kj-schmidt/Perconditioning/Rapport/Rapport/formalia/titelblad.tex

% Dette er et titelblad designet til videregående uddannelser på et universitet
% Filen kræver:
% Universitetets logo:  AU-logo-DK eller AU-logo-DK
% Synopsis: En fil ved navn synopsis.tex

% Udarbejdet af: Jesper Nørgaard (jesper@noergaard.eu) 10. april 2012

\phantomsection
\pdfbookmark[0]{Titelblad}{titelblad}
\thispagestyle{empty}

\begin{minipage}[t]{0.48\textwidth}
\vspace*{-8pt}			

\end{minipage}
\hfill
\begin{minipage}[t]{0.48\textwidth}
{\small 
\textbf{Ingeniørhøjskolen Aarhus}\\
Finlandsgade 22 \\
8200 Aarhus N \\
Tlf: 8715 0000 \\
http://www.ase.au.dk/}
\end{minipage}

\vspace*{1cm}

\begin{minipage}[t]{0.48\textwidth}
\textbf{Titel:} \\[5pt]\bigskip\hspace{2ex}
Remote Ischemic Conditioning

\textbf{Projekt:} \\[5pt]\bigskip\hspace{2ex}
Bachelor projekt

\textbf{Projektperiode:} \\[5pt]\bigskip\hspace{2ex}
Juli 2015 - December 2015

\textbf{Projektgruppe:} \\[5pt]\bigskip\hspace{2ex}
15155

\textbf{Deltagere:} \\[5pt]\hspace*{2ex}
Simon Vammen Grønbæk\\\hspace*{2ex}
Karl-Johan Schmidt \\\hspace*{2ex}

\textbf{Vejledere:} \\[5pt]\hspace*{2ex}
Peter Johansen \\\bigskip\hspace{2ex}

\textbf{Projektudbyder:} \\[5pt]\hspace*{2ex}
Rolf Blauenfeldt\\\bigskip\hspace{2ex}
\vspace*{4cm}

\textbf{Sidetal: \pageref{SidsteSide}} \\
\textbf{Afsluttet 16-12-2015}

\end{minipage}
\hfill
\begin{minipage}[t]{0.483\textwidth}
	\textbf{Godkendelse:}\vspace{1cm}
\begin{table}[H]
	\centering
	\begin{tabular}{c}
		\underline{\phantom{mmmmmmmmmmmmmm}}  \\
		Karl-Johan Schmidt \vspace{2cm}\\
		\underline{\phantom{mmmmmmmmmmmmmm}} \\
		Simon Vammen Grønbæk \vspace{2cm}	\\
		\underline{\phantom{mmmmmmmmmmmmmm}} \\
		Peter Johansen \vspace{2cm}	\\
		\underline{\phantom{mmmmmmmmmmmmmm}} \\
		Rolf Blauenfeldt \vspace{2cm}	\\
	\end{tabular}
\end{table}
\end{minipage}

\vfill

{\footnotesize\itshape Rapportens indhold er ikke frit tilgængeligt og offentliggørelse må kun ske såfremt de igangværende patentundersøgelser afsluttes}

% Rapportens indhold er frit tilgængeligt, men offentliggørelse (med kildeangivelse) må kun ske efter aftale med forfatterne.
% The content of the report is freely available, but publication (with source reference) may only take place in agreement with the authors.
