kj-schmidt/Perconditioning/Rapport/Rapport/formalia/forord.tex

\chapter*{Forord}

Denne rapport er udarbejdet som det skriftlige produkt til 7. semester bachelorprojekt. Rapporten og projektet er udarbejdet af to sundhedsteknologistuderende fra Ingeniørhøjskolen, Aarhus Universitet. Bachelorprojektet har foregået fra 28/8-2015 til 16/12-2015. Inden bachelorprojektet begyndte, blev der i perioden 1/6-2015 til 21/6-2015 udarbejdet et forprojekt. Forprojektet beskrev de grundlæggende rammer for bachelorprojektet, heriblandt valg af emne og forventningsafstemning med projektudbyderen. 
Projektgruppen vil rette en stor tak til projektudbyder Rolf A. Blaunfeldt for stor interesse, engagement og deltagelse i projektet. Derudover takkes vejleder Peter Johansen for at bistå med faglig hjælp og støtte igennem forløbet. Til sidst skal der lyde en tak til Sara Rose Newell og Stevan Brantlov fra Region Midt for at bistå med faglig viden og blodtrykssimulator. 

\vspace{3cm}

\begin{table}[H]
	\centering
	\begin{tabular}{c c}
		\underline{\phantom{mmmmmmmmmmmmmmmmmmmmm}} & \underline{\phantom{mmmmmmmmmmmmmmmmmmmmm}} \\
		Simon Vammen Grønbæk (201270788) \vspace{2cm} & Karl-Johan Schmidt (201270751) \vspace{2cm}\\
	\end{tabular}
\end{table}
