kj-schmidt/Perconditioning/Rapport/Rapport/formalia/resume.tex

\chapter*{Resume}
\textbf{Baggrund}
\textit{Remote ischemic conditioning (RIC)} er en behandlingsform, som har vist sig effektiv til behandling og forebyggelse af iskæmiske skader i hjertet. Derfor vil et forskningshold fra Aarhus Universitetshospital undersøge om samme effekt kan opnås hos patienter med apopleksi. Til udførsel af RIC behandlingen skal forskningsholdet have udviklet et apparat, der kan måle blodtrykket hos apopleksi patienter og derefter påbegynde behandlingen. RIC behandlingen foregår ved at okkludere en ekstremitet med en blodtryksmanchet ved et tryk på minimum 25 mmHg højere end systolisk tryk. Behandlingen udføres i cyklusser, hvor en cyklus består af én okklusionsfase og én reperfusionsfase. 

\textbf{Metoder}
Ved hjælp af agile og iterative processer er der udarbejdet en prototype, som kan udfører RIC behandling. Udviklingsfasen bestod af fire faser, hhv. kravspecifikation, system design, detaljeret design og implementering. For at sikre en konstant fremgang i projektforløbet er udviklingsfasen blevet styret ved hjælp af SCRUM. I projektet er der kørt ugentlig sprint, og projektets backlog har været en tidsplan udarbejdet som et gantt chart. Sammen med tidsplanen er milepæle i projektet nået ved hjælp af den tilknyttede review gruppe. I samarbejde med reviewgruppen blev der fastlagt deadlines for, hvornår hver milepæl skulle være færdig.

\textbf{Resultater og diskussion}
Accepttesten af prototypen viste, at kravene til produktet var delvist opfyldt. Prototypen kan måle et blodtryk, hvor efter trykket i manchetten fyldes til 25mmHg over det målte systoliske tryk. Herefter påbegyndes RIC behandlingen. Da prototypen skal bruges til et forskningsprojekt, gemmes informationen omkring RIC behandlingen på et SD kort parallelt med, at prototypen udfører behandlingen. Det er også muligt at ændre det antal cyklusser en behandling skal vare, samt tiden pr. cyklus. Dette er implementeret i tilfælde af, at studieprotokollen på et senere tidspunkt ønsker ændringer i opsætningen for RIC behandlingen. Foruden RIC behandlingen kan prototypen også indstilles til at udføre okklusionstræning. Accepttesten blev kun  delvist godkendt, fordi prototypen ikke er implementeret med en sikkerhedskontrol, der kan afbryde RIC behandlingen. 

\textbf{Konklusion}
 Den nye viden omkring behovet for et modificeret blodtryksapparat blev omsat til en funktionel prototype, der kunne udføre RIC behandling. Foruden sikkerhedskontrollen opfylder prototypen de ønskede funktioner. Ydermere blev der implementeret en ekstra funktion i form af okklusionstræning. De ingeniørfaglige metoder sikrede at udviklingsfasen forløb flydende og at deadlines blev overholdt. Mulighederne med RIC og prototypen kan på lang sigt have stor betydning for både patienter og sundhedssektoren.
