kj-schmidt/Perconditioning/Udviklingsdokumentation/Kravspecifikation/filer/ikkeFunkSpec.tex

	\chapter{Ikke-funktionelle krav}
	Afsnittet beskriver de ikke-funktionelle krav til produktet. De ikke-funktionelle krav adskiller sig fra de funktionelle krav, ved at beskrive kriterier der er afgørende for hvordan systemet operere. De ikke-funktionelle krav kaldes i nogen sammenhænge for \textit{kvalitets attributter}, fordi de beskriver alle de krav, der ikke er specificeret i hovedscenarierne.
	
	\section{Microcontroller}
	\begin{enumerate}
		\setlength\itemsep{0cm}
		\item Atmega2560
		\end{enumerate}
	
	\section{Filformat og opsætning}
	\begin{enumerate}
		\setlength\itemsep{0cm} % Decrease line distance
		\item Data logged i formatet .csv og hver kolonne indeholder følgende værdier og enheder: 
		\begin{enumerate}
			\item Tidsstempel [hh:mm:ss dd-mm-yyyy]
			\item Gennemført afklemning [Boolean]
			\item Afklemningstryk [mmHg]
			\item Systoliske blodtryk [mmHg]
			\item Middelblodtryk (MAP) [mmHg]
			\item Diastolisk blodtryk [mmHg]
			\item Afklemning afbrudt [Boolean]
		\end{enumerate}
		\item Der oprettes én fil pr patient, med filnavn tilsvarende det unikke patient ID og apparatets ID i følgende format: “PatientIDApparatID”
	\end{enumerate}
	
	\section{Patient ID}
	\begin{enumerate}
		\setlength\itemsep{0cm} % Decrease line distance
		\item Består af karaktererne A-F og tallene 0-9
		\begin{enumerate}
			\item ID’et er fem karakterer lang: ***** svarende til ca. 1 million kombinationer
			\item ID’et er ikke case sensitiv
		\end{enumerate}
	\end{enumerate}

	\section{Hukommelse}
	\begin{enumerate}
		\setlength\itemsep{0cm} % Decrease line distance
		\item Information lagres på micro SDHC af typen:
		\begin{enumerate}
			\item Class 4
			\item Fil system [fat32] og minimum 128mb
		\end{enumerate}
	\end{enumerate}
	
	\section{Forsyning}
	\begin{enumerate}
		\setlength\itemsep{0cm} % Decrease line distance
		\item Konditionerings apparatet skal forsynes med 12V, min 1A
		\begin{enumerate}
			\item DC-connector, ydre Ø=5,5mm, indre Ø = 2,1mm
			\item 8 stk AAA batterier (1,5V)
		\end{enumerate}
	\end{enumerate}
	
	\section{Fysiske krav}
	\begin{enumerate}
		\setlength\itemsep{0cm} % Decrease line distance
		\item Knapper
		\begin{enumerate}
			\item  {[}Start/Stop]
			\item {[}Mål blodtryk]
			\item Modeswitch [Okklusionstræning/Konditionering/Setup]
		\end{enumerate}
		\item Hvert apparat udstyres med et unik serie nummer, kaldet apparat ID
	\end{enumerate}
	
	\section{Setup}
	\begin{enumerate}
		\setlength\itemsep{0cm} % Decrease line distance
		\item Der kan ændres i tiden pr cyklus og antallet af cyklusser
		\begin{enumerate}
			\item \textit{Tid pr cykles} kan sættes mellem 3 til 8 minutter og skifter med intervaller af 30 sekunder
			\item \textit{Antal cyklusser }kan sættes mellem 1-9 og skifter med intervaller af 1
		\end{enumerate}
	\end{enumerate}
