kj-schmidt/Perconditioning/Udviklingsdokumentation/Kravspecifikation/filer/funkSpec.tex

\chapter{Funktionelle krav}
Dette afsnit beskriver de funktionelle krav for \textit{Konditioneringsapparatet}. De funktionelle krav er udarbejdet som \textit{fully dressed} use cases, der beskriver krav til produktets opførsel.

\section{Use case diagram}
Nedenfor illustreres alle use cases (Se figur \ref{fig:usecasedia}) for systemet i et samlet diagram. Aktørerne, som er beskrevet nedenfor, indgår i diagrammet, og deres interaktion og indvirkning med systemet er beskrevet med pilene. 
\begin{figure}[H]
	\centering
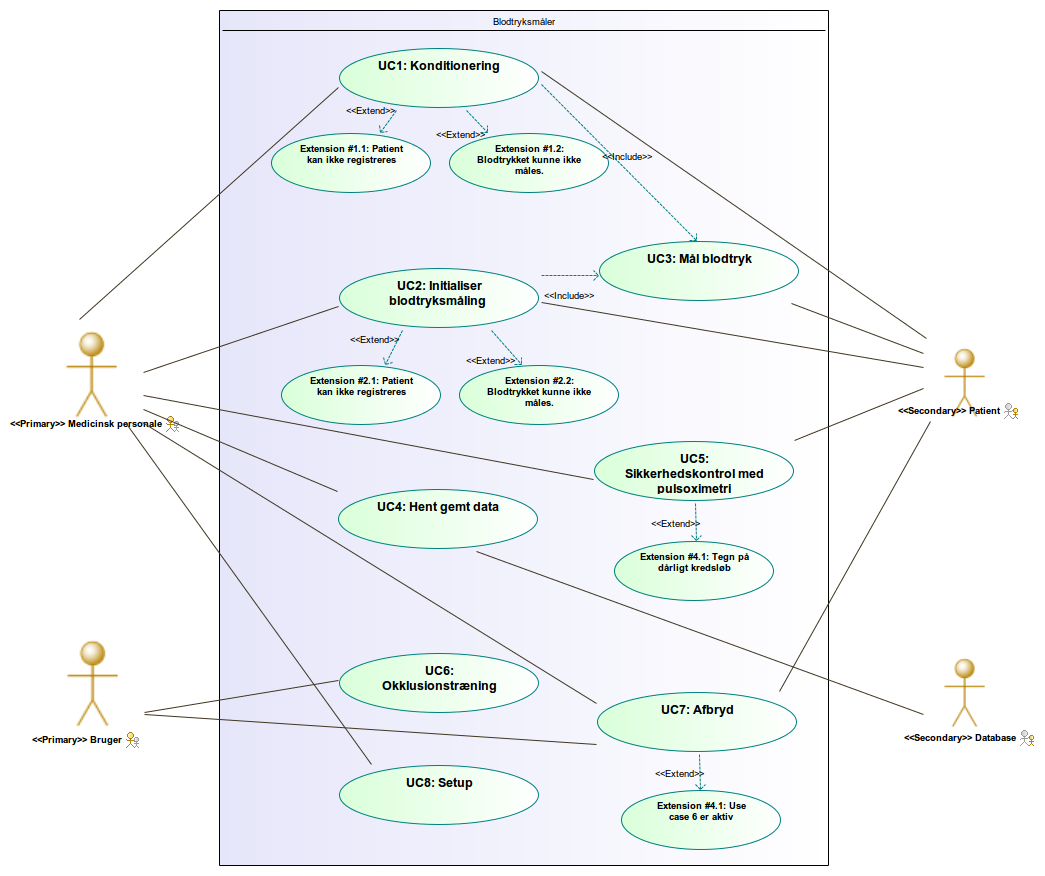
[picture p10: Udviklingsdokumentation/Kravspecifikation/SysML/UCD.png]
	
	\caption{Use case diagram for \textit{Konditioneringsapparatet}} \label{fig:usecasedia}
\end{figure}

%Actor description
\input{Kravspecifikation/filer/actorDescription.tex}
\newpage

\section{Use cases}
Dette afsnit beskriver alle use cases fra figur \ref{fig:usecasedia} ved hjælp af fully dressed use cases. 
	%Use case 1
	\input{Kravspecifikation/filer/uc1.tex}
	
	%Use case 2
	\input{Kravspecifikation/filer/uc2.tex}
	
	%Use case 3
	\input{Kravspecifikation/filer/uc3.tex}
	
	%Use case 4
	\input{Kravspecifikation/filer/uc4.tex}
	
	%UseCase 5
	\input{Kravspecifikation/filer/uc5.tex}
	
	%UseCase 6
	\input{Kravspecifikation/filer/uc6.tex}
	
	%UseCase 7
	\input{Kravspecifikation/filer/uc7.tex}
	
	%UseCase8
	\input{Kravspecifikation/filer/uc8.tex}
