kj-schmidt/Perconditioning/Rapport/Rapport/formalia/forside.tex

\thispagestyle{empty}
\begin{flushright}
\vspace{3cm}

\phantom{hul}

\phantom{hul}

\phantom{hul}

\textsl{\Huge Remote Ischemic Conditioning} \\ \vspace{1cm}
\textsl{\Huge Projektrapport} \\ \vspace{1cm}

\rule{\textwidth}{3mm} \\ \vspace{1.5cm}
\vspace{1cm}



\vspace{1cm} 
\textsc{\Large Bachelorprojekt \\
Gruppe 15155 \\
Karl-Johan Schmidt \\
Simon Vammen Grønbæk \\
Ingeniørhøjskolen, Aarhus Universitet \\
Efteråret 2015 \\}
\end{flushright}
