kj-schmidt/Perconditioning/Rapport/Rapport/appendiks/samarbejdeaftale.tex

\section{Samarbejdsaftale - intern}\label{title:samarbejdsaftaleIntern}

\textbf{Faglige forventninger til projektet:}
\begin{itemize}
	\item Vi forventer at udarbejde et projekt, som vi kan stå inde for
	\item Vi forventer at det faglige niveau lever op til kravene i kursus beskrivelsen
	\item Vi forventer at der gøre brug af viden og kompetencer fra tidligere kursuser
	\item Vi forventer at gruppens medlemmer viser engagement i projektet
	\item Det forventes at projektet lever op til en topkarakter
\end{itemize}

\textbf{Forventninger til gruppearbejdet og interne aftale:}
\begin{itemize}
	\item Alle gruppemedlemmer deltager aktivt og yder efter bedste evne
	\item Bidrager til konstruktivt diskussioner og problemstillinger undervejs i projektforløbet
	\item Alle aftaler indskrives i den fælles Google Calender, hvor det er eget ansvar at være opdateret
	\item Alle dokumenter der ikke kræver versionshistorik gemmes i gruppens fælles Dropbox mappe
	\item Versionsstyring af dokumenter foregår i git, og det er eget ansvar at ajourføre sine ændringer
	\item Eget ansvar at give besked til gruppen hvis man bliver forhindret i at møde til den ellers aftalte tid
	\item Der må forventes at gruppemedlemmerne pålægges hjemme opgaver og det er eget ansvar at løse disse
	\item Den forventede mødetid i hverdage er 8.15 til 16
	\item Det er et fælles ansvar at oprette en ugentlig plan for ugens opgaver, samt føre logbog over den forgangne uge	
	\item Vi forventer et vejledermøde hver anden uge
	\item Gruppens medlemmer overholder de ovenstående aftale
\end{itemize}

\hspace{3cm}

Underskrives af: 

\begin{table}[H]
	\centering
	\begin{tabular}{c c}
		\underline{\phantom{mmmmmmmmmmmmmmmmmmmmm}} & \underline{\phantom{mmmmmmmmmmmmmmmmmmmmm}} \\
		Simon Vammen Grønbæk (201270788) \vspace{2cm} & Karl-Johan Schmidt (201270751) \vspace{2cm}\\
	\end{tabular}
\end{table}

\newpage
\section{Samarbejdsaftale - reviewgruppe}\label{title:samarbejdsaftaleReview}

Forventninger til samarbejdet:
\begin{itemize}
	\item For hver milepæl i projektet udføres reviewmøder
	\item Efter hvert endt reviewmøde aftales et ny dato for næste møde
	\item De aftalte deadlines forventes overholdt
	\item Vi forventer at reviewgruppen kommer med kontruktiv kritik af det udleverede materiale
	\item Der forventes at grupperne har diskuteret materialet intern, inden det aftalte reviewmøde
	\item Vi forventer at reviewsamarbejdet styrker projekts fremgang og bidrager til et veludarbejdet projekt
	\item Der forventes som minimum to dage fra materiale udleveres til review, før det kan gennemgås. 
\end{itemize}

\hspace{3cm}

Projektgruppens underskrift: 
\begin{table}[H]
	\centering
	\begin{tabular}{c c}
		\underline{\phantom{mmmmmmmmmmmmmmmmmmmmm}} & \underline{\phantom{mmmmmmmmmmmmmmmmmmmmm}} \\
		Simon Vammen Grønbæk (201270788) \vspace{2cm} & Karl-Johan Schmidt (201270751) \vspace{2cm}\\
	\end{tabular}
\end{table}
Reviewgruppens underskrift:
\begin{table}[H]
	\centering
	\begin{tabular}{c c}
		\underline{\phantom{mmmmmmmmmmmmmmmmmmmmm}} & \underline{\phantom{mmmmmmmmmmmmmmmmmmmmm}} \\
		Anders Toft (11242) \vspace{2cm} & Anders Esager (201270874) \vspace{2cm}\\
	\end{tabular}
\end{table}
