kj-schmidt/Perconditioning/Rapport/Rapport/teknisk/staal.tex

\chapter{Stålmateriale}

Inden der kan regnes på en stålkonstruktion, der skal opsættes i forbindelse med en gennemgribende renovering, beskrives stålet som materiale.

\section{Fremstilling}

\section{Egenskaber}

\fxnote{Husk at skrive om egenskaber ved brand, Jens!}

\subsection{Arbejdskurve}

Den nederste del af ståls arbejdskurve følger principperne om Hook's lov \citep[ s. 419]{fysikbog}.
