kj-schmidt/Perconditioning/Udviklingsdokumentation/Implementeringsdokument/Implementeringsdok.tex

 %	\input{Implementeringsdokument/filer/forside}
%	\input{Implementeringsdokument/filer/titelblad}
\newpage
\printcontents[id]{ }{0}{\chapter*{Indholdsfortegnelse}}
\newpage
	
	\input{Implementeringsdokument/filer/indledning}
	
	\input{Implementeringsdokument/filer/software}
	
	\input{Implementeringsdokument/filer/filter}
	
	\input{Implementeringsdokument/filer/hardware}
