kj-schmidt/Perconditioning/Udviklingsdokumentation/SystemArkitektur/SystemArkitektur.tex

	%Frontpage
	%\input{SystemArkitektur/filer/forside.tex}
	
	%Title page
	%\input{SystemArkitektur/filer/titelblad.tex}
	\newpage
	\printcontents[sd]{ }{0}{\chapter*{Indholdsfortegnelse}}
	\newpage
	
	%Indledning
	\input{SystemArkitektur/filer/indledning}
	
	\input{SystemArkitektur/filer/systemetsDele}
	
	\input{SystemArkitektur/filer/arkitektur}
