kj-schmidt/Perconditioning/Udviklingsdokumentation/Implementeringsdokument/filer/indledning.tex

	\chapter{Indledning}
	Implementeringsdokument giver et detaljeret design overblik over hvordan både hardware og software er blevet implementeret i udviklingen af prototypen. Dokumentet indeholder beskrivelse af strukturen af software klasser og deres funktionalitet. For hardware delen er der beskrevet de forskellige hardware blokke og hvordan de er blevet implementeret for at kunne leve op til kravene stillet i kravspecifikationen. 
	
	\section{Formål}
	Dette dokument har til formål at give læseren et teknisk indblik i \textit{Konditioneringsapparatets} funktionalitet og opbygning, samt skabe fuld forståelse for alle systemets under dele gennem en detaljeret design beskrivelse. I forlængelse af system designet, som beskriver hvordan systemet skulle designes, beskriver dette dokument det færdig design i detaljer og hvordan det har opnået sin funktionalitet
	
	\section{Projektreferencer}
	\begin{itemize}
		\item Se underdokumentet, kravspecifikation, på side \pageref{part:ks}
		\item Se underdokumentet, accepttest, på side \pageref{part:at}
		\item Se underdokumentet, system design, på side \pageref{part:sd}
	\end{itemize}
	
	\section{Læsevejledning og dokumentstruktur}
	Da dette dokument er en del af udviklingsdokumentation. Det er vigtigt at læse i sammenhæng med kravspecifikationen og systemarkitekturen. Undervejs i dokumentet vil der være referencer til kravspecifikationen og derfor er der stor samhørighed mellem disse to dokumenter. Dette dokument skal også ses som en forklaring på software implementeringen, og derfor passer navne og overskrifter i software beskrivelse overens med navne på metoder og klasser i softwaren. Desuden beskrives hver software metode ud fra tre punkter; paramter, returtype og beskrivelse. Parameter beskriver hvilke parametre og typen af disse parametre, som metode skal have. Returtypen fortæller hvilken værdi metode returnere og hvilken type det er. Beskrivelsen forklare funktionaliteten af metode, og hvordan denne funktionalitet er opnået. Nogle metoder indeholder også kode eksempler, når det anses som nødvendigt for at forstå metoden. Efter software beskrivelsen kommer overgangen til hardware beskrivelsen.
	
	\newpage
	\section{Versionshistorik}
	\begin{longtable}{ |p{0.24\textwidth} |p{0.42\textwidth}| p{0.25\textwidth}|  } 
		\hline
		\rowcolor{usDef}
		\textbf{Versionsnummer} &  \textbf{Ændringer} & \textbf{Dato og initialer} \\
		\hline
		0.1 & Oprettelse af implementeringsdokument og skabelon & 01.11.15 KJS \\
		\hline
		0.2 & Tilføjelse af filter dokumentation & 11.11.15 SVG \\
		\hline
		0.3 & Beskrivelse af display, timer og hukommelses klasser & 12.11.15 KJS \\
		\hline
		0.4 &  Implementering klar til review, updateret filtrering og debouncing & 13.11.15 KJS, SVG \\
		\hline
		0.5 &  Rettelser efter review & 16.11.15 KJS, SVG \\
		\hline
		0.6 &  Ændret beskrivelse af metoder og ny graf over blodtryk & 20.11.15 KJS, SVG \\
		\hline
	\end{longtable}
	
	\section{Definitioner og forkortelser}
	\begin{longtable}{ |p{0.3\textwidth} |p{0.64\textwidth}| } 
		\hline
		\rowcolor{usDef}
		\textbf{Udtryk / Forkortelser} &  \textbf{Forklaring} \\
		\hline
		Modeswitch & Knap til at styre hvilket program Konditioneringsapparatet skal køre \\
		\hline
		\textit{Tid pr cyklus} & Variable som indeholder hvor mange sekunder et konditioneringscyklus skal vare \\
		\hline
		\textit{Antal cyklusser} & Variable som indeholder hvor mange cyklusser et konditioneringsforløb skal vare \\
		\hline
		EEPROM & Intern flash hukommelse på arduino som der kan skrives og læses fra \\
		\hline
		Interrupt & Hver gang arduino kører en clock cyklus aflæses værdien af en række digital pins, hvorved man kan afbryde kode og kører en anden sekvens. Arduinoen har både interne og eksterne interrupt, men dette projekt gør kun brug af de eksterne interrupt \\
		\hline
		Sand/True, Falsk/False & Arduino genkender en sand/true når typen er bool og værdien er 1. Modsat registreres 0 som falsk/false \\
		\hline
	\end{longtable}
