kj-schmidt/Perconditioning/Udviklingsdokumentation/Kravspecifikation/filer/uc8.tex

	\subsection{Use case 8 - Setup}
	Use case 8 (Se tabel \ref{tab:uc8}) beskriver forløbet når der skal ændrings i konditioneringsprotokollen. Her kan ændres i tiden pr cyklus og antallet af cyklusser. 
		\begin{table}[H]
				\begin{center}
			\begin{tabular}{ | p{0.24\textwidth} | p{0.7\textwidth}| } 
				\hline
				Mål & Ændre konditioneringsforholdene \\ 
				\hline
				Initiation &  Medicinsk personale\\
				\hline
				Aktører og interessenter & 
				\begin{itemize}
					\item Medicinsk personale 
				\end{itemize} \\ 
				\hline
				Referencer & Illustration over setup \\ 
				\hline
				Antal samtlige forekomster & En til mange \\ 
				\hline	
				Startbetingelser & 
				\begin{itemize}
					\item Mode switch er sat til “\textit{setup}” 
					\item Displayet er ændret til \textit{setup}
 				\end{itemize} \\ 
				\hline
				Slutbetinglser & 
				\begin{itemize}
					\item Cyklus længden og/eller antallet er cyklusser er ændret
				\end{itemize} \\ 
				\hline
				Normal forløb & \begin{enumerate}
					\setlength\itemsep{0cm} % Decrease line distance
					\item Brugeren trykker på knappen [Mål blodtryk]  for at vælge \textit{Tid pr cyklus}
					\item Bruger trykker på knappen [Start/Stop] for at ændre \textit{Tid pr cyklus}
					\item Bruger trykker på knappen [Mål blodtryk]  for at gemme ændringen
					\item Bruger trykker på knappen [Start/Stop] for at navigere til \textit{Antal cyklusser}
					\item Ved knap tryk på [Mål blodtryk]  vælges \textit{Antal cyklusser}
					\item Ved knap tryk på [Start/Stop] ændre \textit{Antal cyklusser}
					\item Brugeren trykker på knappen [Mål blodtryk] for at gemme ændringen
				\end{enumerate} \\ 
				\hline
				Undtagelser & -  \\ 
				\hline
			\end{tabular}
		\end{center}

			\caption{\textit{Fully dressed} use case diagram over use case 8} \label{tab:uc8}
		\end{table}
			\newpage
