kj-schmidt/Perconditioning/Udviklingsdokumentation/Accepttest/filer/at_uc2.tex

\newpage
\section{Use case 2 - Initialiser blodtryksmåling}
		\begin{longtable}{|p{0.09\textwidth}|p{0.23\textwidth}|p{0.23\textwidth}|p{0.23\textwidth}|p{0.07\textwidth}|}
			\hline
			\rowcolor{usDef}
			Krav nr.: & Handling & Forventet resultat & Testmetode & Resul-tat  \\\hline
			2.2.1 & \textit{Medicinsk personale} trykker på [Mål blodtryk] & \multirow{3}{\linewidth}{Der vises et patient ID på skærmen} & \multirow{3}{\linewidth}{Knappen [Start/Stop] trykkes og displayet observeres} & \multirow{3}{\linewidth}{}  \\ \cline{1-2} 
			2.2.2 & Et nyt patient ID genereres & & &  \\ \cline{1-2}
			2.2.3 & Patient ID’et vises på skærmen & & &  \\ \hline
			2.2.4 & Blodtrykket måles via \textit{use case 3} & \multicolumn{3}{l|}{Se krav nr. 1.3.1 til 1.3.5} \\ 
			\hline
			\caption{Accepttest forløb for use case 2}
		\end{longtable}
	
	\section*{Undtagelser}
		\begin{longtable}{|p{0.09\textwidth}|p{0.23\textwidth}|p{0.23\textwidth}|p{0.23\textwidth}|p{0.07\textwidth}|}
			\hline
			\rowcolor{usDef}
			Krav nr.: & Handling & Forventet resultat & Testmetode & Resul-tat  \\\hline
			
			2.2.ex1 & SD kortet er ikke monteret korrekt & \multicolumn{3}{l|}{Se krav nr 2.1.ex1} \\ 
			\hline
			2.2.ex2 & Et patient ID eksisterer allerede på apparatet. Der genereres ikke noget nyt patient ID &  \multicolumn{3}{l|}{Se krav nr 2.1.ex2} \\ 
			\hline
			\caption{Undtagelser for use case 2}
		\end{longtable}
