kj-schmidt/Perconditioning/Udviklingsdokumentation/Accepttest/filer/at_uc6.tex

\section{Use case 6 - Okklusionstræning}
						\begin{longtable}{|p{0.09\textwidth}|p{0.23\textwidth}|p{0.23\textwidth}|p{0.23\textwidth}|p{0.07\textwidth}|}
								\hline
								\rowcolor{usDef}
								Krav nr.: & Handling & Forventet resultat & Testmetode & Resul-tat  \\\hline
								2.6.1 & Montere manchetten på arm/ben & Manchetten sidder tæt om arm/ben. Hele velcro hæfte siden skal fæstnes i filtsiden & Manchetten trækkes løst over arm/ben og fastspændes så det ønskede område afklemmes. Kontrollér om manchetten er passer i størrelsen & \\ \hline
								2.6.2 & Tryk på knap [Start/Stop] & Luftpumpen startet & Knappen [Start/Stop] trykkes og observer at manchetten udvides  & \\ \hline
								2.6.3 & Manchetten pumpes op til 100mmHg & \multirow{2}{\linewidth}{Trykket i mancheten er 100 mmHg med en tolerance på +20/-10 mmHg}& \multirow{2}{\linewidth}{Observere analogt barometer i 3 min}& \multirow{2}{\linewidth}{} \\ \cline{1-2}
								2.6.4 & Trænings-sættet begyndes og trykket holdes konstant på 100mmHg (+/-5mmHg) & & & \\ \hline \newpage \hline
								2.6.5 & Tryk på knap [Start/Stop]  & \multirow{2}{\linewidth}{Manchet trykket er \textless  10 mmHg efter 1 min.} & \multirow{2}{\linewidth}{Knappen [Start/Stop] trykkes og observer at trykket på det analog barometer} & \multirow{2}{\linewidth}{} \\ [2cm] \cline{1-2}
								2.6.6 & Manchetten deflateres  & & & \\ \hline
								\caption{Accepttest forløb for use case 6}
						\end{longtable}
