kj-schmidt/Perconditioning/Udviklingsdokumentation/Accepttest/filer/at_uc7.tex

\section{Use case 7 - Afbryd}
						\begin{longtable}{|p{0.09\textwidth}|p{0.23\textwidth}|p{0.23\textwidth}|p{0.23\textwidth}|p{0.07\textwidth}|}
							\hline
							\rowcolor{usDef}
							Krav nr.: & Handling & Forventet resultat & Testmetode & Resul-tat  \\\hline
							2.7.1 & Brugeren trykker på knappen [Start/Stop] & \multirow{2}{\linewidth}{Use casen afbrydes og manchetten tømmes for luft} & \multirow{2}{\linewidth}{Start use case 1 eller 6 og på et vilkårligt tidspunkt tryk på knappen [Start/Stop]} & \multirow{2}{\linewidth}{} \\ \cline{1-2}
							2.7.2 & Den igang-værende use case afbrydes & & & \\ \hline
							2.7.3 & Manchetten tømmes for luft og tidsstempel med “\textit{Afklemning afbrudt} = false(0)” gemmes i hukommelsen & Manchet trykket er \textless 50 mmHg efter 1 min. Tidsstempel for  “\textit{Afklemning afbrudt} = false(0)” gemmes i fil & Observere analogt barometer 1 min.
							Kontroller tidsstempling på SD kortet & \\ \hline
							\caption{Accepttest forløb for use case 7}
						\end{longtable}
					
					\section*{Undtagelser}
						\begin{longtable}{|p{0.09\textwidth}|p{0.23\textwidth}|p{0.23\textwidth}|p{0.23\textwidth}|p{0.07\textwidth}|}
							\hline
							\rowcolor{usDef}
							Krav nr.: & Handling & Forventet resultat & Testmetode & Resul-tat  \\\hline
							2.7.ex1 & Use case 6 er aktiv: ingen data gemmes i hukommelsen & Der gemmes ingen data & Kør use case 6 efterfulgt af use case 7 og observér logfilen & \\ \hline
							\caption{Undtagelser for use case 7}
						\end{longtable}
