kj-schmidt/Perconditioning/Udviklingsdokumentation/Accepttest/filer/at_uc4.tex

\newpage
\section{Use case 4 - Overfør data}
				\begin{longtable}{|p{0.09\textwidth}|p{0.23\textwidth}|p{0.23\textwidth}|p{0.23\textwidth}|p{0.07\textwidth}|}
							\hline
							\rowcolor{usDef}
							Krav nr.: & Handling & Forventet resultat & Testmetode & Resul-tat  \\\hline
							2.4.1 & Tag SD kortet ud af blodtryksapparatet  & \multirow{2}{\linewidth}{Der eksisterer en logfil på SD-kortet og den kopieres til det lokale drev}& \multirow{2}{\linewidth}{Indsæt SD-kort i computeren. Kontroller om filen eksisterer på kortet. Overfør filen til computeren.}& \multirow{2}{\linewidth}{} \\ [2cm]\cline{1-2}
							2.4.2 & Sæt SD kortet i computeren og overfør filen & & & \\ \hline
							2.4.3 & Formatér SD kortet & \multirow{2}{\linewidth}{SD-kortet er formateret og tømt for filer} & \multirow{2}{\linewidth}{Formatér SD til FAT32. Indsæt SD-kort i apparatet og foretag blodtryksmåling. Kontroller om logfilen oprettes på SD-kort. } & \multirow{2}{\linewidth}{}\\ [3cm]\cline{1-2}
							2.4.4 & Sæt SD kortet tilbage i konditioneringsapparatet & & & \\ \hline
							\caption{Accepttest forløb for use case 4}
				\end{longtable}
