kj-schmidt/Perconditioning/Udviklingsdokumentation/SystemArkitektur/filer/Deployment.tex

\section{Deployment}
Da produktet Konditioneringsapparat er en prototype beskæftiger projektet sig ikke med de redskaber der bruges i deployment view. Dette view beskriver blandt andet hvordan software mappes på hardware, kaldet et deployment diagram. Konditioneringsapparatet består kun af én software eksekverende enhed og derfor er dette overflødigt at beskrive.
