kj-schmidt/Perconditioning/Rapport/Rapport/billeder/Sælgertegning.pptx

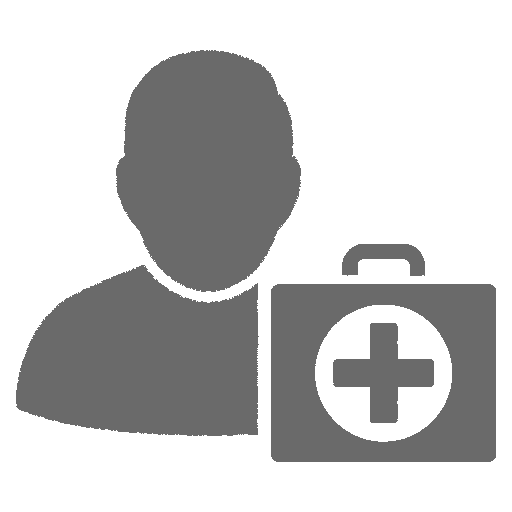
[picture p24: figure]

Medicinsk
personale

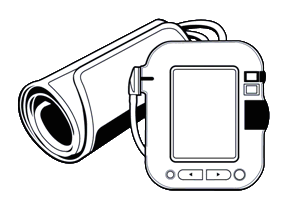
[picture p25: figure]

Konditionerings-
apparat

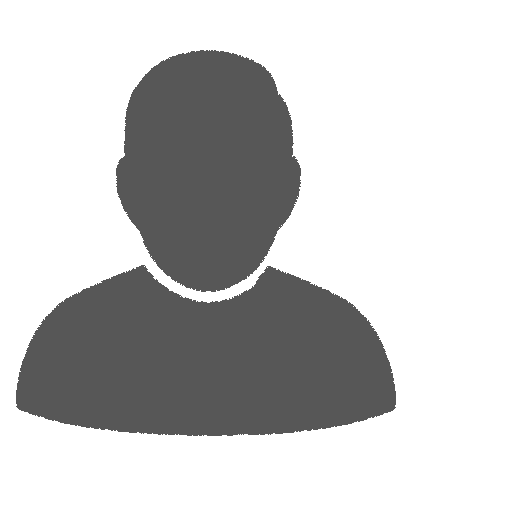
[picture p26: figure]

Patient

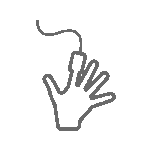
[picture p27: figure]

Pulsoximeter

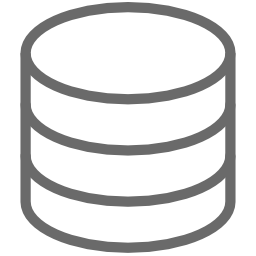
[picture p28: figure]

Database
