kj-schmidt/Perconditioning/Prototype/Pneumatik noter.docx

Pneumatik

Enhed | Rør størrelse på slange [mm] | Størrelse på enhed
Pumpe | 6mm | 7mm
Cuff | 5mm | 5,9mm
Valve | 2.7mm | 3mm
Sensor | | 3mm
