kj-schmidt/Perconditioning/Udviklingsdokumentation/SystemArkitektur/pdfs/BDD(SystemOverview)_backup.pdf

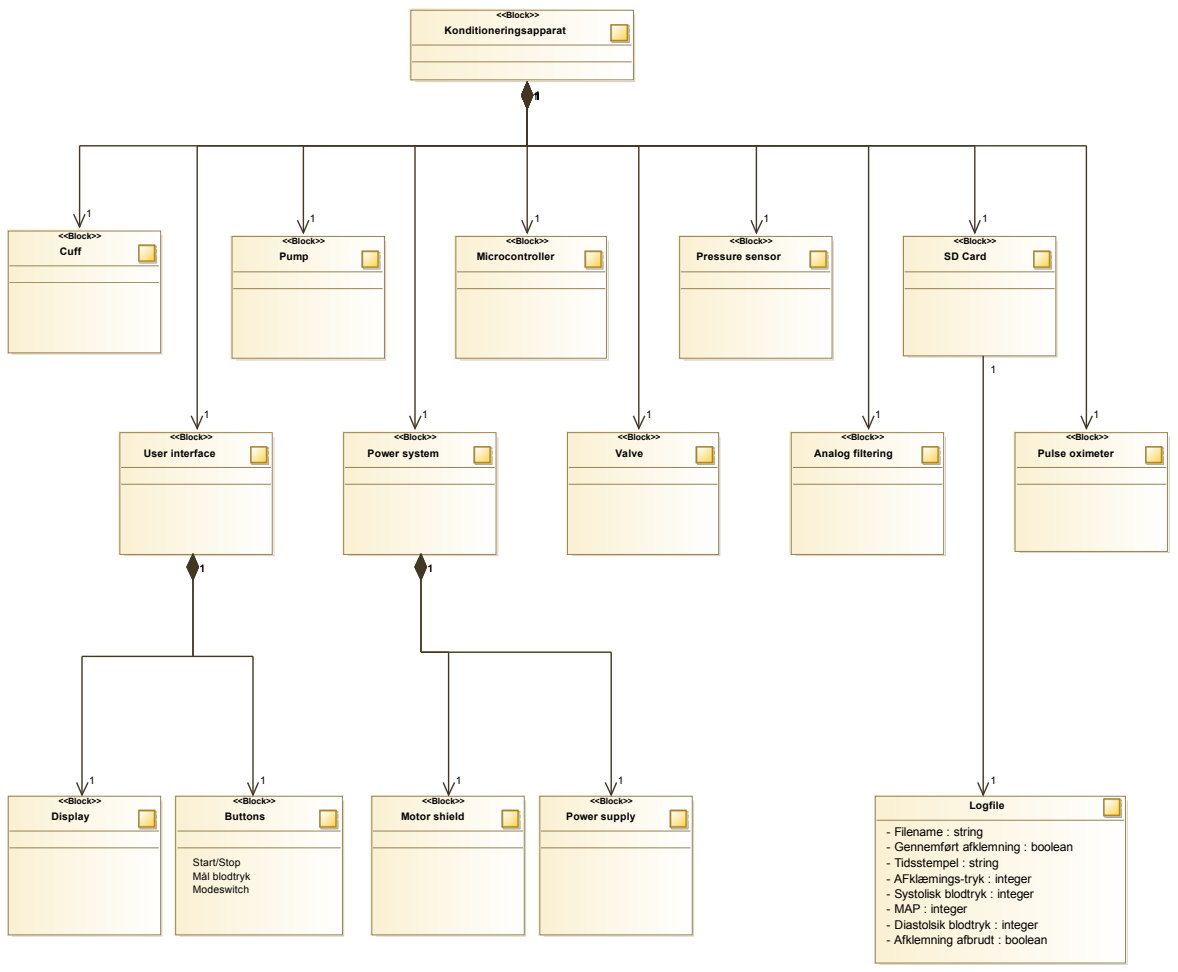
[picture p29: figure]
<<Block>> Konditioneringsapparat; <<Block>> Cuff; <<Block>> User interface; <<Block>> Power system; <<Block>> Analog filtering; <<Block>> Pressure sensor; <<Block>> Pump; <<Block>> Valve; <<Block>> Microcontroller; <<Block>> SD Card; <<Block>> Display; <<Block>> Buttons; Start/Stop Mål blodtryk Modeswitch; <<Block>> Pulse oximeter; Logfile; - Filename : string - Gennemført afklemning : boolean - Tidsstempel : string - AFklæmings-tryk : integer - Systolisk blodtryk : integer - MAP : integer - Diastolsik blodtryk : integer - Afklemning afbrudt : boolean; <<Block>> Motor shield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
