kj-schmidt/Perconditioning/Udviklingsdokumentation/SystemArkitektur/pdfs/IBD-Hardware.pdf

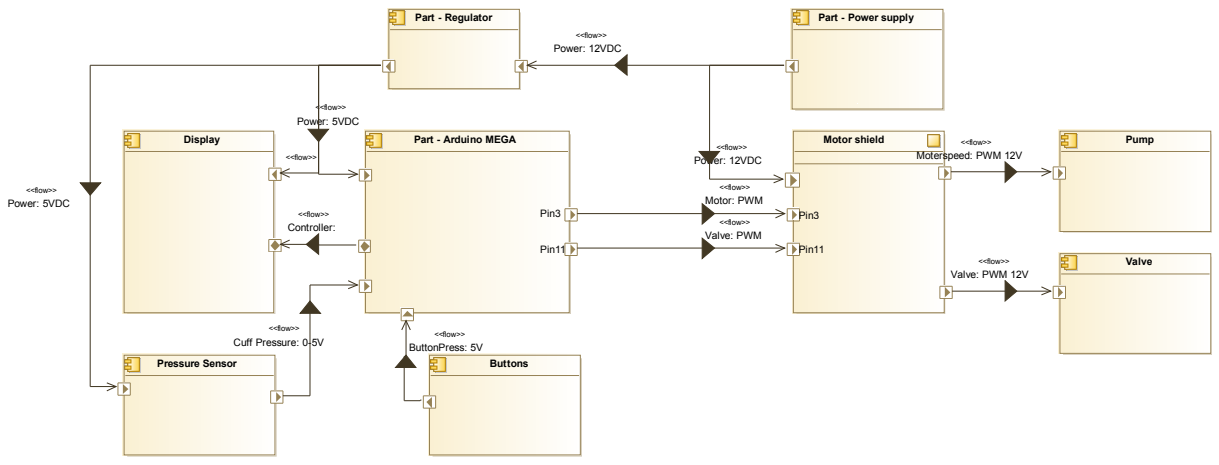
[picture p30: figure]
Motor shield; Pin3; Pin11; Part - Regulator; Part - Power supply; Part - Arduino MEGA; Pump; Valve; Display; Pressure Sensor; Buttons; <<flow>> Power: 12VDC; <<flow>> Motor: PWM; <<flow>> Valve: PWM; <<flow>> Moterspeed: PWM 12V; <<flow>> Valve: PWM 12V; <<flow>> Power: 5VDC; <<flow>>; Power: 5VDC; Controller:; <<flow>> ButtonPress: 5V; <<flow>> Cuff Pressure: 0-5V
