kj-schmidt/Perconditioning/AllDiagrams. rettet.pdf

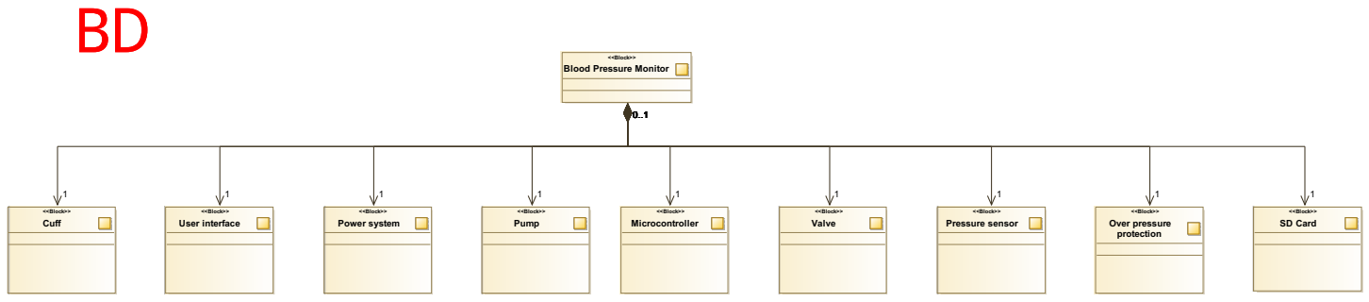
[picture p67: figure]
<<Block>> Blood Pressure Monitor; <<Block>> Cuff; <<Block>> User interface; <<Block>> Power system; <<Block>> Over pressure protection; <<Block>> Pressure sensor; <<Block>> Pump; <<Block>> Valve; <<Block>> Microcontroller; <<Block>> SD Card

## UC2: Initialiser blodtryksmåling

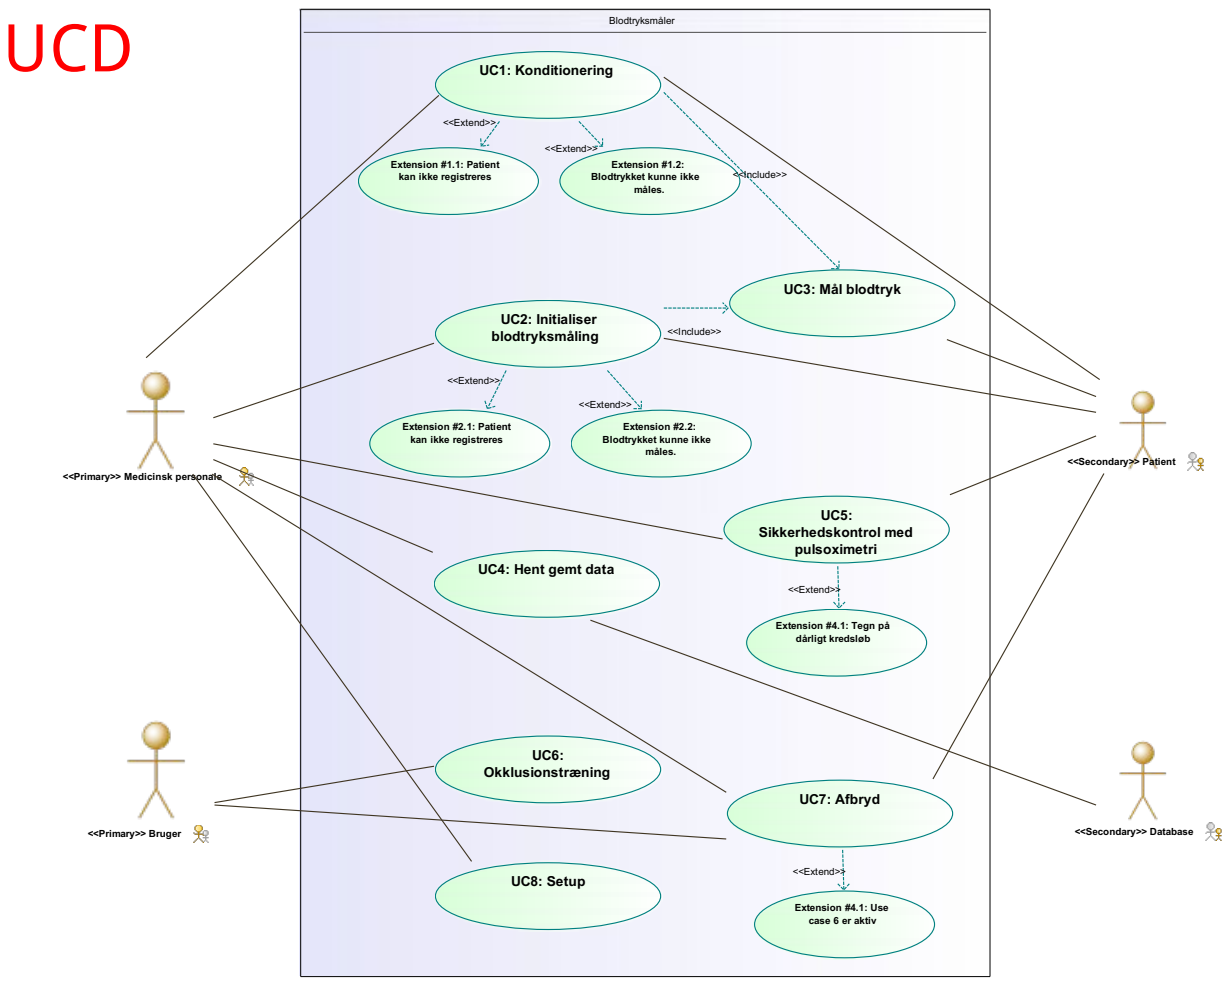
[picture p68: page 2]
<<Secondary>> Patient; Blodtryksmåler; UC3: Mål blodtryk; måles.; UC5: Sikkerhedskontrol med pulsoximetri; UC6: Okklusionstræning; UC1: Konditionering; UC7: Afbryd; UC8: Setup; <<Primary>> Bruger; <<Secondary>> Database; <<Extend>>; <<Include>>; UCD

Extension #1.1: Patient
kan ikke registreres

Extension #1.2:
Blodtrykket kunne ikke

Extension #2.1: Patient

Extension #2.2:

<<Primary>> Medicinsk personale

UC4: Hent gemt data

Extension #4.1: Tegn på
dårligt kredsløb

Extension #4.1: Use
case 6 er aktiv

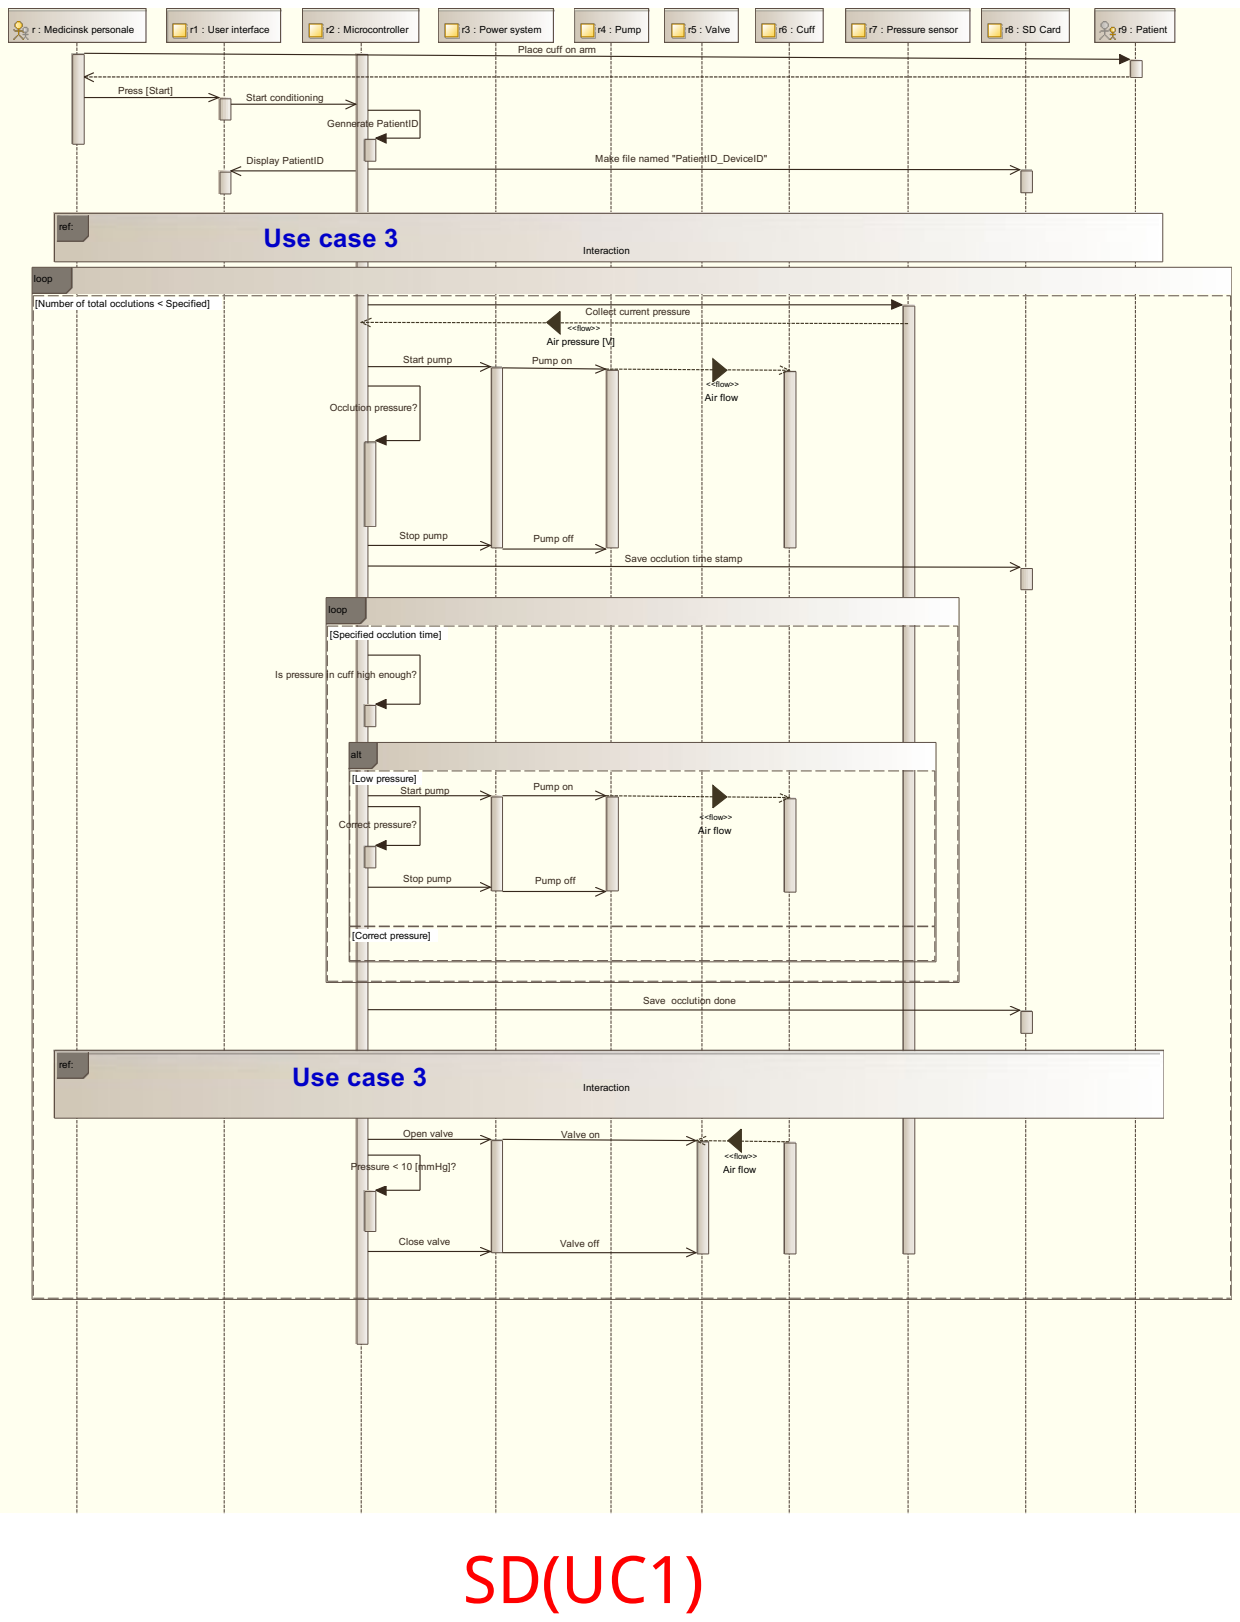
[picture p69: page 3]
r : Medicinsk personale; r1 : User interface; r2 : Microcontroller; r3 : Power system; r4 : Pump; r5 : Valve; r6 : Cuff; r7 : Pressure sensor; r8 : SD Card; r9 : Patient; [Correct pressure]; Press [Start]; Start conditioning; Display PatientID; Gennerate PatientID; Occlution pressure?; Is pressure; in cuff; high enough?; Correct pressure?; Pressure < 10 [mmHg]?; <<flow>> Air flow

Place cuff on arm

Make file named "PatientID_DeviceID"

ref: | Use case 3 | | Interaction

loop

[Number of total occlutions < Specified]

Collect current pressure

Start pump | <<flow>> Air pressure [V] Pump on

Stop pump | Pump off | Save occlution time stamp

[Specified occlution time]

alt

[Low pressure] Start pump | Pump on

Stop pump | | Pump off

Save occlution done

Open valve | Valve on

Close valve | Valve off

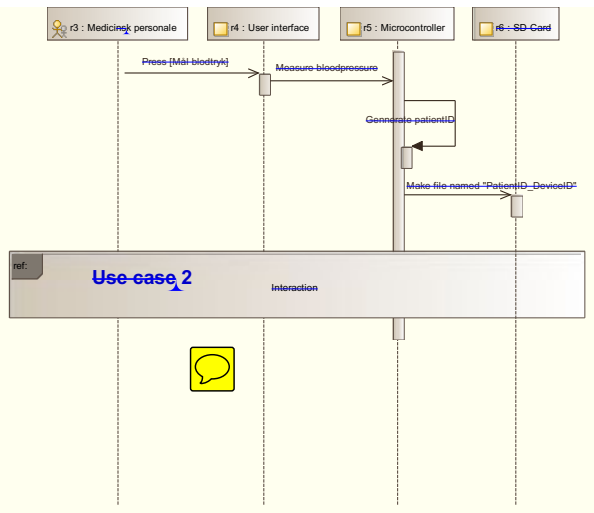
[picture p70: figure]
ref:; Interaction; r6 : SD Card; Press [Mål blodtryk]; Measure bloodpressure; Gennerate patientID; Make file named "PatientID_DeviceID"; Use case 2

r3 : Medicinsk personale | r4 : User interface | r5 : Microcontroller

# SD(UC2)

r8 : User interface | r : Microcontroller | r1 : Power system | r2 : Pump | r3 : Valve | r4 : Cuff | r5 : Pressure sensor | r6 : SD Card
| <<flow>>
Start pump | Current pressure | | <<flow>>
Stop pump | Pump off
Open Valve | Valve on
| | Save systolic pressure
| | Save | MAP
| | Save diastolic pressure
| | Stop collecting pressure data
| | Valve off

Start Collecting pressure data

No | pulsation?
Systolic | pressure?

MAP?

Calculate diastolic pressure

Is pressure <10[mmHg]?

Display bloodpressure | Close valve

Pump on

Air

# SD(UC3)

r : Medicinsk personale | r1 : SD Card | r2 : Database

Take SDCard fromdevice

Mount SDCard in database and import data

Import done

Format SDCard

Format done

Place SDCard in device

# SD(UC4)

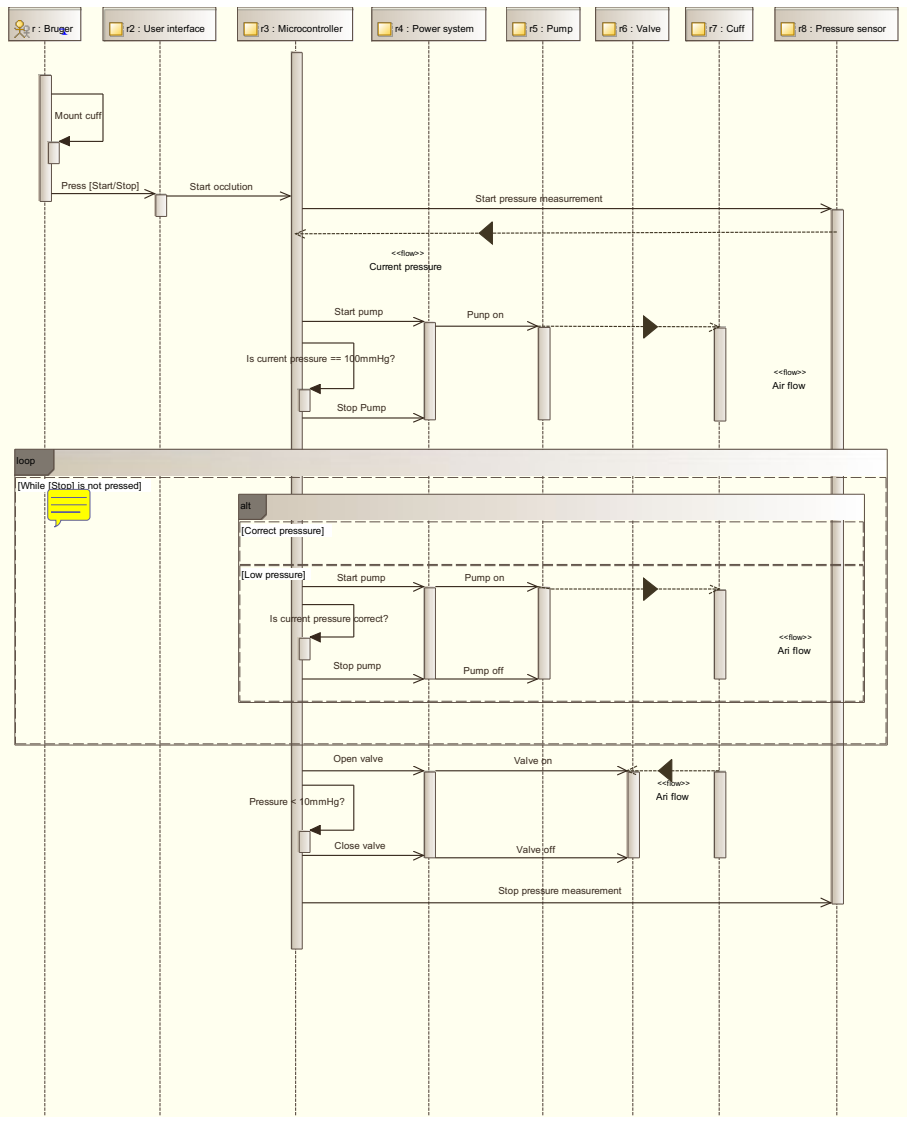
[picture p71: figure]
r : Bruger; r2 : User interface; r3 : Microcontroller; r4 : Power system; r5 : Pump; r6 : Valve; r7 : Cuff; r8 : Pressure sensor; loop; [While; [Stop] is not pressed]; alt; [Correct presssure]; [Low pressure]; Start pump; Pump on; Press [Start/Stop]; Start occlution; <<flow>> Current pressure; Start pressure; measurrement; Is current; pressure == 100mmHg?; Stop Pump; Is current pressure; correct?; Stop pump; Pump off; Open valve; Valve; Pressure; < 10mmHg?; Close valve; Stop pressure measurement; Punp on; off; <<flow>> Air flow; <<flow>> Ari flow; Mount cuff

# SD(UC5)

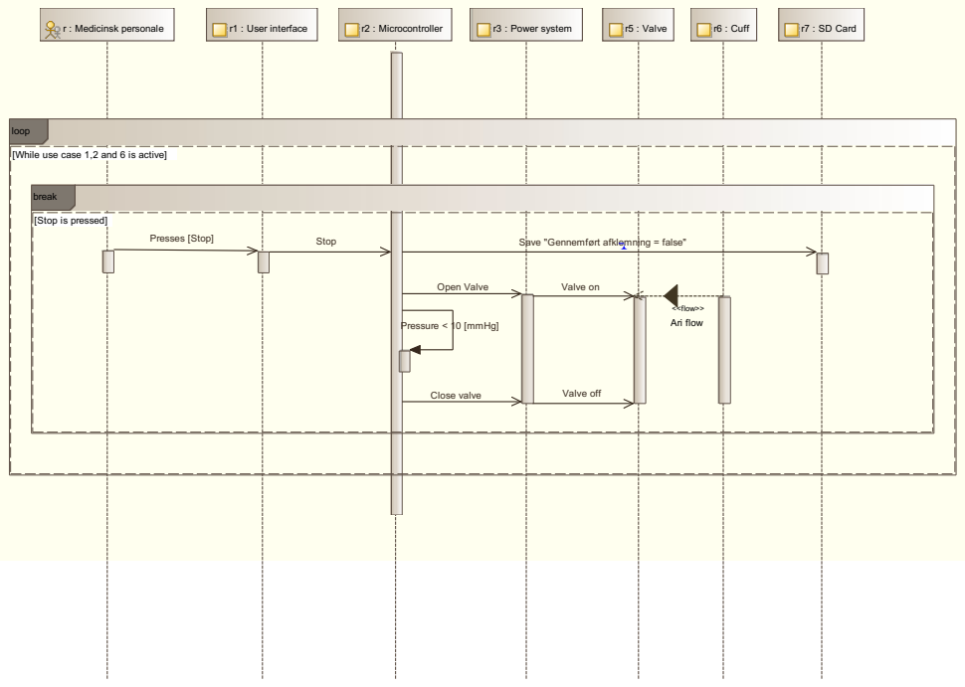
[picture p72: figure]
r : Medicinsk personale; r1 : User interface; r2 : Microcontroller; r3 : Power system; r5 : Valve; r6 : Cuff; r7 : SD Card; loop; [While use case 1,2 and 6 is active]; break; [Stop is pressed]; Presses [Stop]; Stop; Save "Gennemført afklemning = false"; Open Valve; Valve on; Pressure < 10 [mmHg]; Close valve; Valve off; <<flow>> Ari flow

# SD(UC7)

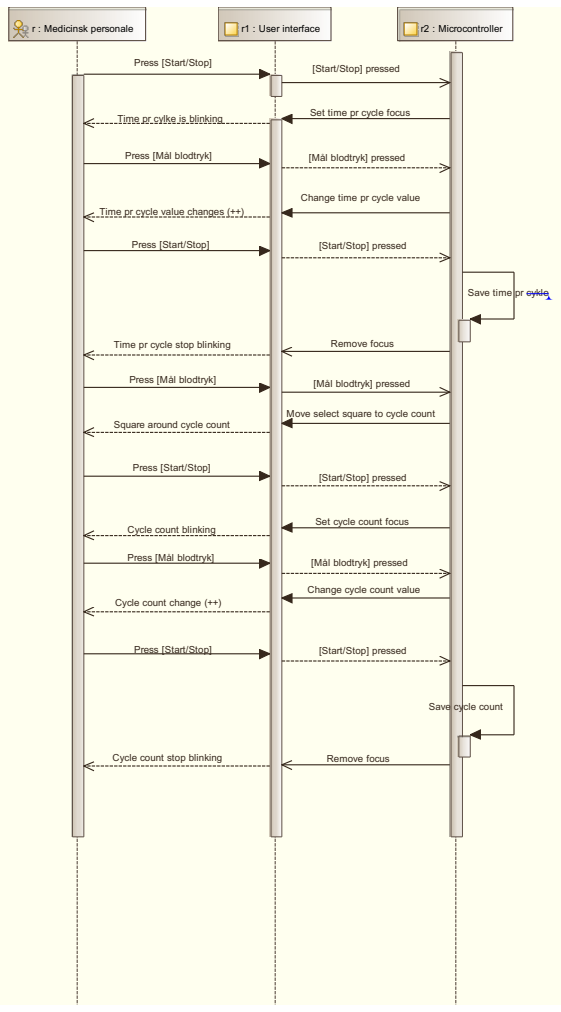
[picture p73: figure]
r : Medicinsk personale; r1 : User interface; r2 : Microcontroller; Press [Start/Stop]; Time pr cylke is blinking; Press [Mål blodtryk]; [Mål blodtryk] pressed; [Start/Stop] pressed; Time pr cycle stop blinking; Cycle count blinking; Cycle count change (++); Cycle count stop blinking; Set time pr cycle focus; Remove focus; Set cycle count focus; Change cycle count value; Save time; pr cykle; Save; cycle count

Time pr cycle value changes (++) | Change time pr cycle value
Square around cycle count | Move select square to cycle count

# SD(UC8)
