kj-schmidt/Perconditioning/TilReview/Accepttest0V1.pdf

## Accepttest

Version: 0.1

Vejleder: Peter
Johansen

Underskrift

Dato

Karl-Johan
Schmidt

Underskrift

Dato

Simon Vammen
Grønbæk

Underskrift

Dato

Kravspecifikation | Version 0.1

## Indholdsfortegnelse

1 Funktionelle krav | 2
2 Ikke funktionelle krav | 13

Page 1

Kravspecifikation | Version 0.1

## 1 Funktionelle krav

### 1.1 Use case 1

Krav nr.: | Handling | Forventet resultat | Testmetode | Resul-tat
1.1.1 | Medicinsk personale placerer manchet-ten på patienten | Manchetten sidder tæt om armen, så trykket fordeles ligeligt over hele området. Hele velcro hæfte siden skal fæstnes i filtsiden. | Manchetten trækkes løst over armen og fast-spændes så den er placeret tæt-siddende omkring overarmen med 2-3 cms afstand fra albuehulen
1.1.2 | Knappen [Start/Stop] trykkes | Der vises et patient ID på skærmen | Knappen [Start/Stop] trykkes
1.1.3 | Et nyt patient ID genereres
1.1.4 | Patient ID’et vises på skærmen
1.1.5 | Blodtrykket måles via use case 3 | Se krav nr. 1.3.1 til 1.3.5
1.1.6 | Manchetten fyldes med luft til et tryk på 25 mmHG over sys-tolisk tryk (minimum 180 mmHg) | Manchet-trykket er 25 mmHg over det systoliske tryk | Aflæs tryk på analogt barom-eter. Systolisk tryk - manchet-tryk = 25 mmHg

Page 2

Kravspecifikation | Version 0.1
1.1.7 | Tidsstempel gemmes når trykket er opnået | Tidsstemplet er gemt i loggen | Tjekke tidsstem-pling på SD ko-rtet
1.1.8 | Trykket opretholdes i 5 minutter (Okklu-sion) og resterende tid vises på displayet | Manchet trykket holdes på mindst systolisk tryk + 10 mmHg i 5 min | Observere analogt barometer i 5 min
1.1.9 | Blodtrykket måles via use case 3 fra punkt 2. | Se krav nr. 1.3.2 til 1.3.5
1.1.10 | Deflaterer cuffen helt og for-bliver i dette stadie i 5 min (Reper-fusion). Ved defla-tion start gemmes tidsstem-pel. Tid til næste okklusion vises på displayet | Manchet trykket er ¡ 10 mmHg i 5 min. kontinuerlig tids nedtælling vises på display. Tidsstempel for deflation start kan aflæses på fil. | Observér analogt barometer 5 min. Tjekke tidsstem-pling på SD ko-rtet

Page 3

Kravspecifikation | Version 0.1
1.1.11 | Gentag
punkt 7-11
(en | cyk-
lus) | fire
gange. Det
nuværende
cyklus
nummer
vises | i
displayet

Det specificerede
antal cyklusser
gennemfører
Observér | at
det | totale | an-
tal | cyklusser
er | tilsvarende
antallet vist på
displayet (tallet til højre for
cyklus nr.)

Extension

Krav nr.: | Handling | Forventet resultat | Testmetode | Resul-tat
1.1.ex1 | Et pa-tient ID eksisterer allerede på apparatet. Der gener-eres ikke noget nyt patient ID | Allerede eksis-terende logfil vedføjes data. Ingen ny logfil generes og det gamle ID vises på skærmen | Kør use case 1 to gange og observér antallet af logfiler, samt ID på dis-play er det samme hver gang

Page 4

Kravspecifikation | Version 0.1
1.1.ex2 | Blodtrykket
kunne ikke
måles.
Gentag use
case 3 hvis
extension 2
ikke lige er
eksekveret.
Ellers
skrives i
display
“FEJL
kunne
ikke måle
blodtryk”
og use casen
stopper
Ved | gen-
tagne | fejl | ved
blodtryksmåling
skrives | en | fe-
jlmeddelelse | i
displayet

Montér manchet
på | cylinder | og
start use case 1.
observere antal
oppustning. Efter
2 opfyldninger af
manchetten observeres displayet

### 1.2 Use case 2

Krav nr.: | Handling | Forventet resultat | Testmetode | Resul-tat
1.2.1 | Brugeren trykker på [Mål blodtryk] | Der vises et patient ID på skærmen | Knappen [Start/Stop] trykkes
1.2.2 | Et nyt patient ID genereres
1.2.3 | Patient ID’et vises på skærmen
1.2.4 | | Se krav nr. 1.3.1 til 1.3.5

Page 5

Kravspecifikation | Version 0.1

Extension

Krav nr.: | Handling | Forventet resultat | Testmetode | Resul-tat
1.2.ex1 | Et pa-tient ID eksisterer allerede på apparatet. Der gener-eres ikke noget nyt patient ID | Allerede eksis-terende logfil vedføjes data. Ingen ny logfil generes og det gamle ID vises på skærmen | Kør use case 2 to gange og observér antallet af logfiler, samt ID på dis-play er det samme hver gang
1.2.ex2 | Blodtrykket kunne ikke måles. Gentag use case 3 hvis extension 2 ikke lige er eksekveret. Ellers skrives i display “FEJL kunne ikke måle blodtryk” og use casen stopper. | Ved gen-tagne fejl ved blodtryksmåling skrives en fe-jlmeddelelse i displayet | Montér manchet på cylinder og start use case 2. observere antal oppustning. Efter to opfyldninger af manchet-ten observeres displayet

Page 6

Kravspecifikation | Version 0.1

### 1.3 Use case 3

Krav nr.: | Handling | Forventet resultat | Testmetode | Resul-tat
1.3.1 | Manchetten fyldes til tryk over systoliske niveau
1.3.2 | Luften lukkes gradvist ud og det systoliske tryk måles | Trykket stemmer overens med reference apparatet med en tolerance på: Mean error +/-5mmHg. Se EN 1060-3, punkt 7.9 | Det målte tryk sammenlignes med trykket målt fra S-105B
1.3.3 | Middel blodtrykket måles
1.3.4 | Det dias-toliske tryk udregnes ud fra MAP og systoliske tryk
1.3.5 | Blodtrykket vises på dis-playet og værdien gemmes i hukom-melse | Systolisk, dias-tolisk og MAP vises på displayet | Gennemfør test-metode 1.1.1 til 1.1.5

Page 7

Kravspecifikation | Version 0.1

### 1.4 Use case 4

Krav nr.: | Handling | Forventet resultat | Testmetode | Resul-tat
1.4.1 | Tag SD kortet ud af blodtryk-sapparatet | Der eksisterer en logfil på SD-kortet og den kopieres til det lokale drev | Indsæt SD-kort i computer. Tjek om fil eksisterer på kortet. Overfør fil til computeren.
1.4.2 | Sæt SD ko-rtet i com-puteren og overfør filen
1.4.3 | Formatér SD kortet | SD-kortet er formateret og tomt for filer | Formatér SD til FAT32. Indsæt SD-kort i apparatet og foretag blodtryksmåling. Tjek om logfil oprettes på SD-kort.
1.4.4 | Sæt SD ko-rtet tilbage i kondi-tioner-ingsappa-ratet

### 1.5 Use case 5

Krav nr.: | Handling | Forventet resultat | Testmetode | Resul-tat
1.5.1 | Saturation og puls detekteres | Der kan aflæses en puls og satura-tion på displayet | Testes med refer-ence pulsoximeter
1.5.2 | Saturation gemmes på SD-kort | Saturation et gemt på på SD-kort | Tjekke tidsstem-pling og satura-tion på SD kortet

Page 8

Kravspecifikation | Version 0.1
1.5.3 | Saturation er >90% | Saturation er >90% | Afklem arm i 5 min og test med reference pulsoximeter
1.5.4 | Behandlingen kan fort-sætte

Extensions

Krav nr.: | Handling | Forventet resultat | Testmetode | Resul-tat
1.5.ex1.1 | Tegn på dårlig kredsløb: Blodtryk-sapparatet stopper kondi-tionerings forløbet | Saturation er <90% og der gemmes et tidsstempel for hvor der afbrydes | Afklem arm til saturationen er under niveau og observe dis-playet. Tjekke tidsstempling på SD kortet

### 1.6 Use case 6

Krav nr.: | Handling | Forventet resultat | Testmetode | Resul-tat
1.6.1 | Montere manchetten på arm/ben | Manchetten sidder tæt om arm/ben. Hele velcro hæfte siden skal fæstnes i filtsiden | Manchetten trækkes løst over arm/ben og fast-spændes så det ønskede område afklemmes. Kontrollér om manchetten er passer i størrelsen

Page 9

Kravspecifikation | Version 0.1
1.6.2 | Tryk på knap [Start/Stop] | Luftpumpen startet | Knappen [Start/Stop] trykkes
1.6.3 | Manchetten pumpes op til 100mmHg | Trykket i mancheten er 100 mmHg med en tolerance på +/-10 mmHg | Observere analogt barometer i 3 min
1.6.4 | Trænings-sættet begyndes og trykkes holdes kon-stant på 100mmHg (+/-5mmHg)
1.6.5 | Tryk på knap [Start/Stop] | Manchet trykket er ¡ 10 mmHg efter 1min. | Knappen [Start/Stop] trykkes og observer at trykket på det analog barometer
1.6.6 | Manchetten deflateres

### 1.7 Use case 7

Krav nr.: | Handling | Forventet resultat | Testmetode | Resul-tat
1.7.1 | Brugeren trykker på knappen [Start/Stop] | Use casen afbryges og manchetten tømmes for luft | Start use case 1, 3 eller 6 og på et vilkårligt tidspunkt tryk på knappen [Start/Stop]
1.7.2 | Den igangværende use case af-brydes

Page 10

Kravspecifikation | Version 0.1
1.7.3 | Manchetten
tømmes
for luft og
tidsstempel
med “Gennemført
afklemning
= false”
gemmes
i hukommelsen

Manchet trykket
er ¡ 10 mmHg
efter | 1 | min.
Tidsstempel | for
“Gennemført afklemning = false”
gemmes i fil

Observere analogt
barometer 1 min.
Tjek | tidsstem-
pling | på | SD
kortet

Extension

Krav nr.: | Handling | Forventet resultat | Testmetode | Resul-tat
1.7.ex1 | Use case 6 er aktiv: ingen data gemmes i hukom-melsen | Der gemmes in-gen data | Kør use case 6 efterfulgt af use case 7 og observér logfilen

### 1.8 Use case 8

Krav nr.: | Handling | Forventet resultat | Testmetode | Resul-tat
1.8.1 | Brugeren trykker på knappen [Start/Stop] for at vælge Tid pr cyklus | Ved knaptryk på [Start/Stop] vælges “Tid pr cyklus” og det valgte område begynder at blinke | Tryk på knappen [Start/Stop] og observér displayet

Page 11

Kravspecifikation | Version 0.1
1.8.2 | Bruger trykker på knap-pen [Mål blodtryk] for at æn-dre Tid pr cyklus | Værdien i det val-gte område æn-dres med 30s per tryk. | Tryk på knappen [Mål blodtryk] og observér ændrin-gen
1.8.3 | Bruger trykker på knappen [Start/Stop] for at gemme ændringen | Værdien gemmes og det valgte område stopper med at blinke | Tryk på knappen [Start/Stop] og observér dis-playet. Start use case 1 og tjek occlutionstid
1.8.4 | Bruger trykker på knap-pen [Mål blodtryk] for at navigere til Antal cyklusser | Ved knap-tryk på [Mål blodtryk] flyttes den firkantede markør på dis-playet til “Antal cyklusser” | Tryk på knappen [Mål blodtryk] og observér ændrin-gen
1.8.5 | Ved knap tryk på [Start/stop] vælges Antal cyklusser | Ved knaptryk på [Start/Stop] vælges “Antal cyklusser” og det valgte område begynder at blinke | Tryk på knappen [Start/Stop] og observér displayet
1.8.6 | Ved knap tryk på [Mål blodtryk] ændre Antal af cyklusser | Værdien i det val-gte område æn-dres med 1 per tryk. | Tryk på knappen [Mål blodtryk] og observér ændrin-gen

Page 12

Kravspecifikation | Version 0.1
1.8.7 | Brugeren
trykker på
knappen
[Start/Stop]
for | at
gemme
ændringen

Værdien gemmes
og | det | valgte
område | stopper
med at blinke

Tryk på knappen
[Mål blodtryk] og
observér ændringen. start use
case 1 og tjek total antal cyklusser

## 2 Ikke funktionelle krav

### 2.1 Microcontroller

Krav nr.: | Handling | Forventet resultat | Testmetode | Resul-tat
2.1.1 | Type: At-mega32 | Atmega32 | Visuel inspektion af microcontroller

### 2.2 Filformat og opsætning

Krav nr.: | Handling | Forventet resultat | Testmetode | Resul-tat
2.2.1 | Data logged i formatet .csv og hver kolonne indeholder følgende værdier og enheder:
2.2.1a | Tidsstempel [yy:mm:dd hh:mm:ss]

Logfil er
kommasepareret
og at enhederne
stemmer overens.
of filen er af type
.csv

Inspicer logfil i
texteditor (Gedit,
notepad, textedit
osv.)

Page 13

Kravspecifikation | Version 0.1
2.2.1b | Afklemnings- tryk [mmHg]
2.2.1c | Gennemført afklemning [Boolean]
2.2.1d | Systoliske blodtryk [mmHg]
2.2.1e | Middel-blodtryk (MAP) [mmHg]
2.2.1f | Diastolisk blodtryk [mmHg]
2.2.2 | Der opret-tet én fil pr patient, med filnavn tilsvarende det unikke patient ID og appa-ratets ID i følgende format: “PatientID ApparatID” | En enkel fil eksistere på SD-kortet. filnavnet består af “Patien-tID ApparatID” | Kør use case 2 flere gange og ob-server antallet og navngivningen af logfil(er)

Page 14

Kravspecifikation | Version 0.1

### 2.3 Patient ID

Krav nr.: | Handling | Forventet resultat | Testmetode | Resul-tat
2.3.1 | Består af karakter-erne A-Z og tallene 0-9 | PatientID består af karaktererne | Kør use case 2 og observer navn-givningen af logfil
2.3.1a | ID’et er fem karakterer lang: ***** svarende til 60 millioner kombina-tioner | A-Z og tallene 0-9 | Visuel inspektion af logfilen
2.3.1b | ID’et er ikke case sensitiv

### 2.4 Hukommelse

Krav nr.: | Handling | Forventet resultat | Testmetode | Resul-tat
2.4.1 | Information lagres på micro SDSC af typen: | SD kortet er af typen micro SDSC, class 4, fat32 og minimum 128mb | Tag SD kortet ud og se specifikationer
2.4.1a | Class 4
2.4.1b | Fil system [fat32] og minimum 128mb

Page 15

Kravspecifikation | Version 0.1

### 2.5 Forsyning

Krav nr.: | Handling | Forventet resultat | Testmetode | Resul-tat
2.5.1 | Konditione-ringsap-paratet skal forsynes med 12V, min 2A
2.5.1a | DC-connector, ydre Ø=5,5mm, indre Ø = 2,1 | Connectoren har målene: ydre Ø=5,5mm, indre Ø = 2,1 mm | Mål med sky-delære
2.5.1b | 8 stk AAA batterier (1,5V) | 8 stk AAA bat-terier | Visuel inspektion

### 2.6 Fysiske krav

Krav nr.: | Handling | Forventet resultat | Testmetode | Resul-tat
2.6.1 | Knapper | Knapperne er tilstede på apparatet | Visuel inspektion 2.6.1a
| [Start/Stop]
2.6.1b | [Mål blodtryk]
2.6.2 | Hvert appa-rat udstyres med et unik serie num-mer, kaldet apparat ID

Page 16
