kj-schmidt/Perconditioning/Udviklingsdokumentation/SystemArkitektur/SystemArkitektur.pdf

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
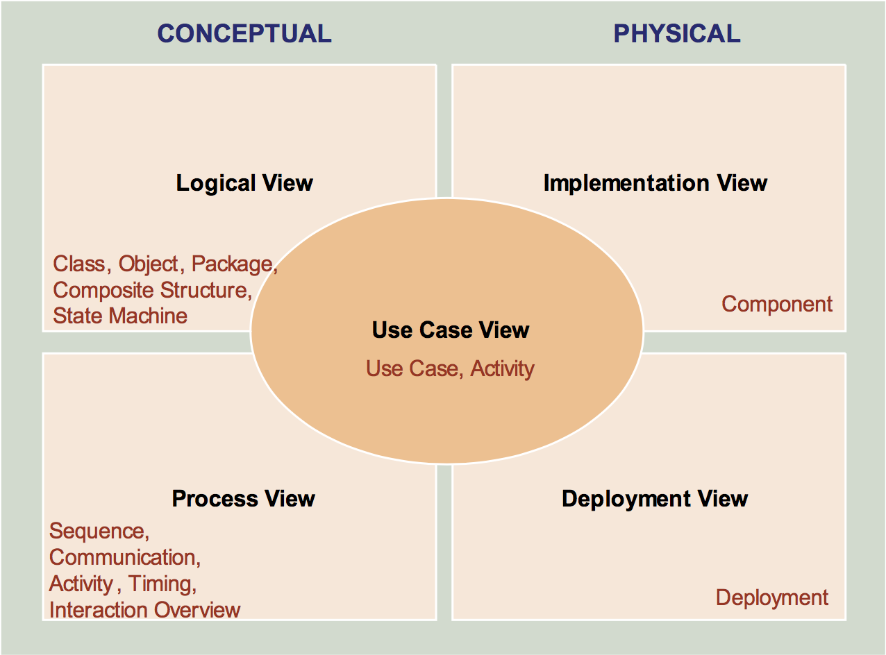
[picture p82: figure]

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

3.2. Logic | Aarhus Universitet
3.2 | Logic
3.2.1 | Block denition diagram

## Blokdiagrammer giver et indblik på den overordnede strukturen af Konditioneringsapparatet. Hver kasse skal ses som en del der indgår i systemet

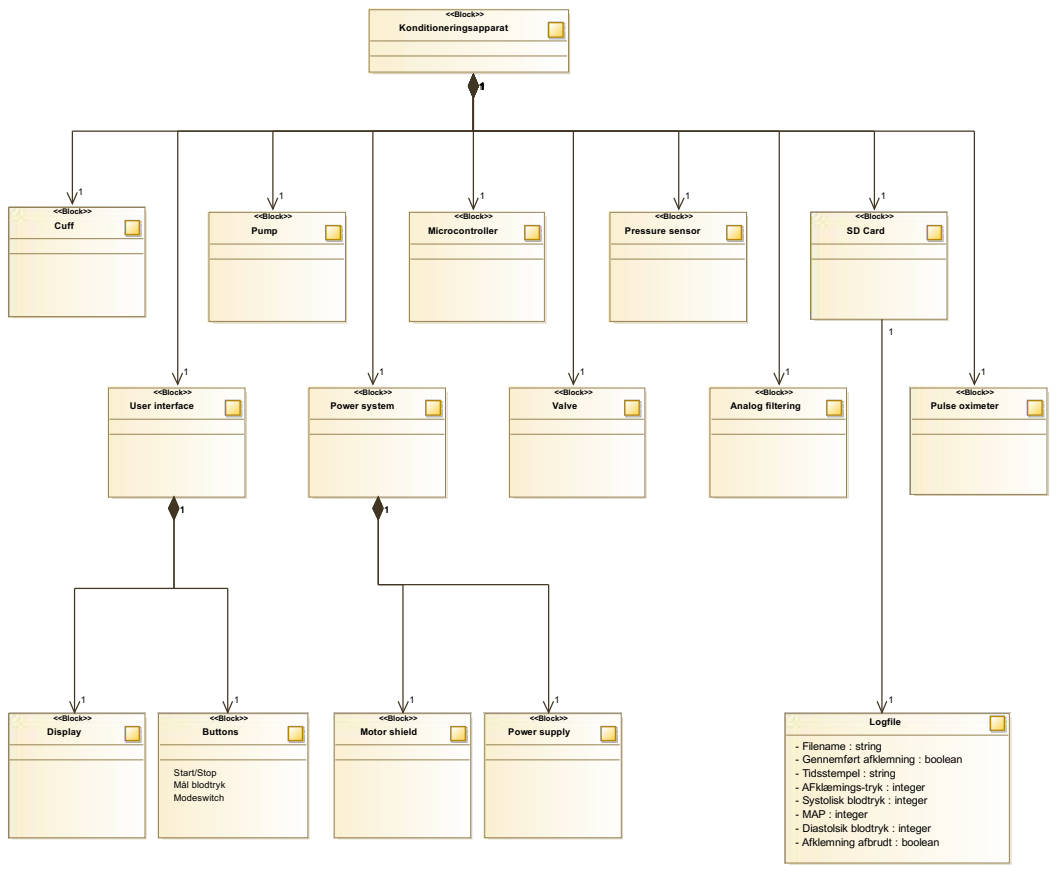
[picture p83: figure]
<<Block>> Konditioneringsapparat; <<Block>> Cuff; <<Block>> User interface; <<Block>> Power system; <<Block>> Analog filtering; <<Block>> Pressure sensor; <<Block>> Pump; <<Block>> Valve; <<Block>> Microcontroller; <<Block>> SD Card; <<Block>> Display; <<Block>> Buttons; Start/Stop Mål blodtryk Modeswitch; <<Block>> Pulse oximeter; Logfile; - Filename : string - Gennemført afklemning : boolean - Tidsstempel : string - AFklæmings-tryk : integer - Systolisk blodtryk : integer - MAP : integer - Diastolsik blodtryk : integer - Afklemning afbrudt : boolean; <<Block>> Motor shield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

## Figur 3.2. Block denition diagram over Konditioneringsapparatet

11

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

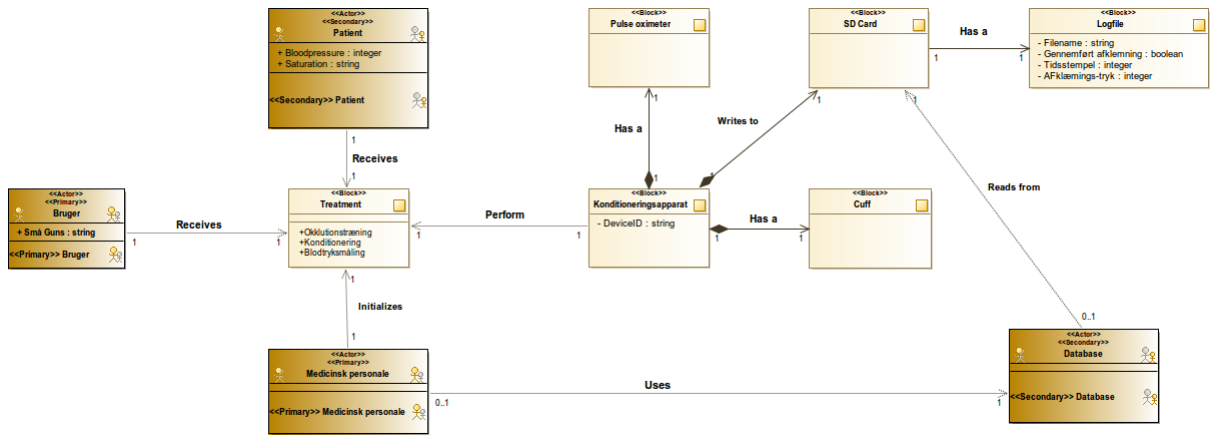
[picture p84: figure]

3.2. Logic | Aarhus Universitet
3.2.3 | State machine diagram

## For at hjælpe med forståelsen af Konditioneringsapparatets opbygning er der udarbejdet sekvens diagrammer over systemets tre programmer hhv. konditionering, okklusionstræ-

ning og setup. Der er desuden lavet et overordnede sekvens diagram over hele systemet.

## Sekvens diagrammerne beskæftiger sig med hvilke stadier programmet operer i, og hvilke

parametre der skal være opfyldt før der skiftes til et andet stadie.

## 3.2.3.1 Boot

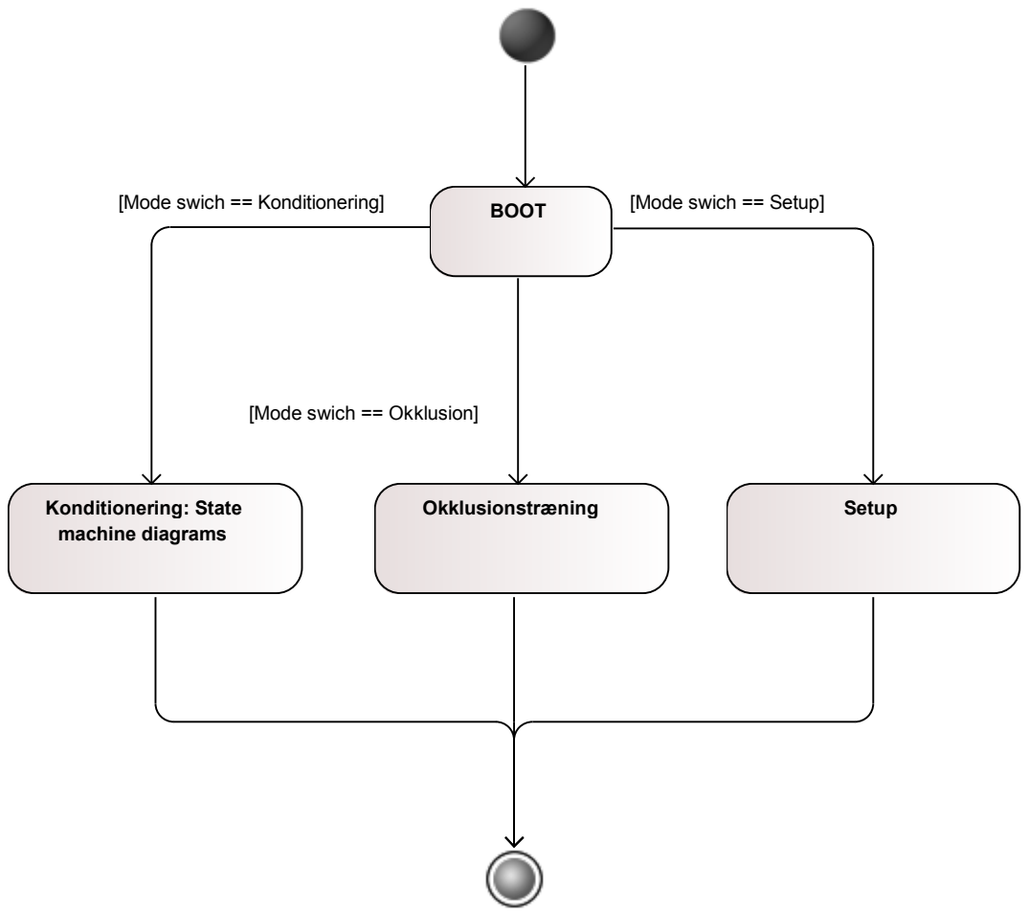
[picture p85: figure]
Konditionering: State machine diagrams; Okklusionstræning; Setup; BOOT [Mode swich == Konditionering]; [Mode swich == Okklusion]; [Mode swich == Setup]

## Figur 3.4. State machine diagram over programvalg på Konditioneringsapparatet

13

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

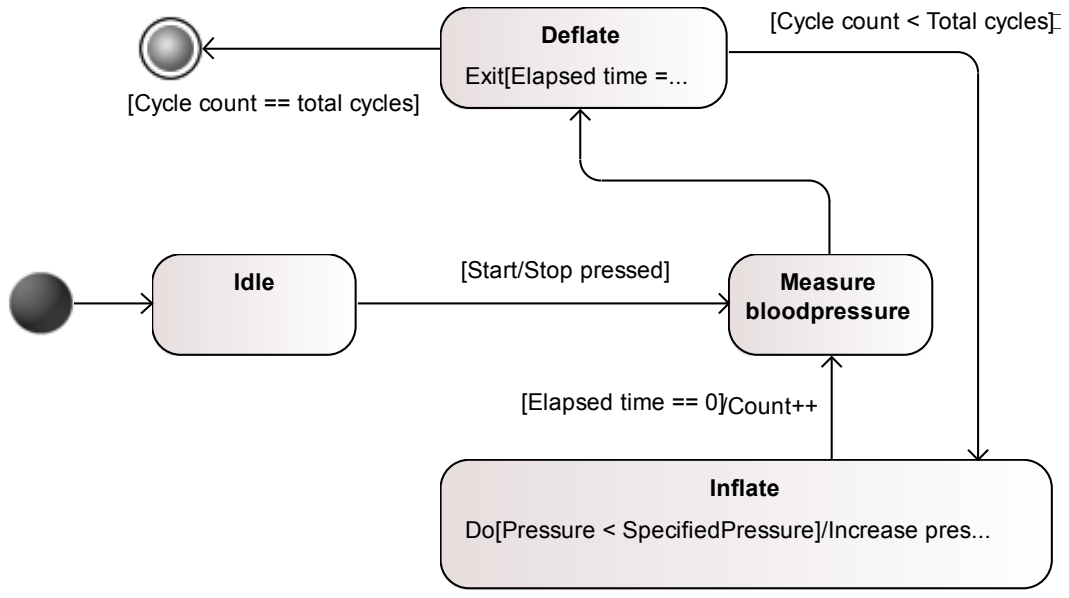
[picture p86: figure]

3.2. Logic | Aarhus Universitet
3.2.3.3 | Okklusion

## Beskrivelse af stadierne:

| Idle: Stadie som programmet bender sig i, før brugeren har foretaget noget.
| Inate: Ved knaptryk på [Start/Stop] skifter systemet til dette stadie, her holdes
trykket konstant på 100mmHg.
Deate: Dette stadie er manchetten tømt for luft.

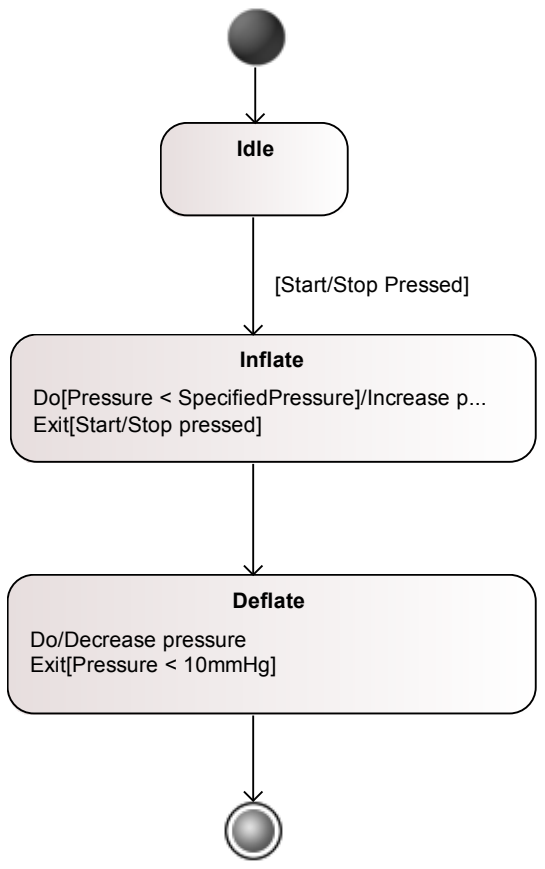
[picture p87: figure]
Idle; Inflate; Exit[Start/Stop pressed]; Deflate; Do/Decrease pressure Exit[Pressure < 10mmHg]; [Start/Stop Pressed]

Do[Pressure < SpecifiedPressure]/Increase p...

## Figur 3.7. State machine diagram over okklusionsforløb

15

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

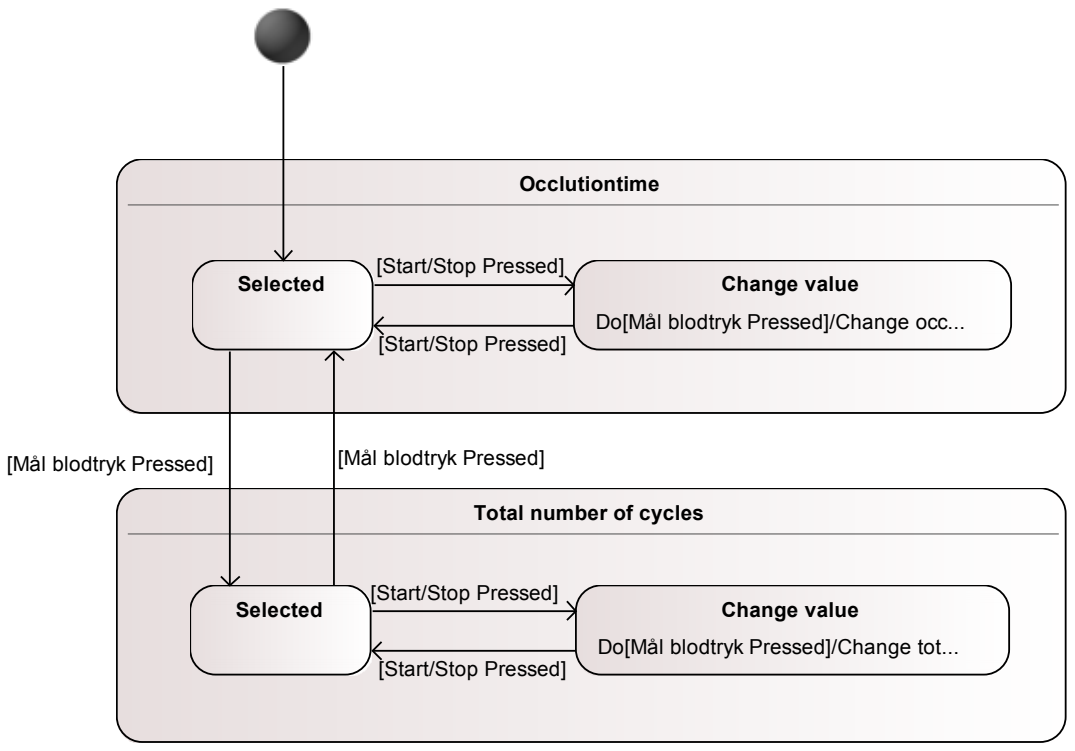
[picture p88: figure]

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

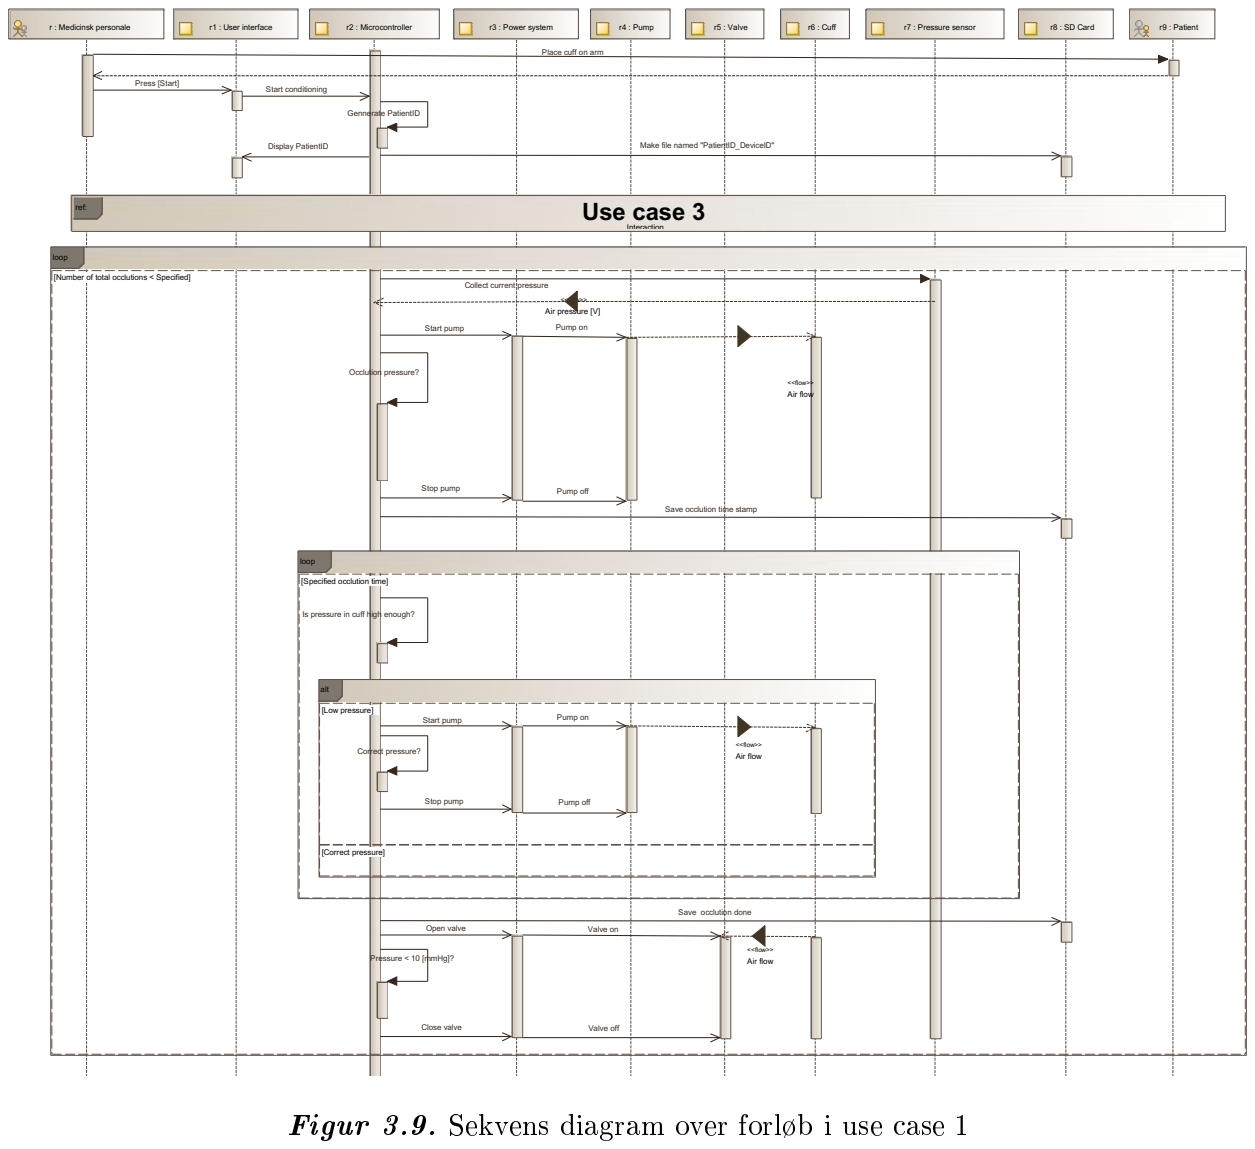
[picture p89: figure]

Gruppe 15155 | 3. Arkitektur
3.3.3 | Initialiser blodtryksmåling - UC2 r3 : Medicinsk personale | r4 : User interface | r5 : Microcontroller

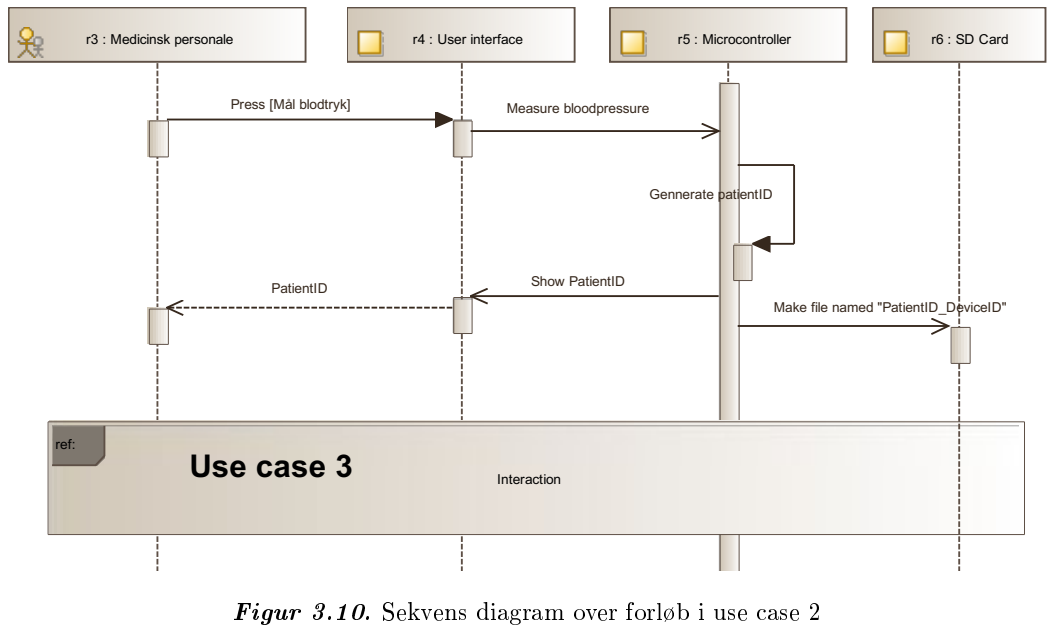
[picture p90: figure]
ref:; Interaction; r6 : SD Card; Press [Mål blodtryk]; PatientID; Measure bloodpressure; Show PatientID; Gennerate patientID; Make file named "PatientID_DeviceID"; Use case 3

## Figur 3.10. Sekvens diagram over forløb i use case 2

18

3.3. Process | Aarhus Universitet
3.3.4 | Mål blodtryk - UC3 r8 : User interface | r : Microcontroller | r1 : Power system | r2 : Pump | r3 : Valve | r4 : Cuff | r5 : Pressure sensor | r6 : SD Card

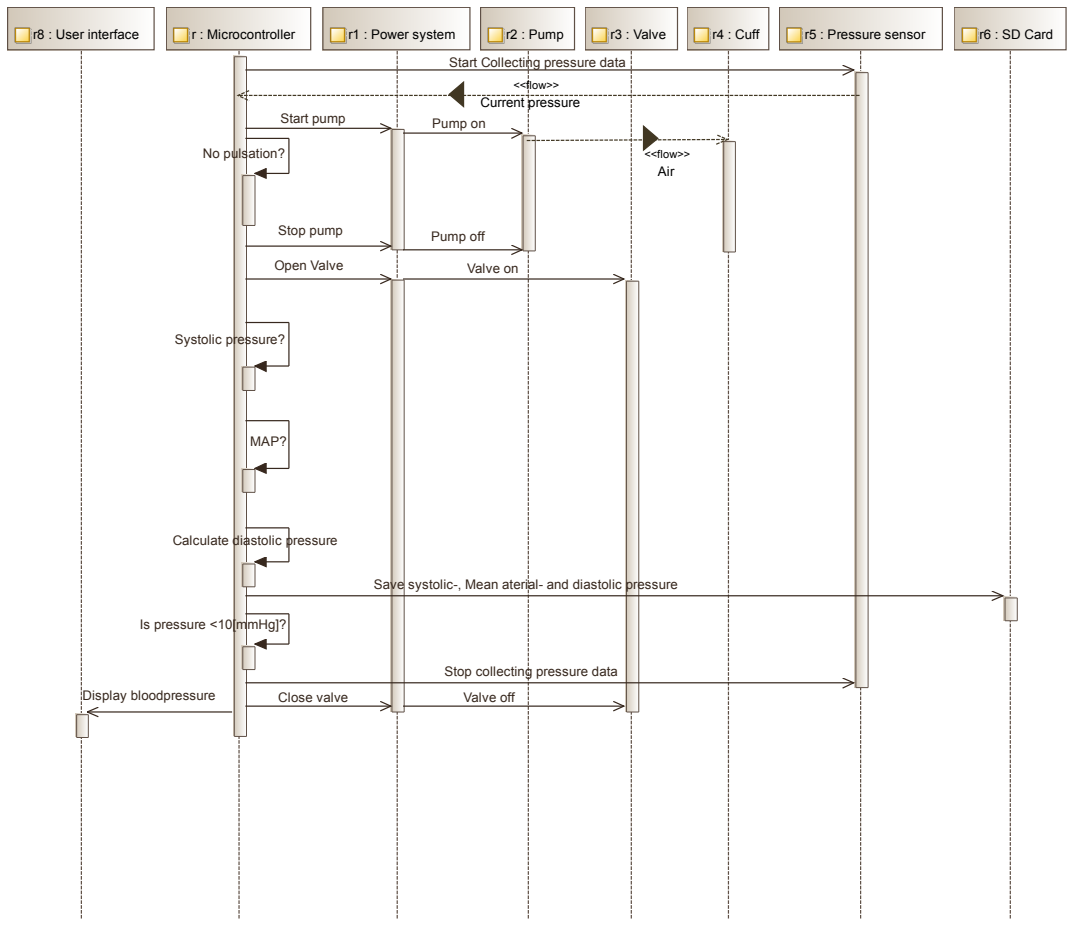
[picture p91: figure]
<<flow>>; Start pump; Current pressure Pump on; Start Collecting pressure data; No pulsation?; Stop pump; Open Valve; Systolic pressure?; MAP?; Calculate diastolic pressure; Is pressure <10[mmHg]?; Stop collecting pressure data; Display bloodpressure; Close valve; Pump off; Valve on; Valve off; <<flow>> Air

Save systolic-, Mean aterial- and diastolic pressure

## Figur 3.11. Sekvens diagram over forløb i use case 3

19

Gruppe 15155 | 3. Arkitektur
3.3.5 | Overfør data - UC4 r : Medicinsk personale | r1 : SD Card | r2 : Database

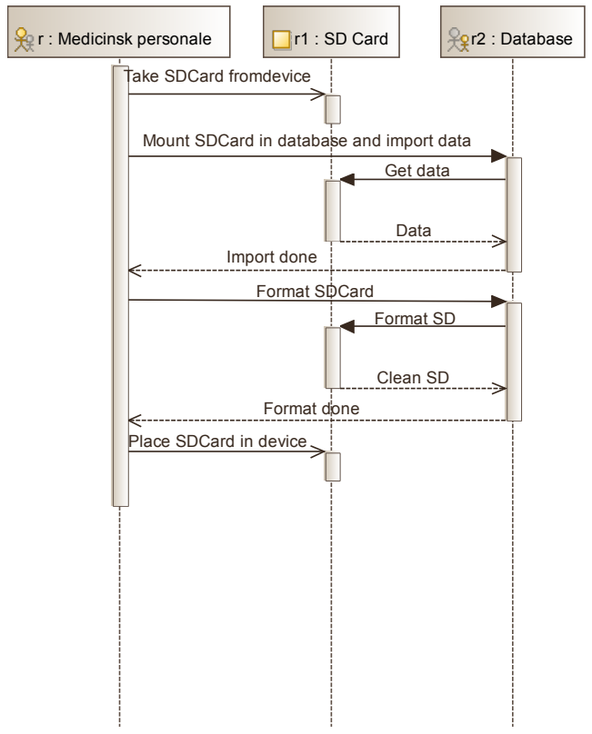
[picture p92: figure]
Take SDCard fromdevice; Import done; Format SDCard; Format done; Place SDCard in device; Get data; Data; Format SD; Clean SD

## Mount SDCard in database and import data

## Figur 3.12. Sekvens diagram over forløb i use case 4

20

3.3. Process | Aarhus Universitet
3.3.6 | Sikkerhedskontrol med pulsoximeter - UC5

Mangler stadig...

# 3.3.7 Okklusionstræning - UC6

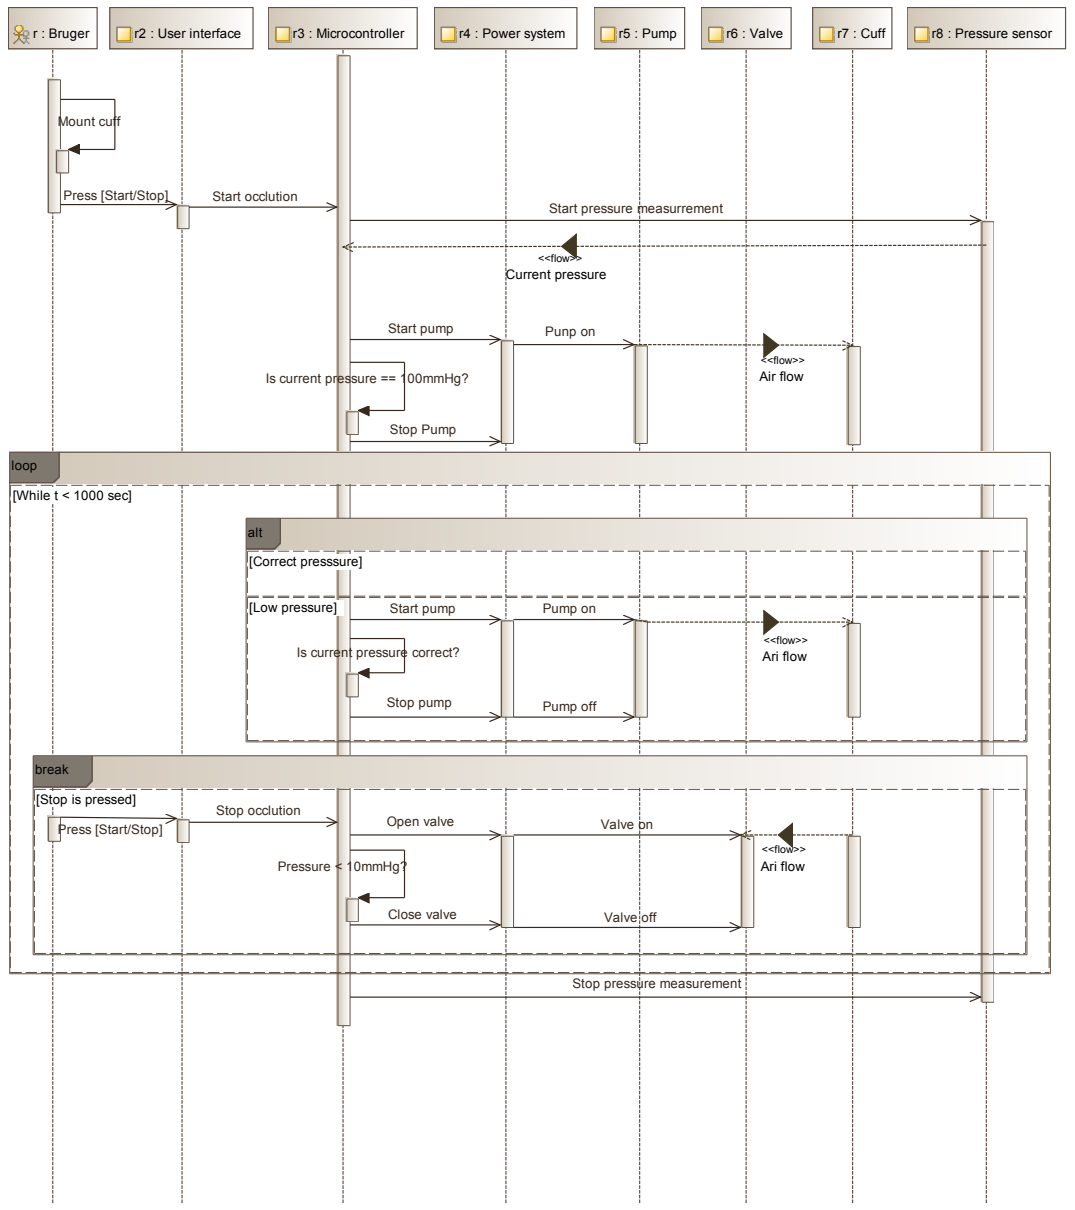
[picture p93: figure]
r : Bruger; r2 : User interface; r3 : Microcontroller; r4 : Power system; r5 : Pump; r6 : Valve; r7 : Cuff; r8 : Pressure sensor; loop; [While t < 1000 sec]; alt; [Correct presssure]; [Low pressure]; Start pump; Pump on; break; [Stop is pressed]; Stop occlution; Open valve; Valve on; Press [Start/Stop]; Start occlution; <<flow>> Current pressure; Start pressure measurrement; Is current pressure == 100mmHg?; Stop Pump; Is current pressure correct?; Stop pump; Pump off; Pressure < 10mmHg?; Close valve; Stop pressure measurement; Punp on; Valve off; <<flow>> Air flow; <<flow>> Ari flow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

## Figur 3.13. Sekvens diagram over forløb i use case 6

21

Gruppe 15155 | 3. Arkitektur
3.3.8 | Afbryd - UC7 r : Medicinsk personale | r1 : User interface | r2 : Microcontroller | r3 : Power system | r5 : Valve | r6 : Cuff | r7 : SD Card

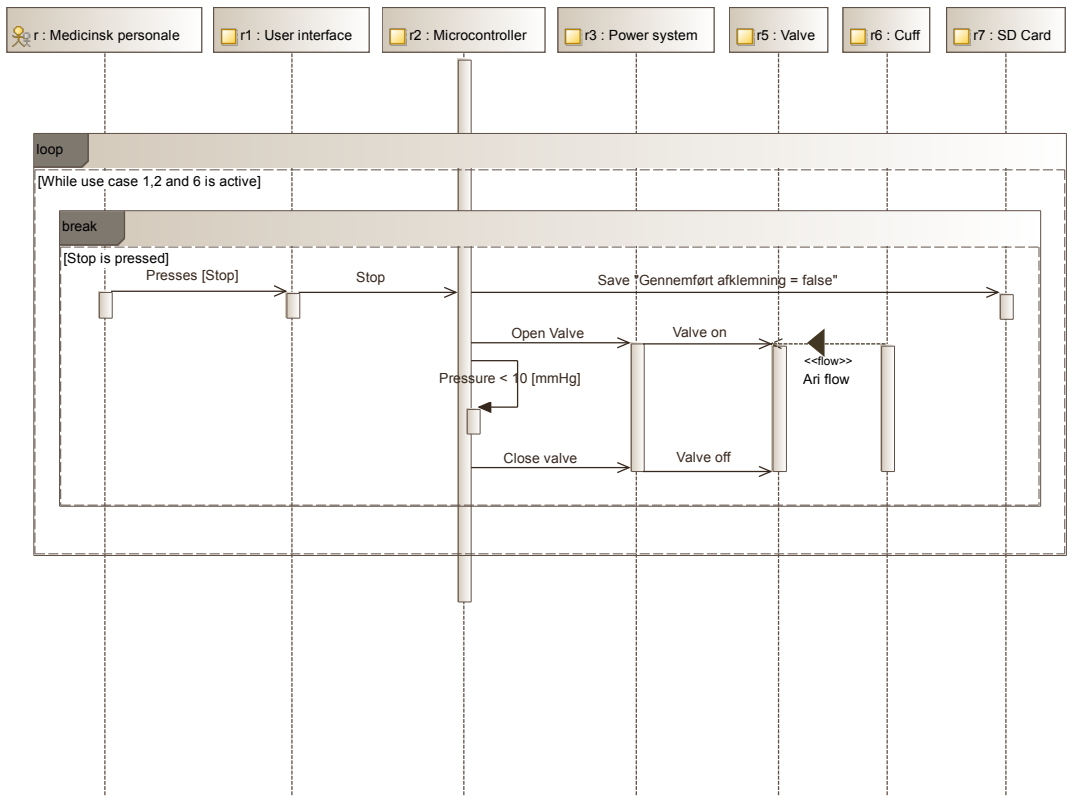
[picture p94: figure]
loop; [While use case 1,2 and 6 is active]; break; [Stop is pressed]; Presses [Stop]; Stop; Save "Gennemført afklemning = false"; Open Valve; Valve on; Pressure < 10 [mmHg]; Close valve; Valve off; <<flow>> Ari flow

## Figur 3.14. Sekvens diagram over forløb i use case 7

22

3.3. Process | Aarhus Universitet
3.3.9 | Setup - UC8 r : Medicinsk personale | r1 : User interface | r2 : Microcontroller

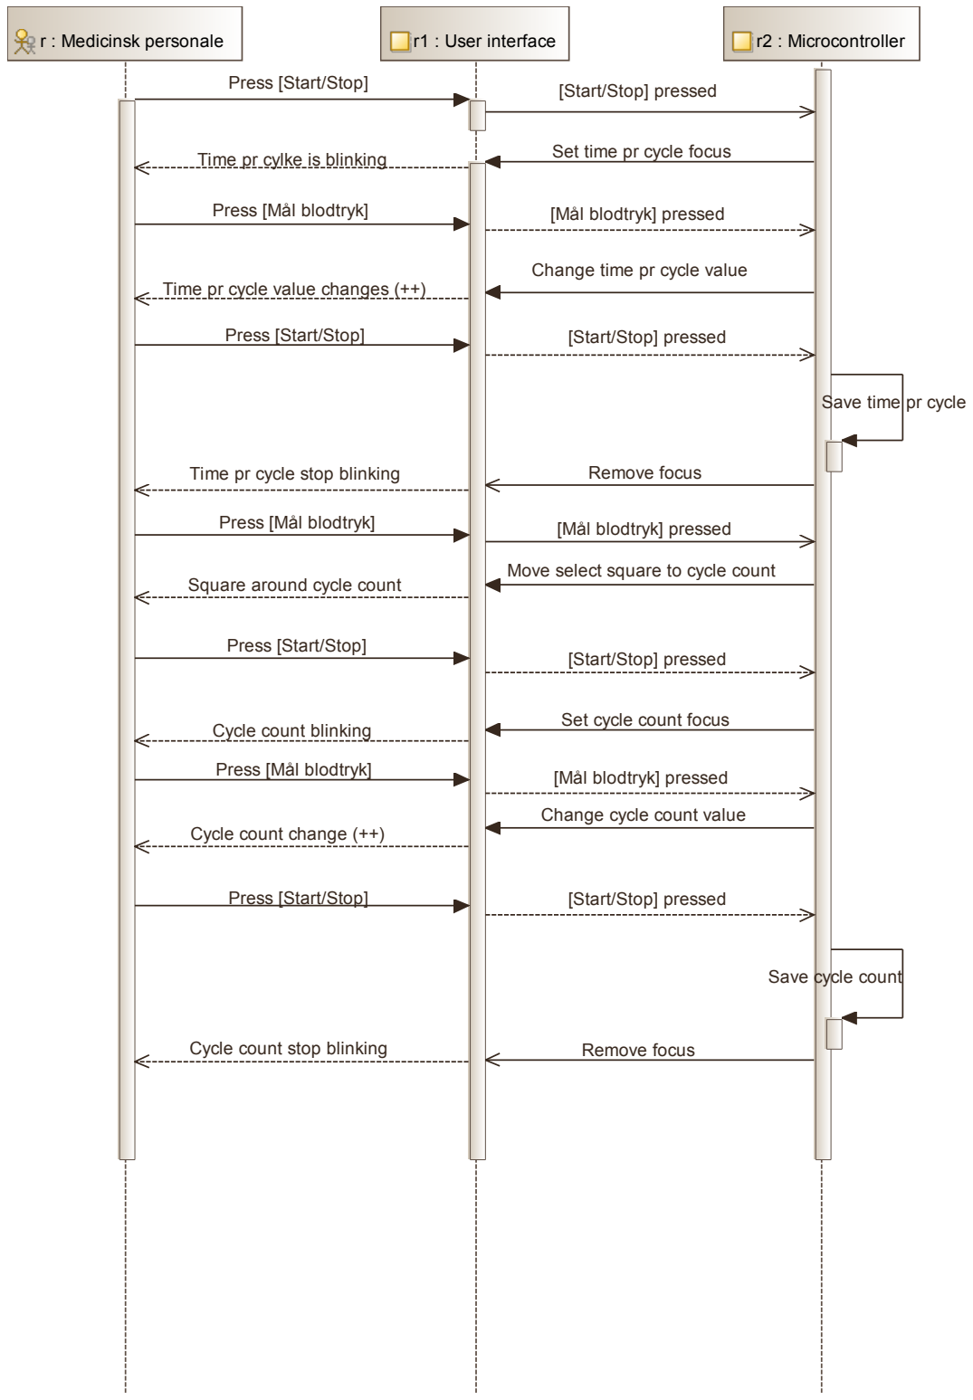
[picture p95: figure]
Press [Start/Stop]; Time pr cylke is blinking; Press [Mål blodtryk]; Time pr cycle value changes (++); Time pr cycle stop blinking; Square around cycle count; Cycle count blinking; Cycle count change (++); Cycle count stop blinking; [Start/Stop] pressed; Set time pr cycle focus; [Mål blodtryk] pressed; Change time pr cycle value; Remove focus; Move select square to cycle count; Set cycle count focus; Change cycle count value; Save time pr cycle; Save cycle count

## Figur 3.15. Sekvens diagram over forløb i use case 8

23

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

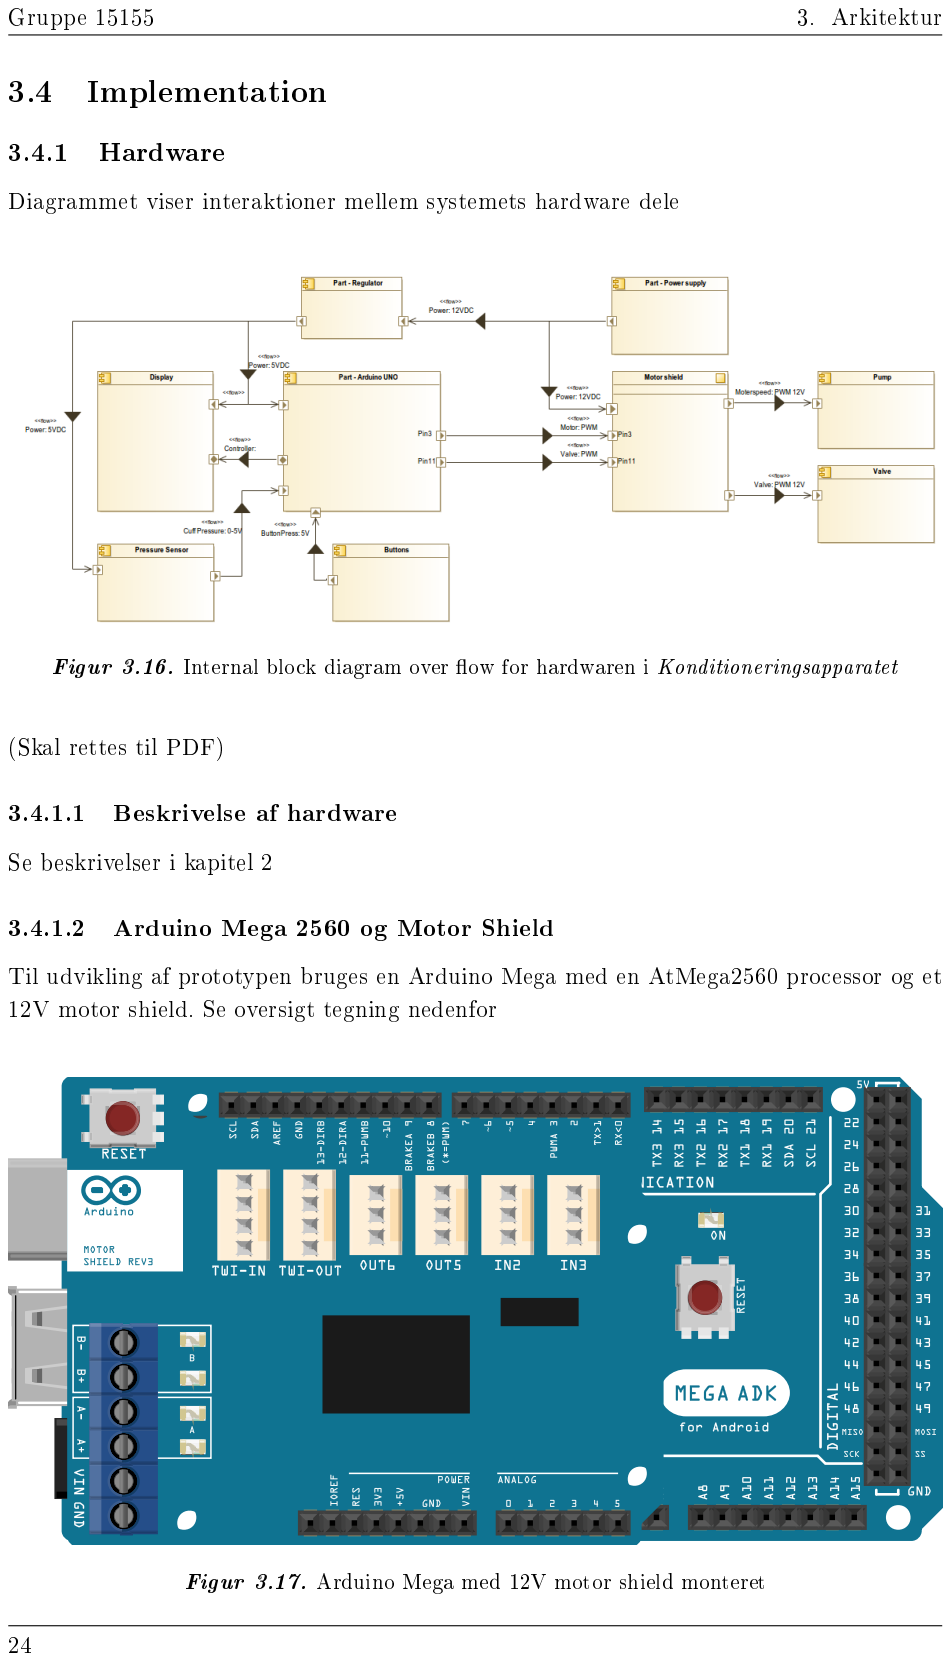
[picture p96: page 24]

3.4. Implementation | Aarhus Universitet
3.4.2 | Software

## Konditioneringsapparet består kun af ét software system og det kræver ikke ere software systemer for at apparatet fungere. Dette giver derfor et simpelt struktur for softwaren

## 3.4.2.1 Klasse diagram

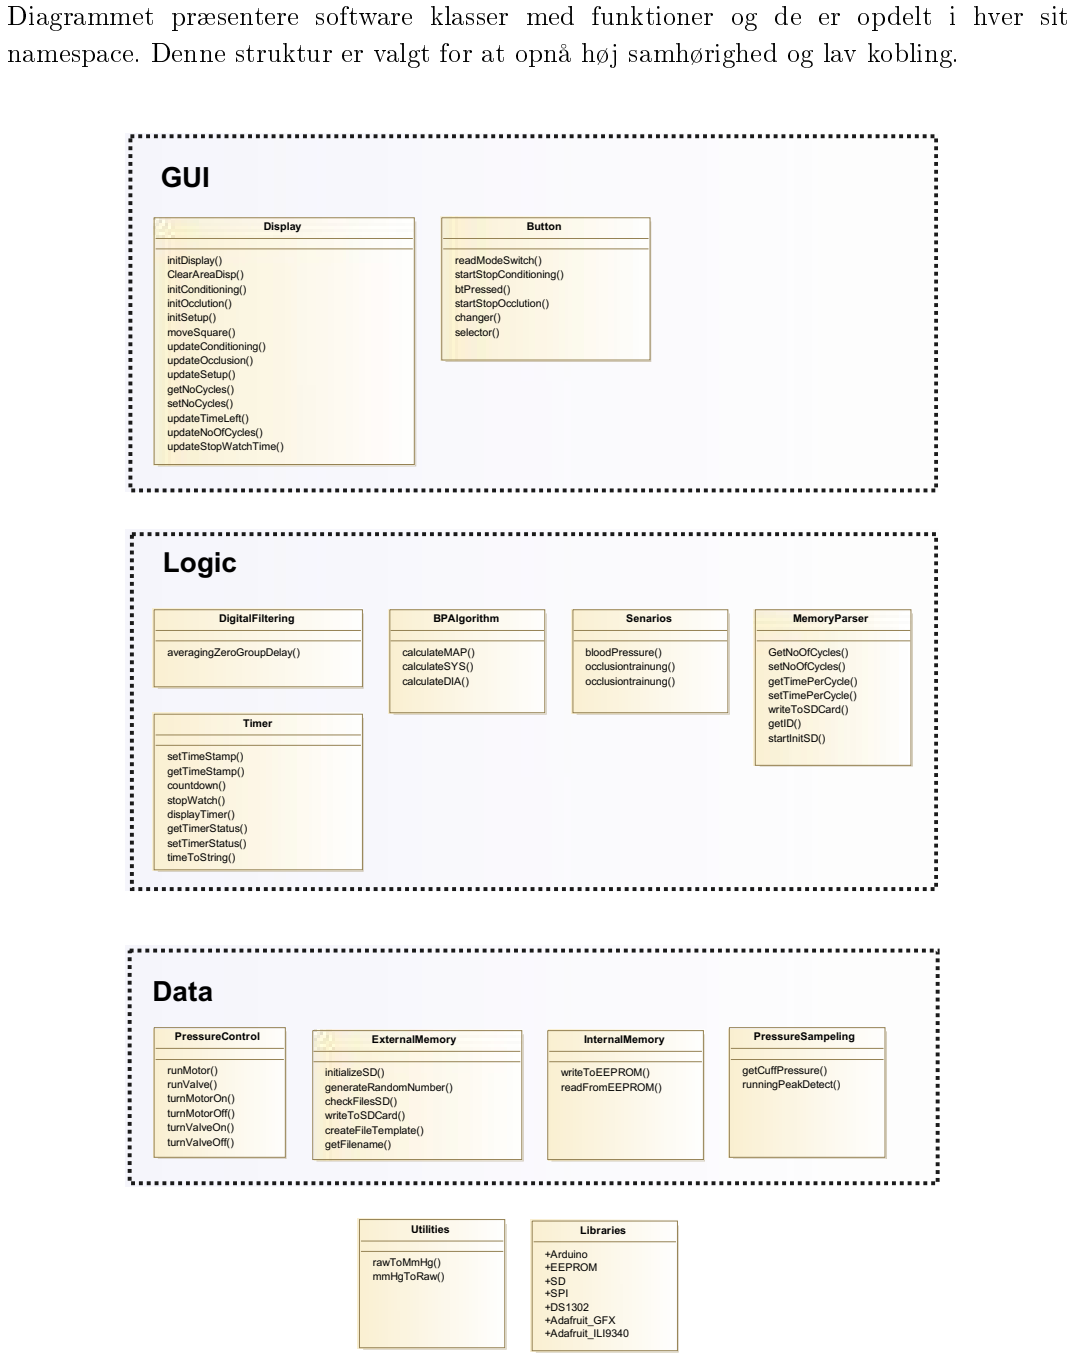
[picture p97: figure]
Button; readModeSwitch() startStopConditioning() btPressed() startStopOcclution() changer() selector(); PressureControl; runMotor() runValve() turnMotorOn() turnMotorOff() turnValveOn() turnValveOff(); ExternalMemory; initializeSD() generateRandomNumber() checkFilesSD() writeToSDCard() createFileTemplate() getFilename(); InternalMemory; writeToEEPROM() readFromEEPROM(); PressureSampeling; getCuffPressure() runningPeakDetect(); BPAlgorithm; calculateMAP() calculateSYS() calculateDIA(); DigitalFiltering; averagingZeroGroupDelay(); Senarios; bloodPressure() occlusiontrainung() occlusiontrainung(); Utilities; rawToMmHg() mmHgToRaw(); Display; initDisplay() ClearAreaDisp() initConditioning() initOcclution() initSetup() moveSquare() updateConditioning() updateOcclusion() updateSetup() getNoCycles() setNoCycles() updateTimeLeft() updateNoOfCycles() updateStopWatchTime(); Timer; setTimeStamp() getTimeStamp() countdown() stopWatch() displayTimer() getTimerStatus() setTimerStatus() timeToString(); MemoryParser; GetNoOfCycles() setNoOfCycles() getTimePerCycle() setTimePerCycle() writeToSDCard() getID() startInitSD(); Libraries; +Arduino +EEPROM +SD +SPI +DS1302 +Adafruit_GFX +Adafruit_ILI9340; GUI; Logic; Data

## Diagrammet præsentere software klasser med funktioner og de er opdelt i hver sit

namespace. Denne struktur er valgt for at opnå høj samhørighed og lav kobling.

## Figur 3.18. Class diagram for softwaren i Konditioneringsapparatet

25

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
