kj-schmidt/Perconditioning/Udviklingsdokumentation/Implementeringsdokument/klassediagram_extra-crop_backup.pdf

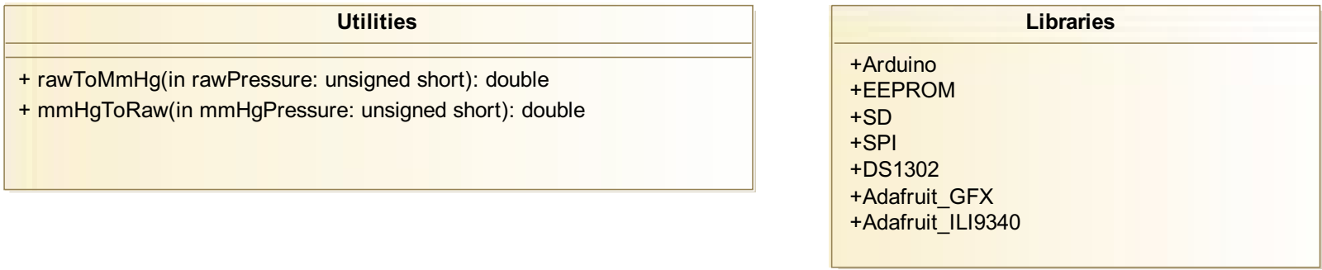
[picture p99: page 1]

Utilities

+ rawToMmHg(in rawPressure: unsigned short): double
+ mmHgToRaw(in mmHgPressure: unsigned short): double

Libraries

+Arduino
+EEPROM
+SD
+SPI
+DS1302
+Adafruit_GFX
+Adafruit_ILI9340
