kj-schmidt/Perconditioning/Udviklingsdokumentation/Implementeringsdokument/klassediagram_forsimplet-crop.pdf

Button

PressureControl | ExternalMemory | InternalMemory | PressureSampeling
DigitalFiltering | BPAlgorithm | Senarios

Utilities

Display

MemoryParser | Timer

Libraries

# GUI

# Logic

# Data
