kj-schmidt/Perconditioning/Udviklingsdokumentation/SystemArkitektur/pdfs/STM_Konditionering1.pdf

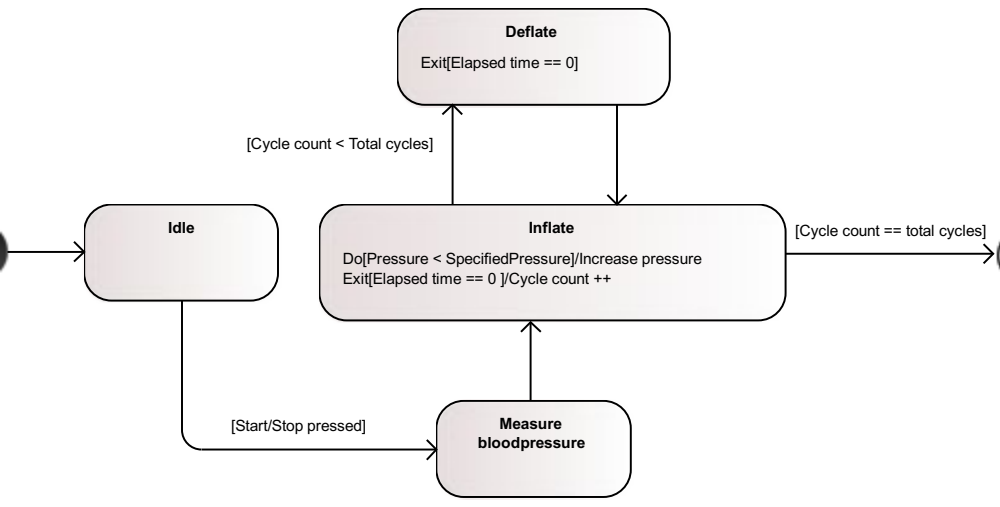
[picture p100: figure]
Deflate; Exit[Elapsed time == 0]; Measure bloodpressure; Idle; Inflate; Do[Pressure < SpecifiedPressure]/Increase pressure Exit[Elapsed time == 0 ]/Cycle count ++; [Cycle count == total cycles]; [Start/Stop pressed]; [Cycle count < Total cycles]
