kj-schmidt/Perconditioning/Udviklingsdokumentation/SystemArkitektur/pdfs/DomainModel.pdf

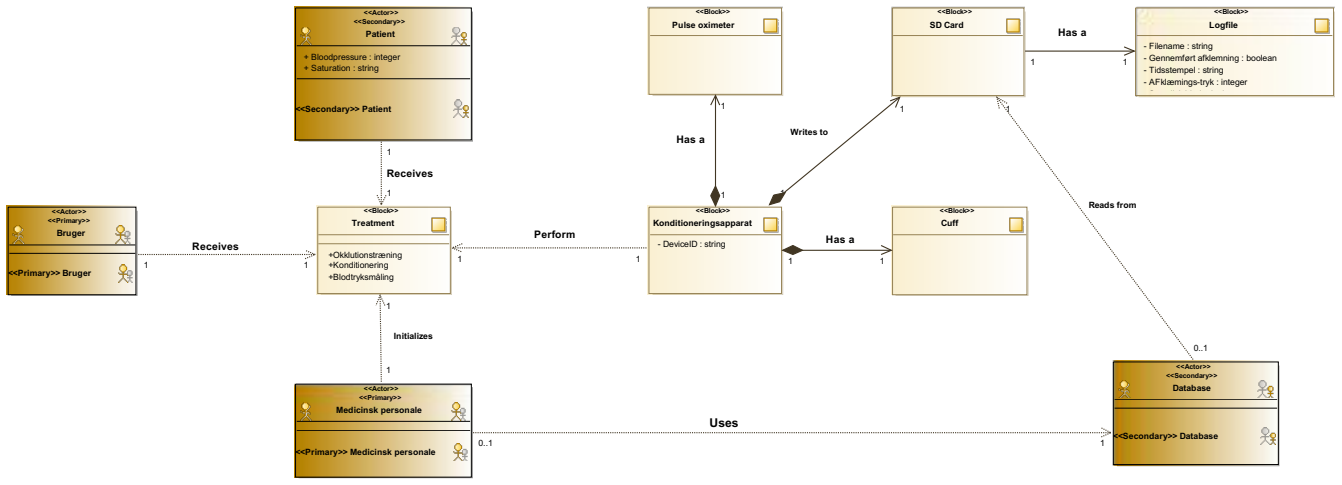
[picture p101: figure]
<<Actor>> <<Secondary>> Patient; + Bloodpressure : integer + Saturation : string; <<Secondary>> Patient; <<Actor>> <<Primary>> Bruger; <<Primary>> Bruger; <<Actor>> <<Primary>> Medicinsk personale; <<Primary>> Medicinsk personale; <<Block>> Konditioneringsapparat; - DeviceID : string; <<Block>> Cuff; <<Block>> SD Card; <<Block>> Logfile; - Filename : string - Gennemført afklemning : boolean - Tidsstempel : string - AFklæmings-tryk : integer - Systolisk blodtryk : integer; <<Block>> Pulse oximeter; <<Actor>> <<Secondary>> Database; <<Secondary>> Database; <<Block>> Treatment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
