kj-schmidt/Perconditioning/Udviklingsdokumentation/SystemArkitektur/pdfs/SD_UC2-crop.pdf

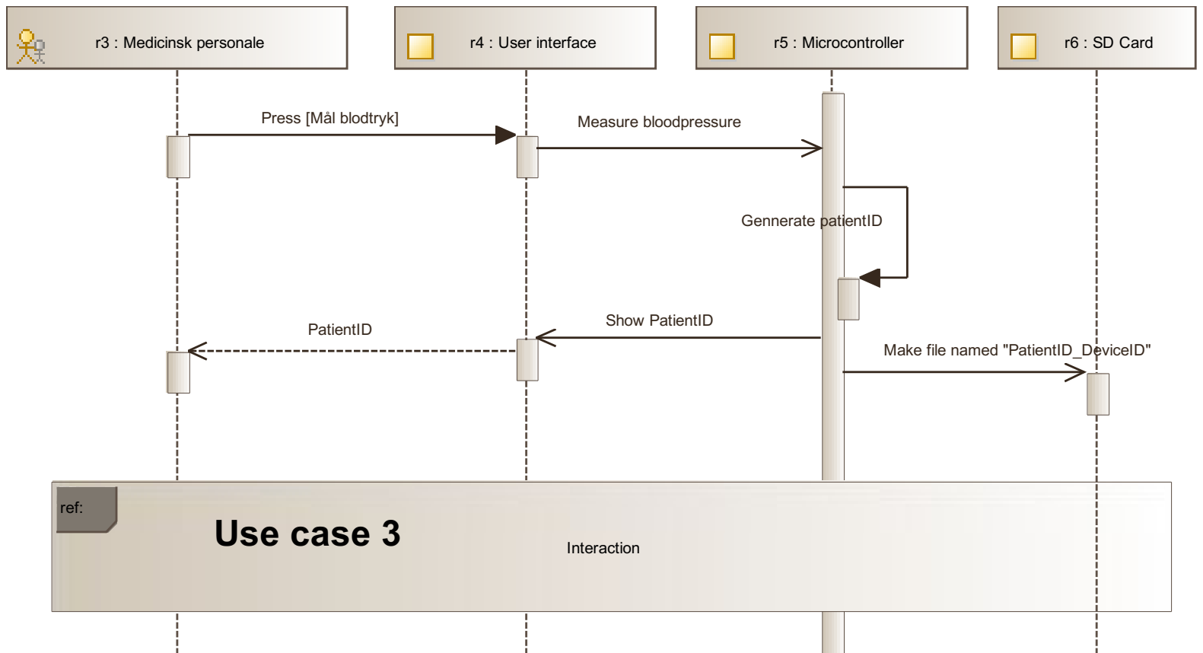
[picture p102: page 1]

r3 : Medicinsk personale | r4 : User interface | r5 : Microcontroller

ref:

Interaction

r6 : SD Card

Press [Mål blodtryk]

PatientID

Measure bloodpressure

Show PatientID

Gennerate patientID

Make file named "PatientID_DeviceID"

# Use case 3
