kj-schmidt/Perconditioning/Udviklingsdokumentation/SystemArkitektur/pdfs/SD(UC2).pdf

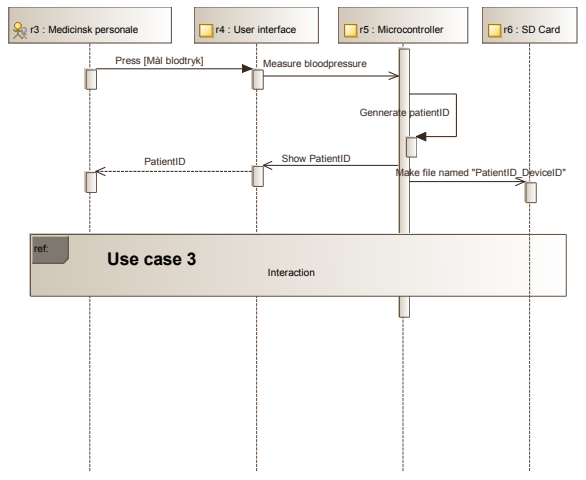
[picture p103: figure]
ref:; Interaction; r6 : SD Card; Press [Mål blodtryk]; PatientID; Measure bloodpressure; Show PatientID; Gennerate patientID; Make file named "PatientID_DeviceID"; Use case 3

r3 : Medicinsk personale | r4 : User interface | r5 : Microcontroller
