kj-schmidt/Perconditioning/Udviklingsdokumentation/SystemArkitektur/pdfs/STD(Konditionering1).pdf

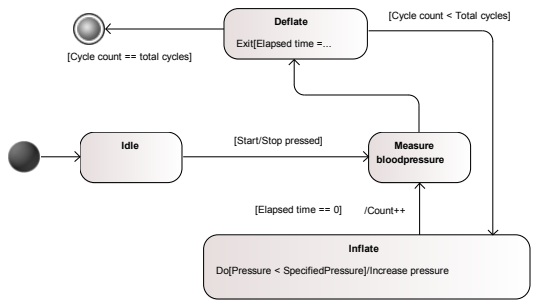
[picture p104: figure]
Deflate; Exit[Elapsed time =...; Measure bloodpressure; Idle; Inflate; Do[Pressure < SpecifiedPressure]/Increase pressure; [Cycle count == total cycles]; [Elapsed time == 0]; /Count++; [Cycle count < Total cycles]; [Start/Stop pressed]
