kj-schmidt/Perconditioning/Udviklingsdokumentation/SystemArkitektur/pdfs/Flowchart_UC1-crop.pdf

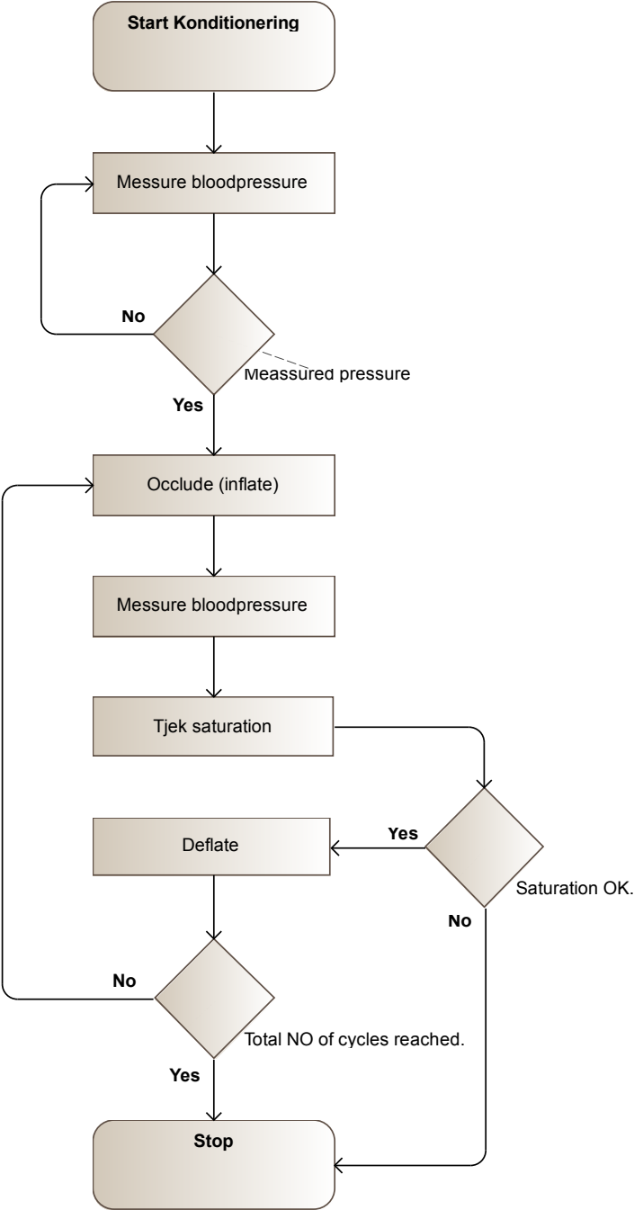
[picture p105: figure]
Start Konditionering; Meassured pressure; Messure bloodpressure; Occlude (inflate); Saturation OK.; Tjek saturation; Deflate; Total NO of cycles reached.; Stop; Yes
