kj-schmidt/Perconditioning/Udviklingsdokumentation/SystemArkitektur/pdfs/STM_Konditionering1-crop.pdf

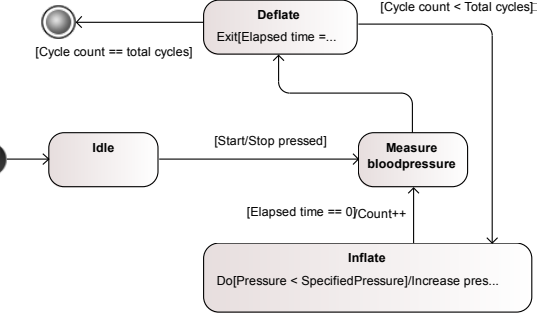
[picture p106: figure]
Deflate; Exit[Elapsed time =...; Measure bloodpressure; Idle; Inflate; Do[Pressure < SpecifiedPressure]/Increase pres...; [Cycle count == total cycles]; [Cycle count < Total cycles; /Count++ [Elapsed time == 0]; [Start/Stop pressed]
