kj-schmidt/Perconditioning/Rapport/Rapport/preamble_KJS_SVG.tex

\documentclass[a4paper,11pt,fleqn,twoside,openright ]{memoir} 	% Openright aabner kapitler paa hoejresider (openany begge)

%%%% PACKAGES %%%%

% ¤¤ Oversaettelse og tegnsaetning ¤¤ %
\usepackage[utf8]{inputenc}					% Input-indkodning af tegnsaet (UTF8)
\usepackage[danish]{babel}					% Dokumentets sprog
\usepackage[T1]{fontenc}					% Output-indkodning af tegnsaet (T1)
\usepackage{ragged2e,anyfontsize}			% Justering af elementer
\usepackage{fixltx2e}						% Retter forskellige fejl i LaTeX-kernen
																			
% ¤¤ Figurer og tabeller (floats) ¤¤ %
\usepackage{graphicx} 						% Haandtering af eksterne billeder (JPG, PNG, PDF)
\usepackage{multirow}                		% Fletning af raekker og kolonner (\multicolumn og \multirow)
\usepackage{colortbl} 						% Farver i tabeller (fx \columncolor, \rowcolor og \cellcolor)
\usepackage[dvipsnames]{xcolor}				% Definer farver med \definecolor. Se mere: http://en.wikibooks.org/wiki/LaTeX/Colors
\usepackage{flafter}						% Soerger for at floats ikke optraeder i teksten foer deres reference
\let\newfloat\relax 						% Justering mellem float-pakken og memoir
\usepackage{float}							% Muliggoer eksakt placering af floats, f.eks. \begin{figure}[H]
%\usepackage{eso-pic}						% Tilfoej billedekommandoer paa hver side
%\usepackage{wrapfig}						% Indsaettelse af figurer omsvoebt af tekst. \begin{wrapfigure}{Placering}{Stoerrelse}
%\usepackage{multicol}         	        	% Muliggoer tekst i spalter
%\usepackage{rotating}						% Rotation af tekst med \begin{sideways}...\end{sideways}

% ¤¤ Matematik mm. ¤¤
\usepackage{amsmath,amssymb,stmaryrd} 		% Avancerede matematik-udvidelser
\usepackage{mathtools}						% Andre matematik- og tegnudvidelser
\usepackage{textcomp}                 		% Symbol-udvidelser (f.eks. promille-tegn med \textperthousand )
\usepackage{siunitx}						% Flot og konsistent praesentation af tal og enheder med \si{enhed} og \SI{tal}{enhed}
\sisetup{output-decimal-marker = {,}}		% Opsaetning af \SI (DE for komma som decimalseparator) 
\usepackage[version=3]{mhchem} 				% Kemi-pakke til flot og let notation af formler, f.eks. \ce{Fe2O3}
%\usepackage{rsphrase}						% Kemi-pakke til RS-saetninger, f.eks. \rsphrase{R1}

% ¤¤ Referencer og kilder ¤¤ %
\usepackage[danish]{varioref}				% Muliggoer bl.a. krydshenvisninger med sidetal (\vref)
\usepackage{natbib}							% Udvidelse med naturvidenskabelige citationsmodeller
%\usepackage{xr}							% Referencer til eksternt dokument med \externaldocument{<NAVN>}
%\usepackage{glossaries}					% Terminologi- eller symbolliste (se mere i Daleifs Latex-bog)

% ¤¤ Misc. ¤¤ %
\usepackage{listings}						% Placer kildekode i dokumentet med \begin{lstlisting}...\end{lstlisting}
\usepackage{lipsum}							% Dummy text \lipsum[..]
\usepackage[shortlabels]{enumitem}			% Muliggoer enkelt konfiguration af lister
\usepackage{pdfpages}						% Goer det muligt at inkludere pdf-dokumenter med kommandoen \includepdf[pages={x-y}]{fil.pdf}	
\pdfoptionpdfminorversion=6					% Muliggoer inkludering af pdf dokumenter, af version 1.6 og hoejere
\pretolerance=2500 							% Justering af afstand mellem ord (hoejt tal, mindre orddeling og mere luft mellem ord)

\usepackage{calc}
\usepackage{longtable} %tables that expands over more pages
\usepackage{lastpage} %Enables getting current numbers of pages 
\usepackage{pdflscape} %Enables pages in landscape mode

% Kommentarer og rettelser med \fxnote. Med 'final' i stedet for 'draft' udloeser hver note en error i den faerdige rapport.
\usepackage[footnote,final,danish,silent,nomargin]{fixme}		

%%%% CUSTOM SETTINGS %%%%

% ¤¤ Marginer ¤¤ %
\setlrmarginsandblock{3.5cm}{2.5cm}{*}		% \setlrmarginsandblock{Indbinding}{Kant}{Ratio}
\setulmarginsandblock{2.5cm}{3.0cm}{*}		% \setulmarginsandblock{Top}{Bund}{Ratio}
\checkandfixthelayout 						% Oversaetter vaerdier til brug for andre pakker

%	¤¤ Afsnitsformatering ¤¤ %
\setlength{\parindent}{0mm}           		% Stoerrelse af indryk
\setlength{\parskip}{3mm}          			% Afstand mellem afsnit ved brug af double Enter
\linespread{1,1}							% Linie afstand

% ¤¤ Litteraturlisten ¤¤ %
\bibpunct[,]{[}{]}{;}{a}{,}{,} 				% Definerer de 6 parametre ved Harvard henvisning (bl.a. parantestype og seperatortegn)
\bibliographystyle{bibtex/harvard}			% Udseende af litteraturlisten.

% ¤¤ Indholdsfortegnelse ¤¤ %
\setsecnumdepth{subsubsection}		 			% Dybden af nummerede overkrifter (part/chapter/section/subsection)
\maxsecnumdepth{subsubsection}					% Dokumentklassens graense for nummereringsdybde
\settocdepth{section} 					% Dybden af indholdsfortegnelsen

% ¤¤ Lister ¤¤ %
\setlist{
  topsep=0pt,								% Vertikal afstand mellem tekst og listen
  itemsep=-1ex,								% Vertikal afstand mellem items
} 

% ¤¤ Visuelle referencer ¤¤ %
\usepackage[colorlinks]{hyperref}			% Danner klikbare referencer (hyperlinks) i dokumentet.
\hypersetup{colorlinks = true,				% Opsaetning af farvede hyperlinks (interne links, citeringer og URL)
    linkcolor = black,
    citecolor = black,
    urlcolor = black
}

% ¤¤ Opsaetning af figur- og tabeltekst ¤¤ %
\captionnamefont{\small\bfseries\itshape}	% Opsaetning af tekstdelen ('Figur' eller 'Tabel')
\captiontitlefont{\small}					% Opsaetning af nummerering
\captiondelim{. }							% Seperator mellem nummerering og figurtekst
\hangcaption								% Venstrejusterer flere-liniers figurtekst under hinanden
\captionwidth{\linewidth}					% Bredden af figurteksten
\setlength{\belowcaptionskip}{0pt}			% Afstand under figurteksten
		
% ¤¤ Opsaetning af listings ¤¤ %
\definecolor{commentGreen}{RGB}{34,139,24}
\definecolor{stringPurple}{RGB}{208,76,239}

\lstset{language=Matlab,					% Sprog
	basicstyle=\ttfamily\scriptsize,		% Opsaetning af teksten
	keywords={for,if,while,else,elseif,		% Noegleord at fremhaeve
			  end,break,return,case,
			  switch,function},
	keywordstyle=\color{blue},				% Opsaetning af noegleord
	commentstyle=\color{commentGreen},		% Opsaetning af kommentarer
	stringstyle=\color{stringPurple},		% Opsaetning af strenge
	showstringspaces=false,					% Mellemrum i strenge enten vist eller blanke
	numbers=left, numberstyle=\tiny,		% Linjenumre
	extendedchars=true, 					% Tillader specielle karakterer
	columns=flexible,						% Kolonnejustering
	breaklines, breakatwhitespace=true,		% Bryd lange linjer
}

% ¤¤ Navngivning ¤¤ %
\addto\captionsdanish{
	\renewcommand\appendixname{Appendiks}
	\renewcommand\contentsname{Indholdsfortegnelse}	
	\renewcommand\appendixpagename{Appendiks}
	\renewcommand\appendixtocname{Appendiks}
	\renewcommand\cftchaptername{\chaptername~}				% Skriver "Kapitel" foran kapitlerne i indholdsfortegnelsen
	\renewcommand\cftappendixname{\appendixname~}			% Skriver "Appendiks" foran appendiks i indholdsfortegnelsen
}

% ¤¤ Kapiteludssende ¤¤ %

\newif\ifNoChapNumber
\makeatletter
\makechapterstyle{VZ34}{
	\renewcommand\chapternamenum{}
	\renewcommand\printchaptername{}
	\renewcommand\printchapternum{}
	\renewcommand\chapnumfont{\Huge\bfseries}
	\renewcommand\chaptitlefont{\Huge\bfseries\raggedright}
	\renewcommand\printchaptertitle[1]{%
		\begin{tabular}{@{}p{1cm}|!{\quad}p{\textwidth-1cm-2em-4\tabcolsep }}
			\ifNoChapNumber\relax\else\chapnumfont \thechapter\fi
			& \chaptitlefont ##1
		\end{tabular}
		\NoChapNumberfalse
	}
	\renewcommand\printchapternonum{\NoChapNumbertrue}
}
\chapterstyle{VZ34}

% ¤¤ Sidehoved ¤¤ %

\makepagestyle{Uni}							% Definerer sidehoved og sidefod udseende frem til ...
\makepsmarks{Uni}{%
	\createmark{chapter}{left}{shownumber}{}{. \ }
	\createmark{section}{right}{shownumber}{}{. \ }
	\createplainmark{toc}{both}{\contentsname}
	\createplainmark{lof}{both}{\listfigurename}
	\createplainmark{lot}{both}{\listtablename}
	\createplainmark{bib}{both}{\bibname}
	\createplainmark{index}{both}{\indexname}
	\createplainmark{glossary}{both}{\glossaryname}
}
\nouppercaseheads											% Ingen Caps oenskes

\makeevenhead{Uni}{Gruppe 15155}{}{\leftmark}				% Definerer lige siders sidehoved (\makeevenhead{Navn}{Venstre}{Center}{Hoejre})
\makeoddhead{Uni}{\rightmark}{}{Aarhus Universitet}			% Definerer ulige siders sidehoved (\makeoddhead{Navn}{Venstre}{Center}{Hoejre})
\makeevenfoot{Uni}{\thepage}{}{}							% Definerer lige siders sidefod (\makeevenfoot{Navn}{Venstre}{Center}{Hoejre})
\makeoddfoot{Uni}{}{}{\thepage}								% Definerer ulige siders sidefod (\makeoddfoot{Navn}{Venstre}{Center}{Hoejre})
\makeheadrule{Uni}{\textwidth}{0.5pt}						% Tilfoejer en streg under sidehovedets indhold
\makefootrule{Uni}{\textwidth}{0.5pt}{1mm}					% Tilfoejer en streg under sidefodens indhold

\copypagestyle{Unichap}{Uni}								% Sidehoved for kapitelsider defineres som standardsider, men med blank sidehoved
\makeoddhead{Unichap}{}{}{}
\makeevenhead{Unichap}{}{}{}
\makeheadrule{Unichap}{\textwidth}{0pt}
\aliaspagestyle{chapter}{Unichap}							% Den ny style vaelges til at gaelde for chapters
															% ... her
															
\pagestyle{Uni}												% Valg af sidehoved og sidefod (benyt "plain" for ingen sidehoved/fod)

%%%% CUSTOM COMMANDS %%%%

% ¤¤ Billede hack ¤¤ %										% Indsaet figurer nemt med \figur{Stoerrelse}{Fil}{Figurtekst}{Label}
\newcommand{\figur}[4]{
		\begin{figure}[H] \centering
			
			\caption{#3}\label{#4}
		\end{figure} 
}

%\usepackage{caption} %Tillader instillinger lokalt af figurtekst
%\captionsetup[figure]{labelfont={bf,small},textfont={it,small}}

\newsubfloat{figure}

% ¤¤ Specielle tegn ¤¤ %
\newcommand{\decC}{^{\circ}\text{C}}
\newcommand{\dec}{^{\circ}}
\newcommand{\m}{\cdot}

%%%% ORDDELING %%%%

\hyphenation{}
