kj-schmidt/Perconditioning/Rapport/Rapport/kontekst/Diskussion.tex

\chapter{Diskussion}

\section{Oscillometrisk fikseret-ratio}
Den oscillometriske fikseret-ratio metode er brugt i vid udstrækning til non-invasive målinger af det systoliske og diastoliske blodtryk. Det er derfor ikke unormalt, at apparatet beskrevet i denne rapport under afsnit \ref{Fikseret-ratio}, anvender fikseret-ratio fastsat ud fra empirisk data. Flere studier har også vist, at denne metode har en høj nøjagtighed, (\cite{drzewiecki1994theory}). Problemet med denne rigide fortolkning, er at det systoliske og diastoliske blodtryk altid befinder sig samme procentsats fra middelarterietrykket, og der opstår fejl ved individernes forskellighed.

 \cite{RefWorks:13} opstiller en matematisk model for den oscillometriske fikseret-ratio metode medregnet arterie eftergivenheden og undersøger ud fra dette hvilke faktorer, som påvirker den fikserede-ratio, og hvor stor en afvigelse, fra den sande værdi, dette giver. Resultaterne af denne gennemgang er teoretiske afvigelser på op til 58 mmHg ved svær arteriestivhed. Eftersom at stive arterier ofte er til stede ved arteriosklerose, er apopleksipatienter (også beskrevet i afsnit \ref{chap:Baggrund}) særligt udsatte for fejlmålinger med fikseret-ratio metoden. Den korte forklaring på dette problem er ændringer af manchetoscillationernes kurve bredde. Kurven som dannes af peak amplituderne af oscillationerne (se figur \ref{fig:OscillometriskMetode}), ændrer karakter ved ændring af arterie stivheden. 
 
 På figur \ref{fig:ErrorMechanismOfFixedRatio} er fejlmekanismen ved fikseret-ratio bestemt systolisk tryk (SP) og diastolisk tryk (DP) illustreret. Peak amplituderne er normaliseret, hvilket tydeliggør ændringerne i kurvebredden, når arterieeftergivenheden ændres. 
 
 Ved normale arterievægge passer de empiriske ratio-værdier godt, men eftersom arteriet afviger fra det normale, stiger fejl estimationen af SP og DP i takt med ændringer i eftergivenheden. Hvis karrene er stivere end normalt, resulterer det i en overestimation af det systoliske tryk og en underestimation af det diastoliske tryk. Overestimationen finder sted, fordi den konstante ratio for det systoliske tryk (SP/MAP) nu indtræffer tidligere på den normaliserede trykkurve, og her er manchettrykket højere, og derfor overestimeres SP. På samme måde, som det systoliske tryk overestimeres, underestimeres det diastoliske tryk, fordi den konstante ratio for det diastoliske tryk (SP/MAP) nu befinder sig på et senere på trykkurven, hvor manchettrykket er lavere. Det samme scenarie gør sig gældende bare modsat for en blodtryksmåling på arterier med en højere eftergivenhed end normalt. Ændringer i arterievæggens eftergivenhed påvirker ikke estimationen af MAP, som altid befinder sig med de største oscillationer i manchetten.

Anvendelse af oscillometrisk fikseret-ratio metoden, til at måle blodtryk på patienter med apopleksi kan være problematisk på grund af arteriestivheden, som giver anledning til fejlestimationer på op til 58 mmHg. Det bør derfor overvejes, om andre metoder til at estimere det sys- og diastoliske tryk skal anvendes i stedet, for at sikre en højere nøjagtighed af blodtryksmålingerne.

Overestimationen af det systoliske blodtryk optræder ikke som fejlkilde ved konditioneringen, da her blot ønskes en total okklusion af arterierne. Overestimationen giver ikke anledning til et for lavt afklemningstryk, som tillader blod til den afklemte ekstremitet. Fejlkonditionering på grund af blodtryksmålingen opstår kun ved underestimering af SYS.

	\begin{figure}[H]
		\centering
		
		\caption{Fejlmekanismen i fixed-ratio metoden ved ændringer af arterie stivheden. Pc er manchet tryk. DP er det diastoliske tryk og SP er det systoliske tryk, kilde: \cite{RefWorks:13}}\label{fig:ErrorMechanismOfFixedRatio}
	\end{figure}

\section{Okklusionstræning og trykregulering}
Sådan som okklusionstræning er implementeret i \textit{Konditioneringsapparatet} findes, der ingen nedregulering af trykket, hvis en pudselig trykstigning opstår, og derfor varierer trykket i manchetten meget under træning. Ved okklusionstræning af fx biceps brachii, vil en normal blodtryksmanchet pga. dens størrelse sidde meget i vejen under okklusionstræning. Desuden vil manchetten sidde ovenpå en stor del af bicepsmusklen, og dette vil betyde store variationer i trykket mellem den koncentriske og excentriske fase. Denne effekt kan reduceres ved at udskifte den brede manchet til en smallere manchet, som i stedet kun blev placeret proximalt for biceps brachii (Se figur \ref{fig:okklcuff}). En anden måde at imødekomme trykvariationer på, kunne være ved at montere en \textquotedbl reserve-tank\textquotedbl{} under okklusionstræningen. Dette vil betyde en større volume i det pneumatiske system, og mindske trykændringer ved kontraktion af musklen. 
\begin{figure}[H]
	\centering
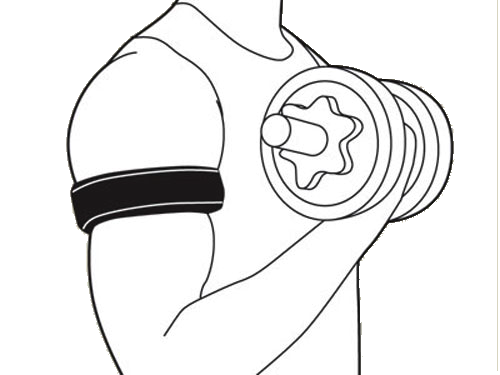
[picture p107: Rapport/Rapport/billeder/okklusionCuff.png]
	
	\caption{Placering af smal manchet på overarm ved træning af biceps brachii. Kilde: \cite{Billede:3}}\label{fig:okklcuff}
\end{figure}

\section{Pulsoximetri}
Under resultatafsnittet \ref{title:pulsOxi} er der beskrevet en test, som bruger pulsoximeter for at kontrollere kredsløbets status på armen under RIC behandling. Der blev kun foretaget én test af denne type, og den blev foretaget på en person, som er sund og rask. Derfor er testen ikke et gyldigt grundlag for at ekskludere pulsoximetri som sikkerhedskontrol. Men teorien bag pulsoximeteri, som beskrives i projektafgrænsningsafsnittet (\ref{title:sikkerhedskontrol}), sætter tydelige begrænsninger for brugen af pulsoximetri som sikkerhedskontrol, og testen underbygger kun denne påstand. 

\section{Medicinsk godkendelse}
Det er relevant at diskutere medicinsk godkendelse, fordi dette skal overvejes inden \textit{konditioneringsapparatet} anvendes på patienter. 
Til opsummering af resultatafsnittet \cite{title:medGodkendelse} må konkluderes, at det nøje bør overvejes om \textit{konditioneringsapparatet} skal CE godkendes med det samme, for at kunne bruges til ydeligere studier og forsøg, eller om apparatet blot skal godkendes til det ene studie beskrevet i studieprotokolen (se \ref{title:studieprotokold}).

\subsection{Økonomiske konflikter}
Kunden Rolf, skal kun bruge apparatet til forskning, og får af denne grund ikke nødvendigvis en økonomisk gevinst, ved et CE mærket apparat. Tværtimod, så er det meget ressourcekrævende at CE godkende medicinsk udstyr og derfor bliver det en økonomisk byrde. Seagull, distributør af blodtryksapparater, er interesseret i så stor en efterspørgsel som muligt og kan af denne grund få en økonomisk gevinst ved et CE godkendt \textit{konditioneringsapparatet}. 

\section{Projektplanlægning og gennemførsel}
Dette afsnit omhandler, hvad der gik godt og mindre godt i projektet og tanker om dette.

Projektgruppens medlemmer Karl-Johan og Simon har begge baggrund som sundhedsteknologistuderende, hvilket resulterede i nogle manglende erfaringer i forbindelse med embedded systemer. Særligt under udvikling af \textit{Konditioneringsapparatets} software, som er skrevet i C++, oplevede projektgruppen problemer, fordi begge medlemmer først skulle lære sproget. Det ville have været oplagt, at en af gruppens medlemmer havde fulgt et fag på Ingeniørhøjskolen Aarhus Universitet, for at sikre en god udvikling af softwaren. På trods af den manglende C++ erfaring i projektgruppen lykkedes det at opnå et godt resultat af softwaren. Softwaren kan læses i den vedlagte .ZIP fil.

Projektgruppens forholdsvise lille størrelse har også betydet, at ikke alle former for projektstyringsværktøjer kan betale sig tidsmæssigt. I metodeafsnittet (se afsnit \ref{title:scrum}) er det beskrevet, hvordan gruppen halvvejs inde i projektet fravalgte anvendelsen af Pivotaltracker. På samme måde kan det også diskuteres, om alt den skrevne udviklingsdokumentation er for meget. Projektgruppen har brugt rigtig meget tid på at dokumentere udviklingen og planlægningen af projektet, selv om gruppens størrelse kun er på to mand. Det har under hele projektet været muligt at få en mundtlig dokumentation på grund af, at begge medlemmer havde samme kontorplads og arbejdstider.
Udviklingsdokumentationen har dog aldrig været set som overflødig, bl.a. på grund af kundens interesse i et masseproduceret konditioneringsapparatet. Den store mængde udviklingsdokumentation sikrer muligheden for fremtidig udvikling af \textit{konditioneringsapparatet}. 

Unit test og integrations test (Se V-model figur \ref{fig:vmodel}) blev i projektet gennemført som en yderst iterativ proces. De enkelte elementer beskrevet i system design dokumentet, (Se system design i udviklingsdokumentation) er udviklet en af gangen og testet, om det ønskede element virkede efter hensigten. Hvis det testede element ikke virkede efter hensigten, er det detaljerede design (se implementeringsdokument i udviklingsdokumentation) af elementet blevet rettet og en ny implementering efterfulgt af unit test blevet gennemført. Et eksempel, på denne iterative proces, er det analoge filter, som er blevet tilrettet gennem flere iterationer med implementering, for at opnå den ønskede effekt. Der er altså ikke kun blevet udført én unit test, per element i \textit{konditioneringsapparatet}, men flere og derfor er alle tests ikke blevet dokumenteret. De vigtigste og endelige Unit tests er dog dokumenteret i Implementeringsdokumentet. Integrationstest, som er sammensætningen af to eller flere elementer, er på samme måde som unittest sket over flere forsøg, og igen er kun de vigtigste praktiske erfaringer beskrevet i implementeringsdokumentet.

Under system design fasen blev der anvendt \textit{Modelio} (se afsnit \ref{title:udviklingsvaerktoejer}) til SysML diagrammer. Der var både fordele og ulemper forbundet med dette valg. \textit{Modelio} er ikke et tegneprogram, men et open source modelleringsmiljø, hvilket resulterer i en meget stejl indlæringskurve. Projektgruppen har brugt store mængder af tid på at forstå \textit{Modelio}, hvilket kunne have været sparet ved at anvende et allerede kendt program, så som \textit{Visio}. Værktøjet, \textit{Modelio} giver til gengæld muligheden for kompilering af alle tegnede diagrammer, hvilket mindsker mængden af fejl. Programmet sikrer desuden, at de udarbejdede diagrammer overholder SysML standarderne. Programmet er samtidig open source, som tillader projektgruppen at anvende \textit{Modelio} i fremtiden uden betaling til licenser.

Beslutningen om anvendelse af Git til versionsstyring har været rigtig god. Efter at projektgruppen havde lært at anvende Git, er store mængde af tid sparet på versionsstyring af projektdokumenter og software.
