kj-schmidt/Perconditioning/Udviklingsdokumentation/formalia/forside2.tex

\thispagestyle{empty} % Remove page numbering on this page

\colorbox{usDef}{
	\parbox[t]{1.0\linewidth}{
		\centering \fontsize{30pt}{50pt}\selectfont % The first argument for fontsize is the font size of the text and the second is the line spacing - you may need to play with these for your particular title
		\vspace*{0.7cm} % Space between the start of the title and the top of the grey box
		
		\hfill Remote Ischemic Conditioning\\
		\hfill Udviklingsdokumentation \\
		
		\vspace*{0.7cm} % Space between the end of the title and the bottom of the grey box
	}
}

\vfill % Space between the title box and author information

\begin{figure}[H]
	
\end{figure}

{\centering \large 
	\hfill Simon Vammen Grønbæk \\
	\hfill Karl-Johan Schmidt\\
	\hfill Aarhus University \\
	\hfill Aarhus School of Engineering\\
	\hfill Efteråret 2015 \\
}

\clearpage % Whitespace to the end of the page
