kj-schmidt/Perconditioning/Udviklingsdokumentation/Kravspecifikation/Kravspecifikation.tex

\raggedbottom

	%forside
	%\input{Kravspecifikation/filer/forside.tex}
	
	%titelplad
	%\input{Kravspecifikation/filer/titelblad.tex}
	\newpage
	\printcontents[ks]{ }{0}{\chapter*{Indholdsfortegnelse}}
	\newpage
	
	%Indledning
	\input{Kravspecifikation/filer/indledning}
	
	%Systembeskrivesle
	\input{Kravspecifikation/filer/systembeskrivelse}

	%Functional requirements
	\input{Kravspecifikation/filer/funkSpec.tex}

	%Non functional requirements
	\input{Kravspecifikation/filer/ikkeFunkSpec.tex}
	
	%User interface 
	\input{Kravspecifikation/filer/userInterface.tex}
