kj-schmidt/Perconditioning/Udviklingsdokumentation/Kravspecifikation/filer/actorDescription.tex

	\newpage
	\section{Aktør beskrivelse}
	Systemet har fire aktør og disse er beskrevet nedenfor (Se tabel \ref{tab:medi}, \ref{tab:patient}, \ref{tab:data} og \ref{tab:bruger}). Aktørerne skal ses som brugere eller spillere, der skal interagere med scenarierne for at de lykkes. 
	
	\begin{table}[H]
		\centering
		\begin{tabular}{ | p{0.34\textwidth} | p{0.6\textwidth}| } 
			\hline
			Aktørnavn& Medicinsk personale  \\ 
			\hline
			Aktørtype & Primær og sekundær \\ 
			\hline
			Beskrivelse af aktør & Aktør som påmontere manchetten og styre konditionering eller person som observere de gemte data fra behandlingsforløb\\ 
			\hline
		\end{tabular}
		\caption{Aktør beskrivelse af medicinsk personale} \label{tab:medi}
	\end{table}
	
	\begin{table}[H]
		\centering
		\begin{tabular}{ | p{0.34\textwidth} | p{0.6\textwidth}| } 
			\hline
			Aktørnavn& Patient \\ 
			\hline
			Aktørtype & Sekundær \\ 
			\hline
			Beskrivelse af aktør & En person med AIS som skal konditioneres\\ 
			\hline
		\end{tabular}
		\caption{Aktør beskrivelse af patient} \label{tab:patient}
	\end{table}
	
	\begin{table}[H]
		\centering
		\begin{tabular}{ | p{0.34\textwidth} | p{0.6\textwidth}| } 
			\hline
			Aktørnavn& Database \\ 
			\hline
			Aktørtype & Sekundær \\ 
			\hline
			Beskrivelse af aktør & Gemmer data og logfiler omkring konditionerings forløb\\ 
			\hline
		\end{tabular}
		\caption{Aktør beskrivelse af database} \label{tab:data}
	\end{table}
	
	\begin{table}[H]
		\centering
		\begin{tabular}{ | p{0.34\textwidth} | p{0.6\textwidth}| } 
			\hline
			Aktørnavn& Bruger \\ 
			\hline
			Aktørtype & Primær \\ 
			\hline
			Beskrivelse af aktør & Person der gør brug af konditioneringsapparatet til okklusionstræning, denne person behøver ikke besidde særlig faglig viden \\ 
			\hline
		\end{tabular}
		\caption{Aktør beskrivelse af bruger} \label{tab:bruger}
	\end{table}
