kj-schmidt/Perconditioning/Udviklingsdokumentation/Kravspecifikation/filer/userInterface.tex

\chapter{User interface}
User interface består overordnede af en skærm og 2 knapper. En knap til at start og stoppe funktioner og en knap til at måle blodtryk. Til brugerfeedback er der en display hvorpå trykket, patient ID, resterende tid og antallet af gennemførte cyklusser vises. Apparatet betjenes i tre forskellige stadier “Konditionering, Okklusion og setup”. Disse tre stadier er beskrevet med hver siden illustration nedenfor. For at skifte mellem disse stadier er der en mode switch på bagsiden af apparatet, den er også beskrevet nedenfor: 

\section{Konditionering}
\begin{figure}[H]
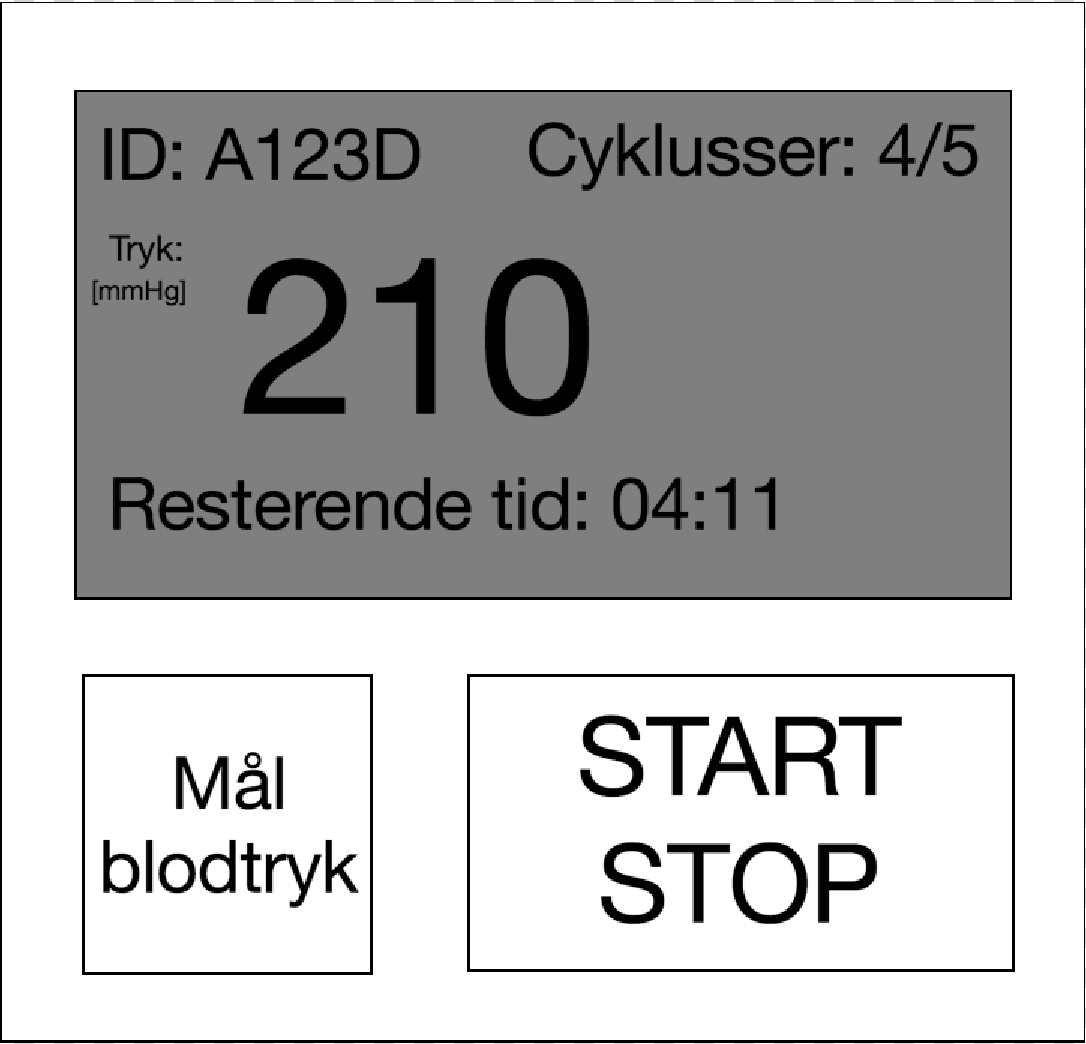
[picture p119: Udviklingsdokumentation/Kravspecifikation/Illustrationer/KonditioneringGUI.png]
	
	\caption{Illustration over brugergrænseflade ved konditionering}
\end{figure}

\section{Okklusion}
\begin{figure}[H]
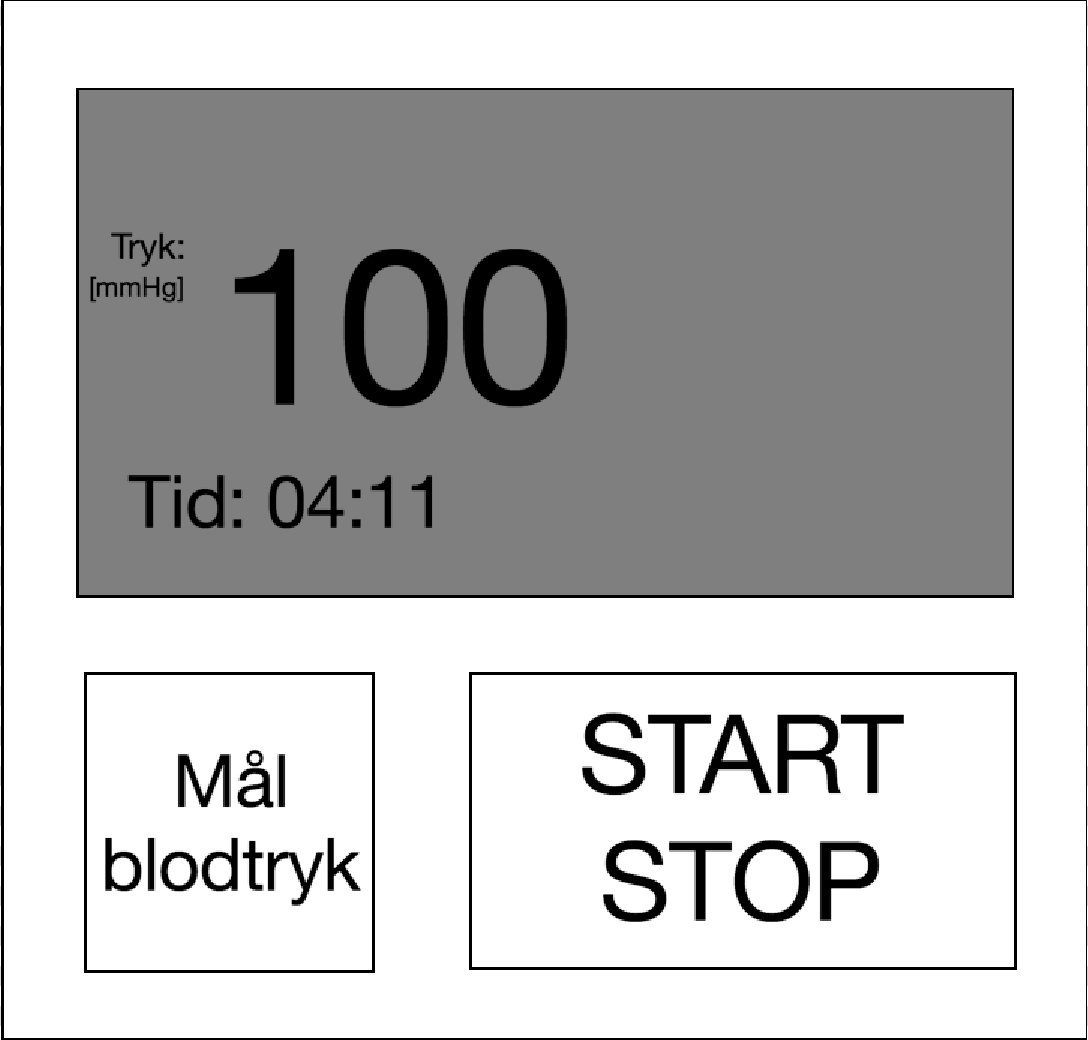
[picture p120: Udviklingsdokumentation/Kravspecifikation/Illustrationer/OkklusionGUI.png]
		
	\caption{Illustration over brugergrænseflade ved okklusion}
\end{figure}

\section{Setup}
\begin{figure}[H]
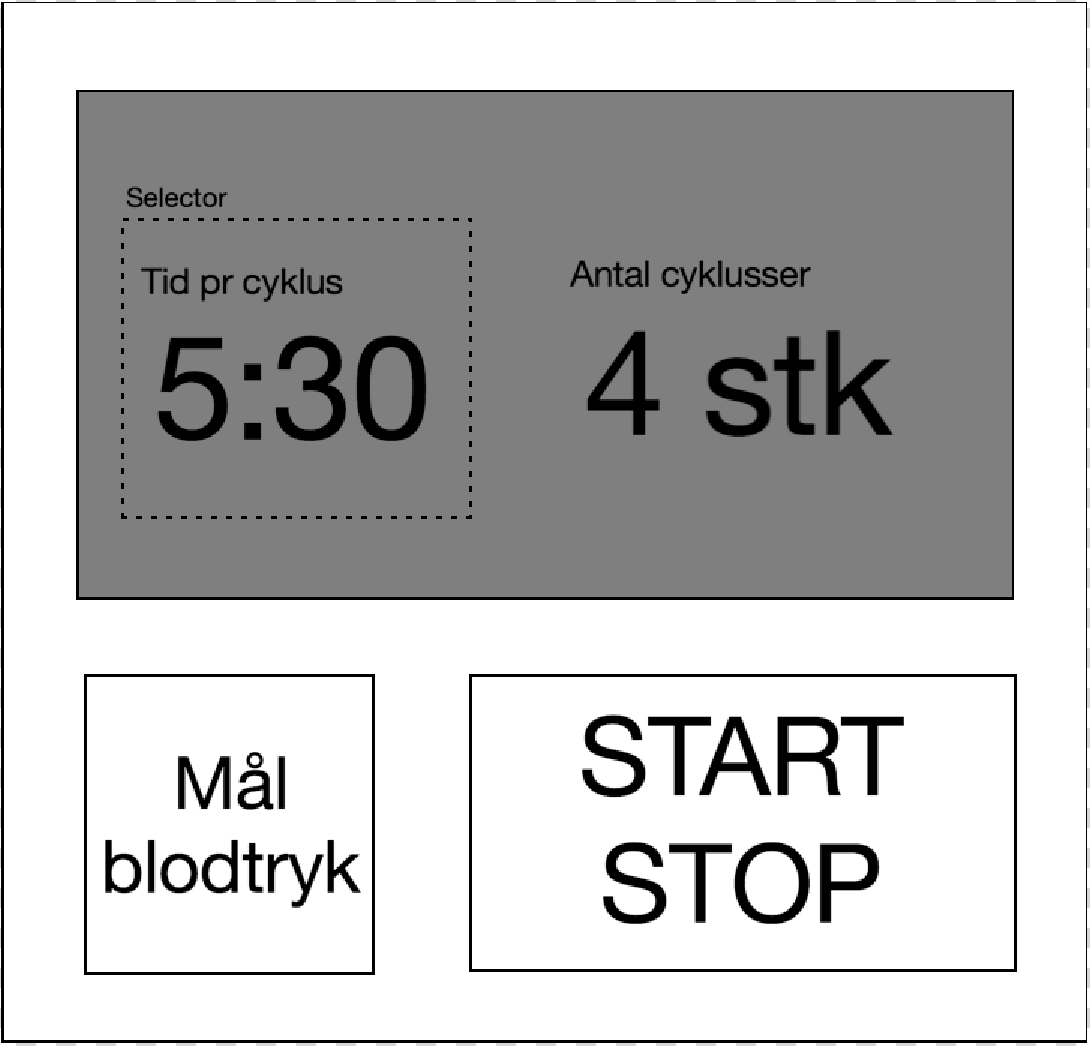
[picture p121: Udviklingsdokumentation/Kravspecifikation/Illustrationer/SetupGUI.png]
	
	\caption{Illustration over brugergrænseflade ved setup}
\end{figure}

\section{Bagside}
\begin{figure}[H]
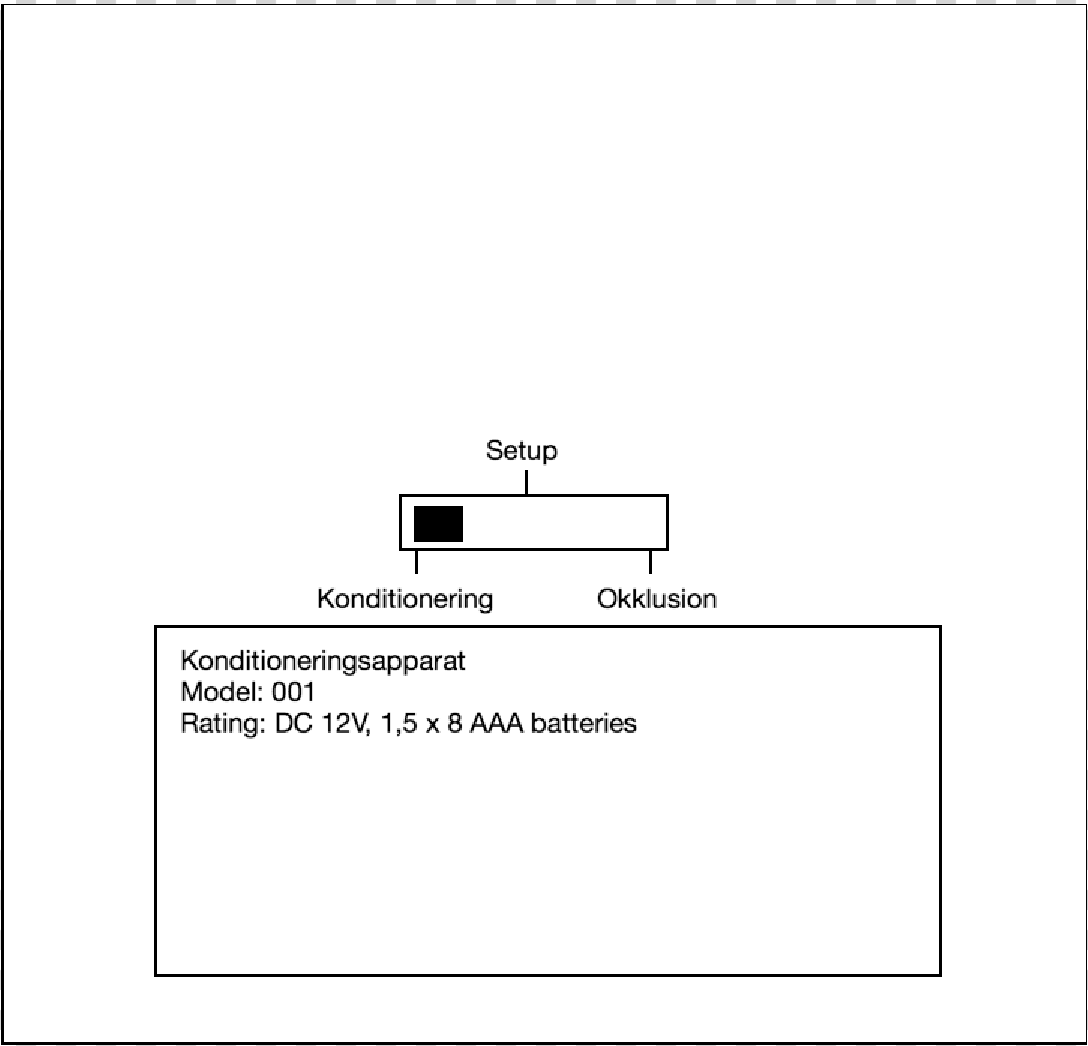
[picture p122: Udviklingsdokumentation/Kravspecifikation/Illustrationer/BagsideGUI.png]
		
	\caption{Illustration over brugergrænseflade på bagsiden af \textit{Konditioneringsapparatet} }
\end{figure}

\label{lastPage}
