kj-schmidt/Perconditioning/Udviklingsdokumentation/Accepttest/filer/at_uc8.tex

\newpage
	\section{Use case 8 - Setup}
						\begin{longtable}{|p{0.09\textwidth}|p{0.23\textwidth}|p{0.23\textwidth}|p{0.23\textwidth}|p{0.07\textwidth}|}
							\hline
							\rowcolor{usDef}
							Krav nr.: & Handling & Forventet resultat & Testmetode & Resul-tat  \\\hline
							2.8.1 & Brugeren trykker på knappen [Mål blodtryk] for at vælge Tid pr cyklus & Ved knaptryk på [Mål blodtryk] vælges “Tid pr cyklus” og det valgte område begynder at blinke & Tryk på knappen [Mål blodtryk] og observér displayet & \\ \hline
							2.8.2 & Bruger trykker på knappen [Start/Stop] for at ændre Tid pr cyklus & Værdien i det valgte område ændres med 30s per tryk. & Tryk på knappen [Start/Stop] og observér ændringen  & \\ \hline
							2.8.3 & Bruger trykker på knappen [Mål blodtryk] for at gemme ændringen & Værdien gemmes og det valgte område stopper med at blinke & Tryk på knappen [Mål blodtryk] og observér displayet. Start use case 1 og kontroller okklutionstid & \\ \hline
							2.8.4 & Bruger trykker på knappen [Start/Stop] for at navigere til Antal cyklusser & Ved knaptryk på [Start/Stop] flyttes den firkantede markør på displayet til “Antal cyklusser” & Tryk på knappen [Start/Stop] og observér ændringen  & \\ \hline
							2.8.5 & Ved knap tryk på [Mål blodtryk] vælges Antal cyklusser & Ved knaptryk på [Mål blodtryk] vælges “Antal cyklusser” og det valgte område begynder at blinke & Tryk på knappen [Mål blodtryk] og observér displayet & \\ \hline
							2.8.6 & Ved knap tryk på [Start/Stop] ændre Antal af cyklusser & Værdien i det valgte område ændres med 1 per tryk. & Tryk på knappen [Start/Stop] og observér ændringen & \\ \hline
							2.8.7 & \textit{Bruger} trykker på knappen [Mål blodtryk] for at gemme ændringen & Værdien gemmes og det valgte område stopper med at blinke & Tryk på knappen [Mål blodtryk] og observér ændringen.
							start use case 1 og tjek total antal cyklusser & \\ \hline
							\caption{Accepttest forløb for use case 8}
						\end{longtable}
