kj-schmidt/Perconditioning/Rapport/Rapport/Rapport.pdf

# Remote Ischemic Conditioning

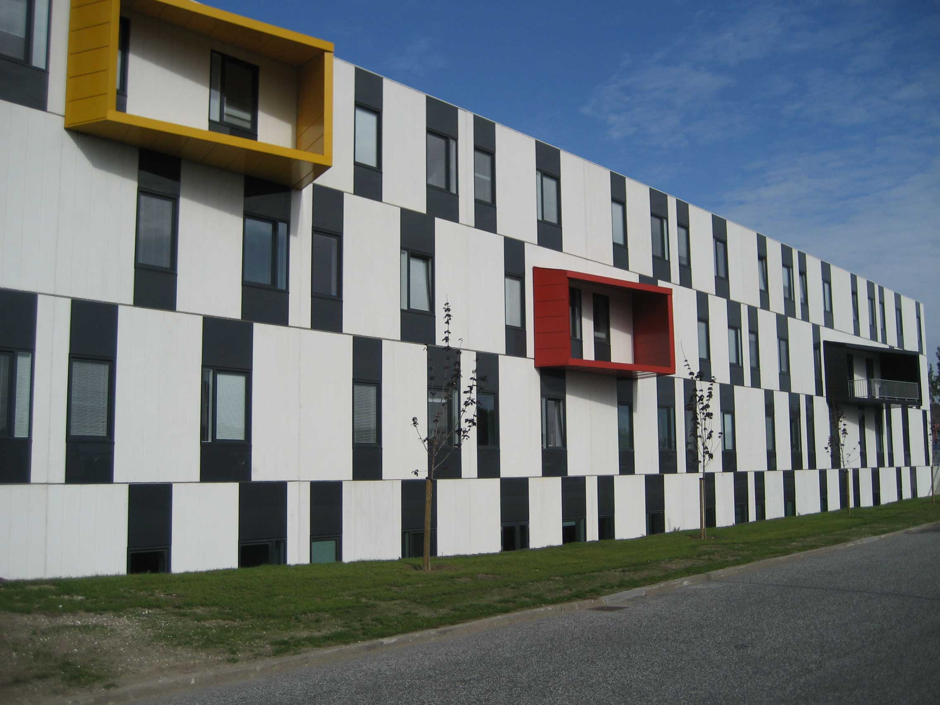
[picture p123: figure]

Bachelor projekt

Gruppe 15155

Sundhedsteknologi

Aarhus Universitet

Efteråret 2015

# AARHUS AU UNIVERSITET

Ingeniørhøjskolen Aarhus
Finlandsgade 22
8200 Aarhus N
Tlf: 8715 0000
http://www.ase.au.dk/

Titel:

Remote Ischemic Conditioning

Projekt:

Bachelor projekt

Projektperiode:

Juli 2015 - December 2015

Projektgruppe:

15155

Deltagere:

Simon Vammen Grønbæk
Karl-Johan Schmidt

Vejledere:

Peter Johansen

Projektudbyder:

Rolf Blauenfeldt

Oplagstal: 10
Sidetal: 45
Afsluttet 18-12-2014

Godkendelse:

Karl-Johan Schmidt

Simon Vammen Grønbæk

Peter Johansen

Rolf Blauenfeldt

Rapportens indhold er frit tilgængeligt, men offentliggørelse (med kildeangivelse) må kun ske efter aftale

med forfatterne.

# Abstract

Background

Methods

Results

Discussion

Conclusion

v

# Resume

Baggrund

Metoder

Resultater

Diskussion

Konklusion

vii

# Forord

Indsæt forord

Læsevejledning

Der vil igennem rapporten fremtræde kildehenvisninger, og disse vil være samlet i en kildeliste bagerst i rapporten. Der er i rapporten anvendt kildehenvisning efter Harvardmetoden, så i teksten refereres en kilde med [Efternavn, År]. Denne henvisning fører til kildelisten, hvor bøger er angivet med forfatter, titel, udgave og forlag, mens Internetsider er angivet med forfatter, titel og dato. Figurer og tabeller er nummereret i henhold til kapitel, dvs. den første figur i kapitel 7 har nummer 7.1, den anden, nummer 7.2 osv. Forklarende tekst til figurer og tabeller findes under de givne figurer og tabeller.

ix

# Indholdsfortegnelse

Kapitel 1 Definitioner og forkortelser | 1
Kapitel 2 Indledning | 3
Kapitel 3 Baggrund | 5
Kapitel 4 Problemformulering | 11
Kapitel 5 Projektafgrænsninger | 13
Kapitel 6 Systembeskrivelse | 17
Kapitel 7 Metoder | 19

xi

Gruppe B131 | Indholdsfortegnelse
Kapitel 8 Udviklingsdokumentation | 27
Kapitel 9 Resultater | 29
Kapitel 10 Diskussion | 35
Kapitel 11 Perspektivering | 37
Kapitel 12 Konklusion | 39
Litteratur | 41
Appendiks A Casehus | 45

xii

# 1 Definitioner og forkortelser

Udtryk / Forkortelse | Forklaring
RIPC | Remote ischemic pre/per/post conditioning. Længerevarende okklusion af ydre ekstremitet, efterfulgt af en deflations fase
AIS / apopleksi | Acute ischemic stroke, en pludseligt opstået neurologisk skade eller udfald på baggrund af iskæmi (nedsat blodforsyning) i hjernen
AUH | Aarhus Universitetshospital
Konditioneringsapparatet | Navnet på prototype som udvikles til at udføre RIPC
Okklusionsfase | Periode hvor på manchetten skaber arteriel okklusion
Deflationsfase | Periode der er altid er efterfulgt en okklusionsfase, hvor manchetten er deflateret i under 10mmHg
Cyklus | Forløb bestående af én okklusionfase og én deflationsfase
Gennemført afklemning | Boolean værdi der bruges til at bestemme om en cyklus er gennemfør eller ej

# 2 Indledning

### 2.1 Formål

### 2.2 Læsevejledning

Udviklingsdokumentation

# 3 Baggrund

Apopleksi (pludseligt opstået fokale neurologiske symptomer) opstår af infarkt eller en blødning. Ved infarkt nedsættes eller afbrydes blodforsyningen i visse område af hjernen og dette medfører iltmangel i det ramte område. I 85% af tilfælde er apopleksi forårsaget af infarkt og 15% skyldes blødning 1

Hvert år indlægges ca. 12.000 danskere i forbindelse med apopleksi og i den vestlige verden er apopleksi det tredjehyppigste dødsårsag.²
. Af de personer der overlever et apopleksi tilfælde, lever næsten 50% af dem med varige men og 25% af dem har behov for andres hjælp ved daglige aktiviteter. 3 Det høje antal tilfælde årligt og de mange personer med varige men har store omkostninger for sundhedssektoren. I 2001 kostede apopleksi sundhedsvæsnet 1,8 milliarder kroner. 4

Den nuværende behandling af apopleksi og dets følgevirkning sker i flere forskellige trin; forbyggende, akut behandling og rehabilitering.

Meget af den forebyggende behandling af apopleksi ligger i livstilsændringen. Faktorer for udvikling af apopleksi er bl.a. hypertension, hjerte-kar sygdomme, arteriosklerose og forhøjet kolesterol.

For at opnå størst effekt af akut behandling af apopleksi skal behandlingen helst ske inden for 5 timer efter tilfældet indtræf. Behandlingen består som regel af en scanning for afgøre om der er tale om en blodprop eller en blødning. Hvis der er tale om en blodprop, vil patienten modtage trombolysebehandling

Afhængig af méngraden består rehabiliteringen af genoptræning i forskellige form. Menene af apopleksi kan være alt fra talebesvær til halvsidig lammelse og derfor afhænger genoptræning også deraf. 5

### 3.1 Konditionering

Remote ischemic conditioning (RIC) er en behandlingsform som har vist sig at være effektivt til at beskytte kroppen mod iskæmiske tilstande. Konditionering er en endogen

1FiXme Fatal: Reference til "Basis i sygdomslære, side 399-402
2FiXme Fatal: Reference program apopleksi, side 14
3FiXme Fatal: Refence til fakta om apopleksi http://www.hjernesagen.dk/om-hjerneskader/bloedningeller-blodprop-i-hjernen/fakta-om-apopleksi
4FiXme Fatal: Reference til trombolyse økonomi side 17
5FiXme | Fatal: | https://www.sundhed.dk/borger/sygdomme-a-aa/hjerte-og-
blodkar/sygdomme/apopleksi/behandling-ved-apopleksi/

Gruppe B131 | 3. Baggrund

adaptiv proces, som beskytter kroppens organismer mod iltmangel, hvis det forekommer i små doser. Når konditionering skal anvendes som non-invasiv behandlingsform skaber man konditioneringstilstanden ved at afklemme arm eller ben, heraf kaldet remote ischemic conditioning, til et tryk der er minimum 25 mmHg højere end det systoliske tryk. For at undgå at patienten tager skade af okklusion, udføres den i cyklusser med en iskæmisk periode efterfulgt af en reperfusions periode. Antallet af cyklusser og den tid en cyklus varer variere meget i litteraturen, men som oftest udføres mellem 3-8 cyklusser og med en varighed på 3 til 15 minutter. 6 Behandlingen kan både foretages før, under og efter der opstår et akut iskæmisk stroke. Hvis konditioneringen foretages før, kaldes det remote ischemic preconditioning(RIPreC), under kaldes det perconditiong(RIPerC) og efter postconditioning(RIPostC). Illustration af konditioneringsbehandlingen kan ses på 3.1


Figur 3.1. Oversigt over de forskellige former for RIC behandling

7

### 3.1.1 Mekanismer

Ligesom at der endnu ikke er evidence for at en bestemt tid pr cyklus og bestemt antal cyklusser, så hersker der også stor tvivl i hvilke mekanismer som er afgørende for at konditioneringen har effekt. Dog er der eftervist en lang række mekanismer og endogene responser, som opstår når kroppen udsættes for konditionering. Ved behandling med RIC øges det cerebrale flow ved hjælp af en række mekanismer, bla. ved et forhøjet niveau af nitrit og microRNA-144. I iltfattige område omdannes nitrit til nitrit oxid og dette medfører dilation af blodkarrene. Nitrit har ydermere en effekt på mitokondrierne. Mitokondrierne

6FiXme Fatal: Reference til Hess, Hoda, Bhatia
7FiXme Fatal: Billede til Hess, Hoda og Bhatia

3.1. Konditionering | Aarhus Universitet

producere energi til cellen og uden den dør cellen. Nitrit øger mitokondriernes tolerance over for iltmangel. MicroRNA-144 medvirker også til den gavnlige effekt af RIC ved at påvirke cirkulationen. RIC har også vist at aktivere en række mekanismer i forbindelse med nervesystemet (Se figur 3.2. Under RIC er der en øget aktivitet af det autonome nervesystem, og især vagusnerven er aktiv. Blokeres responsen fra vagusnerven mindske effekt af RIC. Dette skyldes at vagusnerven indgår i et anti-inflammatoriske system, og øget aktivering af nerven reducerer inflammation ved fx. iskæmisk-reperfusionsskader. Studier har også vsit at RIC reducerer den inflammatoriske genekspression. 8
| . Ydermere øger
udskillelsen af endogene opioider muligvis aktiveringen og reguleringen af immunceller. Især den reducerede celledød ved behandling med RIC kan forbindes med sænket immunrespons. Hormonel påvirkning er også påvist i forbindelse med RIC. Den iskæmiske tilstande i kroppen har vist et øget udskillelse af fx. adenosine og bradykinin. Begge stoffer, bradykinin og adenosine har indvirkning på cirkulationen og blodflowet. Bradykinin dilaterer blodkarrene og sænker dermed trykket. Adenosine er flow regulerende, påvirker ATP produktionen og medfører øget signal transmission over cellemembranen 9

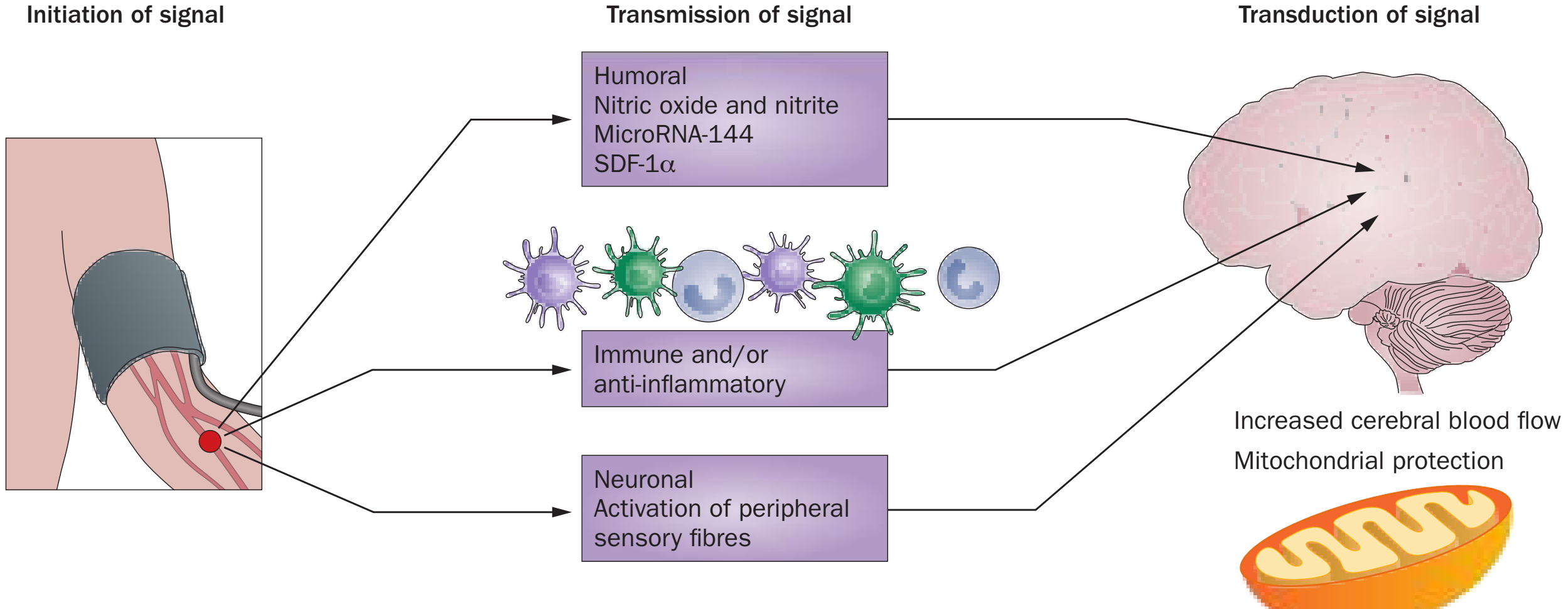
[picture p124: figure]
Humoral Nitric oxide and nitrite MicroRNA-144 SDF-1α; Initiation of signal; Transmission of signal; Transduction of signal; Immune and/or anti-infammatory; Neuronal Activation of peripheral sensory fbres; Increased cerebral blood fow Mitochondrial protection

Figur 3.2. Oversigt over mulige mekanismer der kan aktiverings under konditionering

10

### 3.1.2 Studieprotokol

Mange faktorer omkring RIC er endnu ukendt og især effekten af behandling mangler evidence. Et kommende studie for neurologisk afsnit på Aarhus Universitetshospital (AUH) ønsker at undersøge effekten af RIPerC og RIPpostC, for at forbedre den kliniske rutine til behandling af patienter med akute iskæmiske stroke. 11 Studiet skal foretages på patienter med akut iskæmiske stroke(AIS), som modtager trombolysebehandling. Patienterne udvælges tilfældig så nogle ikke vil modtage RIC. Studiet evaluerer patienter på en række kriterier, heriblandt størrelsen af infarktet efter trombolyse, RIPerC, RIpostC og det kliniske output, som bliver vurderet på modified Rankin Scale. Der findes allerede studie, som har testet effekten af RIC på patienter med blodprop i hjerte og da disse ofte har et lavt blodtryk, findes der kun apparatet til okkludere armen ved 200mmHg. Da studiet undersøger patienter med AIS, som kan have blodtryk på over 200mmHg skal

8FiXme Fatal: Ref Rolfs artikel og Hess Hoda og Bhatia
9FiXme Fatal: Reference Hess, Hoda, Bhatia
10FiXme Fatal: Billede til Hess, Hoda og Bhatia 11FiXme Fatal: Rerence til studieprotokol

Gruppe B131 | 3. Baggrund

studiet bruge et modificeret blodtryksapparat, der kan håndterer systolisk blodtryk på over 200mmHg. Dette er nødvendigt for at sikre tilstrækkelig okklusion.

### 3.2 Noninvasiv blodtryksmåling

Noninvasiv blodtryksmåling, eller indirekte måling af det arterielle blodtryk er fællesbetegnelsen, for flere typer af tekniker, som alle estimerer blodtrykket i arteriet. Ofte associeres en blodtryksmåling af denne type, med den manuelle auditive detektion af puls, distal til en okkluderende manchet, som kan ses på figur 3.3. Denne manuelle auskulatoriske metode med kviksølvs sphygmomanometer anses stadig for at være guldstandarden inden for noninvasiv blodtryksmonitorering.¹²


Figur 3.3. Typisk indirekte blodtryksmåling med sphygmomanometer, manchet ogstetoskop

13

Det automatiske blodtryks apparat som erstatter den manuelle auditive metode (automatiseret auskultatorisk apparat) anvender i alt sin simpelhed en mikrofon i stedet for stetoskopet. Ultralyd anvendes også i nogle blodtryksapparater som erstatning af stetoskoppet og bestemmer ved hjælp af doppler, hvornår arteriet er total okkluderet af manchetten. Ultralyd har særlige fordele, såsom at kunne bruges på spædbørn og hypotensive patienter, hvor lyden af blodflowvibrationerne i arteriet kan være svære at hører. Langt de fleste blodtryksmållere anvender dog i dag den oscillometriske metode, hvor selve manchetten selv agerer som interface til det pulserende arterie (se figur 3.4).¹⁴ Det ekspanderende arterie skubber til manchetten og skaber oscilloerende trykændringer i manchetten. På samme måde, som ved den auskultatoriske metode pumpes trykket i

12FiXme Fatal: Requirements for professional office blood pressure monitors
13FiXme Fatal: ref: Webster side 325
14FiXme Fatal: Requirements for professional office blood pressure monitors

3.3. Okklusionstræning | Aarhus Universitet

manchetten til over systolisk blodtryk, hvor arteriet er total okkluderet og manchetten udsættes på dette stadie ikke for pulsationer fra det underlæggene arterie. Luften i manchetten lukkes gradvist ud over tid. Når arterie trykket overstiger manchet trykket løber blodet ind i arteriet og skubber til arterievæggen. De små oscillotioner overføres til manchetten, hvilket resulterer i trykændringer (de største trykændringer i manchetten kan også observeres i sphygmomanometeret under en auskulatorisk måling). Oscillotionerne isoleres fra manchetrykket og kan ses på figur 3.4. MAP ses hvor oscillotionerne er størst og det systoliske blodtryk ses hvor en pludseligt stigning i amplitude højden finder sted. Diastolen har ikke en klar overgang og er derfor bestemt ud fra algoritmer.¹⁵

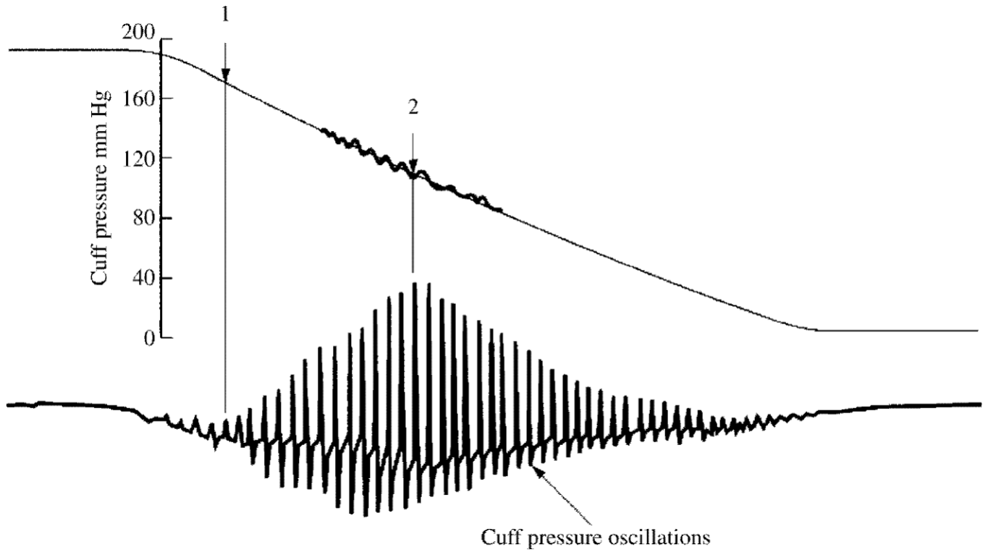
[picture p125: figure]

Figur 3.4. Den oscillometriske metode. En kompressionsmanchet oppustes til et tryk over det systolisk blodtryk. Luften lukkes langsomt ud, hvorefter det systoliske tryk måles ved punkt 1 og MAP ved punkt 2. Det systoliske tryk ses ved den pluslige stigning i de oscillostionernes ampletuder og MAP er manchettrykket ved de største oscillotioner er til stede.

16

### 3.3 Okklusionstræning

Okklusionstræning eller blood flow resistance (BFR) træning har i det senest år gennemgået mange undersøgelse og har vist en stor effekt i forbindelse med muskel hypertrofi og styrke. Ved normal styrketræning skal en utrænede person arbejde omkring 45-60% af 1 repetition maks (RM) for at opnå hypertrofi og øget styrke, og hos en trænet person skal man ligge omkring 80-85% af 1-RM. Ved okklusionstræning skal belastningen ligge væsentlig lavere, omkring 20-50% af 1-RM, for at opnå samme eller større effekt. Okklusiontræning udfører ved at afklemme blodforsyningen til muskel, så manchetten sidder proximalt for musklen. Trykket der okkluderes ved varierer meget fra studierne. Imens musklen er okkluderet arbejder personen til udtrættelse. Dette gentager i et ønskede

15FiXme Fatal: Webster side 328
16FiXme Fatal: ref: Webster side 329

Gruppe B131 | 3. Baggrund

antal set. Pga. det lave belastning og det relativt korte træning periode og stadig store effekt, egner det træningsform sig ideal for person med ledskader, til genoptræningsforløb eller til person som har været sengeliggende længe. 17

17FiXme Fatal: Reference til The efficacy of blood flow restricted exercise: A systematic review and meta-analysis

# 4 Problemformulering

Som beskrevet i baggrundsafsnittet (Se afsnit 3) ønsker en forsker gruppe ved Aarhus Universitet Hospital at undersøge effekten ved per og postkonditionering. Til dette formål skal bruges et modificeret blodtryksapparat, som kan indgå i forskningsprojekt til at foretage per og postkonditionering på forsøgspersonerne. kunden har i samarbejde med Aarhus Universitet udarbejdet et bachelor projekt opslag med følgende punkter:

- Samarbejde med en dansk producent af blodtryksappart
- Samarbejde med forsøgsansvarlige læger omkring produktkrav
- Designe et modificeret blodtryksapparat
- Samarbejde med produktionsvirksomhed i Kina omkring udvikling af prototype
- Test af prototype udfra præspecificerede data

I samarbejde med projektvejleder Peter Johansen og projektudbyder Rolf Blauenfeldt har bachelorprojektet ændre karakter, fra at prototypen skulle fremstilling hos en kinesisk producent, til at bachelor gruppen selv fremstiller en prototype. Selvom bachelorgruppen selv udvikler prototypen ønskes det stadig fra kundens side at der bliver samarbejdet med den danske producent, for at sikre at prototypen ville ligge sig tæt op af deres blodtryksmålere.

For at produktet skal kunne bruges til konditioneringsbehandling skal det kunne måle et blodtryk, hvor efter der afklemmes i specificerede cyklusser. Afklemningstrykket skal være 25 mmHg over systolisk tryk for at sikre tilstrækkelig arteriel okklusion. De specificerede cyklusser fungere så forholdet mellem okklusion og reperfusion er en-til-en.

Fra kunden side lyder endvidere et krav til perkonditioneringsprotokolen kan ændres, hvis forskningen viser bedre effekt ved en anden protokol. De ændringer der skal kunne foretages i protokollen er tiden en cyklus varer og antallet af cyklusser en konditioneringsbehandling skal have.

Da patienten der skal modtage konditioneringsbehandling skal have armen afklemt i længerevarende perioder, er der fra kundens side stillet et krav omkring sikkerhedskontrol. Sikkerhedskontrollen stiller krav til at prototype skal foretage et kredsløbstjek og vurdere om patienten kan risikere at tage skade af de iskemiske tilstande den afklemte ekstremitet udsættes for under behandlingen..

Udover behovet for et apparat der kan udføre perkonditionering, er der efter foreslag fra vejleder Peter Johansen et ønske til prototypen skal kunne bruges til okklusionstræning. Som en seperat funktion skal prototype kunne skifte mellem konditioningsforløb og

Gruppe B131 | 4. Problemformulering

okklusionsforløb. Ved okklusionstræning er kravet at man holder et konstant tryk i manchet på omkring 100mmHg.

# 5 Projektafgrænsninger

Dette kapitel beskriver projektets afgrænsninger og hvilke arbejdsopgaver der blevet frasorteres i udviklingsfasen. Afgrænsninger kan både være til der er helt undladt i projektet, eller bestemte faktorer der har begrænset udvikling af vise dele i systemet.

### 5.1 Sikkerhedskontrol

Fra projekts start i forprojektet lå der et ønske fra kunden siden omkring en sikkerhedskontrol ved konditioneringsbehandlingen. Fra kunden side bestod ønsket i at kontrollere kredsløbet på patienten, der modtog konditioneringsbehandling. Ønsket lød på at bruge et pulsoximeter som sikkerhedskontrol. Det færdige produkt skulle ved hjælp af et pulsoximeter tjekket patients saturation og puls og ud fra threshold værdier vurdere om patienten kunne tåle behandlingen. De tilfælde, der blev nævnt som kunne få sikkerhedskontrollen til at afbryde behandling, var patient med dårligt kredsløb, som ikke kunne nå at opfylde iltreserven i armen i reperfusionsfasen. Problematikken ved at bruge et pulsoximeter som sikkerhedskontrol ligger i teknikken bag pulsoximeteri.

Pulsoximeteri måler variationer i det pulserende blod ved at detektere ændringerne i absorption af lys fra en to lyskilder med forskellige bølgelængder. Når væv belyses kan absorption grundlaget opdeles i fire dele (Se figur 5.1)

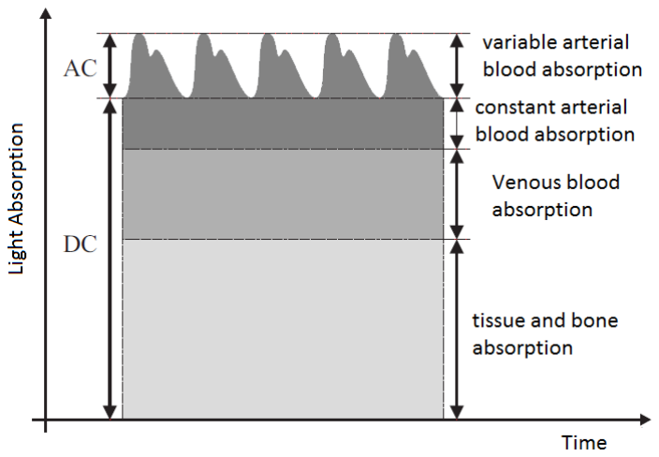
[picture p126: figure]

Figur 5.1. Oversigt over absorption af lys i væv

Gruppe B131 | 5. Projektafgrænsninger

I pulsoximeteri filtreres alt DC væk, dvs absorption fra venøst blod, den konstante mængde af arterielt blod og alt andet væv og der kigges kun på signal fra det pulserende arterielle blod. For at måle saturationen udregnes forskellen på absorption ved pulstop og pulsbund. Disse absorption kan ved hjælp af de molar extinction koefficienter for hhv. oxyhæmoglobin og deoxyhæmoglobin og afstanden mellem lyskilde og modtager omregnes til relative koncentrations ændring i hhv. oxyhæmoglobin og deoxyhæmoglobin. Disse relative koncentration ændringer kan så omsættes til saturation via formlen 5.1

SaO2 =

∆[HbO2]
∆[HbO2] + ∆[HHb]
| (5.1)

På grund af pulsoximeteri kun giver oplysninger omkring pulserende arteriel blod og at iltforsyningen af væv foregår via kapillærerne, mangler der information om kredsløbet i kapillærerne. På den måde giver pulsoximeteri en indikator for respirationen og for hvor iskemisk vævet er. Sikkerhedskontrollen skulle kontrollere om iltreserven i armen nået op på et tilstrækkeligt niveau efter hver afklemning, men pga det pulserende signal fra dette arterielle blod er meget små signaler, er et pulsoximeter udviklet til at detektere meget små signal. Derfor kan selv en person med dårlig kredsløb få målt en puls og saturation uden at vide om hans væv tager skade af konditioneringsbehandlingen.

Denne problemstilling blev opdaget forholdsvis hurtigt i projektforløbet og kunden blev orienteret omkring problemstillingen. Det blev derfor bestemt at projektet skulle afgrænses i forbindelse med sikkerhedskontrollen. Der er gjort plads i udviklingsdokumentation til at implementering af en anden form for sikkerhedskontrol. For at få underbygget påstanden omkring pulsoximeteri og sikkerhedskontrol, har projektgruppen været i kontakt med Troels Johansen fra lungemedicinsk afsnit på AUH (Se afsnit 7.1.3 omkring samarbejdspartnere og mødereferater 1
). Troels kunne kun bekræfte påstanden omkring at pulsoximeteri som være ugyldig til sikkerhedskontrol, og så istedet muligheder i NIRS(Se afsnit 11.1 i perspektivering) eller at bruge pulsoximeteri som kontrol af om afklemningen var tilstrækkeligt.

### 5.2 MR kompatibilitet

I forbindelse med forprojektet var et ønskescenarie fra kunden side at apparatet der skulle udviklings til at udfører konditionering skulle kunne gå i en MR-scanner. Dette var et ønske fordi perkonditionering, hvis det køres i fx 4 cyklusser af 5 minutter, vil tage længere til at gennemfører, end den tid det tager at kører til hospitalet. Proceduren for patient der mistænkes for have apopleksi er at få dem i MR scanneren så hurtigt så muligt, og derfor kan man i nogle tilfælde være nød til at afbryde konditioneringsbehandlingen og der kan stilles spørgsmålstegn ved den gavnlige effekt. Det blev meget hurtigt bestemt af projektet måtte afgrænse sig fra at lave apparatet MR kompatibel, da dette ville stille alt for høje krav til produktets komponenter.

1FiXme Fatal: Reference til mødereferat med Troels Johansen

5.3. Signal behandling | Aarhus Universitet

## 5.3 Signal behandling

### 5.4 Seagull samarbejde

I begyndelse af projektet blev der igennem kunden etableret et sammen arbejdet med en dansk virksomhed, som skulle fungere som talerør til en kinesisk blodtryksapparat producent (Se afsnit 7.1.3 omkring samarbejdspartnere). Tanken bag samarbejdet var et den kinesiske virksomhed skulle kunne bestå med komponenter og teknisks sparringen. Grunden til den danske virksomhed var med som mellemmand var et ønske fra deres side, da den kinesiske virksomhed var deres kontakt. Et andet argument for at det skulle være sammen arbejde med virksomheder var et ønskede fra kunden side omkring produktet skulle lige sig tæt opad Seagulls apparatet.

Men efter flere forgæves forsøg for at kommunikere og få information ud af den kinesisk virksomhed blevet det opgivet at produktet skulle ligge sig op af deres apparater. Det forgæves samarbejde betød også at arbejdet med en blodtryksalgoritme måtte foretages på egen hånd af projektgruppen selv.

### 5.5 Prototypen

# 6 Systembeskrivelse

# 7 Metoder

Metode kapitlet beskriver projektets arbejdsmetoder, hvilke metoder der brugt og hvordan de er blevet brugt. Metodeafsnittet vil især beskrive projektstyringsforløb og udviklingsmetoderne.

### 7.1 Projektstyring

Til overordnede projektstyring er der gjort brug af den Struktureret Agile Metode, forkortet SAM. (Se hjemmeside 1
). Metoden karakteriseres ved at inddele projektet i følgende faser: krav, design, implementering og test. Metoden passede godt på projektet i flere omstændigheder. SAM er oplagt til projektgrupper i størrelsen 2-3 personer og projekter der varer 3-9 måneder. Metoden er også særlig anvendelig til projektet da inddragelse af kunden fylder en stor del i arbejdet. Især i arbejde med forprojektet og opstartsfasen på projektet blev der afholdt mange møder for at fastlægge projektets rammer og kravene til produktet. I SAM metoden adskiller man møder i forskellige kategorier og de tre kategori er som følger: introduktionsmøde, planlægningsmøde og kontraktmøde. Samarbejdet med kunde Rolf Blauenfeldt kan meget vel inddeles i tre forskellige møde kategorier. I forprojektet afholdte projektgruppen introduktionsmøde med kunden for at forventningsafstemme. Da det var på plads og projektgruppen havde besluttet at kundens problemstilling var en opgave som gruppen kunne løse, blev der afholdt flere planlægningsmøder for at finde og udspecificerer de krav som kunden havde til produktet. Disse møder er afholdt over flere omgange, da der undervej i projekt er opstået situation, som ikke var blevet fastlagte. Men efter der var afholdt tilstrækkeligt planlægningsmøder igangsatte projektgruppen første fase af SAM metoden og der blev udarbejdet en kravspecifikation(Se afsnit 7.4.1). SAM faserne er iterative processer, derfor blev der undervejs i forløbet foretaget ændring og justeringer i kravspecifikationen. Kort efterfulgt af kravspecifikation er der udarbejdet en accepttest 7.4.2, som blev udfyldt da udviklingen af prototypen er færdigt. Inden arbejdet med prototypen begyndte, blev der udarbejdet et system design 7.4.3, for at fastlægge hvordan systemet skulle struktureres. Da system strukturen var fastlagt begyndt implementeringsfasen og slutter med at gennemføre accepttesten. For uddybende information se afsnit 7.4 omkring udviklingsdokumentationen.

1FiXme Fatal: Reference til http://www.agilemanifesto.org/iso/dk/

Gruppe B131 | 7. Metoder

### 7.1.1 Scrum/Pivotaltracker

Til arbejdsfordeling og planlægning af arbejdsopgaver er projektet udarbejde med hjælp af scrum. Der er ikke brugt scrum i direkte forstand. Men hver uge er blevet set som en sprint, hvor der hver mandag er udarbejdet en sprint backlog som skulle udføres i ugens løb. Emnerne til sprint backlogen er bla. taget fra tidsplanen som kan ses som en overordnet projekt backlog. Sidst på ugen er der afholdt møde, hvor der opsamles på ugens arbejdet og hvilke opgaver i sprint backlogen der er blevet løst. Opgaver, der ikke blev løst, er automatisk blevet videreført til næste uges backlog. Hver mandag når der oprettes et sprint backlog er disse opgaver blevet oprettet i projektstyringsværktøjet pivotaltracker,( se hjemmeside 2
).

### 7.1.2 Samarbejdsaftale

For at sikre interne forventninger til projektarbejde i gruppen, har gruppens medlemmer lavet og underskrevet en samarbejdsaftale i begyndelse af projektet. 3

I forbindelse med samarbejdet med reviewgruppen er der også blevet udarbejdet og underskrevet en samarbejdsaftale, for at sikre ens forventning til reviewmøderne. 4

### 7.1.3 Samarbejdspartnere

Dette afsnit beskriver projektgruppens samarbejdspartnere igennem projektet.

Kunden og projektudbyder: Rolf Ankerlund Blauenfeldt er læge ved neurologisk afsnit på Aarhus Universitet (AUH). Samarbejdet med Rolf har primært bestået i specificering af krav til udvikling af Konditioneringsapparatet samt faglig ekspert for remote ischemic conditioning (RIC). Desuden det kunden som godkender accepttesten.

Vejleder: Projektvejleder Peter Johansen, har været som faglig vejleder i gennem hele projekt og igennem vejledermøder Peter bistået med faglig kritik løbende.

Reviewgruppe: Igennem projektet har projektgruppen samarbejdet med en anden projektgruppen, Anders Esager og Anders Toft. Denne gruppe har fungeret som opponent/review gruppe, og hver gang en deadline var nået, fx accepttest, har grupperne reviewet hinanden opgaver, hvorefter et møde er blevet afholdet og rettelserne er blevet gennemgået.

Firma: Virksomheden Seagul forhandler blodtryksapparatet og har i projektets opstart fungeret som kontaktperson til en kinesisk udviklingsvirksomheden. Det samarbejdet blevet oprettet for at projektgruppen kunne modtage teknisk sparring i udviklingsfasen.

Advokat: I forbindelse med tavshedspligt (Se afsnit 7.1.7) har projektgruppen samarbejdet med juridisk rådgiver Maibrit Lerche Hendriksen fra Aarhus Universitet. Pga. projektgruppen ønskede samarbejde med en reviewgruppe, kunne samarbejdet ikke begynde før reviewgruppen også blev underlagt tavshedspligt

2FiXme Fatal: https://www.pivotaltracker.com/
3FiXme Fatal: reference til samarbejdsaftale
4FiXme Fatal: reference til samarbejdsaftale med review gruppen

7.1. Projektstyring | Aarhus Universitet

Samarbejde med medikoteknisk afd. AUH

Til udvikling og kalibrering af Konditioneringsapparatet har projektgruppen samarbejde med medikotekniske ingeniører Sara Rose Newell og Steven Brantlov fra Region Midtjylland. Disse har kun bistå med blodtrykssimulator, samt teknisk forståelse af blodtryksmåling. Samarbejdet har bestået i mail korrespondance, samt to møder på medikoteknisk afsnit på AUH, hvor projektgruppen har testet og kalibreret Konditioneringsapparatet på blodtrykssimulatoren.

Samarbejde med Troels Johansen

I forbindelse med udvikling af sikkerhedskontrol til konditioneringsapparatet(Se afsnit 5 omkring projektafgrænsninger) har projektgruppen samarbejdet med Troels Johansen fra lungeafdelingen på AUH. Samarbejdet opstod pga. gruppen manglede ekspertviden omkring pulsoximeteri og afklemning

### 7.1.4 Ugeplan og logbog

Som del af projektstyringen, udviklingsprocess samt dagbog er der på ugentlig basis udarbejdet en ugeplan i starten af hver uge og hver uge er afsluttet med en logbog. Ugeplanen indholder de opgaver projektgruppen skal løses i ugens løb og logbogen er en opsamling på ugens arbejde. For uden af fungere som sprint backlog i scrum (Se afsnit
7.1.1) har logbogen også fungeret som en slags dagbog, hvordan projekts forløb konstant er blevet beskrevet. Logbogen har også været særlig anvendeligt forbindelse med rapport skrivning.

### 7.1.5 Vejldermøde

Fra projektets opstart blev der aftalt et vejledermøde i alle ulige uger under projektforløbet. Disse møder er blevet brugt til at sikre at projektarbejdet hele tiden var på rette spor, samt faglig vejledning til projektarbejdet. Desuden er vejledermøderne blevet brugt til at få kritik på færdig dokumenter undervej i forløbet.

### 7.1.6 Tidsplan

I forbindelse med forprojektet blev der udarbejdet en tidsplan i gantt chart format. Et gantt chart illutreret start og slut dato for hvert af projektet delelementer. Hver række i tidsplanen udgør et delelement, fx. kravspecifikation og accepttesten og hver kolonne udgør én uge. Tidsplanen er løbende blevet opdateret efterhånden som projekt har nået delelementerne. 6

### 7.1.7 Tavshedspligt

Pga. af patentundersøgelse har hele projekt været underlagt tavshedspligt og underskrevet tavshedserklæringer med både universitet og neurologisk afsnit. Tavshedspligten har bla. forsinket nogle processer da alle partner skulle være underforstået med fortroligheden inden et samarbejdet kunne begynde. I andre tilfælde hvor et samarbejde har været kortvarig

5FiXme Fatal: Reference til projektafgrænsning
6FiXme Fatal: Insæt sidste opdateret tidsplan

Gruppe B131 | 7. Metoder

eller der ikke har været til at underskrive tavshedserklæring, har projektgruppen måtte undlade detaljer ved kommunikation med disse samarbejdspartnere. Dette har i nogle tilfælde betyder at hjælpen fra evt. eksperter har været begrænset af manglende forståelse for projektet. Derfor har den igangværende patentundersøgelse været et begrænsning for projektarbejdet i flere omfang. 7

### 7.2 Versionsstyring

For at sikre korrekt og brugervenlig versionsstyring af hele projektets versionsstyring blevet
håndteret med git 8 | . Git er versionsstyring primært udviklet til software. Styringen af
versionshistorik fungere ved at man opretter et respository, som ligger på en server, og hver gang man ønsker at arbejde på filer en ens repository, skal man synkroniseret så man har senest version liggende. Foretages en ændring i en fil der køres versionshistorik på, skal denne ændres committes til ens repository. Hver gang man tilføjer en ændring, skal man skrive hvilken ændring man har foretaget. Resten af versionsstyring foregår automatik i git, og her gemmes automatisk versionsnummer og dato for ændring. Desuden gør git det også nemt at gå tilbage i versionshistorikken og finde tidligere versionen. Selvom prototypen Konditioneringsapparatet ikke skal medicinsk godkendes, var det en grund til at vælge et detaljeret versionsstyrings system. Hvis et apparat skal medicinsk godkendelse skal der kunne fremvises en versionshistorik over hele projektet. Til grafisk interface findes en række program som gør git og versionsstyring mere brugervenlig, og her har det især været brugbart at kunne se forrige ændringer og tilføjelse. Dette har lette projektarbejdet og mindsket uoverensstemmelser med hvilket dokument er nyeste version.

Udover git er dropbox blev brugt til at dele projektfiler der ikke har behov for versionsstyring. Dette har fx. været videnskabelige artikler, datablade mm.

### 7.3 Udviklingsværktøjer

Eclipse: er blevet brugt til software udvikling af Konditioneringsapparatet. For at kunne simplificere kommunikation mellem eclipse og arduino boardet, er der blevet brugt et arduino plugin i eclipse. På den måde kan funktionaliteterne fra Arduino IDE bruges, samtidig med at eclipse funktionaliteter, som auto complete , fejlhåndtering og projektstruktur også var tilstedet.

Arduino IDE: er den oprindelig udviklingsplatform til arduino, men pga at en række manglende funktionalitet er dette kun blevet brugt til simple enhedstest og små scripts.

Matlab: Til databehandling og visning af signaler fra Konditioneringsapparatet. Værktøjet er blevet brugt til at plotte tryk kurver fra tryksensoren, samt oscillationerne målt fra manchetten. Dette har været en stor hjælp for signal forståelse og i forbindelse med kalibrering af blodtryksmåleren.

Fritzing: er blevet brugt til udarbejdet af fumlebræt tegning og schematics over hardware udvikling. Grundet prototype udviklingen har meget arbejdet foregået på fumlebræt, og

7FiXme Fatal: Reference til tavshedserklæring
8FiXme Fatal: Reference til git hjemmeside https://github.com/

7.4. Udviklingsproces | Aarhus Universitet

at kunne dokumentere og "gemme"en opsætning på fumlebrættet har været stor hjælp til bla. fejlhåndtering. Fritzing er et open source program som er udviklet til dokumentation af prototyper. Da programmet er open source har processen med at finde nye komponenter være simple.

Gimp: Billede redigering program som er blevet brugt til redigering og udarbejdelse af illustrationen. Især i forbindelse med figurer og illustrationer til latex har gimp været anvendeligt til at skabe vektoriserede billeder.

Maple: Til filter udregning i forbindelse med design af analoge og digitale filtre er det blevet brugt Maple version 2015. Maple er kommercielt computer algebra system.

Modelio: Alt udvikling af sysML er foregået i Modelio. Modelio adskiller sig fra andre sysML værktøjer, da det ikke er et tegne program, men et programmeringssprog og IDE. Dette betyder at udviklingen af sysML har været begrænset af sproget, men det betyder også at det har været nemmere at overholde sysML standarden.

TexStudio: Alt dokumentation er blevet udarbejdet i TexStudio. Dette er valgt for at få totalt kontrol over layoutet i dokumentationen og rapporten. LaTeX og TeXStudio gø også arbejdet med et større projekt mere simpel, da arbejdet med små underdokumenter er meget simplet.

### 7.4 Udviklingsproces

Efter den struktureret agil metodes(SAM) fire faser: krav, design, implementering og test (se afsnit 7.1) er udviklingsprocessen foregået i denne rækkefølge. Disse fire faser vil blive beskrevet nedenfor.

### 7.4.1 Kravspecifikation

Kravspecifikation er et dokument der beskriver de krav som produktet skal kunne. Der skelnes mellem funktionelle og ikke funktionelle krav. De funktionelle krav beskriver de essentielle krav for at produktet kan leve op til kundens behov. Et eksempel på et funktionel krav er at apparatet skal kunne afklemme med tryk på 25 mmHg over det systoliske blodtryk. I kravspecifikation er de funktionelle beskrevet via fully dressed use cases. En use case beskriver brugen med produktet i scenarier og ved hjælp af disse scenarier beskrives produktets funktionalitet. En fully dressed use case indeholder ud over en beskrivelse scenariet også beskrivelse af hvilke aktører der er involveret i scenariet, samt før og efter betingelse for scenariet. I nogle scenarier kan det også være nødvendigt at beskrive undtagelser for forløbet, hvis disse ikke er for trivielle. Aktørerne der indgår i fully dressed use cases er beskrevet med en aktørbeskrivelse i kravspecifikation. Her beskrives aktør rollen, og om han er primær eller sekundær. En primær aktør interagerer aktivt med produktet i use casen og er nødvendig for at scenariet lykkes. En sekunder aktør er passivt involveret med use casen og dette kan for eksempel være en patient der skal modtage behandling med et apparat. For at give læseren et overblik over hvordan aktører og use cases er koblet, indeholder kravspecifikation et overordnet use case diagram, hvor alle scenerier er listet og aktørernes rolle er beskrevet med pile forbundet med use cases. De ikke funktionelle krav, er som navnet antyder, krav der ikke er nødvendige

Gruppe B131 | 7. Metoder

for produktets funktionalitet, men de er essentielle for brugervenligheden, sikkerheden og muligheden for at vedligeholde produktet. De ikke funktionelle krav er også hvor produktet bliver mere specifikt. Et eksempel er at produktet skal kunne gemme information omkring konditioneringsforløbet på et SD kort, dette er et funktionel krav. Et ikke-funktionelt krav der sikre brugervenligheden specificerer hvordan den information skal være struktureret i filen på SD kortet. Dette sikre at brugeren får samme datastruktur ved brug af produktet. For at fastlægge rammerne for udseende af prototypen er indeholder kravspecifikationen også illustrationer af bruger interfacet.

### 7.4.2 Accepttest

Accepttest er en metode og en del af udviklingsprocessen som skabes for at produktet kan leve op til kravspecifikation. Accepttesten er essentielt for produktudviklingen, for den udføres og godkendes i samarbejdet med kunden. Derfor er projektgruppens garanti for at produktet lever op til de aftalt krav. Dokumentet struktureret således at der er en tabel for hver use case, denne tabel indeholder trinnene fra scenariet og hver trin er indeholder en beskrivelse, en test metode, et forventet resultat og til sidste et felt hvor testen kan godkendes. Det samme struktur gælder for de ikke funktionelle krav.

### 7.4.3 System design

Dette trin i udviklingsprocessen vedrører designet at Konditioneringsapparatet. For at sikre overensstemmelse inden udviklingsprocessen blev igangsat, blev systemets design og arkitektur beskrevet. System designet indeholder først en beskrivelse af alle systemets underdele. Her beskrivelse hvilke dele der skal indgå i systemet for at det lever op til designet. For at sikre at alle område i systemet designet blev belyst er der her gjort brug af metoden 4 plus 1 modellen. Modellen er oprindelig kun beregnet til software men bruges på systemet som helhed. Modellen ser produktet fra fire forskellige synsvinkler og sikre at alle partners interesser er belyst. Det fire synsvinker er som følger:
Logical view: Denne synsvinkel beskriver systemets funktionalitet via centrale elementer, mekanismer og stadier.
Process view: Beskæftiger sig med den ikke funktionelle del af systemet, og hvordan de centrale elementer fra logical view interagerer med hinanden.
Implementation view: Denne vinkel involverer udviklerens perspektiv og beskæftiger sig med hvordan software implementeres.
Deployment view: Beskriver systemet fra en fysisk synsvinkel, blandt andet hvordan eksekveringen af softwares skal foregå på apparatet og hvordan systemets fysisk setup skal ser ud.
NB: Beskrivelse af de fire synsvinkler er udklip fra system design dokumentet. 9

I system design dokumentet er der også gjort stor brug af sysML diagram sproget. Sproget er universel blandt ingeniører og letter forståelsen af systemet. I Logical view er det udarbejdet state machine diagrammer, som bruges til at beskrive stadierne som produktet kan befinde sig i, samt hvordan der skiftes mellem disse stadier. I process view fokuseres der på hvordan systemet dele interagerer med hinanden og til at beskrive denne kommunikation bruges sekvens diagrammer. Der er udarbejdet et sekvens diagram for hver

9FiXme Fatal: Indsæt reference til system design

7.4. Udviklingsproces | Aarhus Universitet

use case. Sekvensdiagrammer beskriver hvordan scenarieret fra use case udføres i mellem systemets dele, samt hvilken information der videregives mellem underdelene.

### 7.4.4 Implemetering

Implementeringen af produktets funktionalitet er beskrevet i implementeringsdokumentet. Dette dokument bruges til at beskrive hvordan systems enkelt software og hardware dele er implementeret og hvordan disse underdele har opnået deres ønskede funktionalitet. Dokumentet har også til formål at fungere som et opslagsværk, så ønsker læseren forståelse for en specifik software eller hardware del, står det i implementeringsdokumentet. Derfor skal implementeringsdokument også ses som en opskrift på hvordan produktet er fremstillet. Dokument indeholder især erfaringen omkring arbejdet med systemets dele og hvordan de væsentlig dele er blevet enhedstestet.

### 7.4.5 V-model

Den struktureret agile metode (SAM) indeholder samme faser som V modellen, men beskriver ikke på samme den iterative del af processen. V-modellen beskriver den iterative process (Se figur 7.1). Modellen foreskriver at man starter med kravspecifikation og bevæger sig ned mod implementering hvorefter man projektet arbejdet op i mod accepttesten. Pilene i mellem beskriver at arbejdsprocessen er iterativ og fx de nederste 3 kasser; detaljeret design, implementering og unit test er den iterative process meget brugbar. Når opdages en fejl i implementering ændres designet og der gennemføres en ny enhedstest.

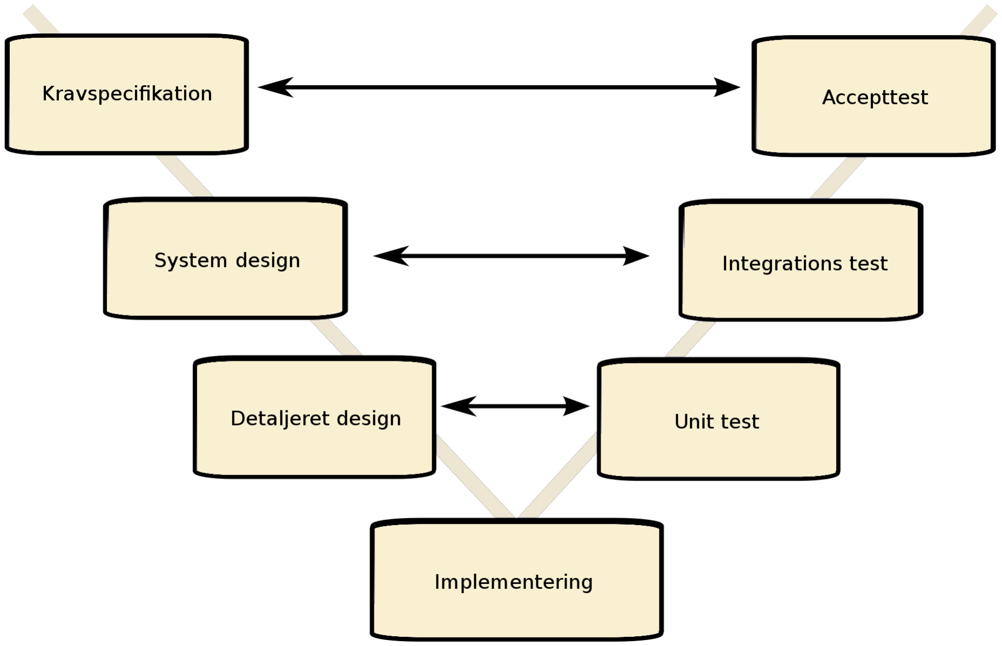
[picture p127: figure]

Figur 7.1. V-modellen

Gruppe B131 | 7. Metoder

### 7.4.6 Review

Review gruppen er beskrevet under afsnittet 7.1.3. Men review har også været en metode i udviklingsprocessen, i sammenfald med tidsplanen har reviewmøderne fungerede som deadline til hvornår bestemt mål skulle nåes i udviklingsprocessen.

# 8 Udviklingsdokumentation

# 9 Resultater

### 9.1 Konditionerings apparat

Konditioneringsapparatet er opbygget af flere blokke, som kan ses på figur 9.1. Blok Definition diagrammer beskriver relationerne mellem blokke, så som sammenhæng, forening og specialisering. I denne sammenhæng beskriver figur 9.1 opbygningen af

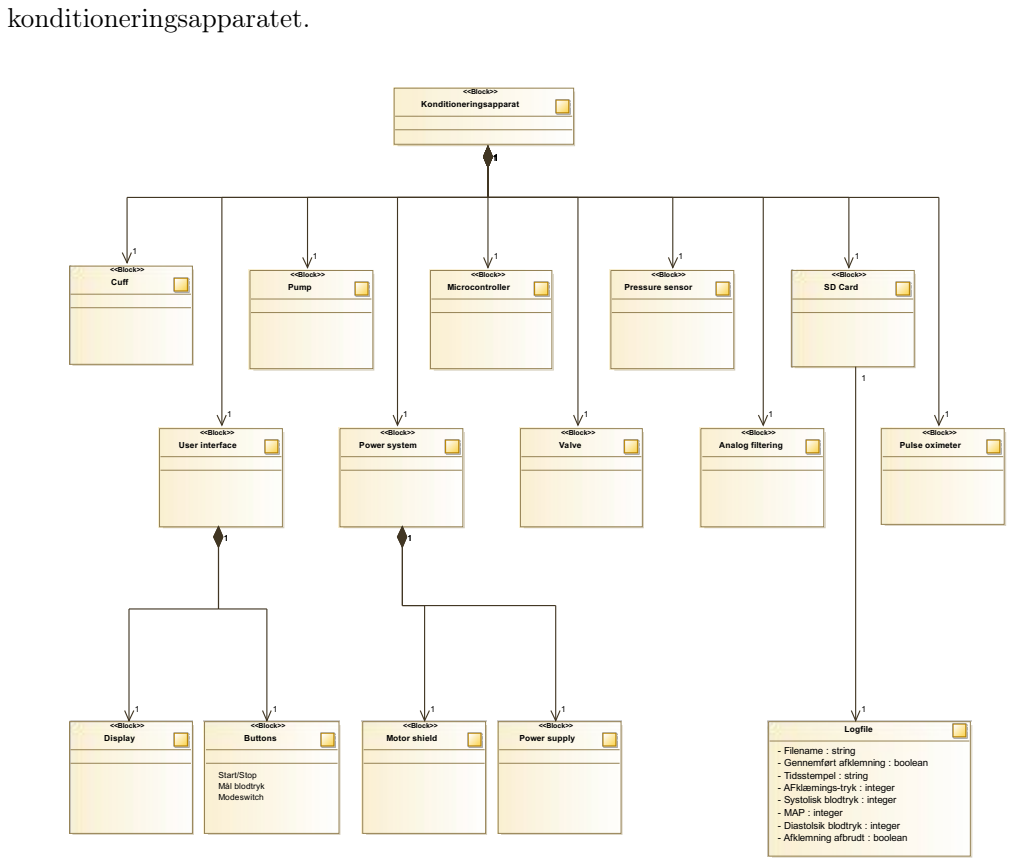
[picture p128: figure]
konditioneringsapparatet.; <<Block>> Konditioneringsapparat; <<Block>> Cuff; <<Block>> User interface; <<Block>> Power system; <<Block>> Analog filtering; <<Block>> Pressure sensor; <<Block>> Pump; <<Block>> Valve; <<Block>> Microcontroller; <<Block>> SD Card; <<Block>> Display; <<Block>> Buttons; Start/Stop Mål blodtryk Modeswitch; <<Block>> Pulse oximeter; Logfile; - Filename : string - Gennemført afklemning : boolean - Tidsstempel : string - AFklæmings-tryk : integer - Systolisk blodtryk : integer - MAP : integer - Diastolsik blodtryk : integer - Afklemning afbrudt : boolean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

Figur 9.1. Block difinition diagram over konditioneringsapparatet.

### 9.1.1 Oscilumetrisk blodtryks apparat

Den oscillometriske blodtryks måle metode, beskrevet i afsnit 3.2, er implementeret i implementeringsdokumentet¹ og resultaterne er beskrevet i dette afsnit.

1FiXme Fatal: reff: implementeringsdokument

Gruppe B131 | 9. Resultater

Det pulserende signal fra tryksensoren, som blodtryksmåleren analyserer er i sin rå (ubehandlet) tilstand støjfyldt. Signalet beskrevet i afsnit 3.2 på figur 3.4 er meget rent og amplitudehøjderne danner en flot parabel formet kurve. På figur 9.2 ses det pulserende signal direkte fra tryksensorennsom er indhyldet i støj. Kurven er stødt faldende, fordi trykket i manchetten langsomt lukkes ud. Ydermere observeres der også varierende amplitudehøjder, som ikke er stødt stigende/faldende, men virker som tilfældigheder.

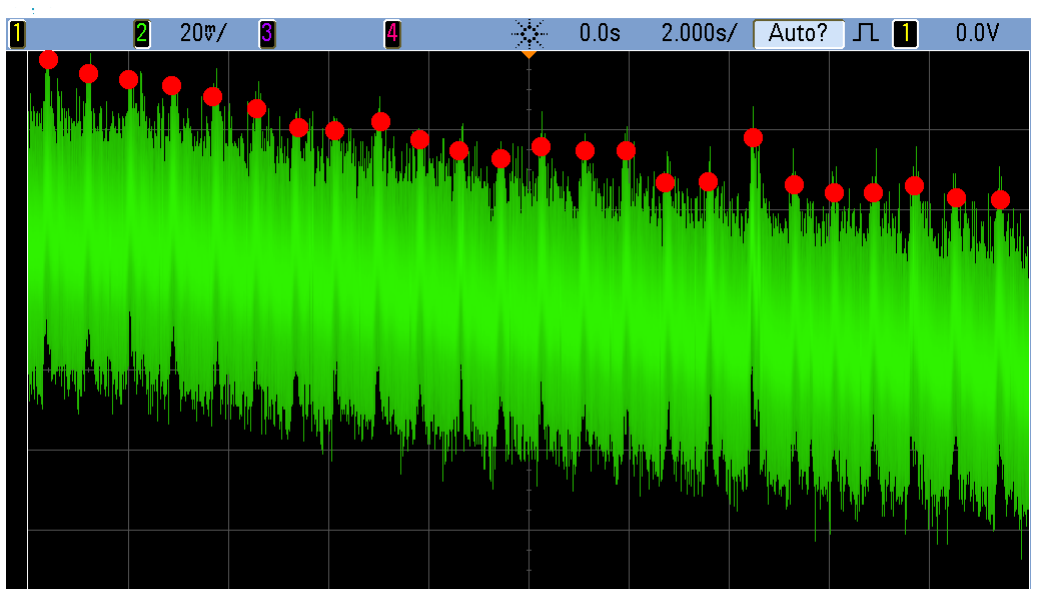
[picture p129: figure]

Figur 9.2. Osclilloskops måling af rå signal fra blodtryksmåling, med konditioneringsapparatet. De røde cirkler er pulse oscillotionernes højeste punkt

Efter analog filtrering af det rå signal på endnu en blodtryksmåling med konditioneringsapparatet, ses at amplitude oscillotionerne isoleret og uden manchettrykket (offset). Over en hel blodtryksmåling skal kurven ifølge teorien (se figur 3.4), starte med en stigende amplitudehøjde efterfulgt af en top og til sidst faldende oscillotionshøjder med laverer hældnings koefficient end starten. En hel blodtryksmåling med filtreret råsignal kan ses på figur 9.3.

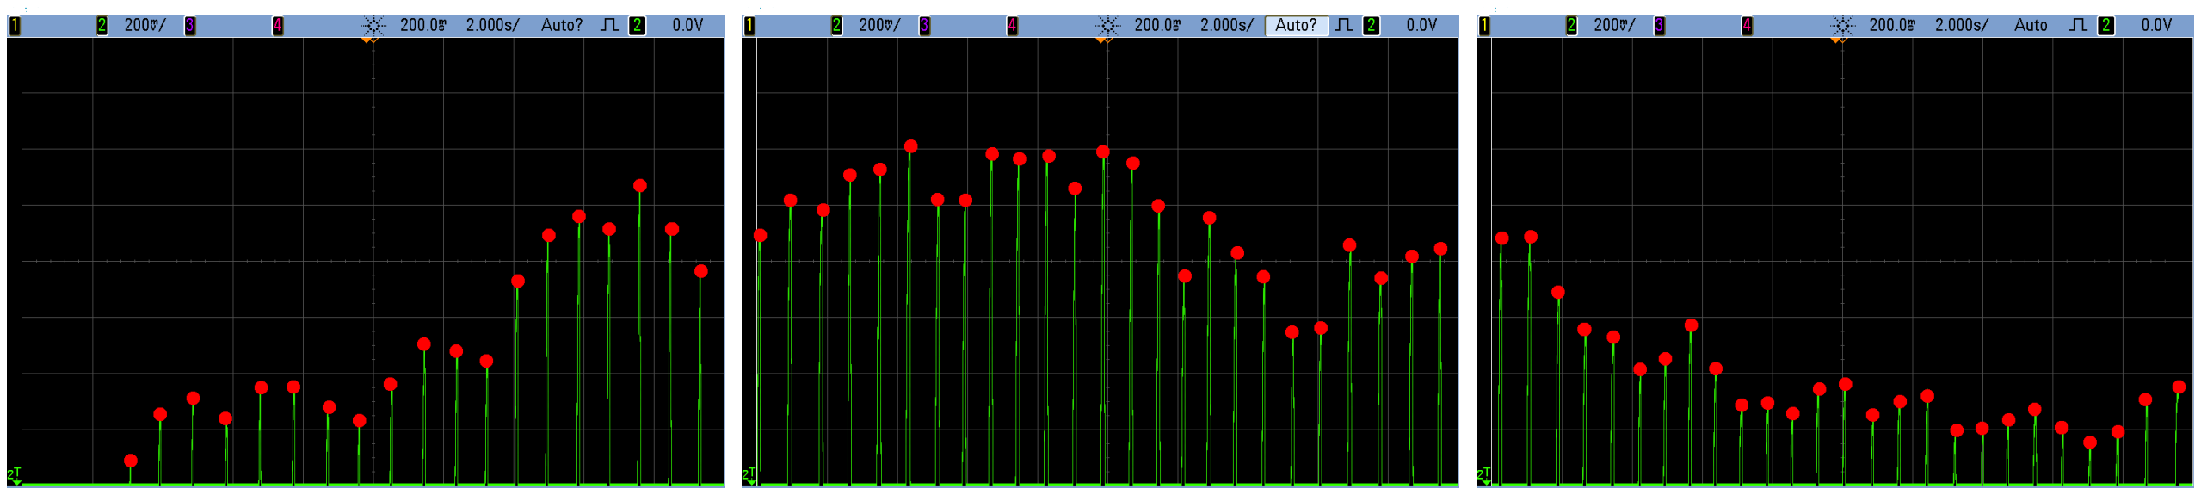
[picture p130: figure]

(a) Stigende | (b) Højdepunkt | (c) Faldende

Figur 9.3. Osclilloskops måling af filtreret signal af blodtryksmåling, med konditioneringsapparatet. (a) er første del af blodtryksmålingen, (b) er de midten af signalet med, hvor MAP befinder sig og (c) er slutningen af signalet, hvor amplituderne flader ud. De røde cirkler er pulse oscillotionernes højeste punkt

9.1. Konditionerings apparat | Aarhus Universitet

Analog filtrering

Den analoge filtrering, ses på forskellen mellem figur 9.2 og figur 9.3, er implementeret i implementeringsdokumentet se 2
. Det resulterende analoge filter, er bestemt ud fra test opsætninger (se 3

) og litteraturen 4
. De pulserende oscillationer isoleret fra det rå signal kan ses på figur 9.5. Resultatet er opnået, ved at implementerer et båndpasfilter, med et pasbånd som starter før lavest mulig puls og slutter ved den tiende afledte af grundfrekvensen 60bmp (se figur 9.4).

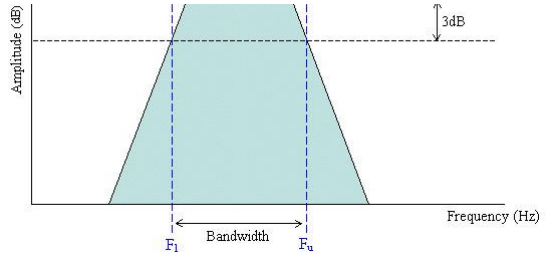
[picture p131: figure]

Figur 9.4. Bånd pass filter med passfilter mellem F1 og Fu. F1 = 0.22Hz (13 bmp under mulig puls) og Fu = 11Hz (660 bmp 10 afledte af 60 bpm)

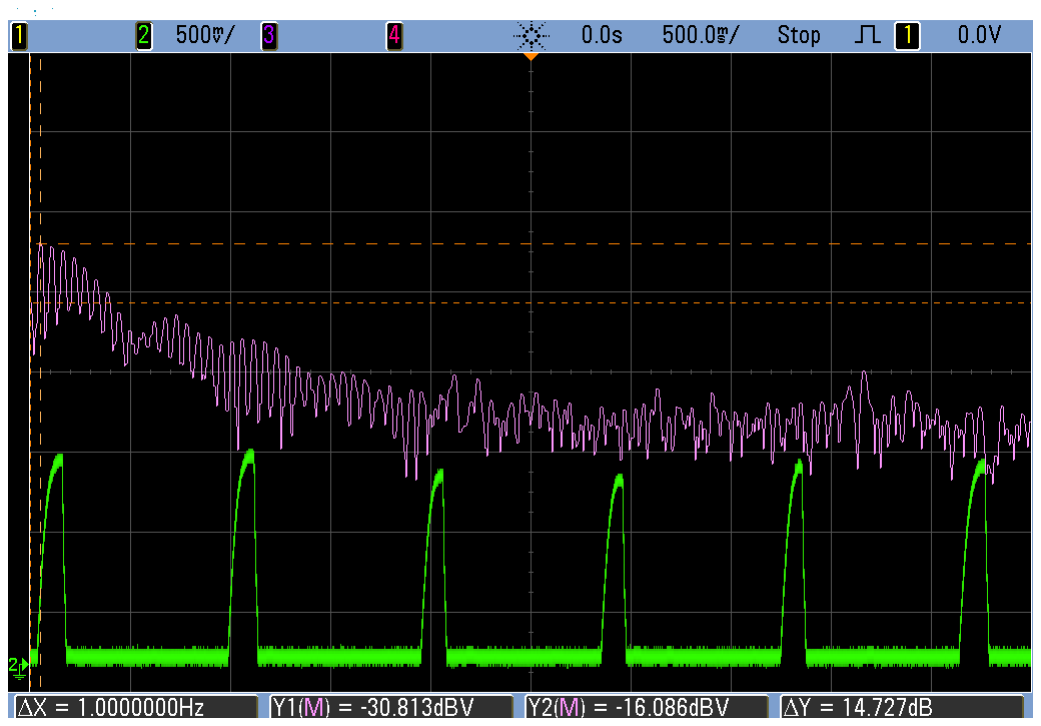
[picture p132: figure]

Figur 9.5. Osclilloskops måling af filtreret signal fra manchetten oppustet på arm. Den grønne kurve er de pulserende oscillotioner og den lilla kurve er en Fast Fourier Transformation (FFT) af den grønne kurve, hvor den udregnede grundfrekvens af oscillationerne måles til 1Hz (60 bpm).

2FiXme Fatal: ref: implementeringsdokument
3FiXme Fatal: ref: implementeringsdokument
4FiXme Fatal: CHARACTERIZATION OF THE OSClLLOMETRlC METHOD FOR MEASURING INDIRECT BLOOD PRESSURE

Gruppe B131 | 9. Resultater

Digital filtrering

For at opnå en glat parabel, som vist på figur 3.4, er der implementeret et digitalt filter, som har til opgave at udglatte oscillutions amplituderne fra blodtryksmålingerne. Resultatet af implementeringen kan ses på figur 9.6. Det bedste forhold mellem udglatning og reaktionshastighed af filteret er opnået ved et ekspotentielt midlingsfilter (se 9.1) med alfa værdi på 0.15 (se 5
for uddybende beskrivelse).
y(n) = α ∗ x(n) + (1 − α) ∗ y(n − 1) | (9.1)

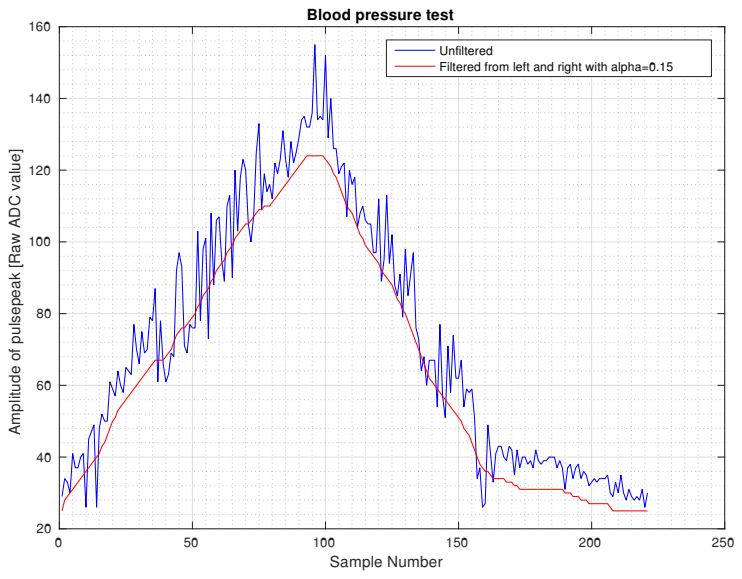
[picture p133: figure]
Sample Number; plitu; uls; alu; Blood pressure test; Unfiltered

Filtered from left and right with alpha=0.15

Figur 9.6. Digital filtrering af oscillotions peaks fra blodtryksmåling på simulator med ekspotentiel midlingsfilter.

### 9.1.2 Fikseret-ratio

Konditioneringsapparatets mest avancerede egenskab er uden tvivl estimering af blodtrykket. Apparatet anvender den oscillometriske metode hvor det systoliske og diastoliske tryk blandt andet bestemmes ud fra MAP. Under udviklingen af konditioneringsapparatet blev det besluttet at anvende den fikserede-ratio metode for at forsimple udviklingsarbejdet.

Fikseret-ratio metoden anvender empirisk data til at bestemme hvor store oscillotionerne i manchettenv skal være i forhold til oscillotionerne ved MAP, for at identificerer SYS og DIA. Dette betyder at systolisk og diastolisk tryk er bestemt ved manchettrykket når amplituden af oscillotionerne er en ratio af den maksimale værdi.⁶

5FiXme Fatal: reff: implementeringsdokument
6FiXme Fatal: ref: Theory of the Oscillometric Maximum and the Systolic and Diastolic Detection Ratios

9.1. Konditionerings apparat | Aarhus Universitet

Ratio værdierne til konditionerings apparatet
kunne ikke bestemmes ud fra en større mængde empirisk data fra patienter, på grund af projektets omfang. I stedet er empirisk data blevet indsamlet fra "Fluke biomedicalBP Pump 2"en oscillometrisk blodtrykssimulator (se figur 9.7). Konditionerings apparatet opsamlede data fra simulatoren, hvilket kan ses på figur 9.6 og ??. Fordi simulatoren indstilles til kendte blodtryksværdier kan de fikserederatiorer bestemmes ud fra oscillotions amplituden (OA) ved et givent manchettryk. f.eks ved simulering af 120/80 skal oscillotions amplituden ved manchettrykket 120mmHg aflæses og forholdet mellem MAP og denne aflæste værdi er den systoliske ratio.

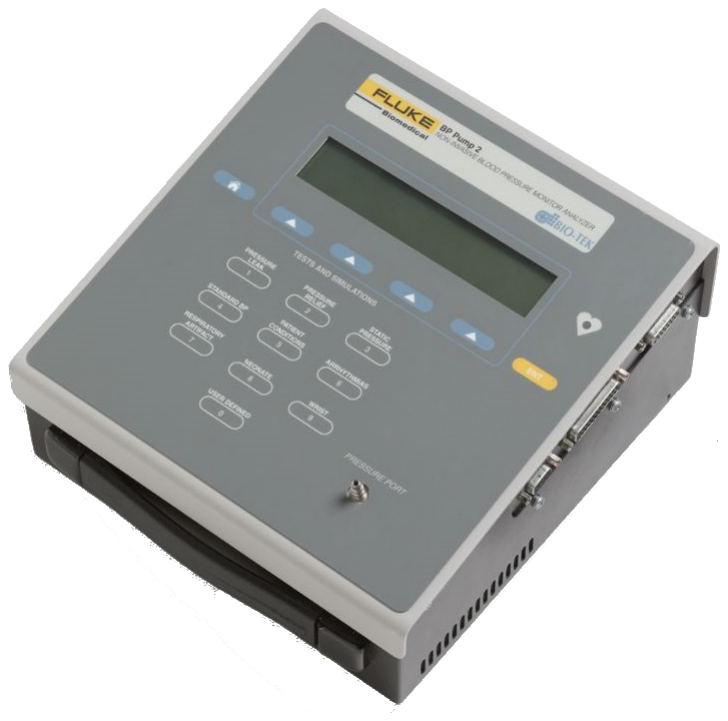
[picture p134: figure]

Figur 9.7. Fluke Biomedical BP Pump 2
| Non-invasiv blodtrykssimulator

Resultatet af simulationerne kan ses på figur 9.8(a) uden manchettrykket og med manchettrykket på figur 9.8(b). Ratioen for SYS (se 9.2) blev udregnet til 0.38 og for DIA (se 9.2) til 0.48.

SY SOA = MAPOA ∗ 0.38 | (9.2)
DIAOA = MAPOA ∗ 0.48 | (9.3)

«««< Updated upstream

======= »»»> Stashed changes

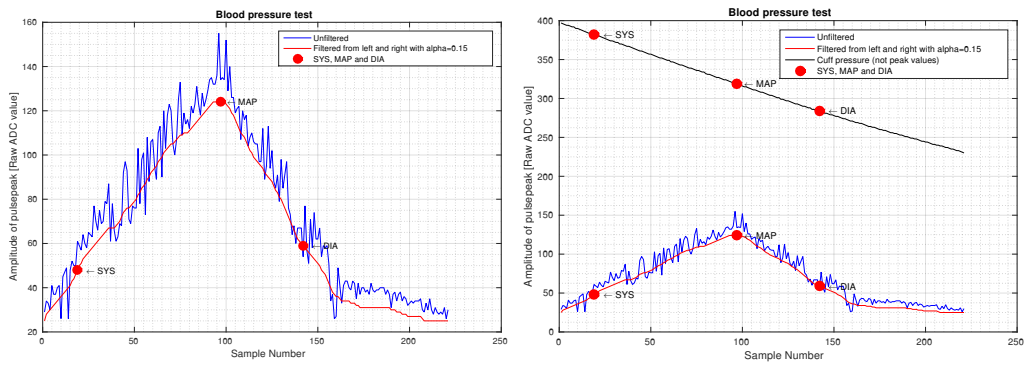
[picture p135: figure]
Sample Number; plitu; uls; alu; SYS; MAP; A DIA; Blood pressure test; Unfiltered; SYS, MAP and DIA; DIA; Filtered from; left; and; right; with; alpha=0.15; Cuff; pressure; (not; peak; values); SYS,

Filtered from left and right with alpha=0.15

(a) Simulationsdata uden manchettryk
(b) Simulationsdata med manchettryk

Figur 9.8. Digital filtrering af oscillotions amplituderne fra blodtryksmåling på simulator med ekspotentiel midlingsfilter. De røde prikker er placeret hvor SYS, MAP og DIA befinder sig ved fikseret-ratio på 0.38(SYS) og 0.48(DIA).

Gruppe B131 | 9. Resultater

### 9.2 Dataopsamling

I forbindelse med udviklingen af prototypen var der et ønske fra kunden side omkring dataopsamling fra Konditioneringsapparatet. For at apparatet kan bruges til forskningsprojektet er nødvendigt at kunne dokumentere hvordan mange konditioneringscyklusser en patient har modtaget. I samarbejde med kunden blev aftale at et konditioneringsapparat skal følge en patient i gennem hele forløbet, altså fra præhospital, til hospital og til sidst i hjemmet. Derfor blev det besluttet at data blev gemt på et SD kort, som hver gang et apparat returneres fra en patient bliver tømt for data og formateret.

### Tidsstempel Gennemfoert afklemning

### Afklemningstryk Systolisk

| | | blodtryk

### Middeltryk(MAP) Diastolisk

| | | | | blodtryk | Afklemning

### afbrudt

26/11/15

14.39.36 | 0 | 0 | 174 | 124 | 100 | 0
26/11/15
14.39.50 | 0 | 200 | 0 | 0 | 0 | 0
26/11/15
14.40.03 | 1 | 200 | 0 | 0 | 0 | 0
26/11/15
14.40.26 | 0 | 200 | 0 | 0 | 0 | 0
26/11/15
14.40.39 | 1 | 200 | 0 | 0 | 0 | 0
26/11/15
14.41.03 | 0 | 200 | 0 | 0 | 0 | 0
26/11/15
14.41.03 | 0 | 0 | 0 | 0 | 0 | 1

Figur 9.9. Et eksempel på fil udtræk fra SD kortet

På figur 9.9 oversigt over fil udtræk. Her er udført et konditioneringsbehandling, hvor blodtrykket først er blevet målt til 174/100(124) mmHg. Der gemmes et værdier ved blodtryksmålinger, hver gang trykket i manchetten når afklemningstrykket og når en okklusionsfase er færdig. Endvidere skrives det til SD kortet hvis konditioneringsbehandlingen afbrydes. Hver gang der skrives til SD kortet gemmes et tidsstempel, om afklemningen er gennemført, afklemningstrykket, blodtrykket og information omkring konditioneringsbehandling blev færdig gjort.

I den måling der er vist på figur 9.9 er der foretaget en blodtrykmåling, 2 fulde cyklusser og en afbrudt cyklus. En okklusion cyklus var sat til 10 sekunder og antallet af cyklusser var 3. Grundet til tidsstemplerne ikke er med 10 sekunder forskel er at der først skrives til SD kortet når afklemningstrykket er opnået. Det tager lidt tid for motoren at pumpe manchetten op til det bestemte tryk.

For at sikre at informationen på SD kan kobles til en patient, genereres der et tilfældigt ID på 5 hexidecimaler, som sammen med apparat ID’et på 3 cifre, bliver til navnet på filen. Filen der er vist på figur 9.9 har derfor navnet 93C09001.csv. 93C090 er det tilfældig patient ID og 001 er apparat ID. Når den første måling fortages på et apparat med formateret SD kort bliver der generet en .csv fil med det 8 cifrede navn. Patient ID bliver vist på skærmen af Konditioneringsapparatet og det ID skal noteres at ambulance personale, som derefter skal kobles med patienten CPR nummer. Det gøres for at apparatet ikke skal håndtere patient følsomme oplysninger.

# 10 Diskussion

### 10.1 Oscillometrisk fikseret-ratio

Den oscillometriske fikseret-ratio metode er brugt i hvid udstrækning til non-invasive målinger af det systoliske og diastoliske blodtryk. Det er derfor ikke unormalt at apparatet beskrevet i denne rapport under afsnit 9.1.2, anvender fikseret-ratio fastsat ud fra empirisk data. Flere studier har også vist at denne metode har en høj nøjagtighed.¹ Problemet med denne rigide fortolkning at det systoliske og diastoliske blodtryk altid befinder sig samme procentsats fra middel arterie trykke opstår ved individernes forskellighed.

Jiankun et al² opstiller en matematisk model for den oscillometriske metode medregnet arterie eftergivenheden og undersøger ud fra dette hvilke faktorer, som påvirker den fikserede-ratio og hvor stor en afvigelse, fra den sande værdi dette giver. Resultaterne af denne gennemgang er teoretiske afvigelser på op til 58 mmHg ved svær arterie stivhed. Efter som at stive arterier ofte er til stede ved arteriosklerose er apopleksi patienter (også beskrevet i afsnit 3) særlig udsatte for fejlmålinger med fikseret-ratio metoden. Den korte forklaring på dette problem er ændringer af manchet oscillotionernes kurve brede. Kurven som dannes af peak ampletuderne af oscillotionerne (se figur 3.4) ændre karakter ved ændring af arterie stivheden. Dette illustreres bedst ved at afbillede data med normaliseret manchettryk oscillotioner over manchettrykket på arterier forskellig eftergivenhed.

1FiXme Fatal: Theory of the Oscillometric Maximum and the Systolic and Diastolic Detection Ratios 2FiXme Fatal: Error Mechanisms of the Oscillometric Fixed-Ratio BloodPressure Measurement Method

Gruppe B131 | 10. Diskussion

På figur 10.1 er fejl mekanismen ved fikseret-ratio bestemt systolisk tryk (SP) og diastolisk
tryl (DP) illustreret. Peak ampletuderne er normaliseret, hvilket tydeliggør ændringerne i kurve bredden, når arterie eftergivenheden ændres. Ved normale arterievægge passer de empiriske ratio værdier godt, men efter som arteriet afviger fra det normale stiger fejl estimationen af SP og DP i takt med afvigelsen af eftergivenheden. Hvis er stiverer en normalt resulterer det i en overestimation af det systoliske tryk og en underestimation af det diastoliske tryk. Overestimationen finder sted fordi den konstante ratio for det systoliske tryk (SP/MAP) nu befinder sig på et tidligere tidspunkt i tid, hvor manchet trykket er højere og derfor overestimerers SP. På samme måde som systolisk tryk overestimeres, underestimeres det diastoliske tryk fordi den konstante ratio for det diastolisk tryk (SP/MAP) nu befinder sig på et senere tidspunkt i tid, hvor manchettrykket er laverer. Det samme scenarie gør sig gældende bare modsat, for en blodtryksmåling på arterier med en højere eftergivenhed end normalt. Ændringer i arterievæggens eftergivenhed påvirker ikke estimationen af MAP, som altid befinder sig med de største oscillotioner i manchetten. Anvendelse af oscillometrisk fikseret-ratio metoden, til at måle blodtryk på patienter med apopleksi kan være problematisk på grund arterie stivheden, som giver anledning til fejl estimationer på op til 58 mmHg. Det bør derfor overvejes om andre metoder til at estimerer det sys- og diastoliske tryk skal anvendes i stedet, for at sikre en højere nøjagtighed af blodtryksmålingerne. Overestimationen af det systoliske blodtryk optræder ikke som fejlkilde ved konditioneringen, da her blot ønskes en total okklution af arterierne. Overestimationen giver ikke anledning til et for lavt afklemningstryk, som tillader blod til den afklemte ekstremitet. Fejlkonditionering på grund af blodtryksmålingen opstår kun ved underestimering af SYS.

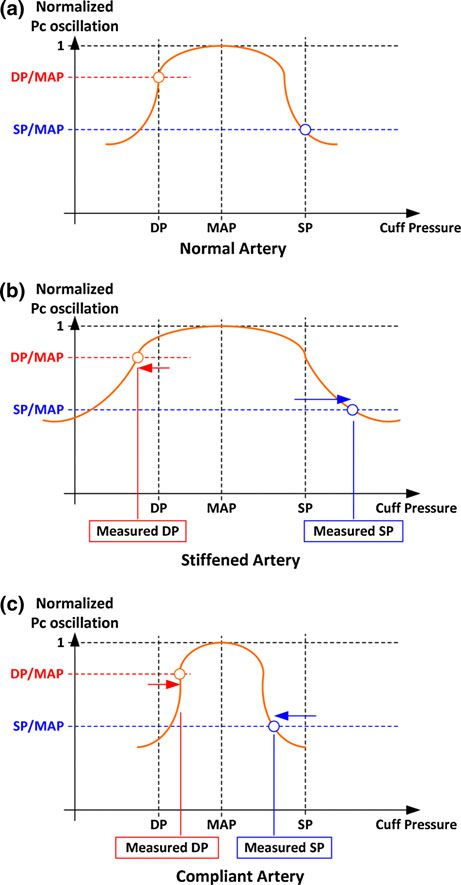
[picture p136: figure]

Figur 10.1. Fejl mekanismen i fixed-ratio metoden ved ændringer af arterie stivheden. Pc er manchet tryk. DP er det diastoliske tryk og SP er det systoliske tryk

FiXme Fatal: billede Ref: Error Mechanisms of the Oscillometric Fixed-Ratio BloodPressure Measurement Method

# 11 Perspektivering

### 11.1 Sikkerhedskontrol

# 12 Konklusion

# Litteratur

Gullev og Poulsen, 2006. Lars Gullev og Michael Poulsen. The installation of meters leads to permanent changes in consumer behaviour. News from DBDH, Journal 3/2006, s. 20–24, 2006.

Jewett og Serway, 2008. John W. Jewett og Raymond A. Serway. Physics for Scientists and Engineers, 7th edition. ISBN: 0-495-11240-2, Paperback. Thomson Learning, 2008.

Klima-, Energi- og Bygningsministeriet, 2014. Klima-, Energi- og Bygningsministeriet. Strategi for energirenovering af bygninger. http://www.ens.dk/info/publikationer/strategi-energirenovering-bygninger, 2014. Downloadet: 23-02-2015.

Gruppe B131 | Litteratur

### Rettelser

Fatal: Reference til "Basis i sygdomslære, side 399-402 | | 5
Fatal: Reference program apopleksi, side 14 | | 5

Fatal: Refence til fakta om apopleksi http://www.hjernesagen.dk/om-hjerneskader/bloedning-
eller-blodprop-i-hjernen/fakta-om-apopleksi | | 5
Fatal: Reference til trombolyse økonomi side 17 | | 5

Fatal: https://www.sundhed.dk/borger/sygdomme-a-aa/hjerte-og-blodkar/sygdomme/apopleksi/behandling-
ved-apopleksi/ | | 5
Fatal: Reference til Hess, Hoda, Bhatia | | 6
Fatal: Billede til Hess, Hoda og Bhatia | | 6
Fatal: Ref Rolfs artikel og Hess Hoda og Bhatia | | 7
Fatal: Reference Hess, Hoda, Bhatia | | 7
Fatal: Billede til Hess, Hoda og Bhatia | | 7
Fatal: Rerence til studieprotokol | | 7
Fatal: Requirements for professional office blood pressure monitors | | 8
Fatal: ref: Webster side 325 | | 8
Fatal: Requirements for professional office blood pressure monitors | | 8
Fatal: Webster side 328 | | 9
Fatal: ref: Webster side 329 | | 9

Fatal: Reference til The efficacy of blood flow restricted exercise: A systematic review
and meta-analysis | 10
Fatal: Reference til mødereferat med Troels Johansen | 14
Fatal: Reference til http://www.agilemanifesto.org/iso/dk/ | 19
Fatal: https://www.pivotaltracker.com/ | 20
Fatal: reference til samarbejdsaftale | 20
Fatal: reference til samarbejdsaftale med review gruppen | 20
Fatal: Reference til projektafgrænsning | 21
Fatal: Insæt sidste opdateret tidsplan | 21
Fatal: Reference til tavshedserklæring | 22
Fatal: Reference til git hjemmeside https://github.com/ | 22

Litteratur | Aarhus Universitet
Fatal: Indsæt reference til system design | 24
Fatal: reff: implementeringsdokument | 29
Fatal: ref: implementeringsdokument | 31
Fatal: ref: implementeringsdokument | 31

Fatal: CHARACTERIZATION OF THE OSClLLOMETRlC METHOD FOR
MEASURING INDIRECT BLOOD PRESSURE | 31
Fatal: reff: implementeringsdokument | 32

Fatal: ref: Theory of the Oscillometric Maximum and the Systolic and Diastolic
Detection Ratios | 32

Fatal: Theory of the Oscillometric Maximum and the Systolic and Diastolic Detection
Ratios | 35

Fatal: Error Mechanisms of the Oscillometric Fixed-Ratio BloodPressure Measure-
ment Method | 35

Fatal: billede Ref: Error Mechanisms of the Oscillometric Fixed-Ratio BloodPressure
Measurement Method | 36

# A Casehus
