kj-schmidt/Perconditioning/Rapport/Rapport/billeder/FortrolighedsaftaleSide3.pdf

Parternes underskrifter:

Aarhus Universitets Hospital: | Aarhus Universitet:
Dato: 14-09-15 | Dato:

______________________
Rolf Ankerlund Blauenfeldt | Peter Johansen
Anders Toft Andersen: | Anders Esager:
Dato: | Dato:
______________________ | ________________________
Anders Toft Andersen | Anders Esager

Jeg har læst og forstået denne Fortrolighedsaftale:

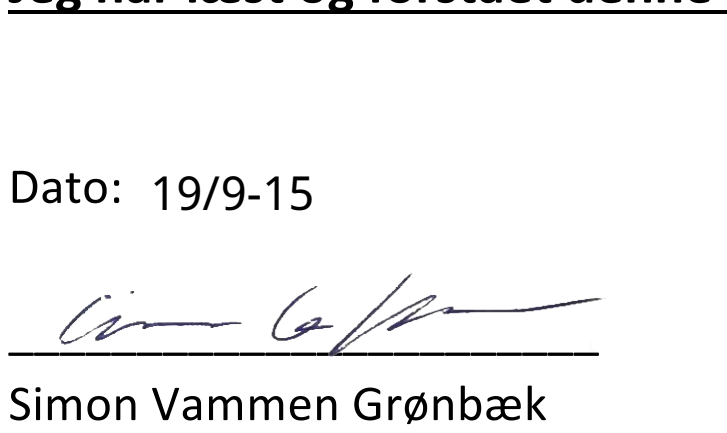
[picture p137: figure]
Dato:; Simon Vammen Grønbæk

Dato: 19/9-15

_______________________
Karl-Johan Schmidt
19/9-15 | 19/9-15
