kj-schmidt/Perconditioning/Rapport/Rapport/billeder/udsnitAfAccepttest.pdf

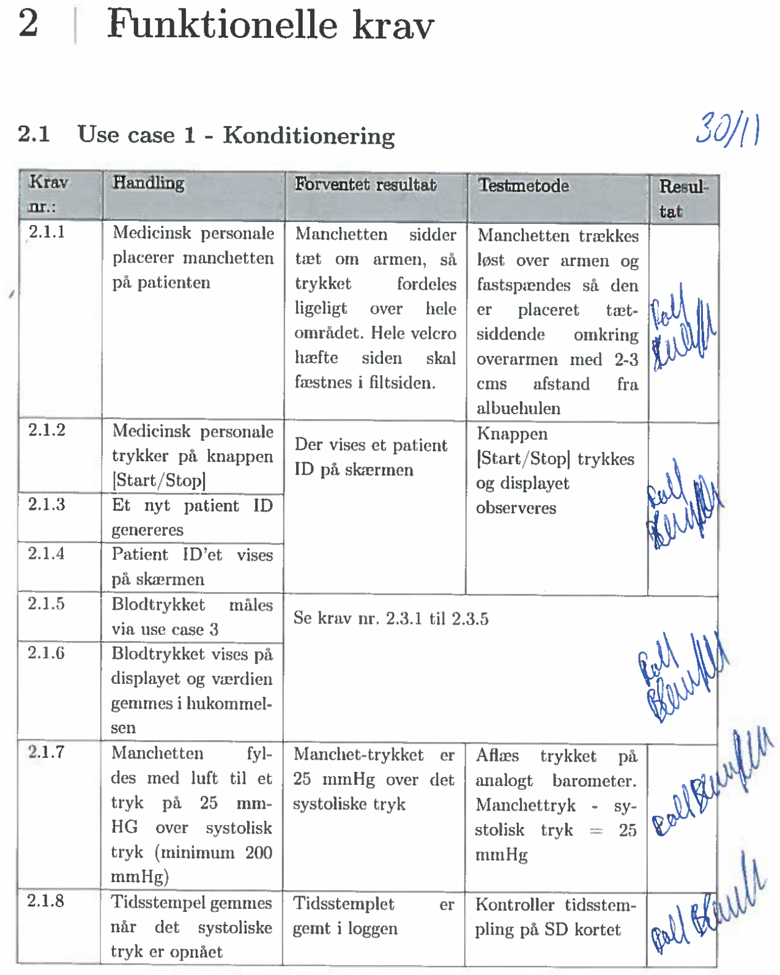
[picture p138: page 1]
