kj-schmidt/Perconditioning/Udviklingsdokumentation/Implementeringsdokument/klassediagram_extra-crop.pdf

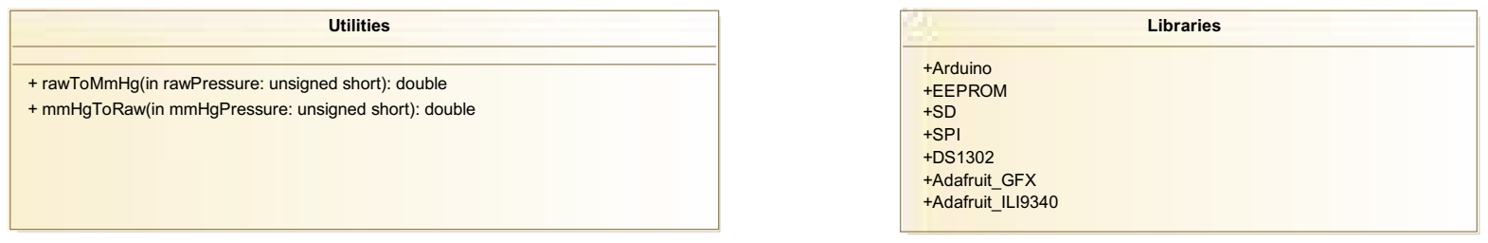
[picture p139: page 1]

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
e: u

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
): d
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
e: u

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
): d
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
PI +DS1
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
uit_

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
uit_ILI9

3
4

0
