kj-schmidt/Perconditioning/Udviklingsdokumentation/SystemArkitektur/pdfs/SD(UC8).pdf

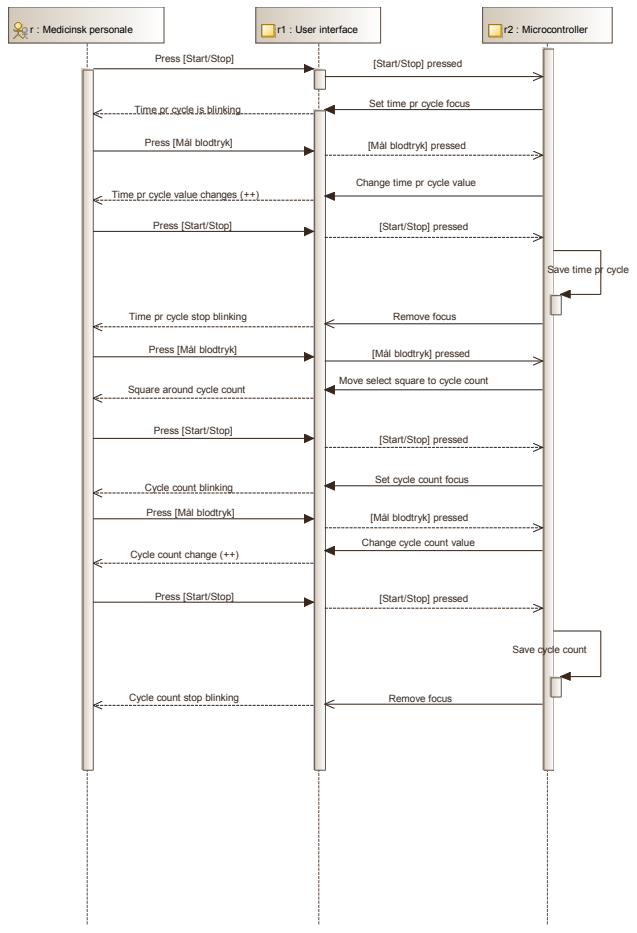
[picture p140: figure]
r : Medicinsk personale; r1 : User interface; r2 : Microcontroller; Press [Start/Stop]; Time pr cycle is blinking; Press [Mål blodtryk]; [Mål blodtryk] pressed; [Start/Stop] pressed; Time pr cycle stop blinking; Remove focus; Cycle count blinking; Cycle count change (++); Cycle count stop blinking; Set time pr cycle focus; Set cycle count focus; Change cycle count value; Save time pr cycle; Save cycle count

Time pr cycle value changes (++) | Change time pr cycle value
Square around cycle count | Move select square to cycle count
