kj-schmidt/Perconditioning/Udviklingsdokumentation/SystemArkitektur/pdfs/STD(BOOT).pdf

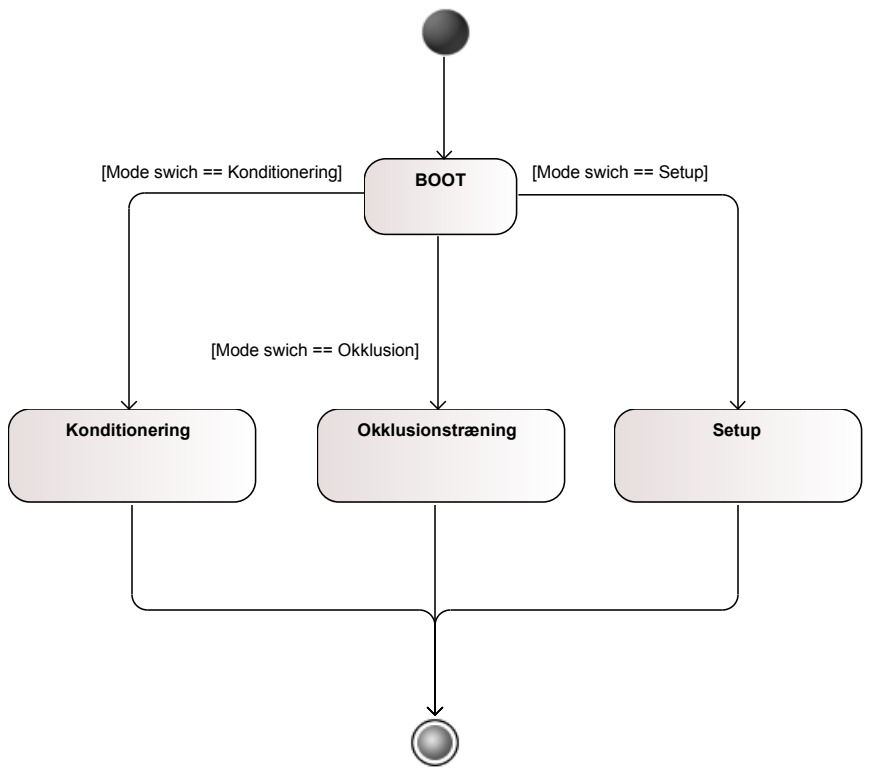
[picture p141: figure]
Konditionering; Okklusionstræning; Setup; BOOT [Mode swich == Konditionering]; [Mode swich == Okklusion]; [Mode swich == Setup]
