kj-schmidt/Perconditioning/Udviklingsdokumentation/SystemArkitektur/pdfs/STM_BOOT-crop.pdf

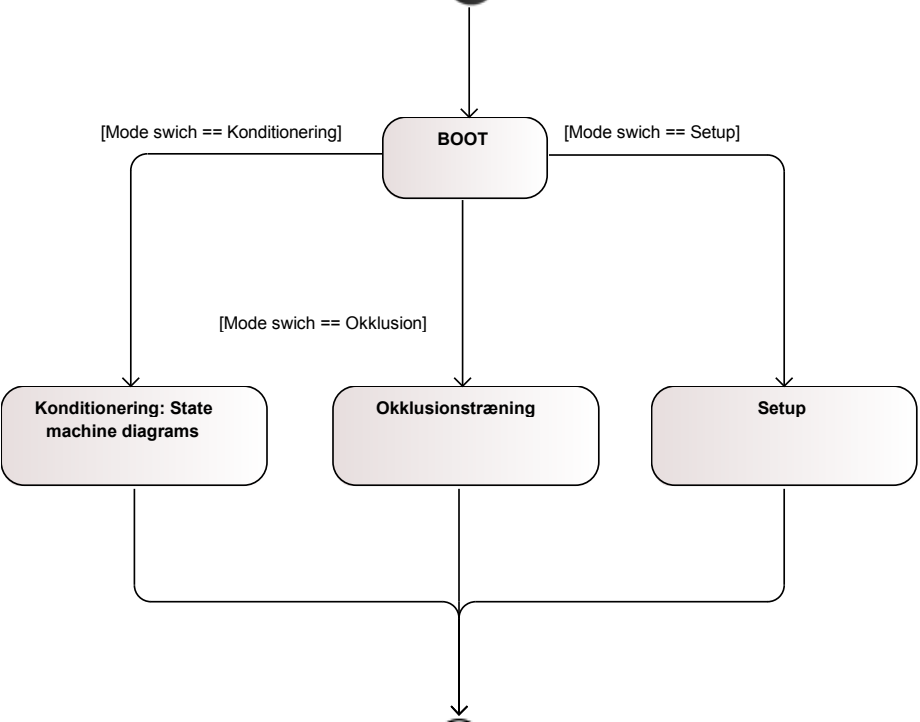
[picture p142: figure]
Konditionering: State machine diagrams; Okklusionstræning; Setup; BOOT [Mode swich == Konditionering]; [Mode swich == Okklusion]; [Mode swich == Setup]
