kj-schmidt/Perconditioning/Rapport/Rapport/billeder/4plus1model.png

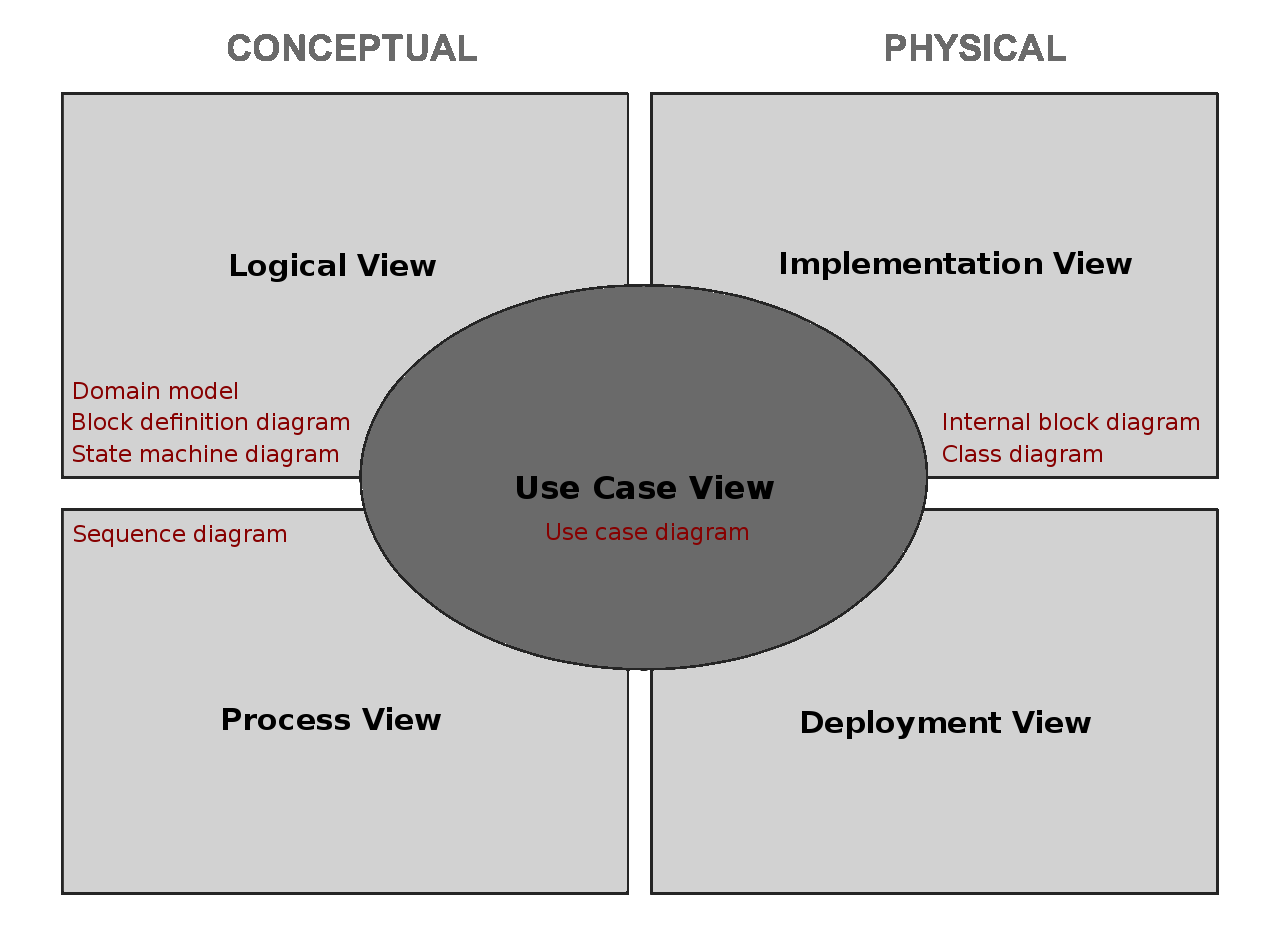
Rapport/Rapport/billeder/4plus1model.png
