kj-schmidt/Perconditioning/Rapport/Rapport/billeder/filteredPulseSignal1.png

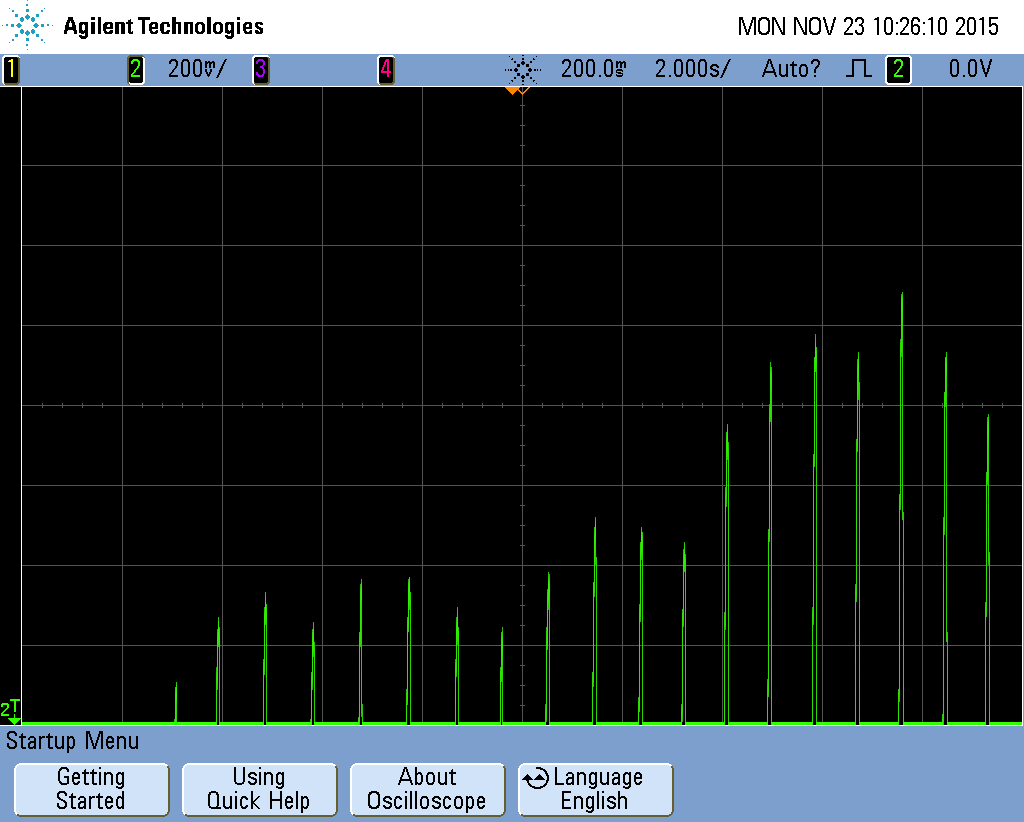
Rapport/Rapport/billeder/filteredPulseSignal1.png
