kj-schmidt/Perconditioning/Rapport/Rapport/billeder/filteredPulseSignal2.png

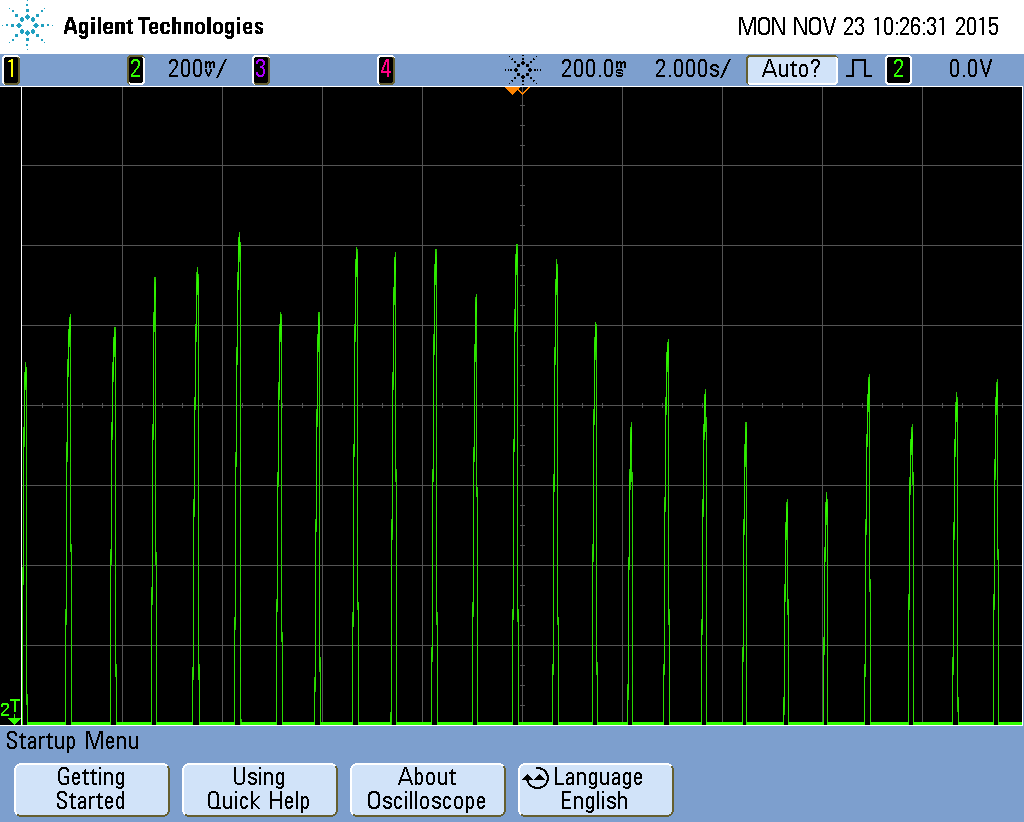
Rapport/Rapport/billeder/filteredPulseSignal2.png
