kj-schmidt/Perconditioning/Rapport/Rapport/billeder/filteredPulseSignal3.png

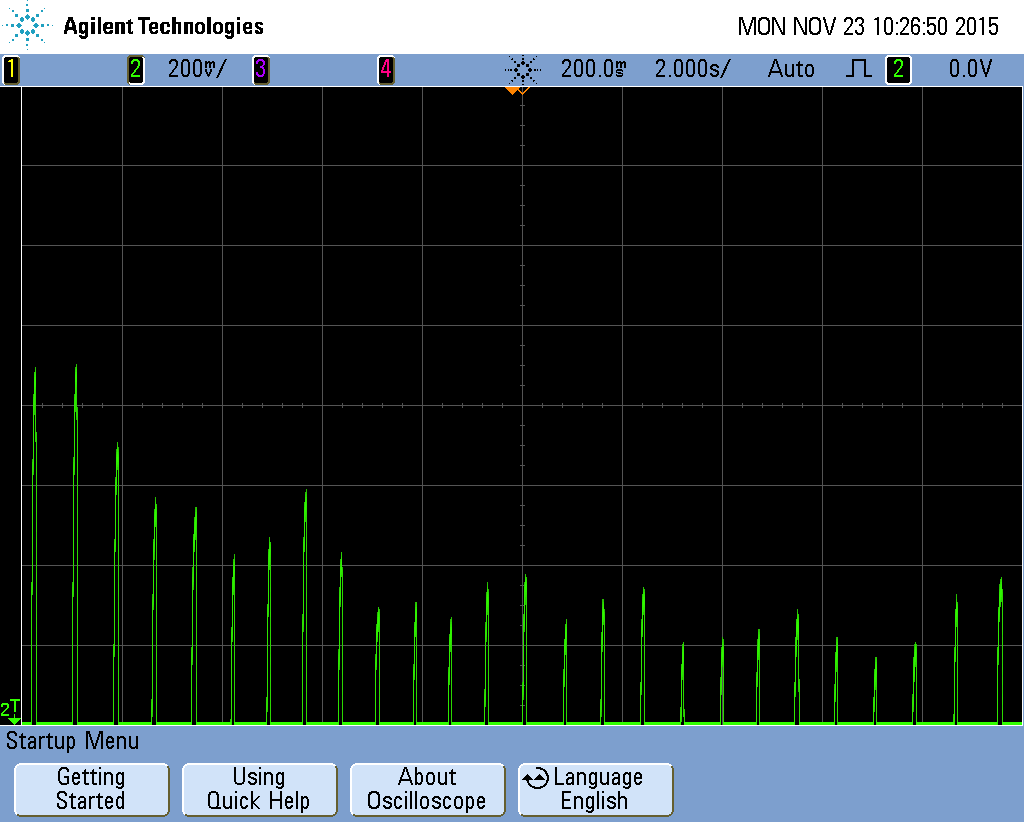
Rapport/Rapport/billeder/filteredPulseSignal3.png
