kj-schmidt/Perconditioning/Rapport/Rapport/billeder/Ikoner/preconditioning2.png

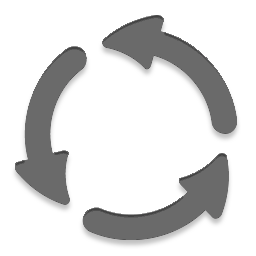
Rapport/Rapport/billeder/Ikoner/preconditioning2.png
