kj-schmidt/Perconditioning/Rapport/Rapport/billeder/rawPulseSignal.png

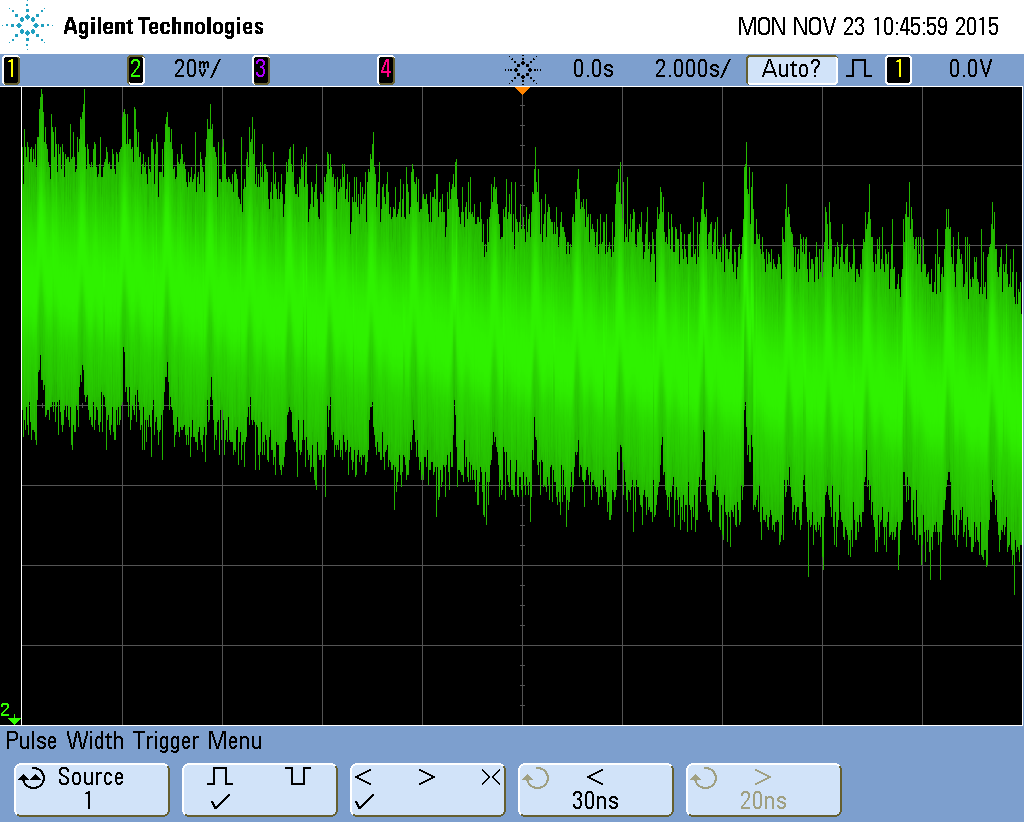
Rapport/Rapport/billeder/rawPulseSignal.png
