kj-schmidt/Perconditioning/Udviklingsdokumentation/Implementeringsdokument/billeder/debounceSchematic.gif

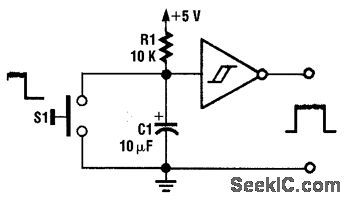
Udviklingsdokumentation/Implementeringsdokument/billeder/debounceSchematic.gif
