kj-schmidt/Perconditioning/Udviklingsdokumentation/Implementeringsdokument/billeder/L298P.png

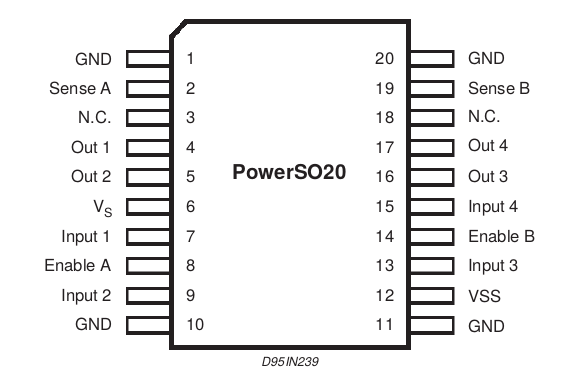
Udviklingsdokumentation/Implementeringsdokument/billeder/L298P.png
