kj-schmidt/Perconditioning/Udviklingsdokumentation/Implementeringsdokument/billeder/scope_0.png

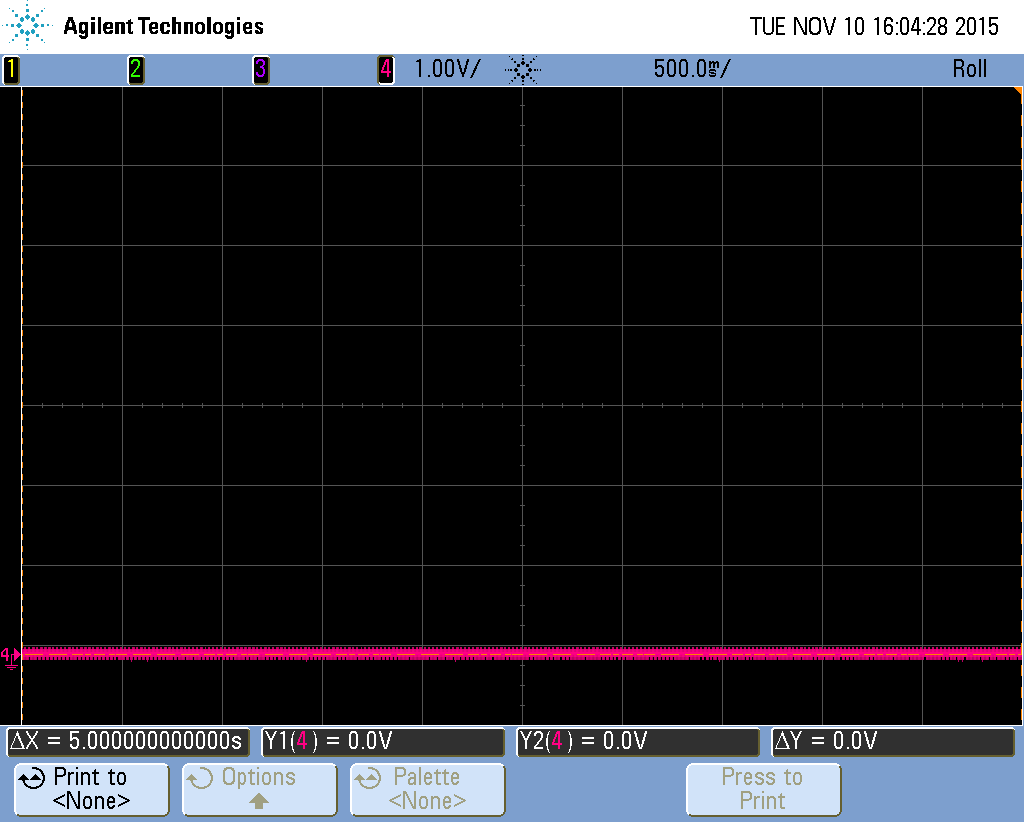
Udviklingsdokumentation/Implementeringsdokument/billeder/scope_0.png
