kj-schmidt/Perconditioning/Udviklingsdokumentation/Implementeringsdokument/billeder/scope_1.png

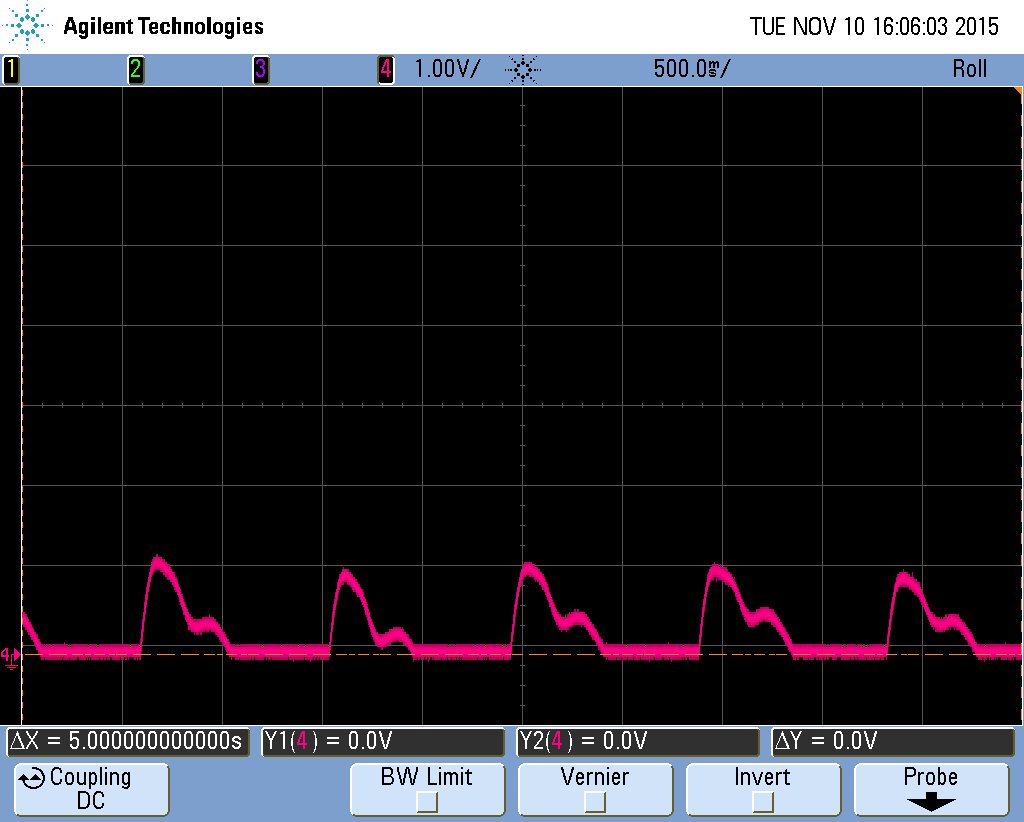
Udviklingsdokumentation/Implementeringsdokument/billeder/scope_1.png
