kj-schmidt/Perconditioning/Udviklingsdokumentation/Implementeringsdokument/billeder/scope_3.png

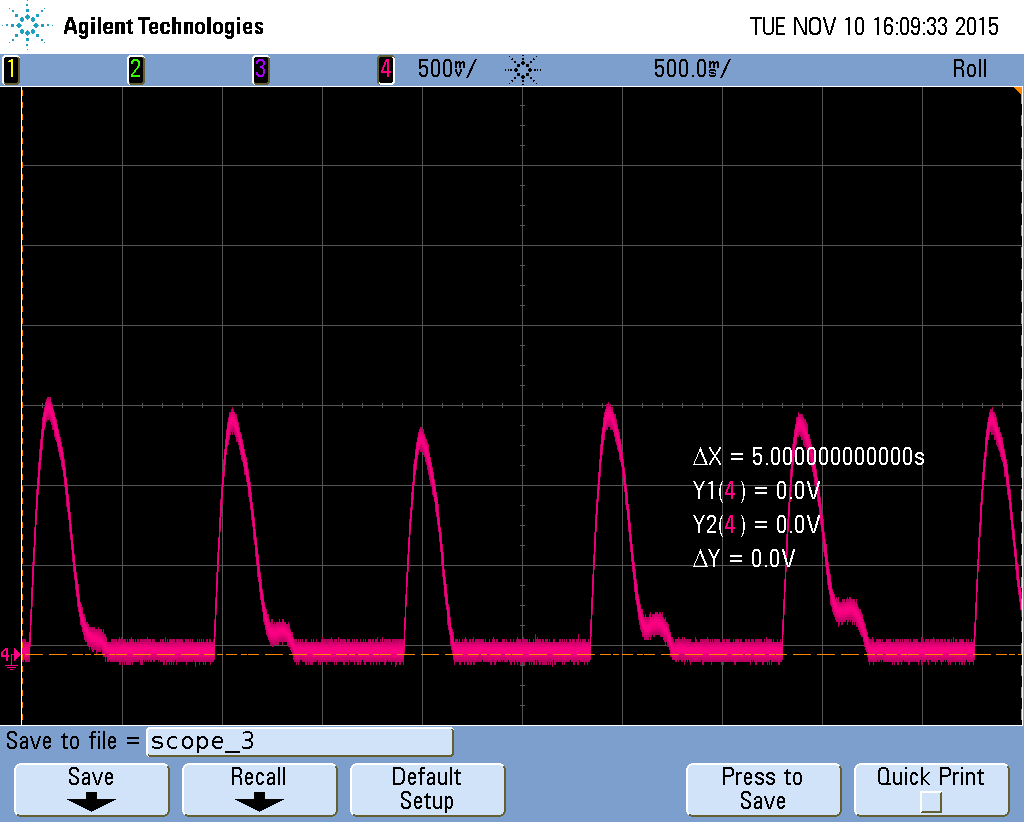
Udviklingsdokumentation/Implementeringsdokument/billeder/scope_3.png
