kj-schmidt/Perconditioning/Udviklingsdokumentation/Implementeringsdokument/billeder/scope_4.png

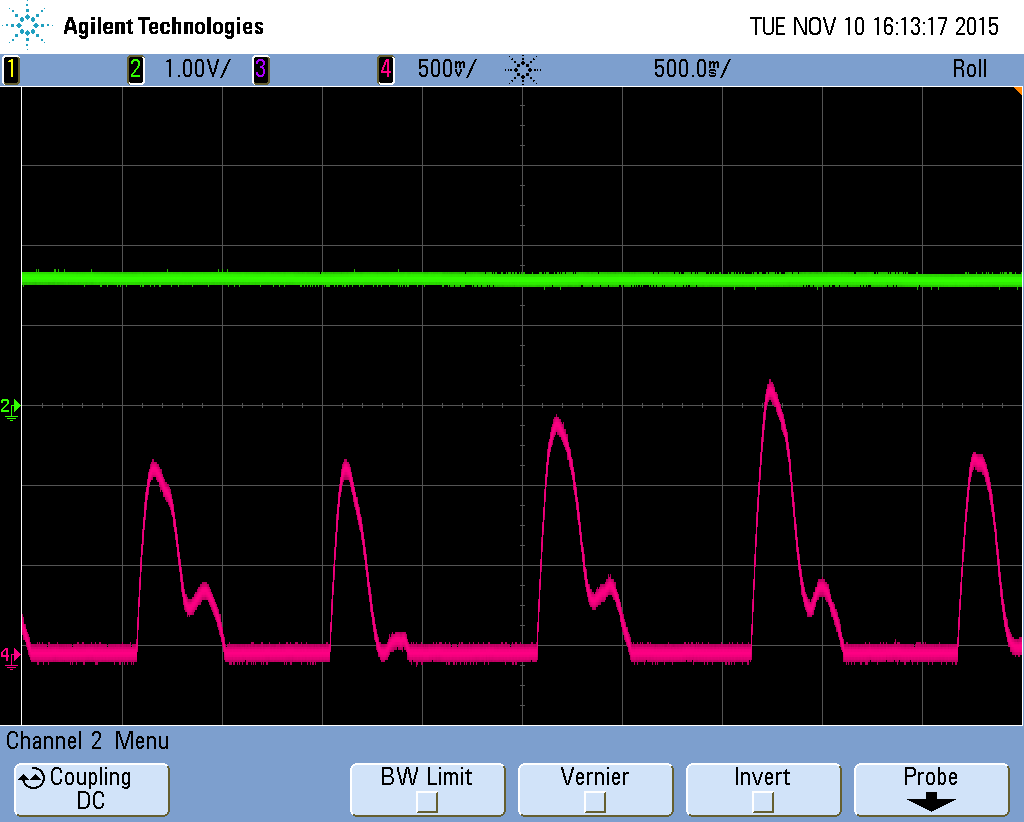
Udviklingsdokumentation/Implementeringsdokument/billeder/scope_4.png
