kj-schmidt/Perconditioning/Udviklingsdokumentation/Implementeringsdokument/billeder/scope_5.png

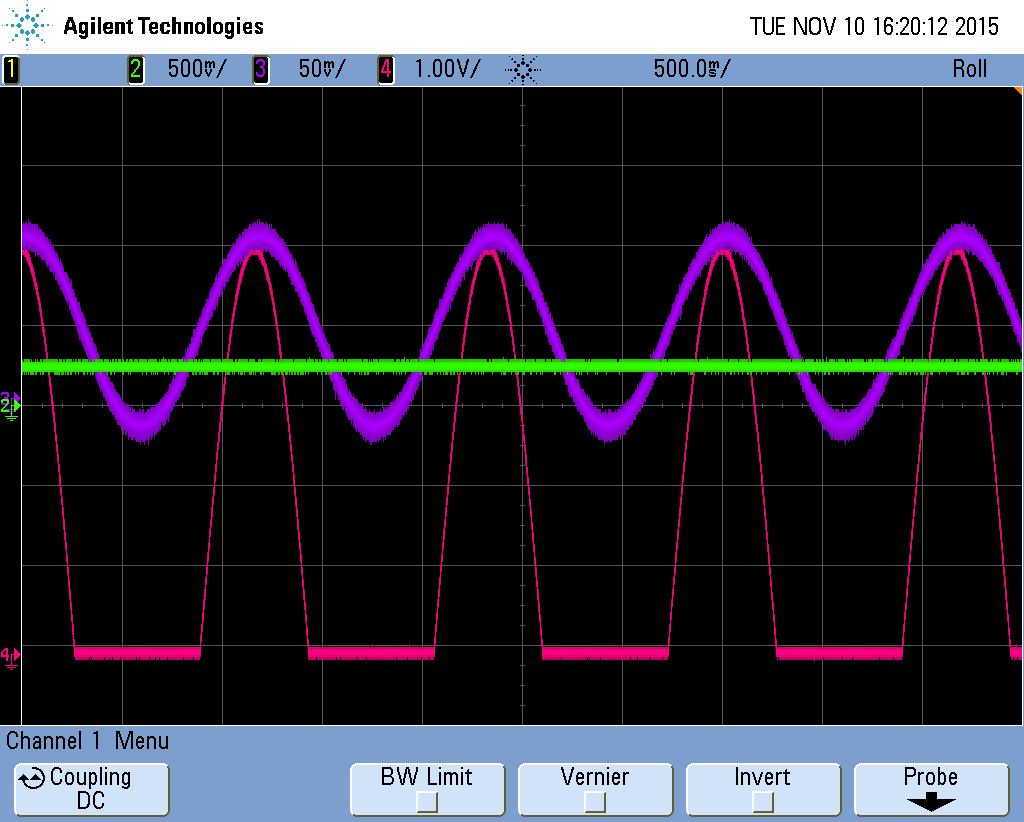
Udviklingsdokumentation/Implementeringsdokument/billeder/scope_5.png
