kj-schmidt/Perconditioning/Udviklingsdokumentation/Implementeringsdokument/billeder/scope_6.png

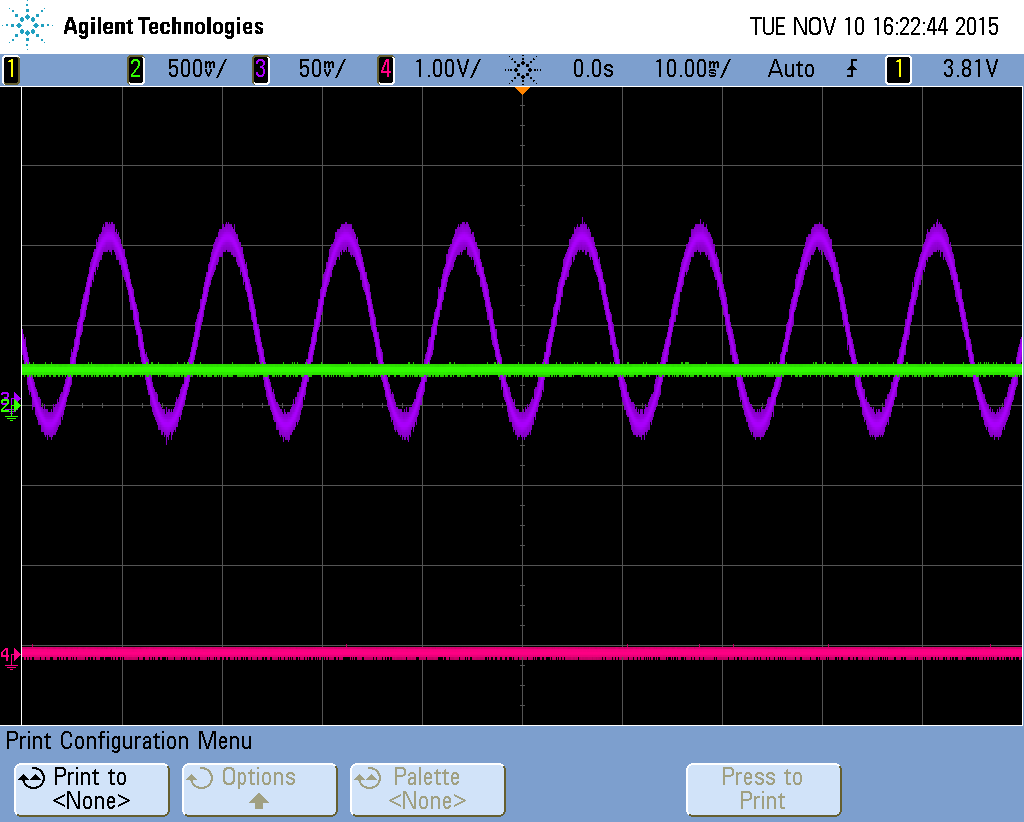
Udviklingsdokumentation/Implementeringsdokument/billeder/scope_6.png
