kj-schmidt/Perconditioning/Udviklingsdokumentation/Implementeringsdokument/billeder/scope_7.png

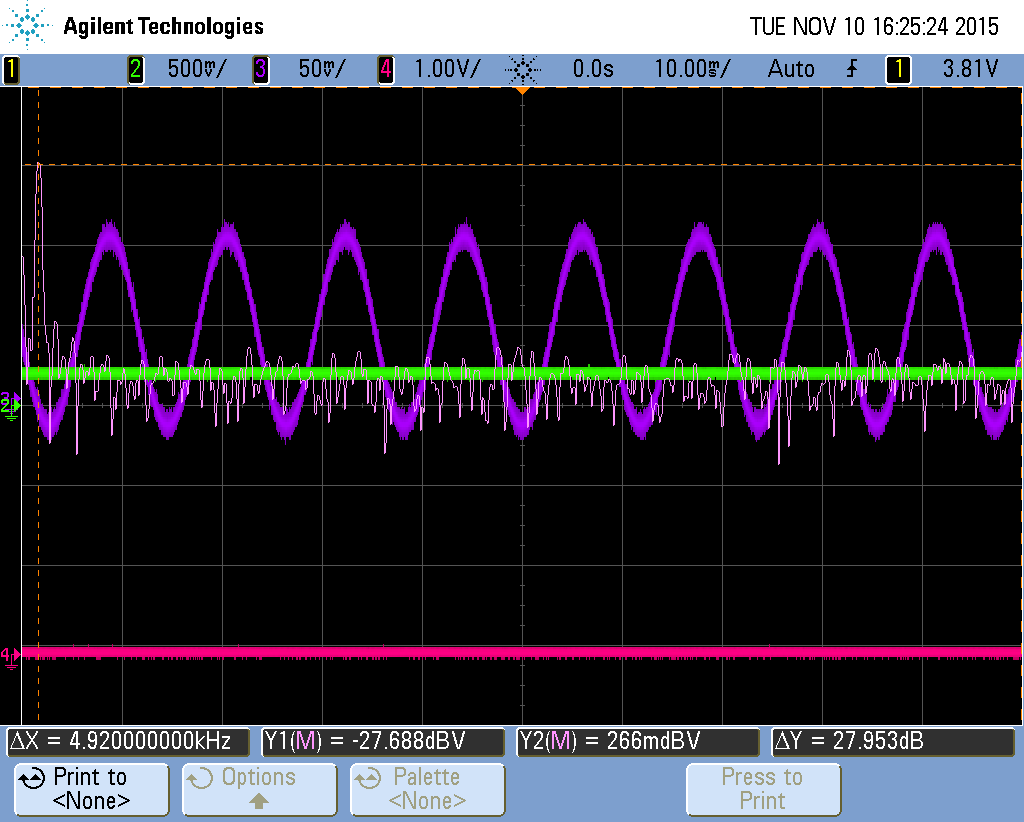
Udviklingsdokumentation/Implementeringsdokument/billeder/scope_7.png
