kj-schmidt/Perconditioning/Udviklingsdokumentation/Kravspecifikation/SysML/BD.png

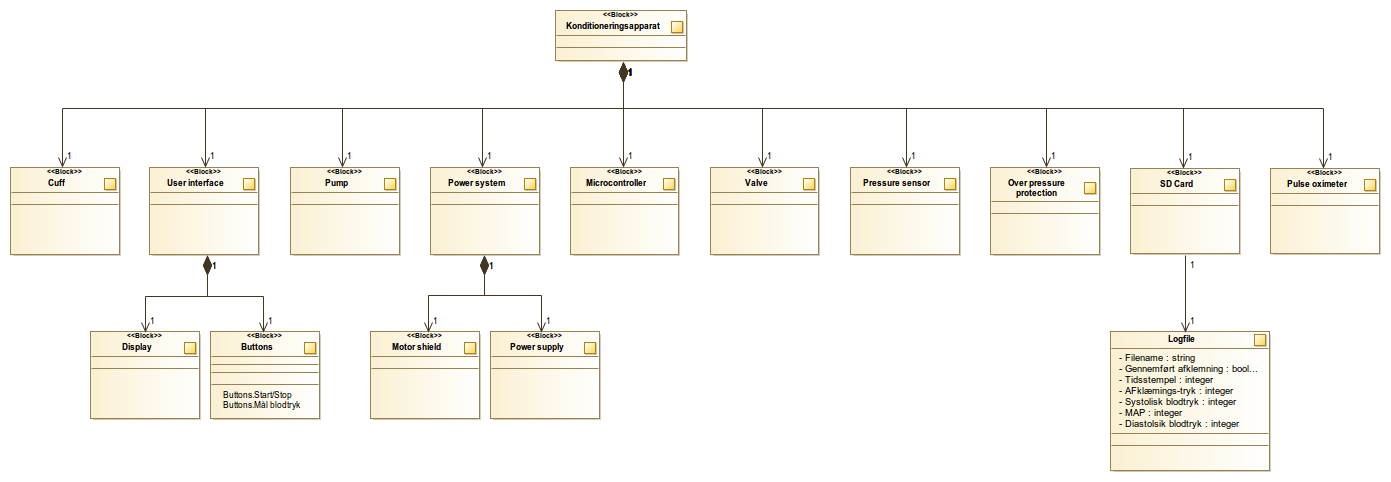
Udviklingsdokumentation/Kravspecifikation/SysML/BD.png
