kj-schmidt/Perconditioning/Udviklingsdokumentation/Kravspecifikation/SysML/FlowChart UC1.png

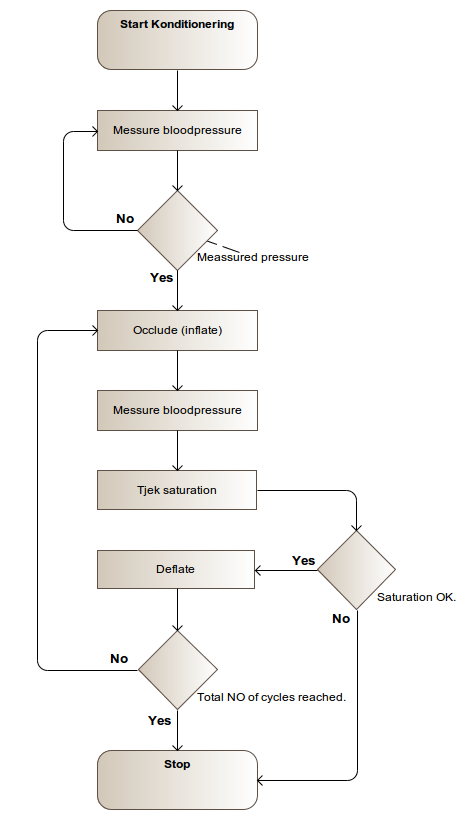
Udviklingsdokumentation/Kravspecifikation/SysML/FlowChart UC1.png
