kj-schmidt/Perconditioning/Udviklingsdokumentation/Kravspecifikation/SysML/SD (UC1).png

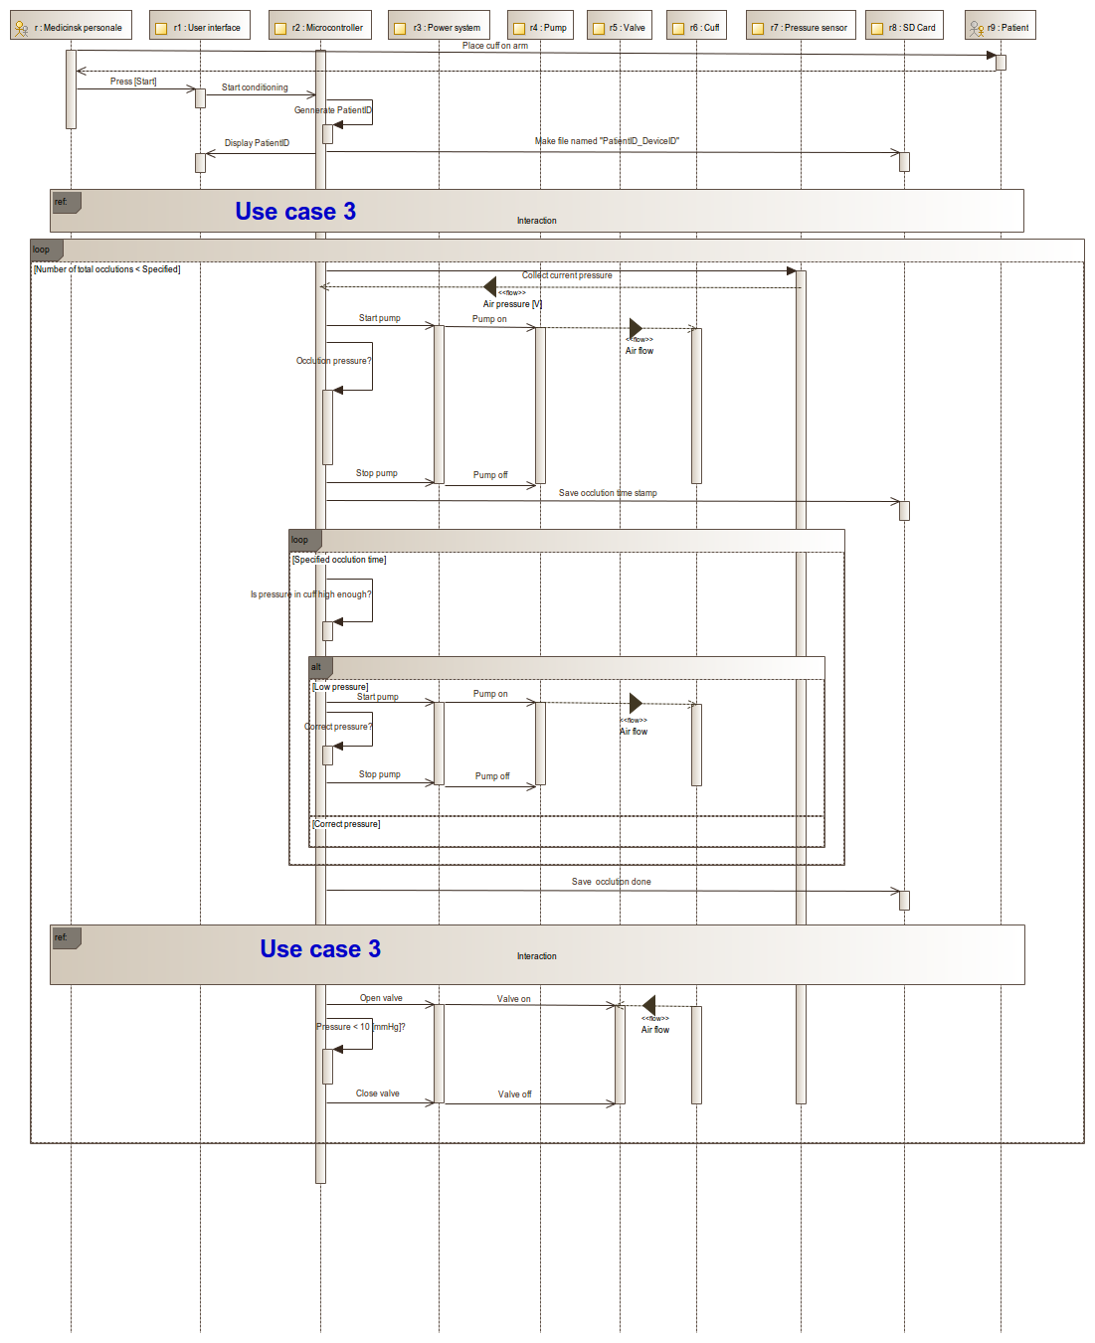
Udviklingsdokumentation/Kravspecifikation/SysML/SD (UC1).png
