kj-schmidt/Perconditioning/Udviklingsdokumentation/Kravspecifikation/SysML/SD (UC2).png

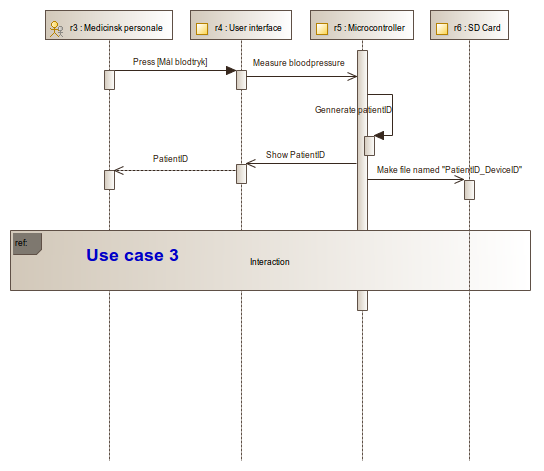
Udviklingsdokumentation/Kravspecifikation/SysML/SD (UC2).png
