kj-schmidt/Perconditioning/Udviklingsdokumentation/Kravspecifikation/SysML/SD (UC4).png

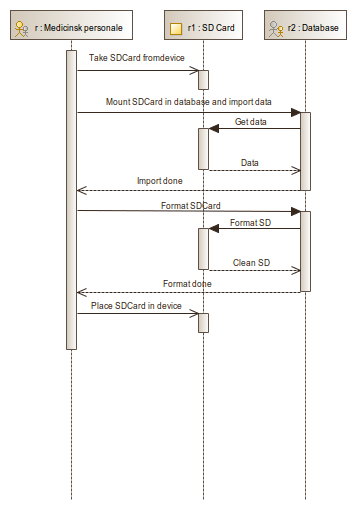
Udviklingsdokumentation/Kravspecifikation/SysML/SD (UC4).png
