kj-schmidt/Perconditioning/Udviklingsdokumentation/Kravspecifikation/SysML/SD (UC6).png

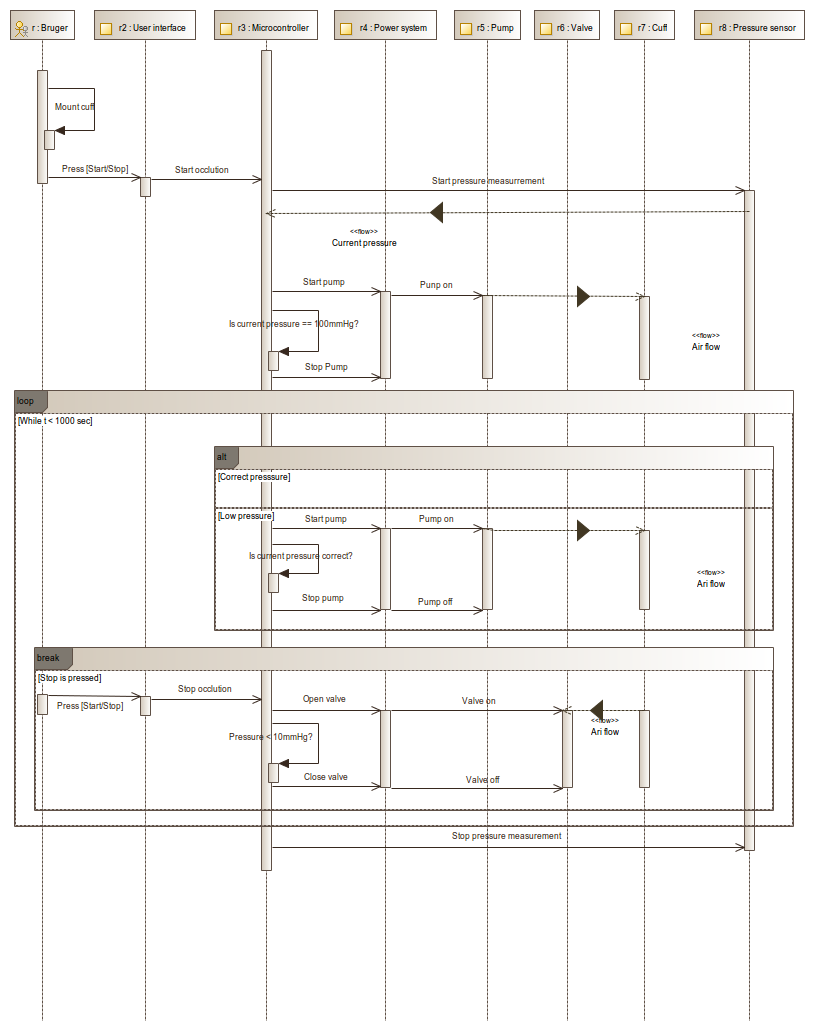
Udviklingsdokumentation/Kravspecifikation/SysML/SD (UC6).png
