kj-schmidt/Perconditioning/Udviklingsdokumentation/Kravspecifikation/SysML/SD (UC8).png

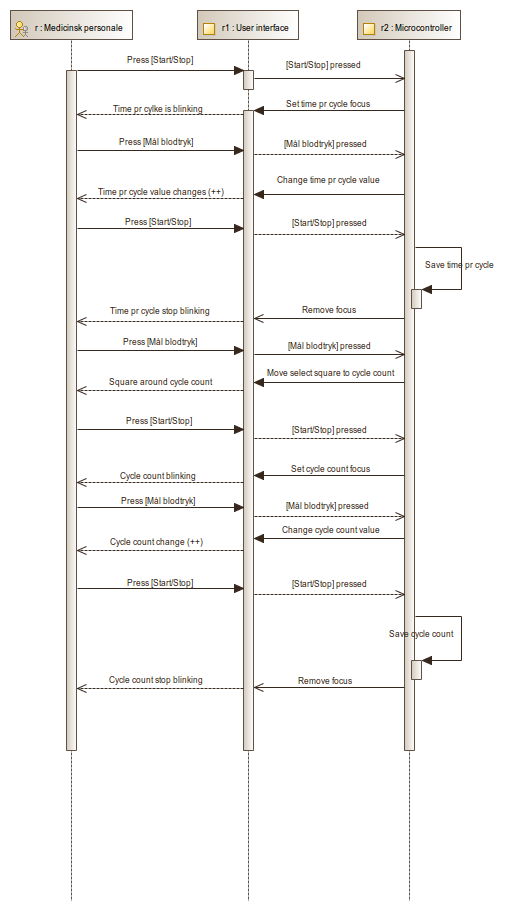
Udviklingsdokumentation/Kravspecifikation/SysML/SD (UC8).png
