kj-schmidt/Perconditioning/Udviklingsdokumentation/Kravspecifikation/SysML/State diagram (Main programs) .png

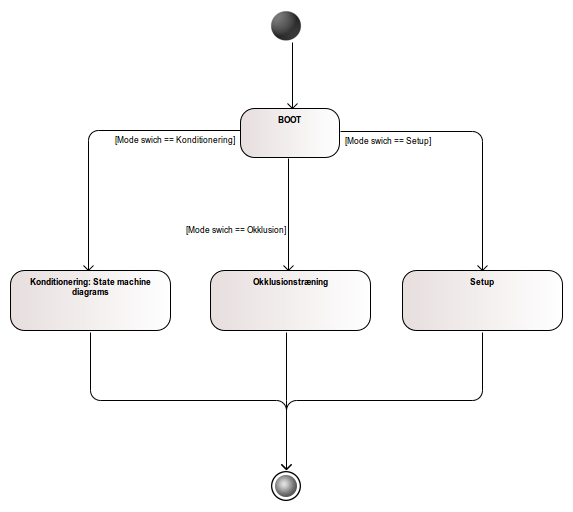
Udviklingsdokumentation/Kravspecifikation/SysML/State diagram (Main programs) .png
