kj-schmidt/Perconditioning/Udviklingsdokumentation/Kravspecifikation/SysML/State diagram (Okklutionstræning).png

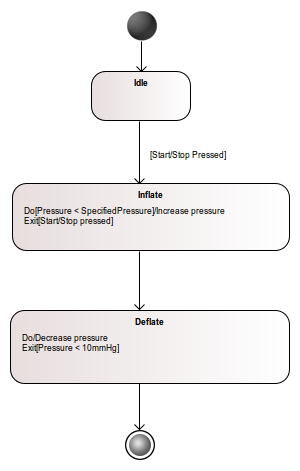
Udviklingsdokumentation/Kravspecifikation/SysML/State diagram (Okklutionstræning).png
