kj-schmidt/Perconditioning/Udviklingsdokumentation/Kravspecifikation/SysML/State diagram Konditionering 1.png

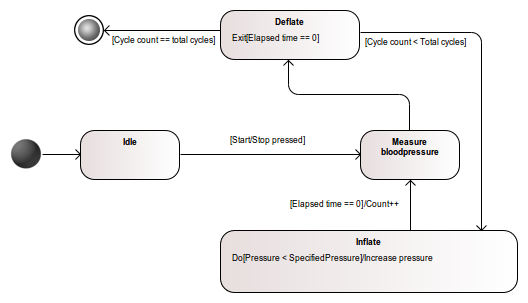
Udviklingsdokumentation/Kravspecifikation/SysML/State diagram Konditionering 1.png
