kj-schmidt/Perconditioning/Udviklingsdokumentation/SystemArkitektur/pdfs/InternalBlockdiagram(Hardware).png

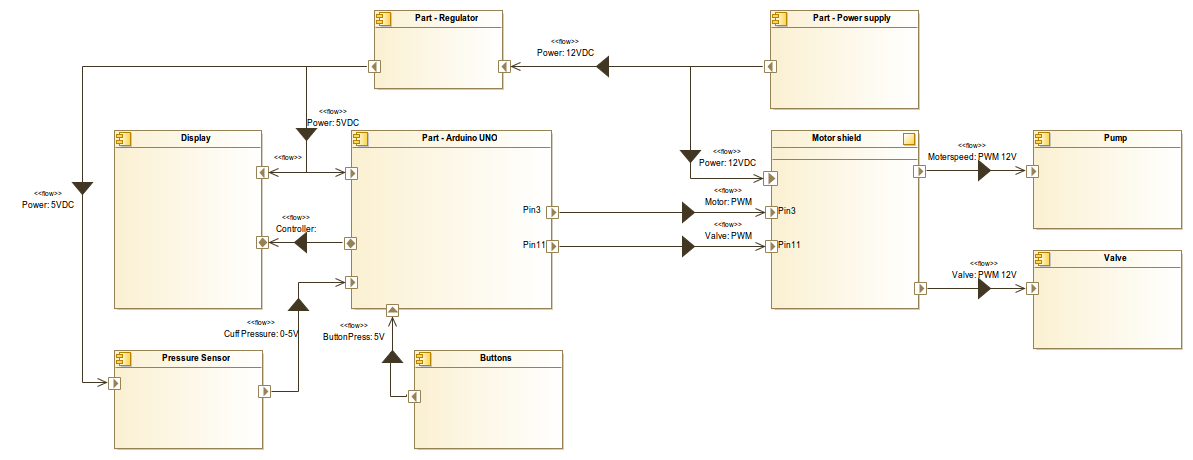
Udviklingsdokumentation/SystemArkitektur/pdfs/InternalBlockdiagram(Hardware).png
