kj-schmidt/Perconditioning/Udviklingsdokumentation/SystemArkitektur/pdfs/STD(Setup).pdf

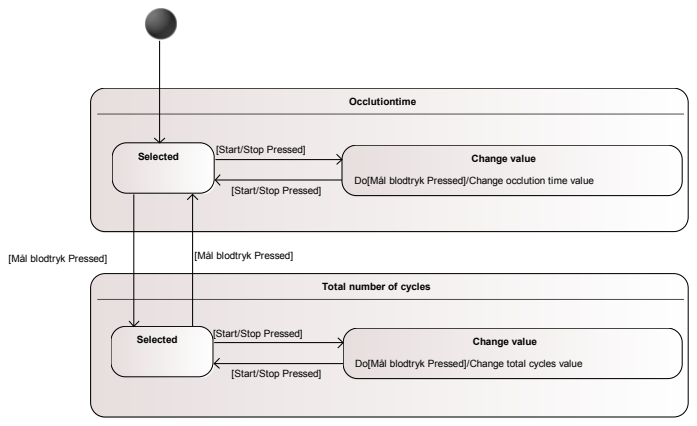
[picture p169: figure]
Occlutiontime; Selected; Change value; Total number of cycles; [Start/Stop Pressed]; [Mål blodtryk Pressed]

Do[Mål blodtryk Pressed]/Change occlution time value

Do[Mål blodtryk Pressed]/Change total cycles value
