kj-schmidt/Perconditioning/Rapport/Rapport/billeder/display/setup.png

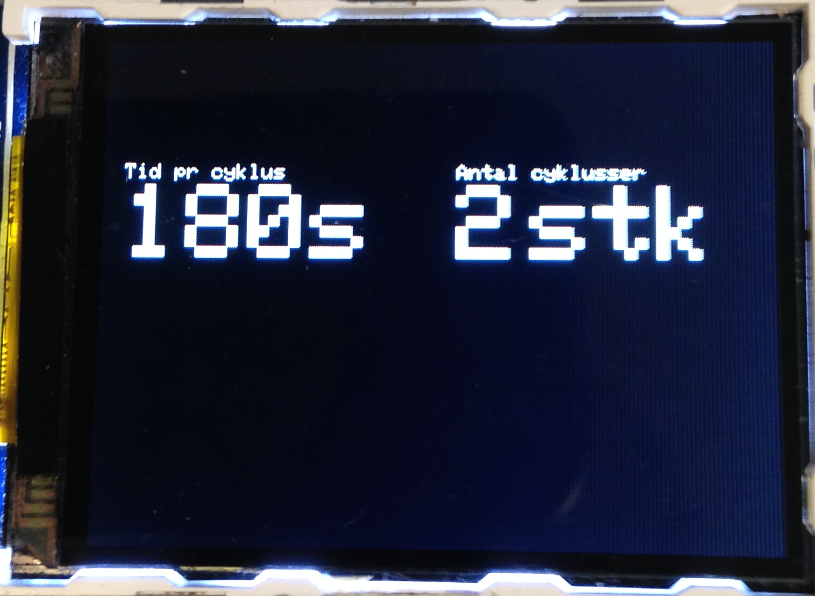
Rapport/Rapport/billeder/display/setup.png
