kj-schmidt/Perconditioning/Udviklingsdokumentation/Kravspecifikation/SysML/State diagram (Setup).png

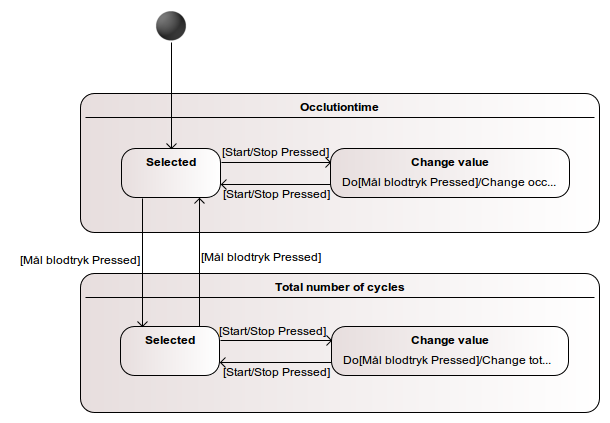
Udviklingsdokumentation/Kravspecifikation/SysML/State diagram (Setup).png
