kj-schmidt/Perconditioning/Rapport/Rapport/kontekst/Resultater_oscillometrisk.tex

\section{Konditioneringsapparat}
\textit{Konditioneringsapparatet} er opbygget af flere blokke, som kan ses på figur \ref{fig:BDD(SystemOverview)}. Block Definition diagrammer beskriver relationerne mellem blokke, såsom sammenhæng, forening og specialisering. I denne sammenhæng beskriver figur \ref{fig:BDD(SystemOverview)} opbygningen af konditioneringsapparatet. 
\begin{figure}[H]
	\centering
	
	\caption{Block definition diagram over \textit{konditioneringsapparatet}.}\label{fig:BDD(SystemOverview)}
\end{figure}

\subsection{Oscilumetrisk blodtryksapparat}
Den oscillometriske blodtryksmålemetode, beskrevet i afsnit \ref{noninvasivBloodpressureMeasurement}, er implementeret, og resultaterne er beskrevet i dette afsnit (Se beskrivelse i implementeringen under udviklingsdokumentationen).

Det pulserende signal fra tryksensoren, som blodtryksmåleren analyserer, er i sin rå (ubehandlet) tilstand støjfyldt. Signalet beskrevet i baggrundsafsnittet \ref{noninvasivBloodpressureMeasurement} på figur \ref{fig:OscillometriskMetode} er meget støjfri, og amplituderne danner en flot parabelformet kurve. På figur \ref{fig:rawPulseSignal} ses det pulserende signal direkte fra tryksensoren, som er indhyldet i støj. Kurven er støt faldende, fordi trykket i manchetten langsomt lukkes ud. Ydermere observeres der også varierende amplitudehøjder, som ikke er støt stigende/faldende, men virker som tilfældigheder.  

\begin{figure}[H]
	\centering
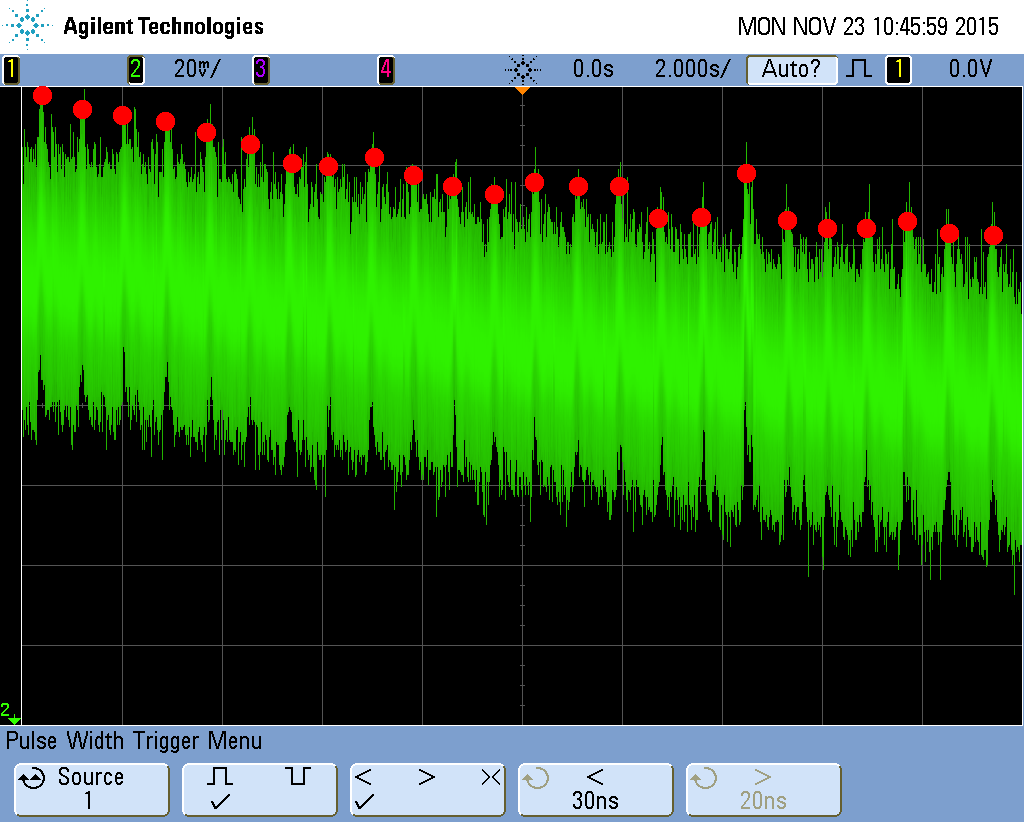
[picture p172: Rapport/Rapport/billeder/rawPulseSignalPeaks.png]
	
	\caption{Oscilloskops måling af rå signal fra blodtryksmåling med \textit{konditioneringsapparatet}. De røde cirkler er puls oscillationernes højeste punkt}\label{fig:rawPulseSignal}
\end{figure}

Efter analog filtrering af det rå signal på en blodtryksmåling med konditioneringsapparatet ses amplitude oscillationerne isoleret og uden manchettrykket (offset). Over en hel blodtryksmåling skal kurven ifølge teorien (se figur \ref{fig:OscillometriskMetode}) starte med en stigende amplitudehøjde efterfulgt af en top og til sidst faldende oscillationshøjder med laverer hældningskoefficient end starten. En hel blodtryksmåling med filtreret råsignal kan ses på figur \ref{fig:filteredPulseSignal}.

\begin{figure}[H]
	\centering
	\subbottom[Stigende]{%
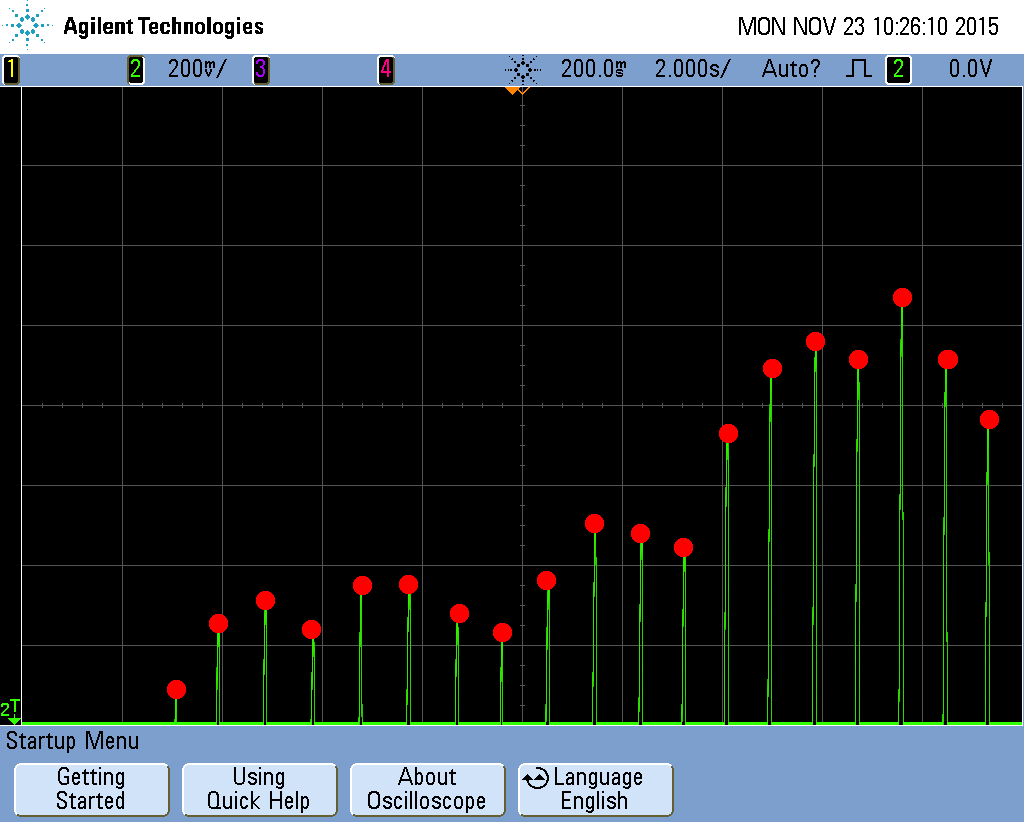
[picture p173: Rapport/Rapport/billeder/filteredPulseSignalPeaks1.png]
		}
	\subbottom[Højdepunkt]{%
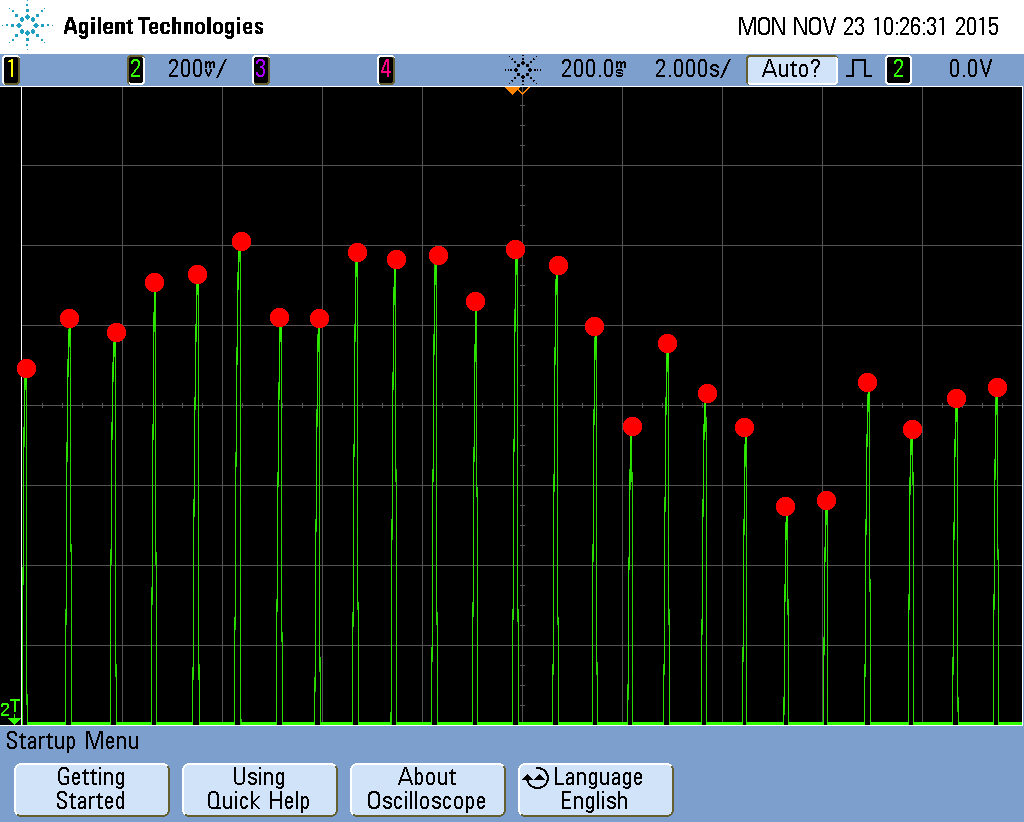
[picture p174: Rapport/Rapport/billeder/filteredPulseSignalPeaks2.png]
		}
	\subbottom[Faldende]{%
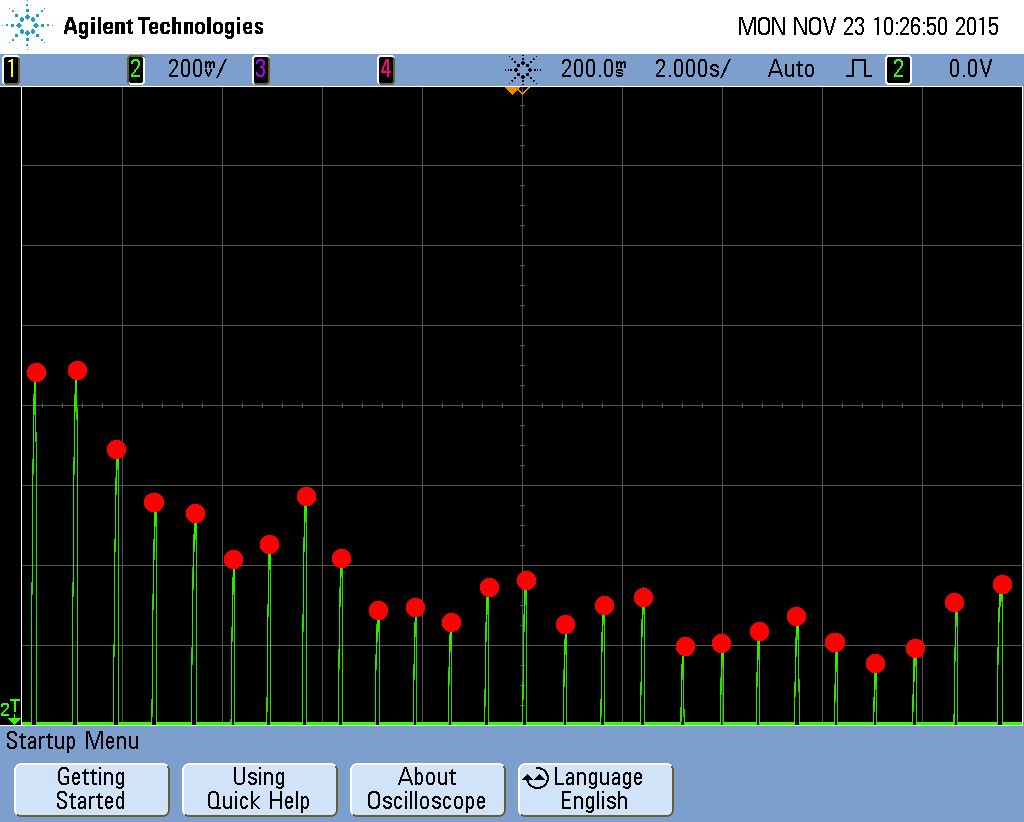
[picture p175: Rapport/Rapport/billeder/filteredPulseSignalPeaks3.png]
		}
	\caption{Oscilloskopsmålinger af filtreret signal fra en blodtryksmåling med \textit{konditioneringsapparatet}. (a) er første del af blodtryksmålingen, (b) er midten af signalet med, hvor MAP befinder sig, og (c) er slutningen af signalet, hvor amplituderne flader ud. De røde cirkler er puls oscillationernes højeste punkter}\label{fig:filteredPulseSignal}
\end{figure}

\subsubsection{Analog filtrering}
Den analoge filtrering, som ses ved forskellen mellem figur \ref{fig:rawPulseSignal} og figur \ref{fig:filteredPulseSignal}, er implementeret, (Se implementeringen under udviklingsdokumentations afsnit IV). 
Det resulterende analoge filter er bestemt ud fra testopsætninger og litteraturen (\cite{RefWorks:8}). De pulserende oscillationer isoleret fra det rå signal kan ses på figur \ref{fig:filteredPulseSignalWithFFT}. Resultatet er opnået ved at implementere et båndpas filter med et pasbånd, som starter før lavest mulige puls 13bpm, og slutter ved den tiende afledte af grundfrekvensen af 60bmp (se figur \ref*{fig:BandPassFilter}).

\begin{figure}[H]
	\centering
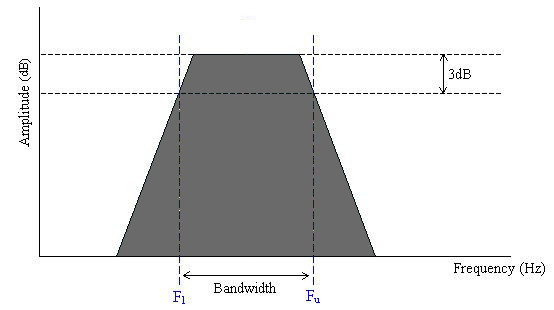
[picture p176: Rapport/Rapport/billeder/BandPass_filter.JPG]
	
	\caption{Båndpas filter med pasfilter mellem $F_1$ og $F_u$. $F_1=0.22Hz$ (13 bpm under mulig puls) og $F_u=11Hz$ (660 bpm tiende afledte af 60 bpm). Kilde: \cite{Billede:4} }\label{fig:BandPassFilter}
\end{figure}

\begin{figure}[H]
	\centering
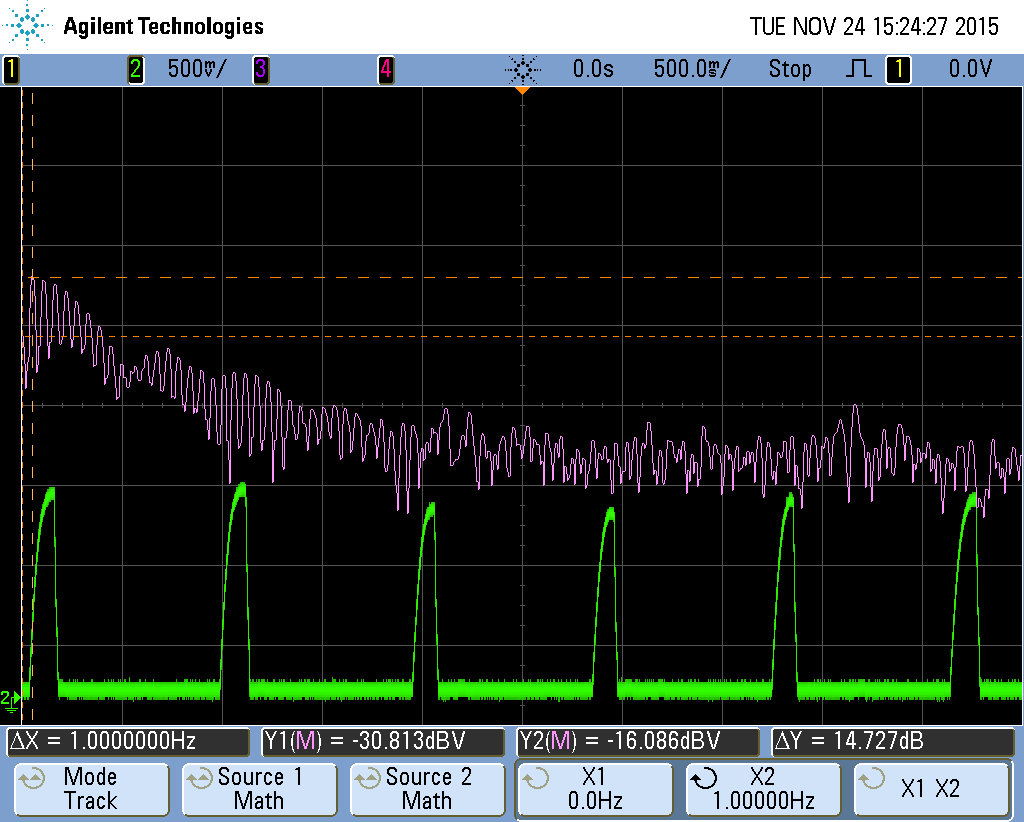
[picture p177: Rapport/Rapport/billeder/filteredPulseSignalWithFFT.png]
	
	\caption{Oscilloskopsmåling af filtreret signal fra manchetten. Den grønne kurve er de pulserende oscillationer, og den lilla kurve er en Fast Fourier Transformation (FFT) af den grønne kurve, hvor den udregnede grundfrekvens af oscillationerne måles til 1Hz (60 bpm).}\label{fig:filteredPulseSignalWithFFT}
\end{figure}

\subsubsection{Digital filtrering}
For at opnå en pæn parabel, som vist på  figur \ref{fig:OscillometriskMetode}, er der implementeret et digitalt filter, som har til opgave at udglatte oscillationsamplituderne fra blodtryksmålingerne. Resultatet af implementeringen kan ses på figur \ref{fig:digitalFilterData}. Det bedste forhold mellem udglatning og reaktionshastighed af filteret er opnået ved et ekspotentielt midlingsfilter (Se formel \ref{eq:ekspotentielmidlingsfilter}) med en alfa værdi på 0.15 (Se uddybende beskrivelse i implementeringen under udviklingsdokumentationen).  

\begin{equation}
y(n)=\alpha*x(n)+(1-\alpha)*y(n-1)
\label{eq:ekspotentielmidlingsfilter}
\end{equation}
\begin{figure}[H]
	\centering
		
	\parbox{10.5cm}{\caption{Digital filtrering af oscillotionspeaks fra blodtryksmåling på simulator med ekspotentiel midlingsfilter.}\label{fig:digitalFilterData}}
\end{figure}

\subsection{Fikseret-ratio} \label{Fikseret-ratio}
\textit{Konditioneringsapparatets} mest avancerede egenskab er uden tvivl estimering af blodtrykket. Apparatet anvender den oscillometriske metode, hvor det systoliske(SYS) og diastoliske(DIA) tryk  bestemmes ud fra MAP. Under udviklingen af konditioneringsapparatet blev det besluttet at anvende den fikserede-ratio metode for at forsimple udviklingsarbejdet.

Fikseret-ratio metoden anvender empirisk data til at bestemme hvor store oscillationerne i manchetten skal være i forhold til oscillationerne ved MAP for at identificere SYS og DIA. Dette betyder, at systolisk og diastolisk tryk er bestemt ved manchettrykket, når amplituden af oscillationerne er en ratio af den maksimale værdi, (\cite{drzewiecki1994theory}).

\begin{minipage}[c]{0.5\textwidth}
	Ratioværdierne til \textit{konditioneringsapparatet} kunne ikke bestemmes ud fra en større mængde empirisk data fra patienter på grund af projektets omfang. I stedet er empirisk data blevet indsamlet fra\textit{ Fluke biomedicalBP Pump 2} en oscillometrisk blodtrykssimulator (se figur \ref{fig:TheFlukeBiomedicalBPPump2L}). \textit{Konditioneringsapparatet} opsamlede data fra simulatoren, hvilket kan ses på figur \ref{fig:digitalFilterData} og \ref{fig:digitalFilterDataSysMapDia1}. Fordi simulatoren indstilles til kendte blodtryksværdier, kan de fikserede-ratiorer bestemmes ud fra oscillationsamplituden (OA) ved et givent manchettryk. Fx ved simulering af 120/80 skal oscillations amplituden ved manchettrykket 120mmHg aflæses, og forholdet mellem MAP og denne aflæste værdi er den systoliske ratio.

\end{minipage}
\begin{minipage}[c]{0.5\textwidth}
	\begin{figure}[H]
		\centering
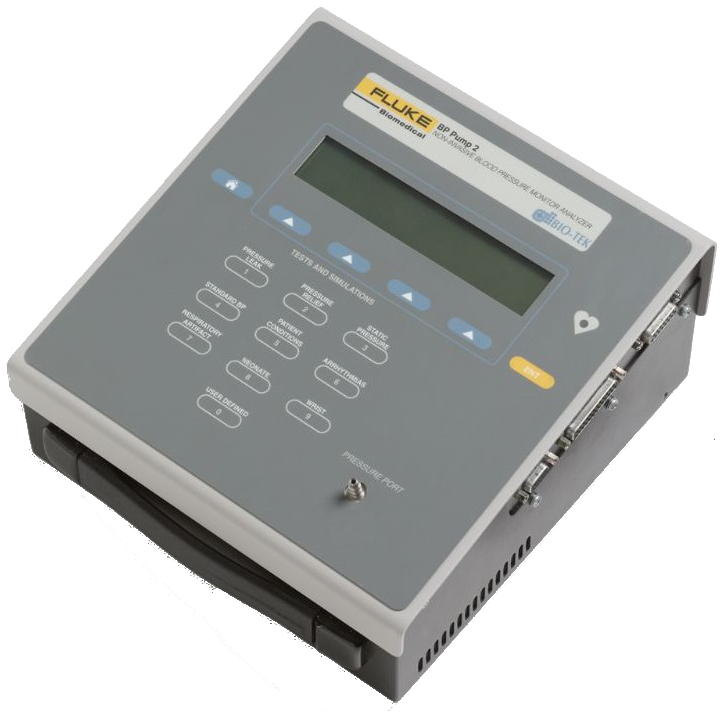
[picture p178: Rapport/Rapport/billeder/TheFlukeBiomedicalBPPump2L.png]
			
		\parbox{7cm}{\caption{Fluke Biomedical BP Pump 2 Non-invasiv blodtrykssimulator}\label{fig:TheFlukeBiomedicalBPPump2L}}
	\end{figure}
\end{minipage}

Resultatet af simulationerne kan ses på figur \ref{fig:digitalFilterDataSysMapDia1} uden manchettrykket og med manchettrykket på figur \ref{fig:digitalFilterDataSysMapDia2}. Ratioen for SYS (Se formel \ref{eq:sysratio}) blev udregnet til 0.38 og for DIA (Se formel \ref{eq:sysratio}) til 0.48, (Se kalibreringstest under afsnit \ref{app:kalibreringstest}). 
	\begin{equation}
	SYS_{OA}=MAP_{OA}*0.38
	\label{eq:sysratio}
	\end{equation}
	\begin{equation}
	DIA_{OA}=MAP_{OA}*0.48
	\label{eq:diaratio}
	\end{equation}

\begin{figure}[H]
	\centering
	\subbottom[Simulationsdata uden manchettryk]{\label{fig:digitalFilterDataSysMapDia1}%
		}
	\subbottom[Simulationsdata med manchettryk]{\label{fig:digitalFilterDataSysMapDia2}%
		}
	\caption{Digital filtrering af oscillationsamplituderne fra blodtryksmåling på simulator med ekspotentiel midlingsfilter. De røde prikker er placeret  hvor SYS, MAP og DIA befinder sig ved fikseret-ratio på 0.38(SYS) og 0.48(DIA).}
\end{figure}
