kj-schmidt/Perconditioning/Rapport/Rapport/appendiks/PulsoximeterTest.tex

\section{Test med pulsoximeter} \label{app:pulstest}

Test resultater ved aklemning af arm ved 220 mmHg sammenholdt med pulsoximeter
\begin{longtable}{p{0.14\textwidth} p{0.14\textwidth} p{0.14\textwidth} p{0.14\textwidth} }
	\hline
	Tid [s] & Saturation [\%] & Puls [bpm] & Tryk [mmHg] \\ \hline
	0 &	100 &	54 &	0 \\ \hline
	30 &	100 &	48 &	220 \\ \hline
	60 &	100 &	41 &	220 \\ \hline
	90 &	100	& 45  &	220 \\ \hline
	120	& 0	& 0	& 220 \\ \hline
	150 &	100 &	52 &	220 \\ \hline
	180	& 0 &	0 &	220 \\ \hline
	210	& 0	 & 0 &	220 \\ \hline
	240 &	0 &	0 &	220 \\ \hline
	270 &	0 &	0 &	220 \\ \hline
	300 &	0 &	0 &	220 \\ \hline
	310 &	91 &	64 &	0 \\ \hline
	320 &	100 &	60 &	0 \\ \hline
	330 &	100 &	57 &	0 \\ \hline
	600 &	98 &	56 &	0 \\ \hline
	630 &	100 &	52 &	220 \\ \hline
	660 &	100 &	52 &	220 \\ \hline
	690 &	100 &	46 &	220 \\ \hline
	720 &	100 &	50 &	220 \\ \hline
	750	 & 100 &	42 &	220 \\ \hline
	780 &	0 &	0 &	220 \\ \hline
	810 &	0 &	0 &	220 \\ \hline
	840 &	0 &	0 &	220 \\ \hline
	870 &	0 &	0 &	220 \\ \hline
	900 &	0 &	0 &	220 \\ \hline
	910 &	0 &	0 &	0 \\ \hline
	920 &	100 &	61 &	0 \\ \hline
	920 &	96 &	60 &	0 \\ \hline
\end{longtable}
