kj-schmidt/Perconditioning/Rapport/Rapport/billeder/systemDrawing-crop.pdf

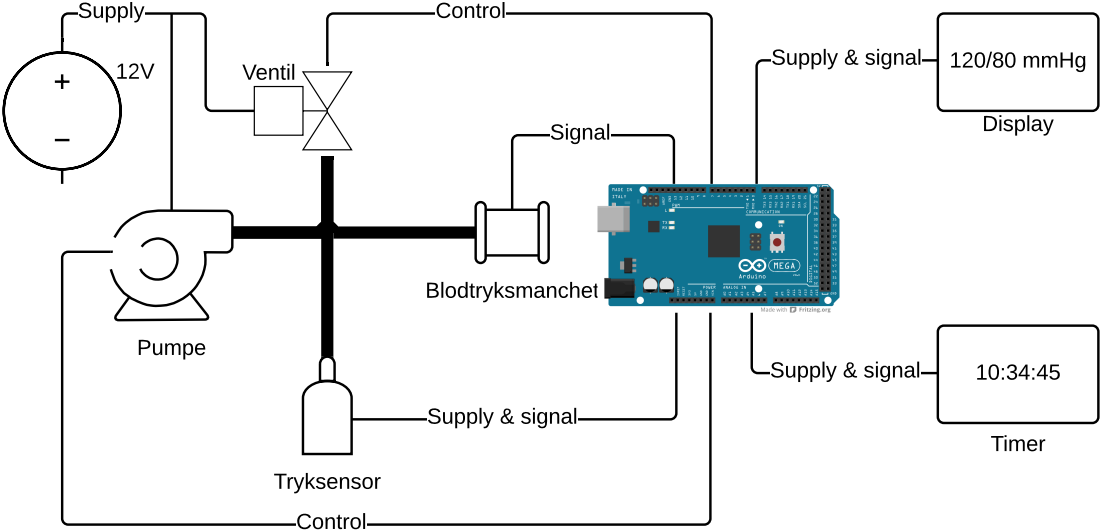
[picture p181: page 1]
Tryksensor; Blodtryksmanchet; Pumpe; Ventil; Control; Supply & signal; Signal; Supply; 120/80 mmHg; Display; Timer
