kj-schmidt/Perconditioning/Rapport/Rapport/billeder/digitalFilterDataCuffSysMapDia.pdf

B

l

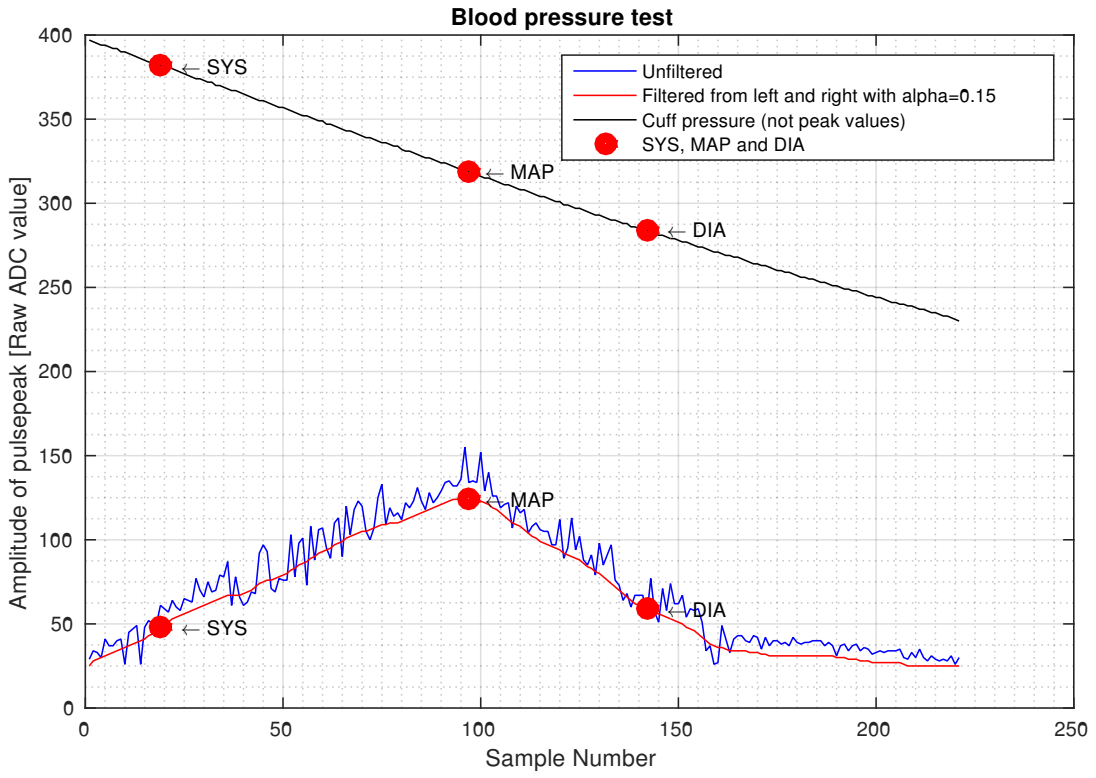
[picture p183: page 1]
ple; DIA

A | S | Y S | U | n filt | e | r e d

Filt | e | r e d | f | r o m le | f | t a | n d | rig | h | t wit | h | alp | h | a = | 0 . | 1 5
C | u f f | p r | e s | s u | r e | ( n | o t | p e | a k | v | alu | e s | )
S | Y S | , M | A | P | a n | d | DIA

Amplitude of pulsepeak [Raw ADC value]

A | DIA
