kj-schmidt/Perconditioning/Rapport/Rapport/billeder/digitalFilterDataCuffSysMapDia_backup.pdf

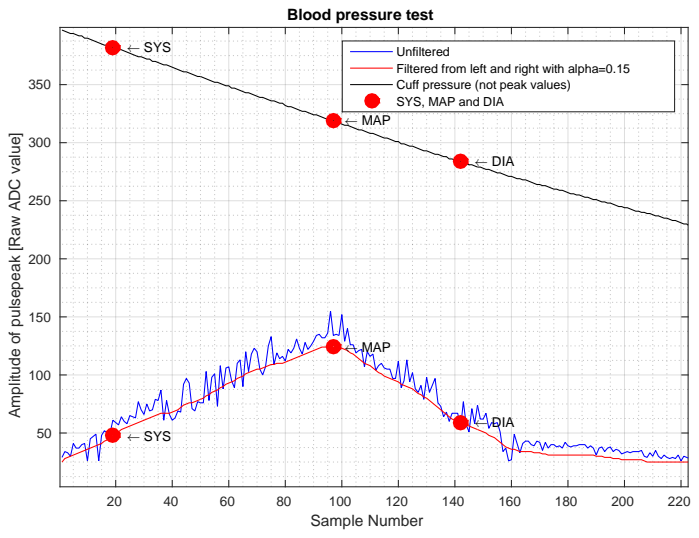
[picture p184: page 1]
Sample Number; A SYS; A MAP; A DIA

Blood pressure test

A SYS | | Unfiltered

Filtered from left and right with alpha=0.15

Cuff pressure (not peak values)

SYS, MAP and DIA

A MAP

Amplitude of pulsepeak [Raw ADC value]
