kj-schmidt/Perconditioning/Rapport/Rapport/billeder/digitalFilterDataSysMapDia_backup.pdf

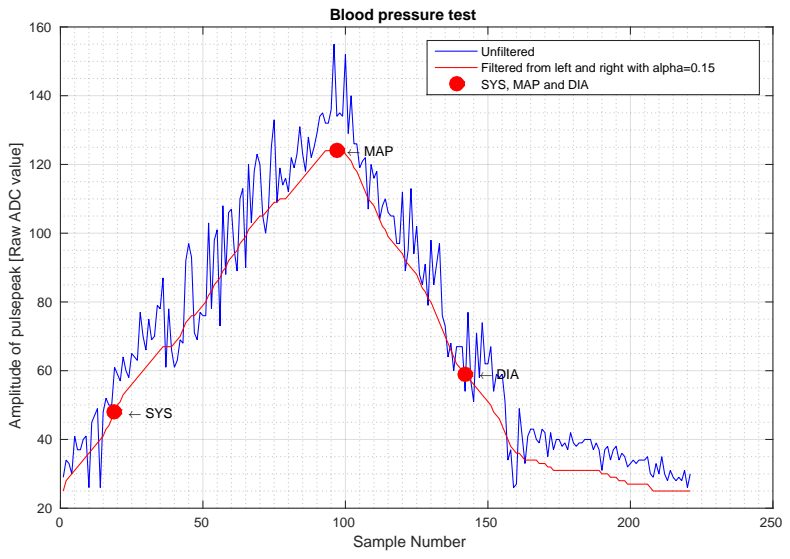
[picture p185: page 1]
Sample Number; A SYS; A MAP; A DIA

Blood pressure test

Unfiltered
Filtered from left and right with alpha=0.15
SYS, MAP and DIA

Amplitude of pulsepeak [Raw ADC value]
