kj-schmidt/Perconditioning/Rapport/Rapport/billeder/Konditioneringsmekanismer.pdf

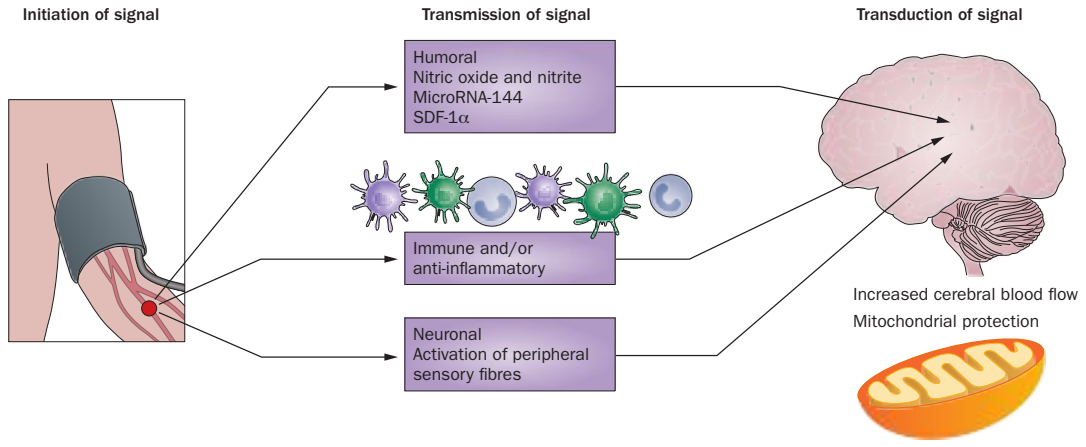
[picture p186: page 1]
Initiation of signal; Transmission of signal; Transduction of signal

Humoral
Nitric oxide and nitrite
MicroRNA-144
SDF-1α

Immune and/or
anti-infammatory

Increased cerebral blood fow
Mitochondrial protection

Neuronal
Activation of peripheral
sensory fbres
