kj-schmidt/Perconditioning/Rapport/Rapport/billeder/digitalFilterData_backup.pdf

### Blood pressure test

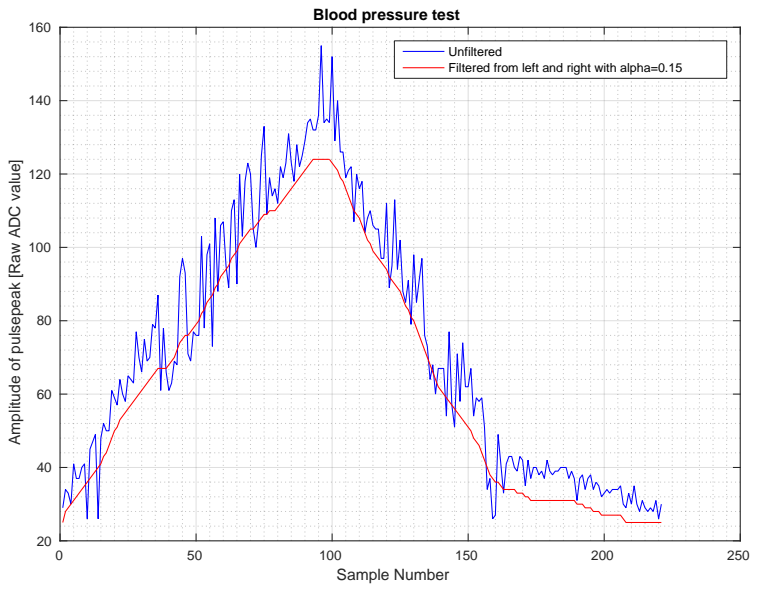
[picture p187: page 1]
Sample Number

Unfiltered
Filtered from left and right with alpha=0.15

Amplitude of pulsepeak [Raw ADC value]
