kj-schmidt/Perconditioning/Udviklingsdokumentation/SystemArkitektur/pdfs/SD_UC1-crop.pdf

# Use case 3

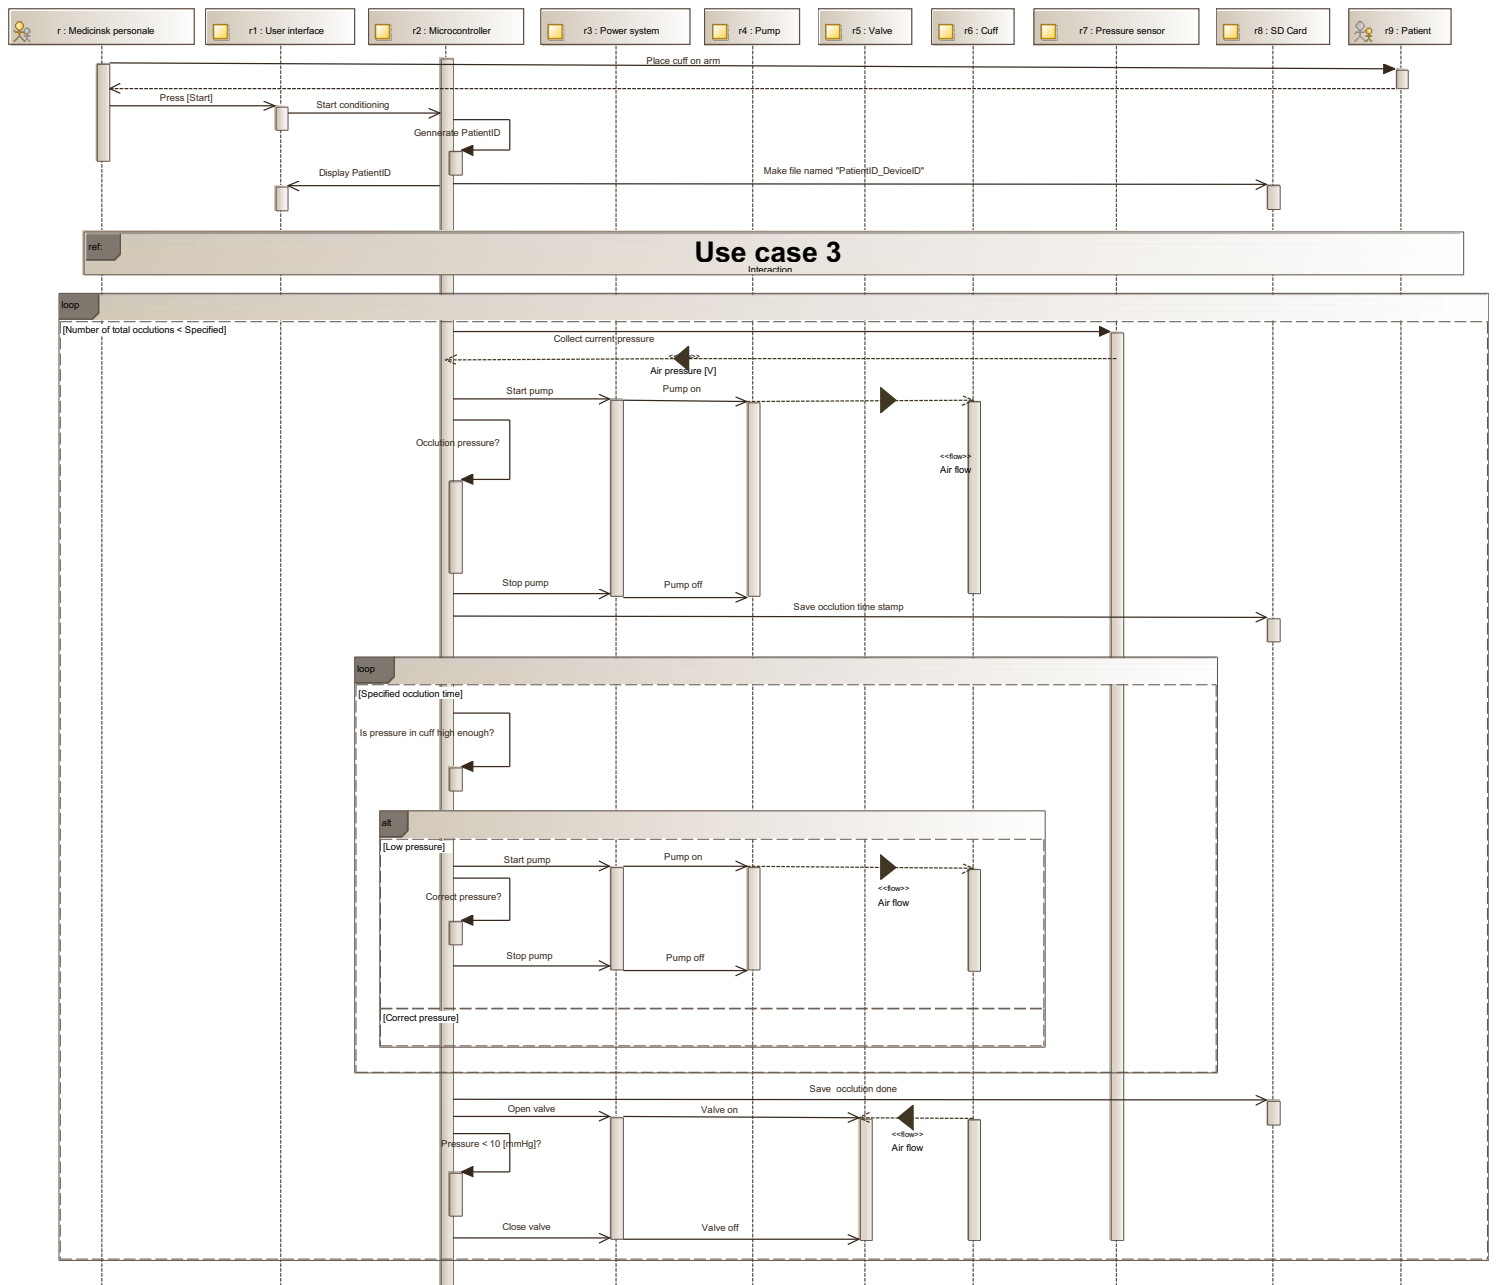
[picture p188: page 1]
r : Medicinsk personale; r1 : User interface; r2 : Microcontroller; r3 : Power system; r4 : Pump; r5 : Valve; r6 : Cuff; r7 : Pressure sensor; r8 : SD Card; r9 : Patient; ref:; Interaction; [Correct pressure]; Press [Start]; Start conditioning; Display PatientID; Gennerate PatientID; Occlution pressure?; Correct pressure?; Pressure < 10 [mmHg]?; <<flow>> Air flow

Place cuff on arm

Make file named "PatientID_DeviceID"

loop

[Number of total occlutions < Specified]

Collect current pressure | <<flow>>

Start pump | Air pressure [V] Pump on

Stop pump | Pump off | Save occlution time stamp

[Specified occlution time]

Is pressure in cuff high enough?

alt

[Low pressure] | Start pump | Pump on

Stop pump | Pump off

Save occlution done

Open valve | Valve on

Close valve | Valve off
