kj-schmidt/Perconditioning/Udviklingsdokumentation/Implementeringsdokument/billeder/Alpha015-crop.pdf

### Blood pressure test

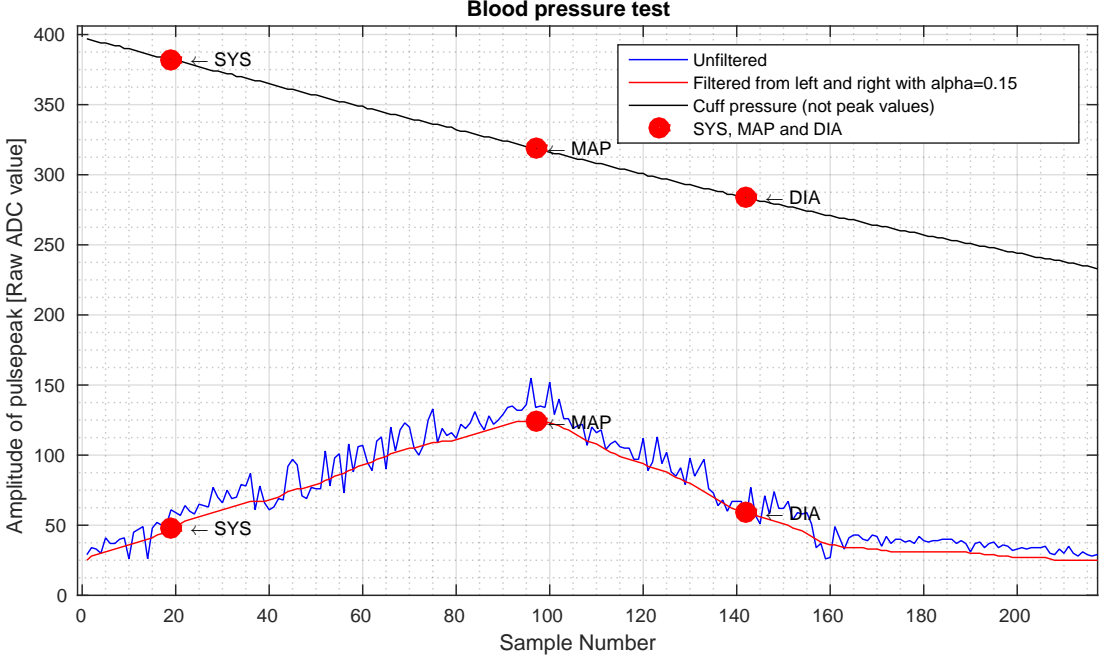
[picture p189: page 1]
Sample Number; A SYS; A MAP; A DIA

A SYS | | Unfiltered

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

Amplitude of pulsepeak [Raw ADC value]

A MAP
