kj-schmidt/Perconditioning/Udviklingsdokumentation/SystemArkitektur/pdfs/SD(UC1).pdf

# Use case 3

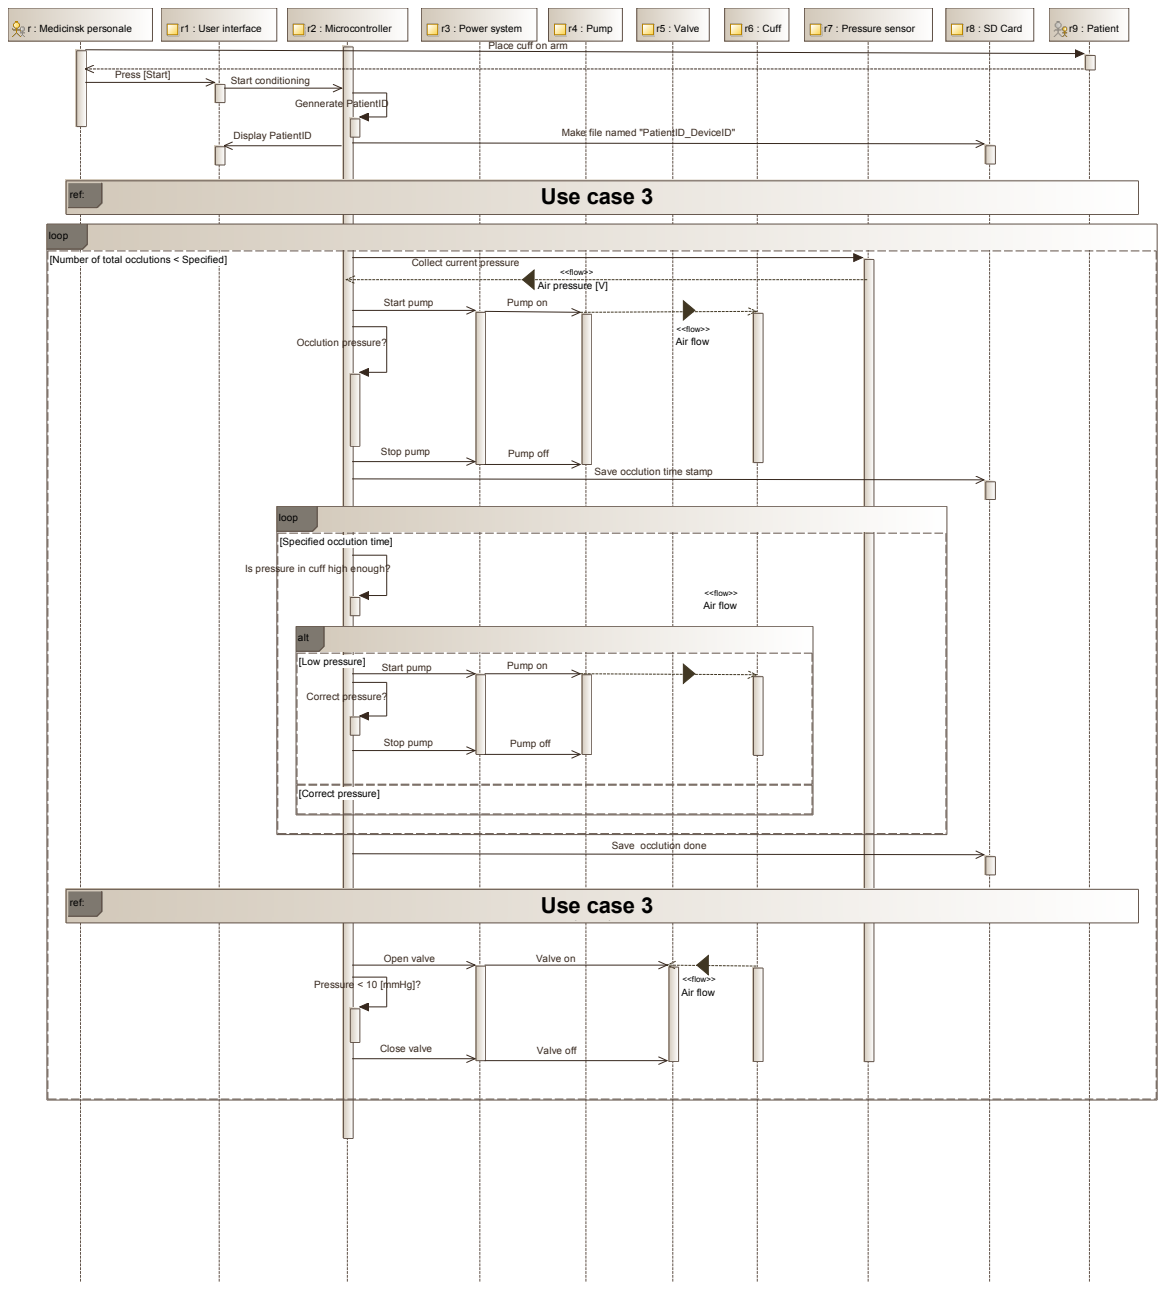
[picture p190: page 1]
r : Medicinsk personale; r1 : User interface; r2 : Microcontroller; r3 : Power system; r4 : Pump; r5 : Valve; r6 : Cuff; r7 : Pressure sensor; r8 : SD Card; r9 : Patient; ref:; loop; [Correct pressure]; Press [Start]; Start conditioning; Gennerate PatientID; Display PatientID; Make file named "PatientID_DeviceID"; <<flow>> Air flow; Occlution pressure?; Correct pressure?; <<flow>>

Place cuff on arm

[Number of total occlutions < Specified]

Collect current pressure | <<flow>>

Start pump | Air pressure [V] Pump on

Stop pump | Pump off | Save occlution time stamp

[Specified occlution time]

Is pressure in cuff high enough?

alt

[Low pressure] | Start pump | Pump on

Stop pump | Pump off

Save occlution done

ref: | | Use case 3

Open valve | Valve on

Close valve | Valve off | Air flow Pressure < 10 [mmHg]?
