kj-schmidt/Perconditioning/Udviklingsdokumentation/SystemArkitektur/pdfs/SD_UC2.pdf

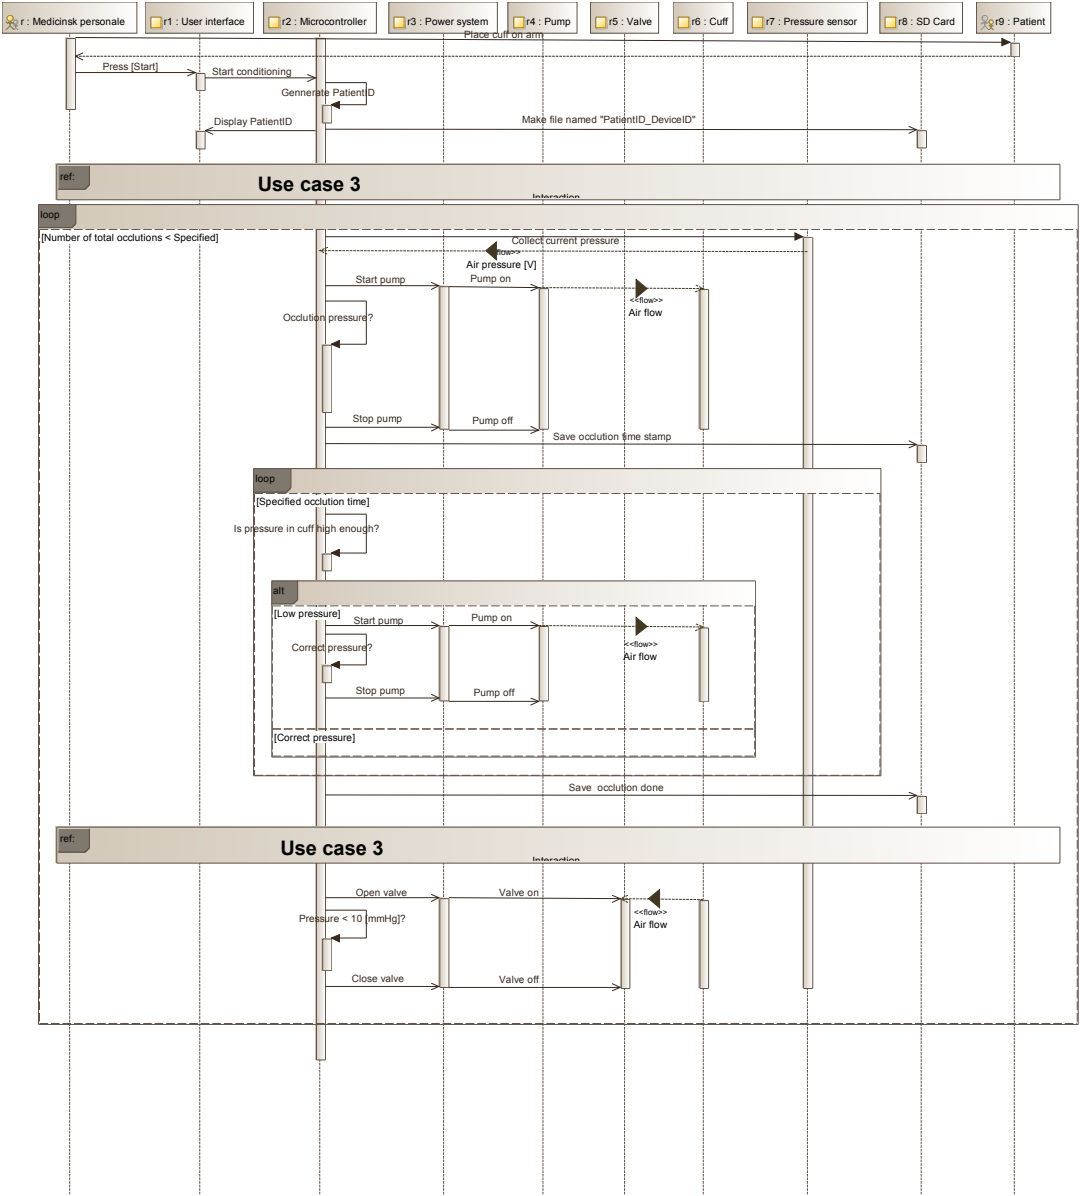
[picture p191: page 1]
r : Medicinsk personale; r1 : User interface; r2 : Microcontroller; r3 : Power system; r4 : Pump; r5 : Valve; r6 : Cuff; r7 : Pressure sensor; r8 : SD Card; r9 : Patient; loop; [Correct pressure]; Press [Start]; Start conditioning; Gennerate PatientID; Display PatientID; Make file named "PatientID_DeviceID"; <<flow>> Air flow; Occlution pressure?; <<flow>>

Place cuff on arm

ref: | Use case 3 | | Interaction

loop

[Number of total occlutions < Specified]

Start pump | <<flow>> Air pressure [V] Pump on

Collect current pressure

Stop pump | Pump off | Save occlution time stamp

[Specified occlution time]

Is pressure in cuff high enough?

alt

[Low pressure] | Start pump | Pump on

Stop pump | | Pump off | Air flow Correct pressure?

Save occlution done

Open valve | Valve on

Close valve | Valve off | Air flow Pressure < 10 [mmHg]?
