kj-schmidt/Perconditioning/Udviklingsdokumentation/SystemArkitektur/pdfs/BDD(SystemOverview).pdf

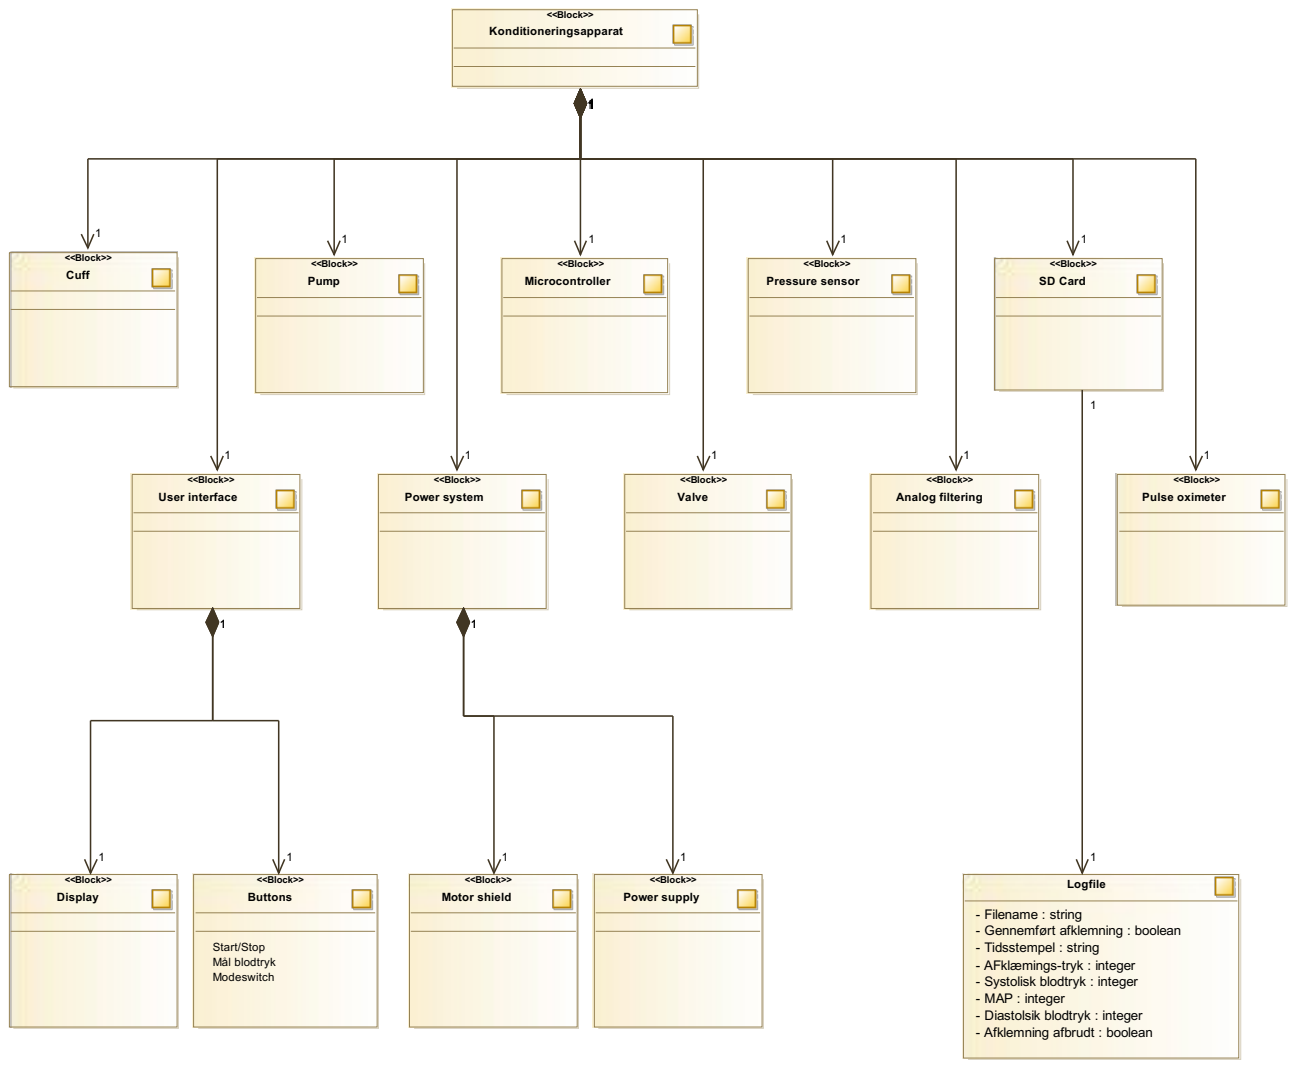
[picture p192: page 1]
ål blo; wit; File; rin; kle; nin; ole; Tid; klæ; min; olis; blo; Dia; olsik
