kj-schmidt/Perconditioning/Udviklingsdokumentation/Implementeringsdokument/FilterUdregningerKomponenter.pdf

## Anden ordens butterworth

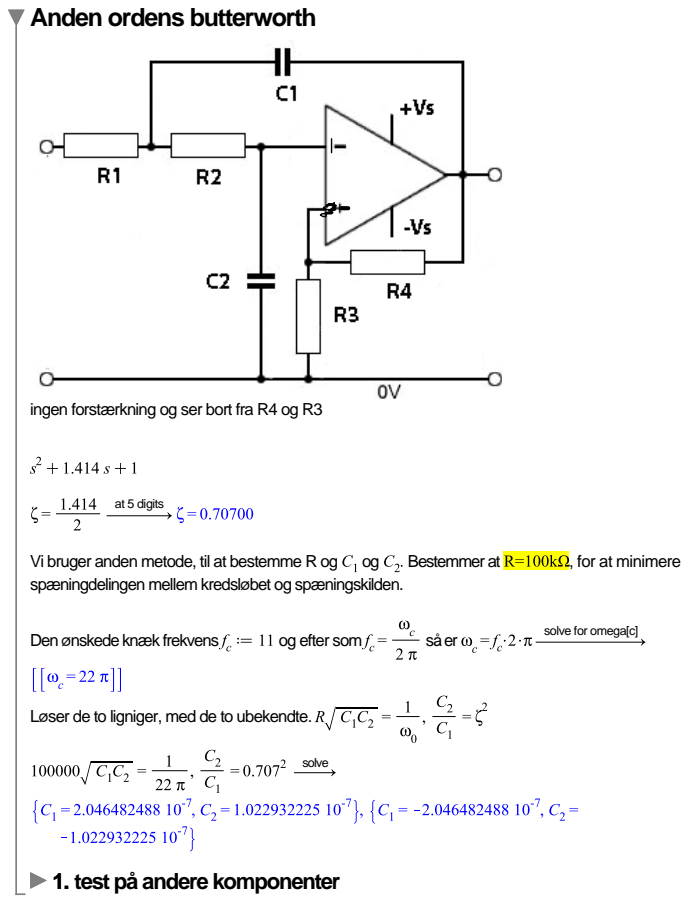
[picture p193: page 1]
at 5 digits; Vi bruger anden metode, til at bestemme R og; Bestemmer at; , for at minimere; Den ønskede knæk frekvens; og efter som; solve for omega[c]; solve

ingen forstærkning og ser bort fra R4 og R3

spæningdelingen mellem kredsløbet og spæningskilden.

Løser de to ligniger, med de to ubekendte.

test på andere komponenter

## High pass

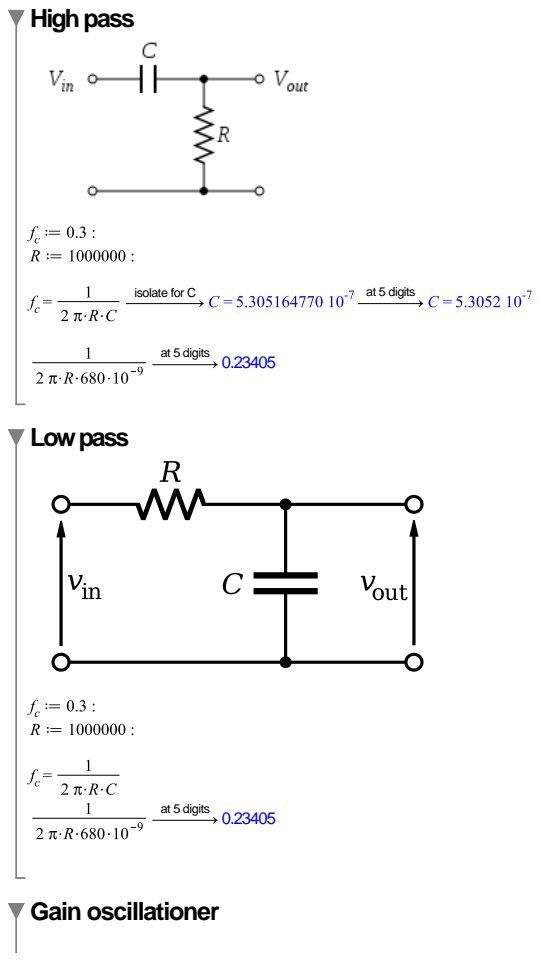
[picture p194: page 2]
isolate for C; at 5 digits; at 5 digits 0.23405; Low pass; Gain oscillationer

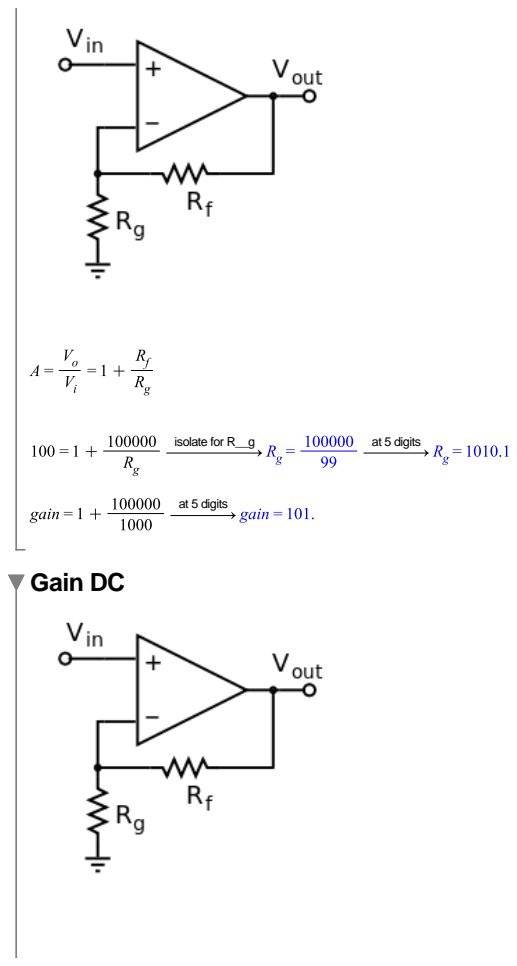
[picture p195: page 3]
isolate for R__g; at 5 digits; Gain DC

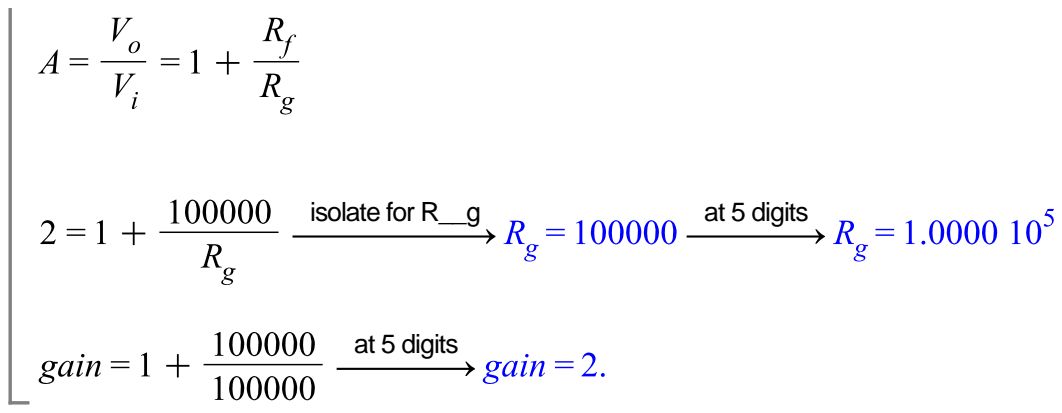
[picture p196: page 4]
isolate for R__g; at 5 digits
