kj-schmidt/Perconditioning/Udviklingsdokumentation/Implementeringsdokument/billeder/Display_schem.pdf

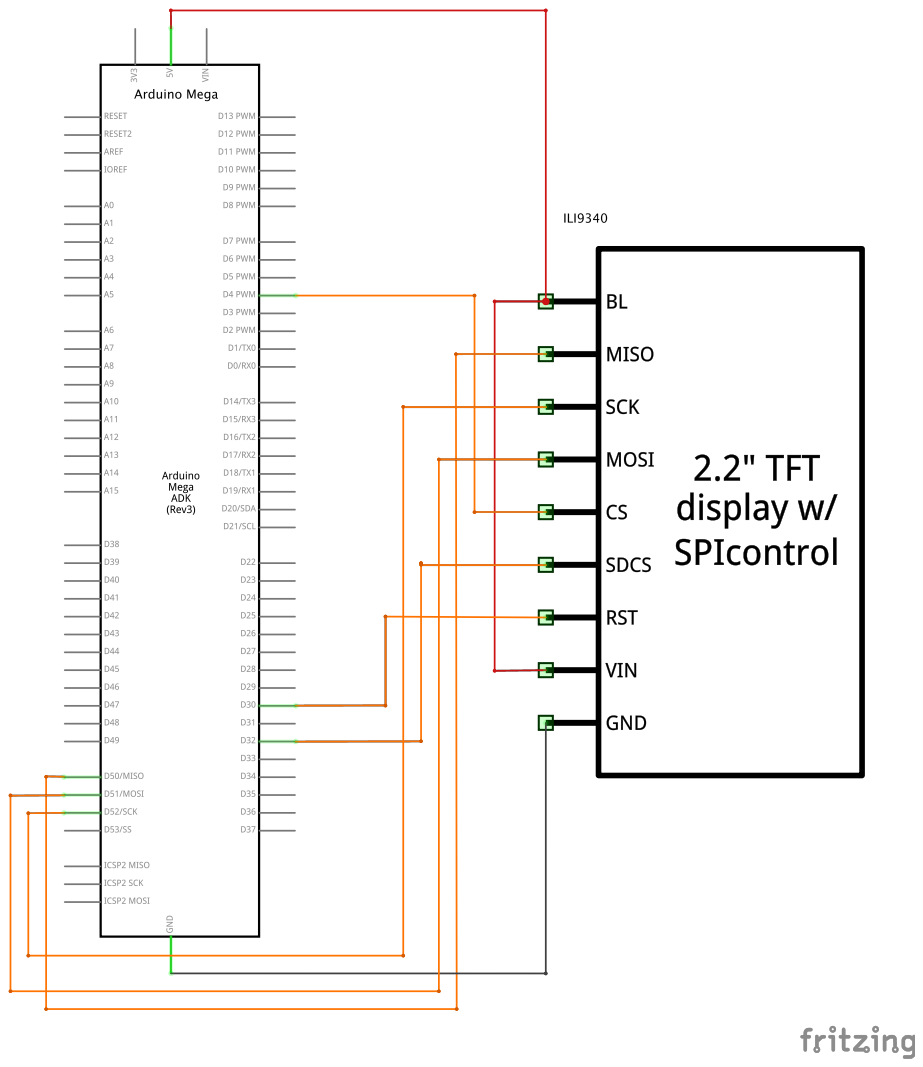
[picture p197: page 1]
