kj-schmidt/Perconditioning/Udviklingsdokumentation/Implementeringsdokument/billeder/Timer_schem.pdf

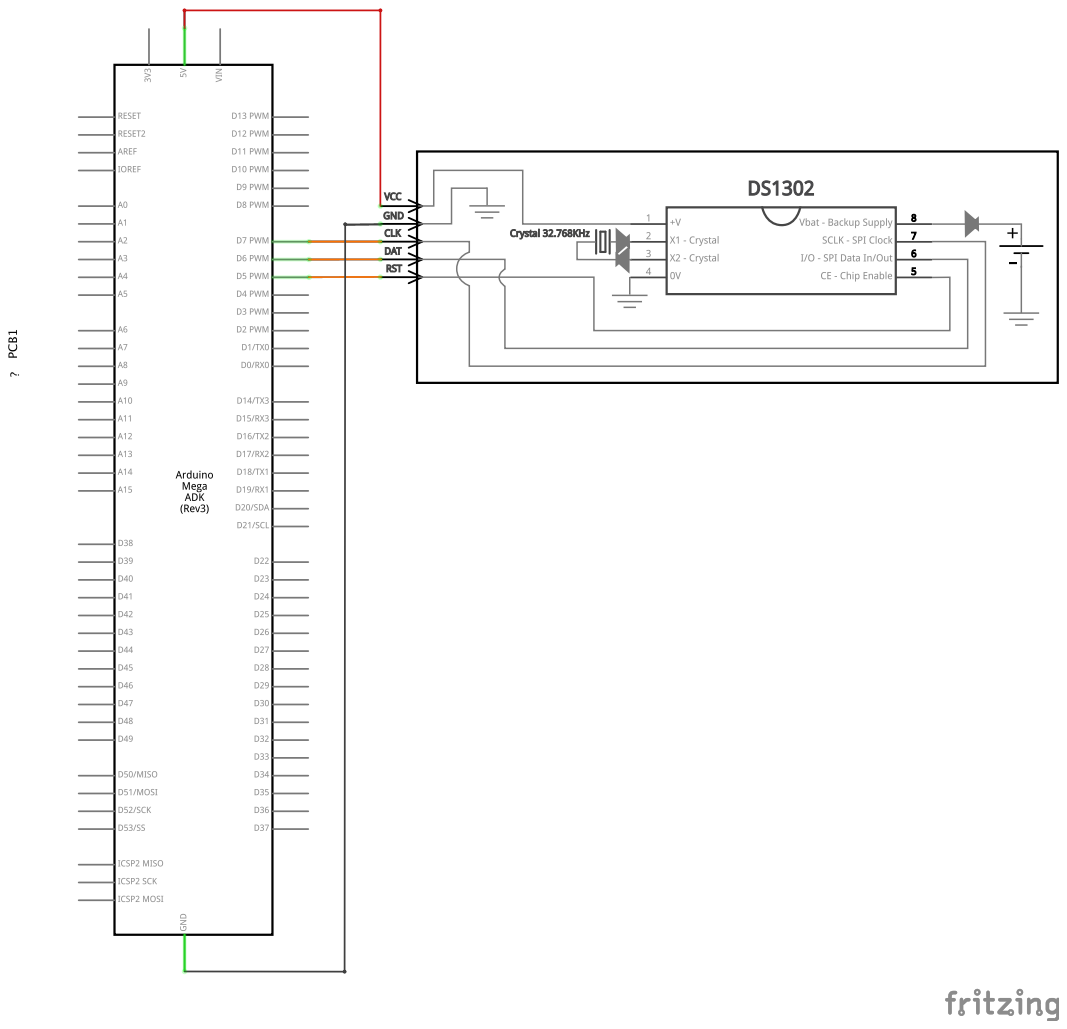
[picture p198: page 1]
