kj-schmidt/Perconditioning/Udviklingsdokumentation/Implementeringsdokument/billeder/Konditionering_schem.pdf

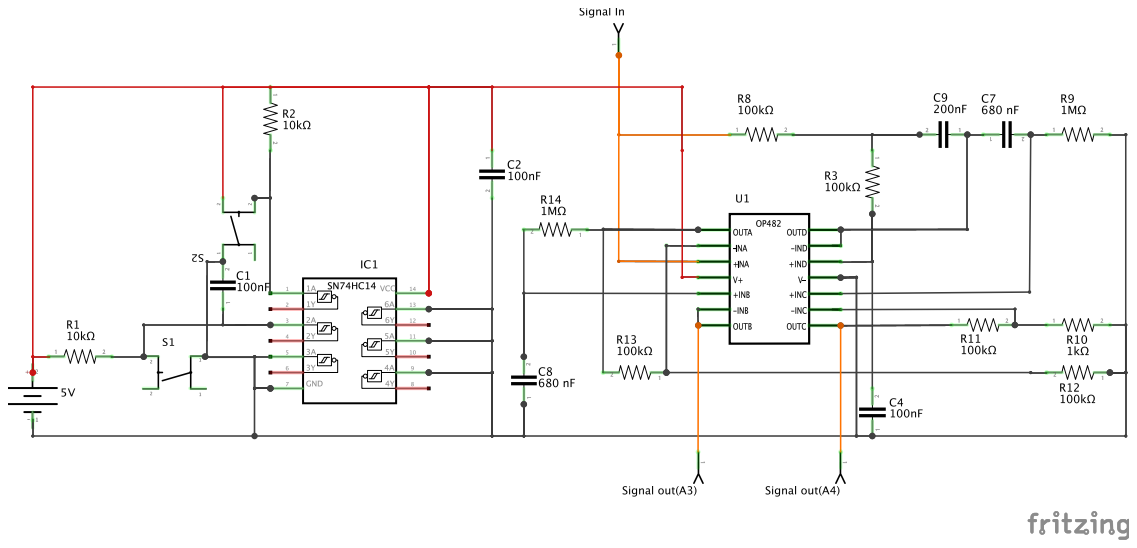
[picture p199: page 1]
