kj-schmidt/Perconditioning/Udviklingsdokumentation/SystemArkitektur/pdfs/MegaPlusShield-crop.pdf

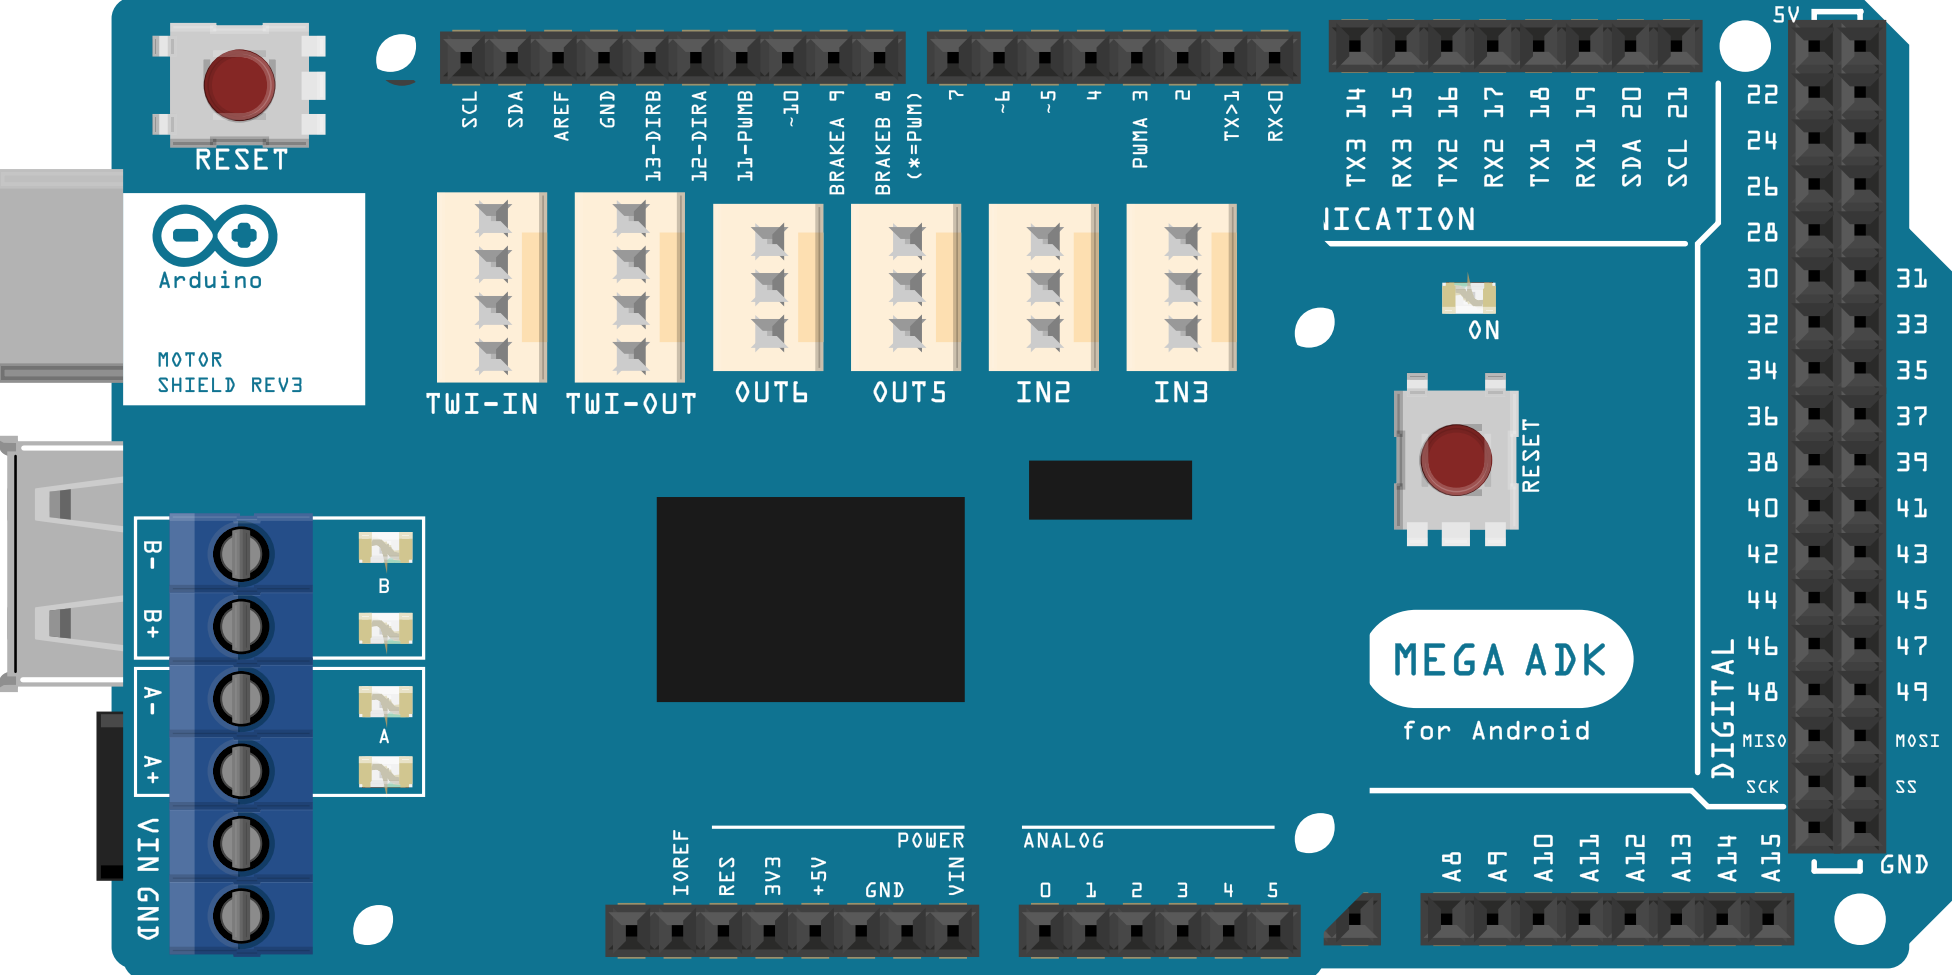
[picture p200: page 1]
