kj-schmidt/Perconditioning/(list of files, drawings)

Other design files:
Prototype/Breadboard tegning/DisplaySchematic.fzz
Prototype/Breadboard tegning/Konditionering.fzz
Prototype/Breadboard tegning/Prototype.fzz
Prototype/Breadboard tegning/TimerSchematic.fzz
