kj-schmidt/Perconditioning/Prototype/Kode/DataProces/DataProces.h

// Only modify this file to include
// - function definitions (prototypes)
// - include files
// - extern variable definitions
// In the appropriate section

#ifndef _DataProces_H_
#define _DataProces_H_
#include "Arduino.h"

//add your includes for the project SerialMonitor here


//end of add your includes here
#ifdef __cplusplus
extern "C" {
#endif
void loop();
void setup();


#ifdef __cplusplus
} // extern "C"
#endif

//add your function definitions for the project SerialMonitor here




//Do not add code below this line
#endif /* _SerialMonitor_H_ */
