kj-schmidt/Perconditioning/Prototype/Eclipse/.ino.cpp

//This is a automatic generated file
//Please do not modify this file
//If you touch this file your change will be overwritten during the next build
//This file has been generated on 2016-01-18 18:42:56

#include "Arduino.h"
#include "Arduino.h"
#include "GUI/Buttons.h"
#include "GUI/Display.h"
#include "Data/PressureControl.h"
#include "Data/PressureSampling.h"
#include "Data/ExternalMemory.h"
#include "Logic/DigitalFiltering.h"
#include "Logic/BPAlgorithm.h"
#include "Logic/Senarios.h"
#include "Utilities.h"
void intCon_ISR();
void intBT_ISR();
void intOcc_ISR();
void intCha_ISR();
void intSel_ISR();
void setup() ;
void loop() ;

#include "Konditioneringsapparat.pde"
