kj-schmidt/Perconditioning/Prototype/Kode/DataProces/testLib.h

#ifndef testLib_h
#define testLib_h
//using namespace testspace;

#include "Arduino.h"


class Library{
	public:
	void plot(unsigned short data);//, int data2, int data3, int data4, int data5, int data6);
	void printHaloo(char x[]);
};

#endif
