kj-schmidt/Perconditioning/(commit log)

2015-09-14 SysML diagrams Use case diagram and SD
2015-09-17 Added all use case and extension
2015-09-18 Update use case 5
2015-09-23 Pumpe kører med start stop. implementering af seriel comunikation er også på, samt begyndende kode til ventilstyring.
2015-09-27 Corrections after review
    Rettet use case til dansk
    Rettelser efter review
    Erstattet cuffen med manchetten
2015-09-30 Use case white backgroun
2015-10-05 arduino fisrt tode to gather sensor signal and print to scope.
2015-10-07 pneumatic specs
2015-10-08 Add drawing of setup
    [Prototype.fzz]
2015-10-09 SystemArkitektur i Latex
    Alt fra google docs indsat i LaTex
    - Mangler UC2 og UC5’s sekvensdiagrammer
2015-11-11 Filter design ducumentation
2015-11-11 Updates timer function
2015-11-12 Add implementationsdocument
    Software and filter is now done
2015-11-13 Update filter calculations
2015-11-18 problemformulering og formål rettet.
    [Display.cpp, Senarios.cpp]
2015-11-18 Fixed timer, and display BP
    [.ino.cpp, Buttons.cpp, Display.cpp, Display.h, ExternalMemory.cpp, ExternalMemory.h, Konditioneringsapparat.pde, MemoryParser.cpp]
2015-11-20 new graf of simulated blood pressure
2015-11-20 Update timer
2015-11-20 update filter afsnit
2015-11-28 ARduino afsnit
2015-12-14 rettelser til rapporten inden print
